ajayre/tandemleveller/Electronics/Controller V2/GNSS Daughterboard/GNSS-Daughterboard-V1.0-Render.png

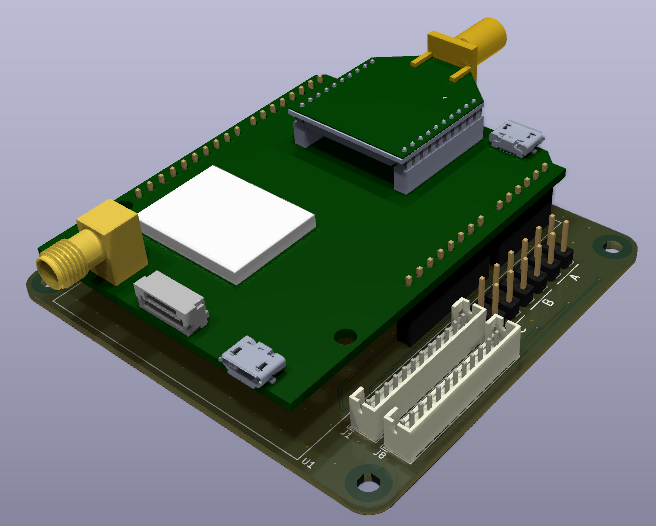
Electronics/Controller V2/GNSS Daughterboard/GNSS-Daughterboard-V1.0-Render.png
