ajayre/tandemleveller/Images/Controller Panel Connectors Annotated.png

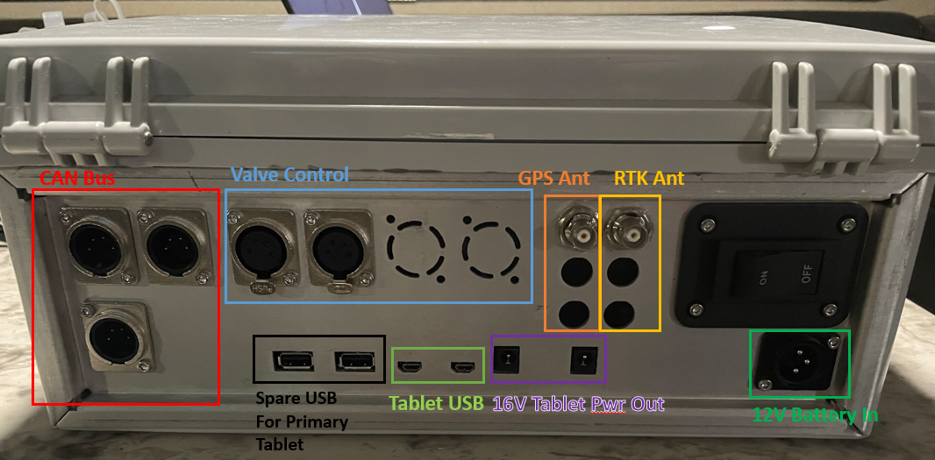
Images/Controller Panel Connectors Annotated.png
