ajayre/tandemleveller/Images/Controller Panel Connectors Annotated.pptx

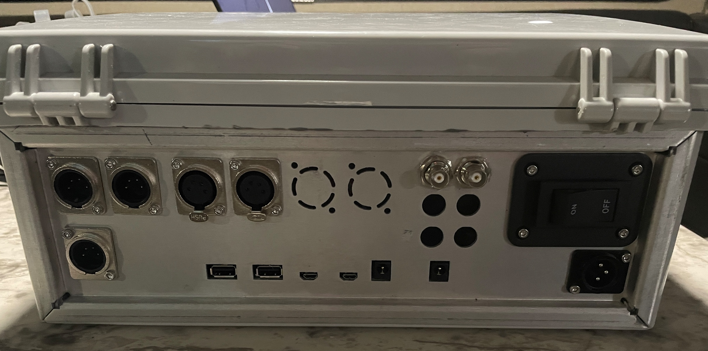
[picture p3: figure]

CAN Bus

Valve Control

GPS Ant

RTK Ant

Spare USB
For Primary Tablet

Tablet USB

16V Tablet Pwr Out

12V Battery In
