ajayre/tandemleveller/CAD/Controller/Case/Ethernet Template.pdf

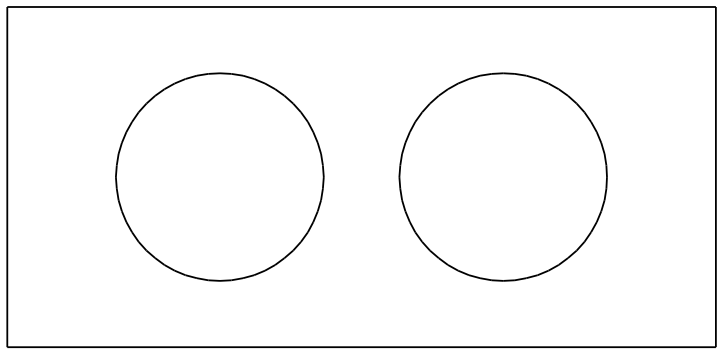
[picture p4: figure]
