ajayre/tandemleveller/Firmware/TandemLeveller/Misc/Scraper Mechanical Analysis.xlsx

Cylinder Lenfgth (cm) | Angle (deg) | Height (cm)
109 | 130.02 | -15.944
108.5 | 128.78 | -15.075
108 | 127.57 | -14.222
107.5 | 126.38 | -13.384
107 | 125.22 | -12.561
106.5 | 124.08 | -11.751
106 | 122.96 | -10.955
105.5 | 121.86 | -10.172
105 | 120.77 | -9.4
104.5 | 119.71 | -8.64
104 | 118.66 | -7.891
103.5 | 117.62 | -7.152
103 | 116.6 | -6.424
102.5 | 115.59 | -5.706
102 | 114.6 | -4.997
101.5 | 113.62 | -4.298
101 | 112.65 | -3.607
100.5 | 111.69 | -2.925
100 | 110.75 | -2.252
99.5 | 109.81 | -1.587
99 | 108.89 | -0.929
98.5 | 107.97 | -0.28
98.4 | 107.79 | -0.151
98.3 | 107.61 | -0.022
98 | 107.07 | 0.362
97 | 105.28 | 1.624
96 | 103.53 | 2.857
95 | 101.8 | 4.063
94 | 100.11 | 5.244
93 | 98.44 | 6.399
92 | 96.8 | 7.53
91 | 95.18 | 8.638
90 | 93.59 | 9.724
89 | 92.01 | 10.787
