ajayre/tandemleveller/Electronics/Datasheets/Leveling System Block Diagram.drawio.png

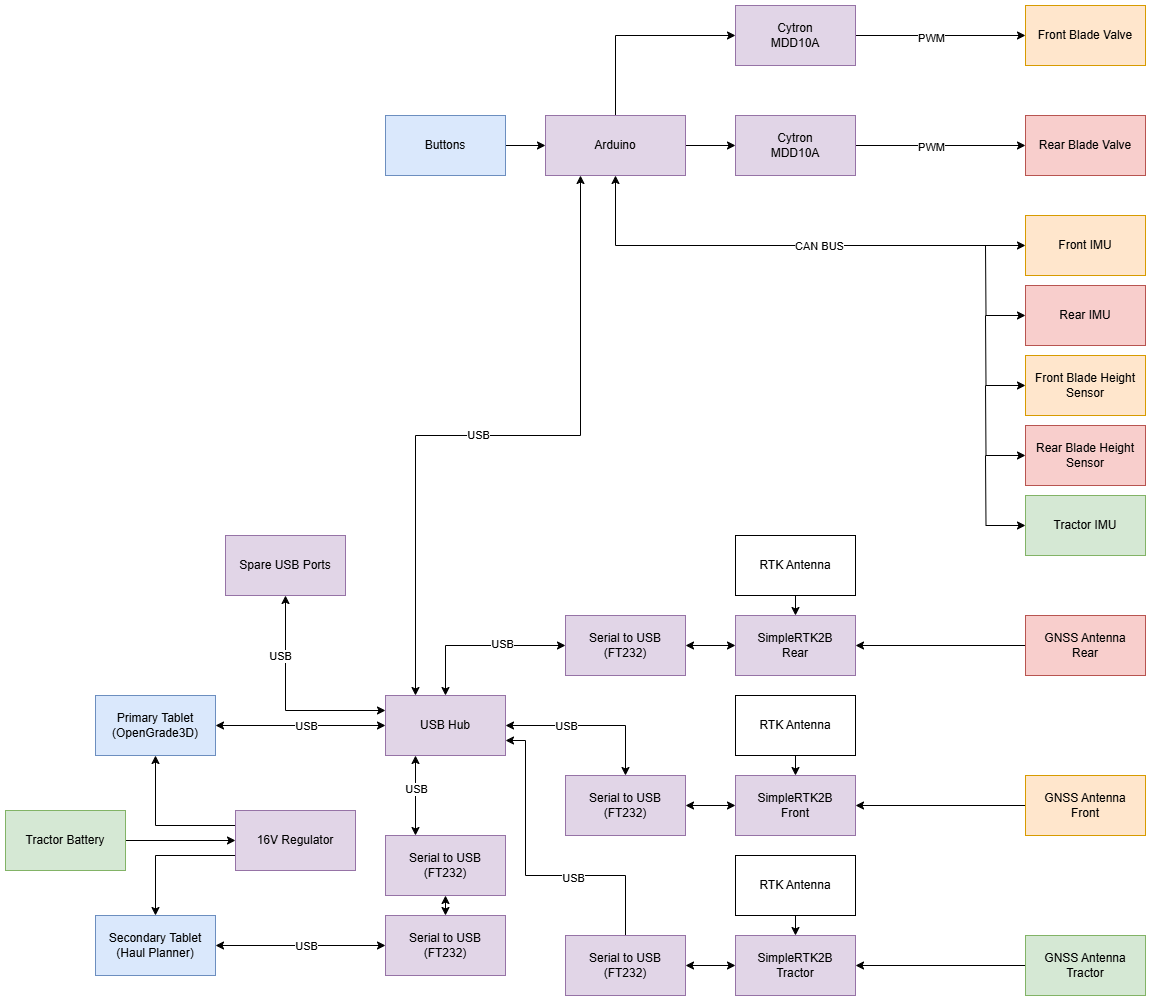
Electronics/Datasheets/Leveling System Block Diagram.drawio.png
