ajayre/tandemleveller/Electronics/Datasheets/Top Level Block Diagram.drawio.png

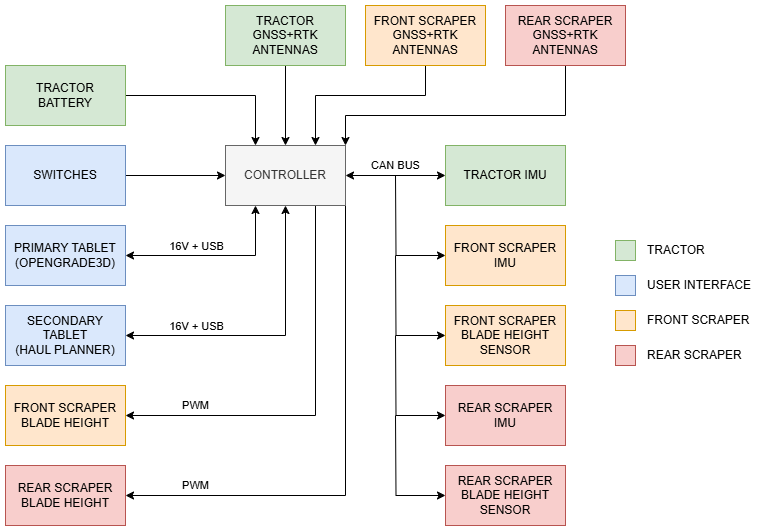
Electronics/Datasheets/Top Level Block Diagram.drawio.png
