ajayre/tandemleveller/Electronics/IMU/03621111e3fff3921c2074c2e0d3c10409e76010.jpeg

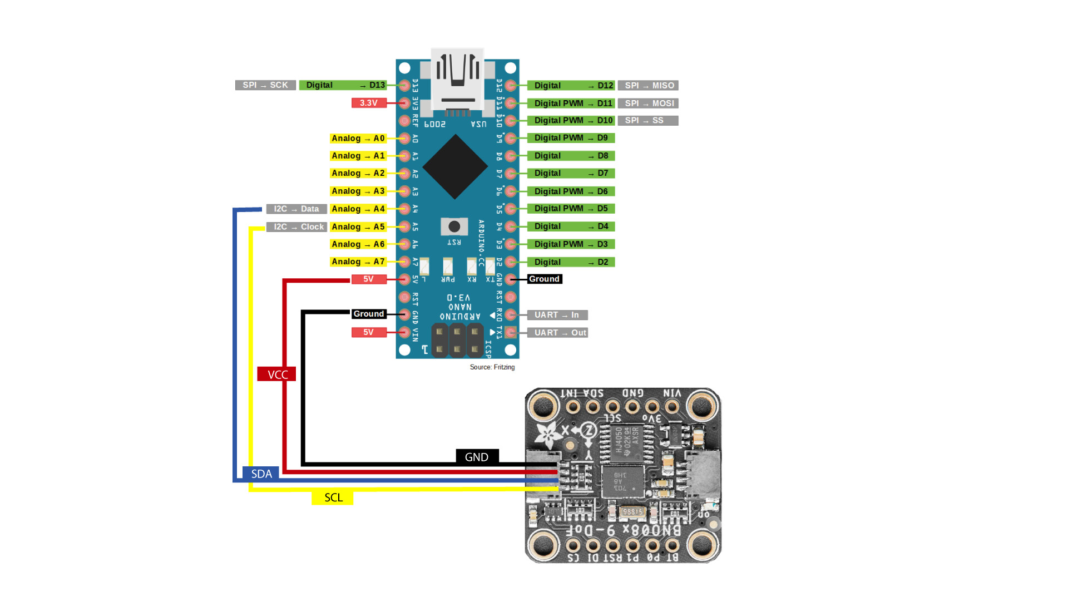
Electronics/IMU/03621111e3fff3921c2074c2e0d3c10409e76010.jpeg
