ajayre/tandemleveller/Electronics/User Controls/production/bom.csv

Designator | Footprint | Quantity | Value | LCSC Part #
C1, C2 | 0805 | 2 | 100n | C1711
FID1, FID2, FID3 | Fiducial_0.5mm_Mask1mm | 3 | Fiducial
J1 | PinHeader_1x02_P2.54mm_Vertical | 1 | TERM | C7494857
J10 | JST_PH_B4B-PH-K_1x04_P2.00mm_Vertical | 1 | BUTTON 7 | C131334
J11 | JST_PH_B4B-PH-K_1x04_P2.00mm_Vertical | 1 | BUTTON 8 | C131334
J12 | JST_PH_B5B-PH-K_1x05_P2.00mm_Vertical | 1 | JOYSTICK 1 | C157993
J13 | JST_PH_B5B-PH-K_1x05_P2.00mm_Vertical | 1 | JOYSTICK 2 | C157993
J2 | JST_PH_B5B-PH-K_1x05_P2.00mm_Vertical | 1 | CAN BUS | C157993
J3 | PinHeader_1x02_P2.54mm_Vertical | 1 | Conn_01x02 | C7494857
J4 | JST_PH_B4B-PH-K_1x04_P2.00mm_Vertical | 1 | BUTTON 1 | C131334
J5 | JST_PH_B4B-PH-K_1x04_P2.00mm_Vertical | 1 | BUTTON 2 | C131334
J6 | JST_PH_B4B-PH-K_1x04_P2.00mm_Vertical | 1 | BUTTON 3 | C131334
J7 | JST_PH_B4B-PH-K_1x04_P2.00mm_Vertical | 1 | BUTTON 4 | C131334
J8 | JST_PH_B4B-PH-K_1x04_P2.00mm_Vertical | 1 | BUTTON 5 | C131334
J9 | JST_PH_B4B-PH-K_1x04_P2.00mm_Vertical | 1 | BUTTON 6 | C131334
L1 | ACT1210-510-2P-TL00 | 1 | ACT1210-510-2P-TL00 | C95572
R1, R10, R3, R4, R5, R6, R7, R8, R9 | 0805 | 9 | 10k | C17414
R2 | 0805 | 1 | 120 | C17437
U1 | HVSON8_0_65mm | 1 | TJA1462ATK-0Z | C3229259
U2 | SOT-23 | 1 | PESD2CANFD24V-TR | C552486
U3 | Teensy_4.0 | 1 | TEENSY 4.0
