ajayre/tandemleveller/Electronics/XBee Adapter/Dummy XBee/production/bom.csv

Designator | Footprint | Quantity | Value | LCSC Part #
J1 | XBee 3 TH | 1 | Conn_01x20
J2, J3 | JST_PH_B2B-PH-K_1x02_P2.00mm_Vertical | 2 | Conn_01x04
