ajayre/tandemleveller/Firmware/Fusion Testing/Sensor Fusion Test 1.csv

CANopen Magic Ultimate 16.01 build 6829 64-bit Trace Recording, generated on 4/12/2026 5:48:48 PM
$FileVersion=5$
$TimestampMode=RelativeMS$
Message Number | Time (ms) | Time | Excel Time | Count | ID | Flags | Message Type | Node | Details | Process Data | Data (Hex) | Data (Text) | Data (Decimal) | Length | Raw Message
0 | 0.000 | 00000000.000' | 46124.7422641166 | 1 | 0x3F1 |  | Default: PDO |  | Default: TPDO 3 of Node 0x71 (113) | Easting:518723.148mm, Northing:3558743.361mm | 4C 16 EB 1E 41 1D 1E D4 | L . ë . A . . Ô | U:0 S:0 | 8 | 4C 16 EB 1E 41 1D 1E D4
1 | 9.152 | 00000009.152' | 46124.7422642225 | 1 | 0x182 |  | Default: PDO |  | Default: TPDO 1 of Node [0x02 (2)] Tractor IMU | Tctr Heading:316.25deg, Tctr Pitch:-3.25deg, Tctr Roll:15.5deg, Tctr Yaw Rate:0.22deg/s | 89 7B BB FE 0E 06 16 00 | . { » þ . . . . | U:0 S:0 | 8 | 89 7B BB FE 0E 06 16 00
2 | 40.850 | 00000040.850' | 46124.7422646953 | 1 | 0x3F1 |  | Default: PDO |  | Default: TPDO 3 of Node 0x71 (113) | Easting:518723.148mm, Northing:3558743.361mm | 4C 16 EB 1E 41 1D 1E D4 | L . ë . A . . Ô | U:0 S:0 | 8 | 4C 16 EB 1E 41 1D 1E D4
3 | 10.055 | 00000010.055' | 46124.7422648117 | 1 | 0x182 |  | Default: PDO |  | Default: TPDO 1 of Node [0x02 (2)] Tractor IMU | Tctr Heading:316.25deg, Tctr Pitch:-3.24deg, Tctr Roll:15.49deg, Tctr Yaw Rate:-0.22deg/s | 89 7B BC FE 0D 06 EA FF | . { ¼ þ . . ê ÿ | U:0 S:0 | 8 | 89 7B BC FE 0D 06 EA FF
4 | 39.943 | 00000039.943' | 46124.742265274 | 1 | 0x3F1 |  | Default: PDO |  | Default: TPDO 3 of Node 0x71 (113) | Easting:518723.148mm, Northing:3558743.361mm | 4C 16 EB 1E 41 1D 1E D4 | L . ë . A . . Ô | U:0 S:0 | 8 | 4C 16 EB 1E 41 1D 1E D4
5 | 9.486 | 00000009.486' | 46124.7422653838 | 1 | 0x182 |  | Default: PDO |  | Default: TPDO 1 of Node [0x02 (2)] Tractor IMU | Tctr Heading:316.29deg, Tctr Pitch:-3.25deg, Tctr Roll:15.49deg, Tctr Yaw Rate:-0.78deg/s | 8D 7B BB FE 0D 06 B2 FF | . { » þ . . ² ÿ | U:0 S:0 | 8 | 8D 7B BB FE 0D 06 B2 FF
6 | 40.509 | 00000040.509' | 46124.7422658527 | 1 | 0x3F1 |  | Default: PDO |  | Default: TPDO 3 of Node 0x71 (113) | Easting:518723.148mm, Northing:3558743.361mm | 4C 16 EB 1E 41 1D 1E D4 | L . ë . A . . Ô | U:0 S:0 | 8 | 4C 16 EB 1E 41 1D 1E D4
7 | 9.175 | 00000009.175' | 46124.7422659589 | 1 | 0x182 |  | Default: PDO |  | Default: TPDO 1 of Node [0x02 (2)] Tractor IMU | Tctr Heading:316.34deg, Tctr Pitch:-3.26deg, Tctr Roll:15.47deg, Tctr Yaw Rate:-1.23deg/s | 92 7B BA FE 0B 06 85 FF | . { º þ . . . ÿ | U:0 S:0 | 8 | 92 7B BA FE 0B 06 85 FF
8 | 40.829 | 00000040.829' | 46124.7422664314 | 1 | 0x3F1 |  | Default: PDO |  | Default: TPDO 3 of Node 0x71 (113) | Easting:518723.148mm, Northing:3558743.361mm | 4C 16 EB 1E 41 1D 1E D4 | L . ë . A . . Ô | U:0 S:0 | 8 | 4C 16 EB 1E 41 1D 1E D4
9 | 10.230 | 00000010.230' | 46124.7422665498 | 1 | 0x182 |  | Default: PDO |  | Default: TPDO 1 of Node [0x02 (2)] Tractor IMU | Tctr Heading:316.4deg, Tctr Pitch:-3.27deg, Tctr Roll:15.48deg, Tctr Yaw Rate:-1.23deg/s | 98 7B B9 FE 0C 06 85 FF | . { ¹ þ . . . ÿ | U:0 S:0 | 8 | 98 7B B9 FE 0C 06 85 FF
10 | 39.774 | 00000039.774' | 46124.7422670102 | 1 | 0x3F1 |  | Default: PDO |  | Default: TPDO 3 of Node 0x71 (113) | Easting:518723.148mm, Northing:3558743.361mm | 4C 16 EB 1E 41 1D 1E D4 | L . ë . A . . Ô | U:0 S:0 | 8 | 4C 16 EB 1E 41 1D 1E D4
11 | 9.511 | 00000009.511' | 46124.7422671203 | 1 | 0x182 |  | Default: PDO |  | Default: TPDO 1 of Node [0x02 (2)] Tractor IMU | Tctr Heading:316.41deg, Tctr Pitch:-3.27deg, Tctr Roll:15.48deg, Tctr Yaw Rate:-0.11deg/s | 99 7B B9 FE 0C 06 F5 FF | . { ¹ þ . . õ ÿ | U:0 S:0 | 8 | 99 7B B9 FE 0C 06 F5 FF
12 | 40.495 | 00000040.495' | 46124.742267589 | 1 | 0x3F1 |  | Default: PDO |  | Default: TPDO 3 of Node 0x71 (113) | Easting:518723.148mm, Northing:3558743.361mm | 4C 16 EB 1E 41 1D 1E D4 | L . ë . A . . Ô | U:0 S:0 | 8 | 4C 16 EB 1E 41 1D 1E D4
13 | 9.184 | 00000009.184' | 46124.7422676952 | 1 | 0x182 |  | Default: PDO |  | Default: TPDO 1 of Node [0x02 (2)] Tractor IMU | Tctr Heading:316.38deg, Tctr Pitch:-3.26deg, Tctr Roll:15.48deg, Tctr Yaw Rate:0.78deg/s | 96 7B BA FE 0C 06 4E 00 | . { º þ . . N . | U:0 S:0 | 8 | 96 7B BA FE 0C 06 4E 00
14 | 40.818 | 00000040.818' | 46124.7422681677 | 1 | 0x3F1 |  | Default: PDO |  | Default: TPDO 3 of Node 0x71 (113) | Easting:518723.148mm, Northing:3558743.361mm | 4C 16 EB 1E 41 1D 1E D4 | L . ë . A . . Ô | U:0 S:0 | 8 | 4C 16 EB 1E 41 1D 1E D4
15 | 10.120 | 00000010.120' | 46124.7422682848 | 1 | 0x182 |  | Default: PDO |  | Default: TPDO 1 of Node [0x02 (2)] Tractor IMU | Tctr Heading:316.31deg, Tctr Pitch:-3.24deg, Tctr Roll:15.49deg, Tctr Yaw Rate:1.45deg/s | 8F 7B BC FE 0D 06 91 00 | . { ¼ þ . . . . | U:0 S:0 | 8 | 8F 7B BC FE 0D 06 91 00
16 | 39.878 | 00000039.878' | 46124.7422687464 | 1 | 0x3F1 |  | Default: PDO |  | Default: TPDO 3 of Node 0x71 (113) | Easting:518723.148mm, Northing:3558743.361mm | 4C 16 EB 1E 41 1D 1E D4 | L . ë . A . . Ô | U:0 S:0 | 8 | 4C 16 EB 1E 41 1D 1E D4
17 | 9.535 | 00000009.535' | 46124.7422688567 | 1 | 0x182 |  | Default: PDO |  | Default: TPDO 1 of Node [0x02 (2)] Tractor IMU | Tctr Heading:316.25deg, Tctr Pitch:-3.22deg, Tctr Roll:15.48deg, Tctr Yaw Rate:1.23deg/s | 89 7B BE FE 0C 06 7B 00 | . { ¾ þ . . { . | U:0 S:0 | 8 | 89 7B BE FE 0C 06 7B 00
18 | 21.415 | 00000021.415' | 46124.7422691046 | 1 | 0x1F1 |  | Default: PDO |  | Default: TPDO 1 of Node 0x71 (113) | Fuse Easting Corr:600mm, Fuse Northing Corr:373mm, Fuse Alt Corr:-2494mm | 58 02 75 01 42 F6 | X . u . B ö | U:0 S:0 | 6 | 58 02 75 01 42 F6
19 | 19.037 | 00000019.037' | 46124.7422693249 | 1 | 0x3F1 |  | Default: PDO |  | Default: TPDO 3 of Node 0x71 (113) | Easting:518723.148mm, Northing:3558743.368mm | 4C 16 EB 1E 48 1D 1E D4 | L . ë . H . . Ô | U:0 S:0 | 8 | 4C 16 EB 1E 48 1D 1E D4
20 | 9.240 | 00000009.240' | 46124.7422694319 | 1 | 0x182 |  | Default: PDO |  | Default: TPDO 1 of Node [0x02 (2)] Tractor IMU | Tctr Heading:316.18deg, Tctr Pitch:-3.21deg, Tctr Roll:15.48deg, Tctr Yaw Rate:1.45deg/s | 82 7B BF FE 0C 06 91 00 | . { ¿ þ . . . . | U:0 S:0 | 8 | 82 7B BF FE 0C 06 91 00
21 | 40.756 | 00000040.756' | 46124.7422699036 | 1 | 0x3F1 |  | Default: PDO |  | Default: TPDO 3 of Node 0x71 (113) | Easting:518723.148mm, Northing:3558743.368mm | 4C 16 EB 1E 48 1D 1E D4 | L . ë . H . . Ô | U:0 S:0 | 8 | 4C 16 EB 1E 48 1D 1E D4
22 | 10.443 | 00000010.443' | 46124.7422700244 | 1 | 0x182 |  | Default: PDO |  | Default: TPDO 1 of Node [0x02 (2)] Tractor IMU | Tctr Heading:316.16deg, Tctr Pitch:-3.2deg, Tctr Roll:15.48deg, Tctr Yaw Rate:0.22deg/s | 80 7B C0 FE 0C 06 16 00 | . { À þ . . . . | U:0 S:0 | 8 | 80 7B C0 FE 0C 06 16 00
23 | 39.661 | 00000039.661' | 46124.7422704835 | 1 | 0x3F1 |  | Default: PDO |  | Default: TPDO 3 of Node 0x71 (113) | Easting:518723.148mm, Northing:3558743.368mm | 4C 16 EB 1E 48 1D 1E D4 | L . ë . H . . Ô | U:0 S:0 | 8 | 4C 16 EB 1E 48 1D 1E D4
24 | 9.576 | 00000009.576' | 46124.7422705943 | 1 | 0x182 |  | Default: PDO |  | Default: TPDO 1 of Node [0x02 (2)] Tractor IMU | Tctr Heading:316.17deg, Tctr Pitch:-3.21deg, Tctr Roll:15.49deg, Tctr Yaw Rate:-0.44deg/s | 81 7B BF FE 0D 06 D4 FF | . { ¿ þ . . Ô ÿ | U:0 S:0 | 8 | 81 7B BF FE 0D 06 D4 FF
25 | 40.429 | 00000040.429' | 46124.7422710622 | 1 | 0x3F1 |  | Default: PDO |  | Default: TPDO 3 of Node 0x71 (113) | Easting:518723.148mm, Northing:3558743.368mm | 4C 16 EB 1E 48 1D 1E D4 | L . ë . H . . Ô | U:0 S:0 | 8 | 4C 16 EB 1E 48 1D 1E D4
26 | 9.247 | 00000009.247' | 46124.7422711693 | 1 | 0x182 |  | Default: PDO |  | Default: TPDO 1 of Node [0x02 (2)] Tractor IMU | Tctr Heading:316.22deg, Tctr Pitch:-3.22deg, Tctr Roll:15.5deg, Tctr Yaw Rate:-0.89deg/s | 86 7B BE FE 0E 06 A7 FF | . { ¾ þ . . § ÿ | U:0 S:0 | 8 | 86 7B BE FE 0E 06 A7 FF
27 | 40.757 | 00000040.757' | 46124.742271641 | 1 | 0x3F1 |  | Default: PDO |  | Default: TPDO 3 of Node 0x71 (113) | Easting:518723.148mm, Northing:3558743.368mm | 4C 16 EB 1E 48 1D 1E D4 | L . ë . H . . Ô | U:0 S:0 | 8 | 4C 16 EB 1E 48 1D 1E D4
28 | 10.567 | 00000010.567' | 46124.7422717633 | 1 | 0x182 |  | Default: PDO |  | Default: TPDO 1 of Node [0x02 (2)] Tractor IMU | Tctr Heading:316.28deg, Tctr Pitch:-3.22deg, Tctr Roll:15.49deg, Tctr Yaw Rate:-1.34deg/s | 8C 7B BE FE 0D 06 7A FF | . { ¾ þ . . z ÿ | U:0 S:0 | 8 | 8C 7B BE FE 0D 06 7A FF
29 | 39.433 | 00000039.433' | 46124.7422722197 | 1 | 0x3F1 |  | Default: PDO |  | Default: TPDO 3 of Node 0x71 (113) | Easting:518723.148mm, Northing:3558743.368mm | 4C 16 EB 1E 48 1D 1E D4 | L . ë . H . . Ô | U:0 S:0 | 8 | 4C 16 EB 1E 48 1D 1E D4
30 | 10.112 | 00000010.112' | 46124.7422723367 | 1 | 0x182 |  | Default: PDO |  | Default: TPDO 1 of Node [0x02 (2)] Tractor IMU | Tctr Heading:316.32deg, Tctr Pitch:-3.24deg, Tctr Roll:15.49deg, Tctr Yaw Rate:-0.78deg/s | 90 7B BC FE 0D 06 B2 FF | . { ¼ þ . . ² ÿ | U:0 S:0 | 8 | 90 7B BC FE 0D 06 B2 FF
31 | 39.885 | 00000039.885' | 46124.7422727984 | 1 | 0x3F1 |  | Default: PDO |  | Default: TPDO 3 of Node 0x71 (113) | Easting:518723.148mm, Northing:3558743.368mm | 4C 16 EB 1E 48 1D 1E D4 | L . ë . H . . Ô | U:0 S:0 | 8 | 4C 16 EB 1E 48 1D 1E D4
32 | 9.272 | 00000009.272' | 46124.7422729057 | 1 | 0x182 |  | Default: PDO |  | Default: TPDO 1 of Node [0x02 (2)] Tractor IMU | Tctr Heading:316.32deg, Tctr Pitch:-3.24deg, Tctr Roll:15.5deg, Tctr Yaw Rate:0.22deg/s | 90 7B BC FE 0E 06 16 00 | . { ¼ þ . . . . | U:0 S:0 | 8 | 90 7B BC FE 0E 06 16 00
33 | 40.732 | 00000040.732' | 46124.7422733771 | 1 | 0x3F1 |  | Default: PDO |  | Default: TPDO 3 of Node 0x71 (113) | Easting:518723.148mm, Northing:3558743.368mm | 4C 16 EB 1E 48 1D 1E D4 | L . ë . H . . Ô | U:0 S:0 | 8 | 4C 16 EB 1E 48 1D 1E D4
34 | 10.135 | 00000010.135' | 46124.7422734944 | 1 | 0x182 |  | Default: PDO |  | Default: TPDO 1 of Node [0x02 (2)] Tractor IMU | Tctr Heading:316.27deg, Tctr Pitch:-3.23deg, Tctr Roll:15.51deg, Tctr Yaw Rate:1.23deg/s | 8B 7B BD FE 0F 06 7B 00 | . { ½ þ . . { . | U:0 S:0 | 8 | 8B 7B BD FE 0F 06 7B 00
35 | 39.869 | 00000039.869' | 46124.7422739559 | 1 | 0x3F1 |  | Default: PDO |  | Default: TPDO 3 of Node 0x71 (113) | Easting:518723.148mm, Northing:3558743.368mm | 4C 16 EB 1E 48 1D 1E D4 | L . ë . H . . Ô | U:0 S:0 | 8 | 4C 16 EB 1E 48 1D 1E D4
36 | 10.007 | 00000010.007' | 46124.7422740717 | 1 | 0x182 |  | Default: PDO |  | Default: TPDO 1 of Node [0x02 (2)] Tractor IMU | Tctr Heading:316.2deg, Tctr Pitch:-3.21deg, Tctr Roll:15.5deg, Tctr Yaw Rate:1.56deg/s | 84 7B BF FE 0E 06 9C 00 | . { ¿ þ . . . . | U:0 S:0 | 8 | 84 7B BF FE 0E 06 9C 00
37 | 39.997 | 00000039.997' | 46124.7422745346 | 1 | 0x3F1 |  | Default: PDO |  | Default: TPDO 3 of Node 0x71 (113) | Easting:518723.148mm, Northing:3558743.368mm | 4C 16 EB 1E 48 1D 1E D4 | L . ë . H . . Ô | U:0 S:0 | 8 | 4C 16 EB 1E 48 1D 1E D4
38 | 9.295 | 00000009.295' | 46124.7422746422 | 1 | 0x182 |  | Default: PDO |  | Default: TPDO 1 of Node [0x02 (2)] Tractor IMU | Tctr Heading:316.15deg, Tctr Pitch:-3.2deg, Tctr Roll:15.51deg, Tctr Yaw Rate:0.78deg/s | 7F 7B C0 FE 0F 06 4E 00 | . { À þ . . N . | U:0 S:0 | 8 | 7F 7B C0 FE 0F 06 4E 00
39 | 40.705 | 00000040.705' | 46124.7422751133 | 1 | 0x3F1 |  | Default: PDO |  | Default: TPDO 3 of Node 0x71 (113) | Easting:518723.148mm, Northing:3558743.368mm | 4C 16 EB 1E 48 1D 1E D4 | L . ë . H . . Ô | U:0 S:0 | 8 | 4C 16 EB 1E 48 1D 1E D4
40 | 10.641 | 00000010.641' | 46124.7422752365 | 1 | 0x182 |  | Default: PDO |  | Default: TPDO 1 of Node [0x02 (2)] Tractor IMU | Tctr Heading:316.15deg, Tctr Pitch:-3.19deg, Tctr Roll:15.5deg, Tctr Yaw Rate:-0.22deg/s | 7F 7B C1 FE 0E 06 EA FF | . { Á þ . . ê ÿ | U:0 S:0 | 8 | 7F 7B C1 FE 0E 06 EA FF
41 | 39.361 | 00000039.361' | 46124.742275692 | 1 | 0x3F1 |  | Default: PDO |  | Default: TPDO 3 of Node 0x71 (113) | Easting:518723.148mm, Northing:3558743.368mm | 4C 16 EB 1E 48 1D 1E D4 | L . ë . H . . Ô | U:0 S:0 | 8 | 4C 16 EB 1E 48 1D 1E D4
42 | 10.161 | 00000010.161' | 46124.7422758096 | 1 | 0x182 |  | Default: PDO |  | Default: TPDO 1 of Node [0x02 (2)] Tractor IMU | Tctr Heading:316.2deg, Tctr Pitch:-3.21deg, Tctr Roll:15.52deg, Tctr Yaw Rate:-1.11deg/s | 84 7B BF FE 10 06 91 FF | . { ¿ þ . . . ÿ | U:0 S:0 | 8 | 84 7B BF FE 10 06 91 FF
43 | 39.840 | 00000039.840' | 46124.7422762708 | 1 | 0x3F1 |  | Default: PDO |  | Default: TPDO 3 of Node 0x71 (113) | Easting:518723.148mm, Northing:3558743.368mm | 4C 16 EB 1E 48 1D 1E D4 | L . ë . H . . Ô | U:0 S:0 | 8 | 4C 16 EB 1E 48 1D 1E D4
44 | 9.281 | 00000009.281' | 46124.7422763782 | 1 | 0x182 |  | Default: PDO |  | Default: TPDO 1 of Node [0x02 (2)] Tractor IMU | Tctr Heading:316.27deg, Tctr Pitch:-3.22deg, Tctr Roll:15.52deg, Tctr Yaw Rate:-1.34deg/s | 8B 7B BE FE 10 06 7A FF | . { ¾ þ . . z ÿ | U:0 S:0 | 8 | 8B 7B BE FE 10 06 7A FF
45 | 40.719 | 00000040.719' | 46124.7422768495 | 1 | 0x3F1 |  | Default: PDO |  | Default: TPDO 3 of Node 0x71 (113) | Easting:518723.148mm, Northing:3558743.368mm | 4C 16 EB 1E 48 1D 1E D4 | L . ë . H . . Ô | U:0 S:0 | 8 | 4C 16 EB 1E 48 1D 1E D4
46 | 10.215 | 00000010.215' | 46124.7422769677 | 1 | 0x182 |  | Default: PDO |  | Default: TPDO 1 of Node [0x02 (2)] Tractor IMU | Tctr Heading:316.32deg, Tctr Pitch:-3.24deg, Tctr Roll:15.5deg, Tctr Yaw Rate:-0.78deg/s | 90 7B BC FE 0E 06 B2 FF | . { ¼ þ . . ² ÿ | U:0 S:0 | 8 | 90 7B BC FE 0E 06 B2 FF
47 | 39.790 | 00000039.790' | 46124.7422774282 | 1 | 0x3F1 |  | Default: PDO |  | Default: TPDO 3 of Node 0x71 (113) | Easting:518723.148mm, Northing:3558743.368mm | 4C 16 EB 1E 48 1D 1E D4 | L . ë . H . . Ô | U:0 S:0 | 8 | 4C 16 EB 1E 48 1D 1E D4
48 | 10.047 | 00000010.047' | 46124.7422775445 | 1 | 0x182 |  | Default: PDO |  | Default: TPDO 1 of Node [0x02 (2)] Tractor IMU | Tctr Heading:316.33deg, Tctr Pitch:-3.23deg, Tctr Roll:15.51deg, Tctr Yaw Rate:0.33deg/s | 91 7B BD FE 0F 06 21 00 | . { ½ þ . . ! . | U:0 S:0 | 8 | 91 7B BD FE 0F 06 21 00
49 | 39.957 | 00000039.957' | 46124.742278007 | 1 | 0x3F1 |  | Default: PDO |  | Default: TPDO 3 of Node 0x71 (113) | Easting:518723.148mm, Northing:3558743.368mm | 4C 16 EB 1E 48 1D 1E D4 | L . ë . H . . Ô | U:0 S:0 | 8 | 4C 16 EB 1E 48 1D 1E D4
50 | 9.312 | 00000009.312' | 46124.7422781147 | 1 | 0x182 |  | Default: PDO |  | Default: TPDO 1 of Node [0x02 (2)] Tractor IMU | Tctr Heading:316.28deg, Tctr Pitch:-3.22deg, Tctr Roll:15.5deg, Tctr Yaw Rate:0.89deg/s | 8C 7B BE FE 0E 06 59 00 | . { ¾ þ . . Y . | U:0 S:0 | 8 | 8C 7B BE FE 0E 06 59 00
51 | 40.684 | 00000040.684' | 46124.7422785856 | 1 | 0x3F1 |  | Default: PDO |  | Default: TPDO 3 of Node 0x71 (113) | Easting:518723.148mm, Northing:3558743.368mm | 4C 16 EB 1E 48 1D 1E D4 | L . ë . H . . Ô | U:0 S:0 | 8 | 4C 16 EB 1E 48 1D 1E D4
52 | 10.671 | 00000010.671' | 46124.7422787091 | 1 | 0x182 |  | Default: PDO |  | Default: TPDO 1 of Node [0x02 (2)] Tractor IMU | Tctr Heading:316.23deg, Tctr Pitch:-3.22deg, Tctr Roll:15.51deg, Tctr Yaw Rate:1.23deg/s | 87 7B BE FE 0F 06 7B 00 | . { ¾ þ . . { . | U:0 S:0 | 8 | 87 7B BE FE 0F 06 7B 00
53 | 39.334 | 00000039.334' | 46124.7422791644 | 1 | 0x3F1 |  | Default: PDO |  | Default: TPDO 3 of Node 0x71 (113) | Easting:518723.148mm, Northing:3558743.368mm | 4C 16 EB 1E 48 1D 1E D4 | L . ë . H . . Ô | U:0 S:0 | 8 | 4C 16 EB 1E 48 1D 1E D4
54 | 10.231 | 00000010.231' | 46124.7422792828 | 1 | 0x182 |  | Default: PDO |  | Default: TPDO 1 of Node [0x02 (2)] Tractor IMU | Tctr Heading:316.18deg, Tctr Pitch:-3.21deg, Tctr Roll:15.5deg, Tctr Yaw Rate:0.89deg/s | 82 7B BF FE 0E 06 59 00 | . { ¿ þ . . Y . | U:0 S:0 | 8 | 82 7B BF FE 0E 06 59 00
55 | 39.773 | 00000039.773' | 46124.7422797431 | 1 | 0x3F1 |  | Default: PDO |  | Default: TPDO 3 of Node 0x71 (113) | Easting:518723.148mm, Northing:3558743.368mm | 4C 16 EB 1E 48 1D 1E D4 | L . ë . H . . Ô | U:0 S:0 | 8 | 4C 16 EB 1E 48 1D 1E D4
56 | 9.336 | 00000009.336' | 46124.7422798512 | 1 | 0x182 |  | Default: PDO |  | Default: TPDO 1 of Node [0x02 (2)] Tractor IMU | Tctr Heading:316.19deg, Tctr Pitch:-3.21deg, Tctr Roll:15.49deg, Tctr Yaw Rate:-0.33deg/s | 83 7B BF FE 0D 06 DF FF | . { ¿ þ . . ß ÿ | U:0 S:0 | 8 | 83 7B BF FE 0D 06 DF FF
57 | 40.660 | 00000040.660' | 46124.7422803218 | 1 | 0x3F1 |  | Default: PDO |  | Default: TPDO 3 of Node 0x71 (113) | Easting:518723.148mm, Northing:3558743.368mm | 4C 16 EB 1E 48 1D 1E D4 | L . ë . H . . Ô | U:0 S:0 | 8 | 4C 16 EB 1E 48 1D 1E D4
58 | 10.270 | 00000010.270' | 46124.7422804407 | 1 | 0x182 |  | Default: PDO |  | Default: TPDO 1 of Node [0x02 (2)] Tractor IMU | Tctr Heading:316.23deg, Tctr Pitch:-3.22deg, Tctr Roll:15.51deg, Tctr Yaw Rate:-1.11deg/s | 87 7B BE FE 0F 06 91 FF | . { ¾ þ . . . ÿ | U:0 S:0 | 8 | 87 7B BE FE 0F 06 91 FF
59 | 39.734 | 00000039.734' | 46124.7422809005 | 1 | 0x3F1 |  | Default: PDO |  | Default: TPDO 3 of Node 0x71 (113) | Easting:518723.148mm, Northing:3558743.368mm | 4C 16 EB 1E 48 1D 1E D4 | L . ë . H . . Ô | U:0 S:0 | 8 | 4C 16 EB 1E 48 1D 1E D4
60 | 3.374 | 00000003.374' | 46124.7422809396 | 1 | 0x1F1 |  | Default: PDO |  | Default: TPDO 1 of Node 0x71 (113) | Fuse Easting Corr:601mm, Fuse Northing Corr:374mm, Fuse Alt Corr:-2494mm | 59 02 76 01 42 F6 | Y . v . B ö | U:0 S:0 | 6 | 59 02 76 01 42 F6
61 | 6.751 | 00000006.751' | 46124.7422810177 | 1 | 0x182 |  | Default: PDO |  | Default: TPDO 1 of Node [0x02 (2)] Tractor IMU | Tctr Heading:316.3deg, Tctr Pitch:-3.24deg, Tctr Roll:15.52deg, Tctr Yaw Rate:-1.23deg/s | 8E 7B BC FE 10 06 85 FF | . { ¼ þ . . . ÿ | U:0 S:0 | 8 | 8E 7B BC FE 10 06 85 FF
62 | 39.868 | 00000039.868' | 46124.7422814792 | 1 | 0x3F1 |  | Default: PDO |  | Default: TPDO 3 of Node 0x71 (113) | Easting:518723.152mm, Northing:3558743.371mm | 50 16 EB 1E 4B 1D 1E D4 | P . ë . K . . Ô | U:0 S:0 | 8 | 50 16 EB 1E 4B 1D 1E D4
63 | 9.451 | 00000009.451' | 46124.7422815886 | 1 | 0x182 |  | Default: PDO |  | Default: TPDO 1 of Node [0x02 (2)] Tractor IMU | Tctr Heading:316.36deg, Tctr Pitch:-3.25deg, Tctr Roll:15.54deg, Tctr Yaw Rate:-1.45deg/s | 94 7B BB FE 12 06 6F FF | . { » þ . . o ÿ | U:0 S:0 | 8 | 94 7B BB FE 12 06 6F FF
64 | 40.654 | 00000040.654' | 46124.7422820591 | 1 | 0x3F1 |  | Default: PDO |  | Default: TPDO 3 of Node 0x71 (113) | Easting:518723.152mm, Northing:3558743.371mm | 50 16 EB 1E 4B 1D 1E D4 | P . ë . K . . Ô | U:0 S:0 | 8 | 50 16 EB 1E 4B 1D 1E D4
65 | 10.167 | 00000010.167' | 46124.7422821768 | 1 | 0x182 |  | Default: PDO |  | Default: TPDO 1 of Node [0x02 (2)] Tractor IMU | Tctr Heading:316.42deg, Tctr Pitch:-3.26deg, Tctr Roll:15.52deg, Tctr Yaw Rate:-1.23deg/s | 9A 7B BA FE 10 06 85 FF | . { º þ . . . ÿ | U:0 S:0 | 8 | 9A 7B BA FE 10 06 85 FF
66 | 39.838 | 00000039.838' | 46124.7422826379 | 1 | 0x3F1 |  | Default: PDO |  | Default: TPDO 3 of Node 0x71 (113) | Easting:518723.152mm, Northing:3558743.371mm | 50 16 EB 1E 4B 1D 1E D4 | P . ë . K . . Ô | U:0 S:0 | 8 | 50 16 EB 1E 4B 1D 1E D4
67 | 9.695 | 00000009.695' | 46124.7422827501 | 1 | 0x182 |  | Default: PDO |  | Default: TPDO 1 of Node [0x02 (2)] Tractor IMU | Tctr Heading:316.44deg, Tctr Pitch:-3.27deg, Tctr Roll:15.51deg, Tctr Yaw Rate:-0.33deg/s | 9C 7B B9 FE 0F 06 DF FF | . { ¹ þ . . ß ÿ | U:0 S:0 | 8 | 9C 7B B9 FE 0F 06 DF FF
68 | 40.305 | 00000040.305' | 46124.7422832166 | 1 | 0x3F1 |  | Default: PDO |  | Default: TPDO 3 of Node 0x71 (113) | Easting:518723.152mm, Northing:3558743.371mm | 50 16 EB 1E 4B 1D 1E D4 | P . ë . K . . Ô | U:0 S:0 | 8 | 50 16 EB 1E 4B 1D 1E D4
69 | 9.377 | 00000009.377' | 46124.7422833251 | 1 | 0x182 |  | Default: PDO |  | Default: TPDO 1 of Node [0x02 (2)] Tractor IMU | Tctr Heading:316.44deg, Tctr Pitch:-3.27deg, Tctr Roll:15.5deg, Tctr Yaw Rate:-0.11deg/s | 9C 7B B9 FE 0E 06 F5 FF | . { ¹ þ . . õ ÿ | U:0 S:0 | 8 | 9C 7B B9 FE 0E 06 F5 FF
70 | 40.625 | 00000040.625' | 46124.7422837953 | 1 | 0x3F1 |  | Default: PDO |  | Default: TPDO 3 of Node 0x71 (113) | Easting:518723.152mm, Northing:3558743.371mm | 50 16 EB 1E 4B 1D 1E D4 | P . ë . K . . Ô | U:0 S:0 | 8 | 50 16 EB 1E 4B 1D 1E D4
71 | 10.361 | 00000010.361' | 46124.7422839152 | 1 | 0x182 |  | Default: PDO |  | Default: TPDO 1 of Node [0x02 (2)] Tractor IMU | Tctr Heading:316.44deg, Tctr Pitch:-3.26deg, Tctr Roll:15.5deg, Tctr Yaw Rate:0.11deg/s | 9C 7B BA FE 0E 06 0B 00 | . { º þ . . . . | U:0 S:0 | 8 | 9C 7B BA FE 0E 06 0B 00
72 | 39.640 | 00000039.640' | 46124.742284374 | 1 | 0x3F1 |  | Default: PDO |  | Default: TPDO 3 of Node 0x71 (113) | Easting:518723.152mm, Northing:3558743.371mm | 50 16 EB 1E 4B 1D 1E D4 | P . ë . K . . Ô | U:0 S:0 | 8 | 50 16 EB 1E 4B 1D 1E D4
73 | 9.945 | 00000009.945' | 46124.7422844891 | 1 | 0x182 |  | Default: PDO |  | Default: TPDO 1 of Node [0x02 (2)] Tractor IMU | Tctr Heading:316.42deg, Tctr Pitch:-3.26deg, Tctr Roll:15.52deg, Tctr Yaw Rate:0.44deg/s | 9A 7B BA FE 10 06 2C 00 | . { º þ . . , . | U:0 S:0 | 8 | 9A 7B BA FE 10 06 2C 00
74 | 40.055 | 00000040.055' | 46124.7422849527 | 1 | 0x3F1 |  | Default: PDO |  | Default: TPDO 3 of Node 0x71 (113) | Easting:518723.152mm, Northing:3558743.371mm | 50 16 EB 1E 4B 1D 1E D4 | P . ë . K . . Ô | U:0 S:0 | 8 | 50 16 EB 1E 4B 1D 1E D4
75 | 9.383 | 00000009.383' | 46124.7422850613 | 1 | 0x182 |  | Default: PDO |  | Default: TPDO 1 of Node [0x02 (2)] Tractor IMU | Tctr Heading:316.42deg, Tctr Pitch:-3.25deg, Tctr Roll:15.49deg, Tctr Yaw Rate:-0.11deg/s | 9A 7B BB FE 0D 06 F5 FF | . { » þ . . õ ÿ | U:0 S:0 | 8 | 9A 7B BB FE 0D 06 F5 FF
76 | 40.622 | 00000040.622' | 46124.7422855315 | 1 | 0x3F1 |  | Default: PDO |  | Default: TPDO 3 of Node 0x71 (113) | Easting:518723.152mm, Northing:3558743.371mm | 50 16 EB 1E 4B 1D 1E D4 | P . ë . K . . Ô | U:0 S:0 | 8 | 50 16 EB 1E 4B 1D 1E D4
77 | 10.607 | 00000010.607' | 46124.7422856542 | 1 | 0x182 |  | Default: PDO |  | Default: TPDO 1 of Node [0x02 (2)] Tractor IMU | Tctr Heading:316.41deg, Tctr Pitch:-3.24deg, Tctr Roll:15.51deg, Tctr Yaw Rate:0.44deg/s | 99 7B BC FE 0F 06 2C 00 | . { ¼ þ . . , . | U:0 S:0 | 8 | 99 7B BC FE 0F 06 2C 00
78 | 39.389 | 00000039.389' | 46124.7422861101 | 1 | 0x3F1 |  | Default: PDO |  | Default: TPDO 3 of Node 0x71 (113) | Easting:518723.152mm, Northing:3558743.371mm | 50 16 EB 1E 4B 1D 1E D4 | P . ë . K . . Ô | U:0 S:0 | 8 | 50 16 EB 1E 4B 1D 1E D4
79 | 10.135 | 00000010.135' | 46124.7422862274 | 1 | 0x182 |  | Default: PDO |  | Default: TPDO 1 of Node [0x02 (2)] Tractor IMU | Tctr Heading:316.38deg, Tctr Pitch:-3.24deg, Tctr Roll:15.52deg, Tctr Yaw Rate:0.78deg/s | 96 7B BC FE 10 06 4E 00 | . { ¼ þ . . N . | U:0 S:0 | 8 | 96 7B BC FE 10 06 4E 00
80 | 39.869 | 00000039.869' | 46124.7422866889 | 1 | 0x3F1 |  | Default: PDO |  | Default: TPDO 3 of Node 0x71 (113) | Easting:518723.152mm, Northing:3558743.371mm | 50 16 EB 1E 4B 1D 1E D4 | P . ë . K . . Ô | U:0 S:0 | 8 | 50 16 EB 1E 4B 1D 1E D4
81 | 9.384 | 00000009.384' | 46124.7422867975 | 1 | 0x182 |  | Default: PDO |  | Default: TPDO 1 of Node [0x02 (2)] Tractor IMU | Tctr Heading:316.34deg, Tctr Pitch:-3.23deg, Tctr Roll:15.53deg, Tctr Yaw Rate:0.67deg/s | 92 7B BD FE 11 06 43 00 | . { ½ þ . . C . | U:0 S:0 | 8 | 92 7B BD FE 11 06 43 00
82 | 40.620 | 00000040.620' | 46124.7422872676 | 1 | 0x3F1 |  | Default: PDO |  | Default: TPDO 3 of Node 0x71 (113) | Easting:518723.152mm, Northing:3558743.371mm | 50 16 EB 1E 4B 1D 1E D4 | P . ë . K . . Ô | U:0 S:0 | 8 | 50 16 EB 1E 4B 1D 1E D4
83 | 10.166 | 00000010.166' | 46124.7422873853 | 1 | 0x182 |  | Default: PDO |  | Default: TPDO 1 of Node [0x02 (2)] Tractor IMU | Tctr Heading:316.3deg, Tctr Pitch:-3.22deg, Tctr Roll:15.53deg, Tctr Yaw Rate:0.89deg/s | 8E 7B BE FE 11 06 59 00 | . { ¾ þ . . Y . | U:0 S:0 | 8 | 8E 7B BE FE 11 06 59 00
84 | 39.838 | 00000039.838' | 46124.7422878464 | 1 | 0x3F1 |  | Default: PDO |  | Default: TPDO 3 of Node 0x71 (113) | Easting:518723.152mm, Northing:3558743.371mm | 50 16 EB 1E 4B 1D 1E D4 | P . ë . K . . Ô | U:0 S:0 | 8 | 50 16 EB 1E 4B 1D 1E D4
85 | 49.125 | 00000049.125' | 46124.7422884149 | 1 | 0x182 |  | Default: PDO |  | Default: TPDO 1 of Node [0x02 (2)] Tractor IMU | Tctr Heading:316.26deg, Tctr Pitch:-3.21deg, Tctr Roll:15.51deg, Tctr Yaw Rate:0.44deg/s | 8A 7B BF FE 0F 06 2C 00 | . { ¿ þ . . , . | U:0 S:0 | 8 | 8A 7B BF FE 0F 06 2C 00
86 | 2.287 | 00000002.287' | 46124.7422884414 | 1 | 0x3F1 |  | Default: PDO |  | Default: TPDO 3 of Node 0x71 (113) | Easting:518723.152mm, Northing:3558743.371mm | 50 16 EB 1E 4B 1D 1E D4 | P . ë . K . . Ô | U:0 S:0 | 8 | 50 16 EB 1E 4B 1D 1E D4
87 | 48.621 | 00000048.621' | 46124.7422890042 | 1 | 0x182 |  | Default: PDO |  | Default: TPDO 1 of Node [0x02 (2)] Tractor IMU | Tctr Heading:316.24deg, Tctr Pitch:-3.2deg, Tctr Roll:15.53deg, Tctr Yaw Rate:-0.44deg/s | 88 7B C0 FE 11 06 D4 FF | . { À þ . . Ô ÿ | U:0 S:0 | 8 | 88 7B C0 FE 11 06 D4 FF
88 | 1.366 | 00000001.366' | 46124.74228902 | 1 | 0x3F1 |  | Default: PDO |  | Default: TPDO 3 of Node 0x71 (113) | Easting:518723.152mm, Northing:3558743.371mm | 50 16 EB 1E 4B 1D 1E D4 | P . ë . K . . Ô | U:0 S:0 | 8 | 50 16 EB 1E 4B 1D 1E D4
89 | 48.629 | 00000048.629' | 46124.7422895828 | 1 | 0x182 |  | Default: PDO |  | Default: TPDO 1 of Node [0x02 (2)] Tractor IMU | Tctr Heading:316.24deg, Tctr Pitch:-3.21deg, Tctr Roll:15.53deg, Tctr Yaw Rate:-1deg/s | 88 7B BF FE 11 06 9C FF | . { ¿ þ . . . ÿ | U:0 S:0 | 8 | 88 7B BF FE 11 06 9C FF
90 | 1.367 | 00000001.367' | 46124.7422895986 | 1 | 0x3F1 |  | Default: PDO |  | Default: TPDO 3 of Node 0x71 (113) | Easting:518723.152mm, Northing:3558743.371mm | 50 16 EB 1E 4B 1D 1E D4 | P . ë . K . . Ô | U:0 S:0 | 8 | 50 16 EB 1E 4B 1D 1E D4
91 | 48.614 | 00000048.614' | 46124.7422901613 | 1 | 0x3F1 |  | Default: PDO |  | Default: TPDO 3 of Node 0x71 (113) | Easting:518723.152mm, Northing:3558743.371mm | 50 16 EB 1E 4B 1D 1E D4 | P . ë . K . . Ô | U:0 S:0 | 8 | 50 16 EB 1E 4B 1D 1E D4
92 | 3.175 | 00000003.175' | 46124.742290198 | 1 | 0x182 |  | Default: PDO |  | Default: TPDO 1 of Node [0x02 (2)] Tractor IMU | Tctr Heading:316.29deg, Tctr Pitch:-3.21deg, Tctr Roll:15.53deg, Tctr Yaw Rate:-1.11deg/s | 8D 7B BF FE 11 06 91 FF | . { ¿ þ . . . ÿ | U:0 S:0 | 8 | 8D 7B BF FE 11 06 91 FF
93 | 46.825 | 00000046.825' | 46124.74229074 | 1 | 0x3F1 |  | Default: PDO |  | Default: TPDO 3 of Node 0x71 (113) | Easting:518723.152mm, Northing:3558743.371mm | 50 16 EB 1E 4B 1D 1E D4 | P . ë . K . . Ô | U:0 S:0 | 8 | 50 16 EB 1E 4B 1D 1E D4
94 | 3.856 | 00000003.856' | 46124.7422907846 | 1 | 0x182 |  | Default: PDO |  | Default: TPDO 1 of Node [0x02 (2)] Tractor IMU | Tctr Heading:316.34deg, Tctr Pitch:-3.23deg, Tctr Roll:15.52deg, Tctr Yaw Rate:0deg/s | 92 7B BD FE 10 06 00 00 | . { ½ þ . . . . | U:0 S:0 | 8 | 92 7B BD FE 10 06 00 00
95 | 46.146 | 00000046.146' | 46124.7422913187 | 1 | 0x3F1 |  | Default: PDO |  | Default: TPDO 3 of Node 0x71 (113) | Easting:518723.152mm, Northing:3558743.371mm | 50 16 EB 1E 4B 1D 1E D4 | P . ë . K . . Ô | U:0 S:0 | 8 | 50 16 EB 1E 4B 1D 1E D4
96 | 3.527 | 00000003.527' | 46124.7422913595 | 1 | 0x182 |  | Default: PDO |  | Default: TPDO 1 of Node [0x02 (2)] Tractor IMU | Tctr Heading:316.36deg, Tctr Pitch:-3.24deg, Tctr Roll:15.5deg, Tctr Yaw Rate:0.33deg/s | 94 7B BC FE 0E 06 21 00 | . { ¼ þ . . ! . | U:0 S:0 | 8 | 94 7B BC FE 0E 06 21 00
97 | 46.474 | 00000046.474' | 46124.7422918974 | 1 | 0x3F1 |  | Default: PDO |  | Default: TPDO 3 of Node 0x71 (113) | Easting:518723.152mm, Northing:3558743.371mm | 50 16 EB 1E 4B 1D 1E D4 | P . ë . K . . Ô | U:0 S:0 | 8 | 50 16 EB 1E 4B 1D 1E D4
98 | 3.184 | 00000003.184' | 46124.7422919343 | 1 | 0x182 |  | Default: PDO |  | Default: TPDO 1 of Node [0x02 (2)] Tractor IMU | Tctr Heading:316.35deg, Tctr Pitch:-3.24deg, Tctr Roll:15.53deg, Tctr Yaw Rate:0.67deg/s | 93 7B BC FE 11 06 43 00 | . { ¼ þ . . C . | U:0 S:0 | 8 | 93 7B BC FE 11 06 43 00
99 | 37.674 | 00000037.674' | 46124.7422923703 | 1 | 0x1F1 |  | Default: PDO |  | Default: TPDO 1 of Node 0x71 (113) | Fuse Easting Corr:603mm, Fuse Northing Corr:373mm, Fuse Alt Corr:-2494mm | 5B 02 75 01 42 F6 | [ . u . B ö | U:0 S:0 | 6 | 5B 02 75 01 42 F6
100 | 9.142 | 00000009.142' | 46124.7422924761 | 1 | 0x3F1 |  | Default: PDO |  | Default: TPDO 3 of Node 0x71 (113) | Easting:518723.159mm, Northing:3558743.374mm | 57 16 EB 1E 4E 1D 1E D4 | W . ë . N . . Ô | U:0 S:0 | 8 | 57 16 EB 1E 4E 1D 1E D4
101 | 3.895 | 00000003.895' | 46124.7422925212 | 1 | 0x182 |  | Default: PDO |  | Default: TPDO 1 of Node [0x02 (2)] Tractor IMU | Tctr Heading:316.32deg, Tctr Pitch:-3.22deg, Tctr Roll:15.53deg, Tctr Yaw Rate:0.78deg/s | 90 7B BE FE 11 06 4E 00 | . { ¾ þ . . N . | U:0 S:0 | 8 | 90 7B BE FE 11 06 4E 00
102 | 46.111 | 00000046.111' | 46124.7422930549 | 1 | 0x3F1 |  | Default: PDO |  | Default: TPDO 3 of Node 0x71 (113) | Easting:518723.159mm, Northing:3558743.374mm | 57 16 EB 1E 4E 1D 1E D4 | W . ë . N . . Ô | U:0 S:0 | 8 | 57 16 EB 1E 4E 1D 1E D4
103 | 3.642 | 00000003.642' | 46124.7422930971 | 1 | 0x182 |  | Default: PDO |  | Default: TPDO 1 of Node [0x02 (2)] Tractor IMU | Tctr Heading:316.27deg, Tctr Pitch:-3.22deg, Tctr Roll:15.53deg, Tctr Yaw Rate:0.55deg/s | 8B 7B BE FE 11 06 37 00 | . { ¾ þ . . 7 . | U:0 S:0 | 8 | 8B 7B BE FE 11 06 37 00
104 | 46.454 | 00000046.454' | 46124.7422936347 | 1 | 0x3F1 |  | Default: PDO |  | Default: TPDO 3 of Node 0x71 (113) | Easting:518723.159mm, Northing:3558743.374mm | 57 16 EB 1E 4E 1D 1E D4 | W . ë . N . . Ô | U:0 S:0 | 8 | 57 16 EB 1E 4E 1D 1E D4
105 | 3.223 | 00000003.223' | 46124.742293672 | 1 | 0x182 |  | Default: PDO |  | Default: TPDO 1 of Node [0x02 (2)] Tractor IMU | Tctr Heading:316.24deg, Tctr Pitch:-3.21deg, Tctr Roll:15.52deg, Tctr Yaw Rate:0.55deg/s | 88 7B BF FE 10 06 37 00 | . { ¿ þ . . 7 . | U:0 S:0 | 8 | 88 7B BF FE 10 06 37 00
106 | 46.781 | 00000046.781' | 46124.7422942135 | 1 | 0x3F1 |  | Default: PDO |  | Default: TPDO 3 of Node 0x71 (113) | Easting:518723.159mm, Northing:3558743.374mm | 57 16 EB 1E 4E 1D 1E D4 | W . ë . N . . Ô | U:0 S:0 | 8 | 57 16 EB 1E 4E 1D 1E D4
107 | 3.918 | 00000003.918' | 46124.7422942588 | 1 | 0x182 |  | Default: PDO |  | Default: TPDO 1 of Node [0x02 (2)] Tractor IMU | Tctr Heading:316.22deg, Tctr Pitch:-3.2deg, Tctr Roll:15.51deg, Tctr Yaw Rate:0.11deg/s | 86 7B C0 FE 0F 06 0B 00 | . { À þ . . . . | U:0 S:0 | 8 | 86 7B C0 FE 0F 06 0B 00
108 | 46.089 | 00000046.089' | 46124.7422947923 | 1 | 0x3F1 |  | Default: PDO |  | Default: TPDO 3 of Node 0x71 (113) | Easting:518723.159mm, Northing:3558743.374mm | 57 16 EB 1E 4E 1D 1E D4 | W . ë . N . . Ô | U:0 S:0 | 8 | 57 16 EB 1E 4E 1D 1E D4
109 | 3.552 | 00000003.552' | 46124.7422948334 | 1 | 0x182 |  | Default: PDO |  | Default: TPDO 1 of Node [0x02 (2)] Tractor IMU | Tctr Heading:316.2deg, Tctr Pitch:-3.2deg, Tctr Roll:15.54deg, Tctr Yaw Rate:-0.55deg/s | 84 7B C0 FE 12 06 C9 FF | . { À þ . . É ÿ | U:0 S:0 | 8 | 84 7B C0 FE 12 06 C9 FF
110 | 46.447 | 00000046.447' | 46124.742295371 | 1 | 0x3F1 |  | Default: PDO |  | Default: TPDO 3 of Node 0x71 (113) | Easting:518723.159mm, Northing:3558743.374mm | 57 16 EB 1E 4E 1D 1E D4 | W . ë . N . . Ô | U:0 S:0 | 8 | 57 16 EB 1E 4E 1D 1E D4
111 | 4.232 | 00000004.232' | 46124.7422954199 | 1 | 0x182 |  | Default: PDO |  | Default: TPDO 1 of Node [0x02 (2)] Tractor IMU | Tctr Heading:316.22deg, Tctr Pitch:-3.19deg, Tctr Roll:15.54deg, Tctr Yaw Rate:-0.55deg/s | 86 7B C1 FE 12 06 C9 FF | . { Á þ . . É ÿ | U:0 S:0 | 8 | 86 7B C1 FE 12 06 C9 FF
112 | 45.768 | 00000045.768' | 46124.7422959497 | 1 | 0x3F1 |  | Default: PDO |  | Default: TPDO 3 of Node 0x71 (113) | Easting:518723.159mm, Northing:3558743.374mm | 57 16 EB 1E 4E 1D 1E D4 | W . ë . N . . Ô | U:0 S:0 | 8 | 57 16 EB 1E 4E 1D 1E D4
113 | 9.151 | 00000009.151' | 46124.7422960556 | 1 | 0x182 |  | Default: PDO |  | Default: TPDO 1 of Node [0x02 (2)] Tractor IMU | Tctr Heading:316.27deg, Tctr Pitch:-3.2deg, Tctr Roll:15.53deg, Tctr Yaw Rate:0deg/s | 8B 7B C0 FE 11 06 00 00 | . { À þ . . . . | U:0 S:0 | 8 | 8B 7B C0 FE 11 06 00 00
114 | 40.853 | 00000040.853' | 46124.7422965284 | 1 | 0x3F1 |  | Default: PDO |  | Default: TPDO 3 of Node 0x71 (113) | Easting:518723.159mm, Northing:3558743.374mm | 57 16 EB 1E 4E 1D 1E D4 | W . ë . N . . Ô | U:0 S:0 | 8 | 57 16 EB 1E 4E 1D 1E D4
115 | 10.143 | 00000010.143' | 46124.7422966458 | 1 | 0x182 |  | Default: PDO |  | Default: TPDO 1 of Node [0x02 (2)] Tractor IMU | Tctr Heading:316.26deg, Tctr Pitch:-3.2deg, Tctr Roll:15.52deg, Tctr Yaw Rate:0.11deg/s | 8A 7B C0 FE 10 06 0B 00 | . { À þ . . . . | U:0 S:0 | 8 | 8A 7B C0 FE 10 06 0B 00
116 | 39.862 | 00000039.862' | 46124.7422971072 | 1 | 0x3F1 |  | Default: PDO |  | Default: TPDO 3 of Node 0x71 (113) | Easting:518723.159mm, Northing:3558743.374mm | 57 16 EB 1E 4E 1D 1E D4 | W . ë . N . . Ô | U:0 S:0 | 8 | 57 16 EB 1E 4E 1D 1E D4
117 | 9.479 | 00000009.479' | 46124.7422972169 | 1 | 0x182 |  | Default: PDO |  | Default: TPDO 1 of Node [0x02 (2)] Tractor IMU | Tctr Heading:316.24deg, Tctr Pitch:-3.2deg, Tctr Roll:15.55deg, Tctr Yaw Rate:0.67deg/s | 88 7B C0 FE 13 06 43 00 | . { À þ . . C . | U:0 S:0 | 8 | 88 7B C0 FE 13 06 43 00
118 | 40.517 | 00000040.517' | 46124.7422976858 | 1 | 0x3F1 |  | Default: PDO |  | Default: TPDO 3 of Node 0x71 (113) | Easting:518723.159mm, Northing:3558743.374mm | 57 16 EB 1E 4E 1D 1E D4 | W . ë . N . . Ô | U:0 S:0 | 8 | 57 16 EB 1E 4E 1D 1E D4
119 | 9.151 | 00000009.151' | 46124.7422977917 | 1 | 0x182 |  | Default: PDO |  | Default: TPDO 1 of Node [0x02 (2)] Tractor IMU | Tctr Heading:316.21deg, Tctr Pitch:-3.18deg, Tctr Roll:15.55deg, Tctr Yaw Rate:0.67deg/s | 85 7B C2 FE 13 06 43 00 | . { Â þ . . C . | U:0 S:0 | 8 | 85 7B C2 FE 13 06 43 00
120 | 40.853 | 00000040.853' | 46124.7422982646 | 1 | 0x3F1 |  | Default: PDO |  | Default: TPDO 3 of Node 0x71 (113) | Easting:518723.159mm, Northing:3558743.374mm | 57 16 EB 1E 4E 1D 1E D4 | W . ë . N . . Ô | U:0 S:0 | 8 | 57 16 EB 1E 4E 1D 1E D4
121 | 10.047 | 00000010.047' | 46124.7422983809 | 1 | 0x182 |  | Default: PDO |  | Default: TPDO 1 of Node [0x02 (2)] Tractor IMU | Tctr Heading:316.2deg, Tctr Pitch:-3.19deg, Tctr Roll:15.55deg, Tctr Yaw Rate:-0.11deg/s | 84 7B C1 FE 13 06 F5 FF | . { Á þ . . õ ÿ | U:0 S:0 | 8 | 84 7B C1 FE 13 06 F5 FF
122 | 39.957 | 00000039.957' | 46124.7422988433 | 1 | 0x3F1 |  | Default: PDO |  | Default: TPDO 3 of Node 0x71 (113) | Easting:518723.159mm, Northing:3558743.374mm | 57 16 EB 1E 4E 1D 1E D4 | W . ë . N . . Ô | U:0 S:0 | 8 | 57 16 EB 1E 4E 1D 1E D4
123 | 9.496 | 00000009.496' | 46124.7422989532 | 1 | 0x182 |  | Default: PDO |  | Default: TPDO 1 of Node [0x02 (2)] Tractor IMU | Tctr Heading:316.22deg, Tctr Pitch:-3.19deg, Tctr Roll:15.54deg, Tctr Yaw Rate:-0.44deg/s | 86 7B C1 FE 12 06 D4 FF | . { Á þ . . Ô ÿ | U:0 S:0 | 8 | 86 7B C1 FE 12 06 D4 FF
124 | 40.503 | 00000040.503' | 46124.742299422 | 1 | 0x3F1 |  | Default: PDO |  | Default: TPDO 3 of Node 0x71 (113) | Easting:518723.159mm, Northing:3558743.374mm | 57 16 EB 1E 4E 1D 1E D4 | W . ë . N . . Ô | U:0 S:0 | 8 | 57 16 EB 1E 4E 1D 1E D4
125 | 9.184 | 00000009.184' | 46124.7422995283 | 1 | 0x182 |  | Default: PDO |  | Default: TPDO 1 of Node [0x02 (2)] Tractor IMU | Tctr Heading:316.26deg, Tctr Pitch:-3.19deg, Tctr Roll:15.55deg, Tctr Yaw Rate:-0.67deg/s | 8A 7B C1 FE 13 06 BD FF | . { Á þ . . ½ ÿ | U:0 S:0 | 8 | 8A 7B C1 FE 13 06 BD FF
126 | 40.822 | 00000040.822' | 46124.7423000008 | 1 | 0x3F1 |  | Default: PDO |  | Default: TPDO 3 of Node 0x71 (113) | Easting:518723.159mm, Northing:3558743.374mm | 57 16 EB 1E 4E 1D 1E D4 | W . ë . N . . Ô | U:0 S:0 | 8 | 57 16 EB 1E 4E 1D 1E D4
127 | 50.039 | 00000050.039' | 46124.7423005799 | 1 | 0x182 |  | Default: PDO |  | Default: TPDO 1 of Node [0x02 (2)] Tractor IMU | Tctr Heading:316.28deg, Tctr Pitch:-3.2deg, Tctr Roll:15.56deg, Tctr Yaw Rate:0deg/s | 8C 7B C0 FE 14 06 00 00 | . { À þ . . . . | U:0 S:0 | 8 | 8C 7B C0 FE 14 06 00 00
128 | 1.367 | 00000001.367' | 46124.7423005958 | 1 | 0x3F1 |  | Default: PDO |  | Default: TPDO 3 of Node 0x71 (113) | Easting:518723.159mm, Northing:3558743.374mm | 57 16 EB 1E 4E 1D 1E D4 | W . ë . N . . Ô | U:0 S:0 | 8 | 57 16 EB 1E 4E 1D 1E D4
129 | 48.645 | 00000048.645' | 46124.7423011588 | 1 | 0x182 |  | Default: PDO |  | Default: TPDO 1 of Node [0x02 (2)] Tractor IMU | Tctr Heading:316.29deg, Tctr Pitch:-3.21deg, Tctr Roll:15.56deg, Tctr Yaw Rate:0.44deg/s | 8D 7B BF FE 14 06 2C 00 | . { ¿ þ . . , . | U:0 S:0 | 8 | 8D 7B BF FE 14 06 2C 00
130 | 1.367 | 00000001.367' | 46124.7423011746 | 1 | 0x3F1 |  | Default: PDO |  | Default: TPDO 3 of Node 0x71 (113) | Easting:518723.159mm, Northing:3558743.374mm | 57 16 EB 1E 4E 1D 1E D4 | W . ë . N . . Ô | U:0 S:0 | 8 | 57 16 EB 1E 4E 1D 1E D4
131 | 48.606 | 00000048.606' | 46124.7423017372 | 1 | 0x182 |  | Default: PDO |  | Default: TPDO 1 of Node [0x02 (2)] Tractor IMU | Tctr Heading:316.27deg, Tctr Pitch:-3.2deg, Tctr Roll:15.55deg, Tctr Yaw Rate:0.67deg/s | 8B 7B C0 FE 13 06 43 00 | . { À þ . . C . | U:0 S:0 | 8 | 8B 7B C0 FE 13 06 43 00
132 | 1.366 | 00000001.366' | 46124.742301753 | 1 | 0x3F1 |  | Default: PDO |  | Default: TPDO 3 of Node 0x71 (113) | Easting:518723.159mm, Northing:3558743.374mm | 57 16 EB 1E 4E 1D 1E D4 | W . ë . N . . Ô | U:0 S:0 | 8 | 57 16 EB 1E 4E 1D 1E D4
133 | 48.646 | 00000048.646' | 46124.742302316 | 1 | 0x182 |  | Default: PDO |  | Default: TPDO 1 of Node [0x02 (2)] Tractor IMU | Tctr Heading:316.24deg, Tctr Pitch:-3.2deg, Tctr Roll:15.53deg, Tctr Yaw Rate:0.89deg/s | 88 7B C0 FE 11 06 59 00 | . { À þ . . Y . | U:0 S:0 | 8 | 88 7B C0 FE 11 06 59 00
134 | 1.367 | 00000001.367' | 46124.7423023318 | 1 | 0x3F1 |  | Default: PDO |  | Default: TPDO 3 of Node 0x71 (113) | Easting:518723.159mm, Northing:3558743.374mm | 57 16 EB 1E 4E 1D 1E D4 | W . ë . N . . Ô | U:0 S:0 | 8 | 57 16 EB 1E 4E 1D 1E D4
135 | 48.632 | 00000048.632' | 46124.7423028947 | 1 | 0x182 |  | Default: PDO |  | Default: TPDO 1 of Node [0x02 (2)] Tractor IMU | Tctr Heading:316.2deg, Tctr Pitch:-3.19deg, Tctr Roll:15.54deg, Tctr Yaw Rate:0.67deg/s | 84 7B C1 FE 12 06 43 00 | . { Á þ . . C . | U:0 S:0 | 8 | 84 7B C1 FE 12 06 43 00
136 | 1.369 | 00000001.369' | 46124.7423029106 | 1 | 0x3F1 |  | Default: PDO |  | Default: TPDO 3 of Node 0x71 (113) | Easting:518723.159mm, Northing:3558743.374mm | 57 16 EB 1E 4E 1D 1E D4 | W . ë . N . . Ô | U:0 S:0 | 8 | 57 16 EB 1E 4E 1D 1E D4
137 | 48.641 | 00000048.641' | 46124.7423034735 | 1 | 0x182 |  | Default: PDO |  | Default: TPDO 1 of Node [0x02 (2)] Tractor IMU | Tctr Heading:316.16deg, Tctr Pitch:-3.19deg, Tctr Roll:15.56deg, Tctr Yaw Rate:-0.44deg/s | 80 7B C1 FE 14 06 D4 FF | . { Á þ . . Ô ÿ | U:0 S:0 | 8 | 80 7B C1 FE 14 06 D4 FF
138 | 1.369 | 00000001.369' | 46124.7423034894 | 1 | 0x3F1 |  | Default: PDO |  | Default: TPDO 3 of Node 0x71 (113) | Easting:518723.159mm, Northing:3558743.374mm | 57 16 EB 1E 4E 1D 1E D4 | W . ë . N . . Ô | U:0 S:0 | 8 | 57 16 EB 1E 4E 1D 1E D4
139 | 48.641 | 00000048.641' | 46124.7423040523 | 1 | 0x182 |  | Default: PDO |  | Default: TPDO 1 of Node [0x02 (2)] Tractor IMU | Tctr Heading:316.18deg, Tctr Pitch:-3.19deg, Tctr Roll:15.55deg, Tctr Yaw Rate:-0.55deg/s | 82 7B C1 FE 13 06 C9 FF | . { Á þ . . É ÿ | U:0 S:0 | 8 | 82 7B C1 FE 13 06 C9 FF
140 | 1.369 | 00000001.369' | 46124.7423040682 | 1 | 0x3F1 |  | Default: PDO |  | Default: TPDO 3 of Node 0x71 (113) | Easting:518723.159mm, Northing:3558743.374mm | 57 16 EB 1E 4E 1D 1E D4 | W . ë . N . . Ô | U:0 S:0 | 8 | 57 16 EB 1E 4E 1D 1E D4
141 | 7.560 | 00000007.560' | 46124.7423041557 | 1 | 0x1F1 |  | Default: PDO |  | Default: TPDO 1 of Node 0x71 (113) | Fuse Easting Corr:601mm, Fuse Northing Corr:377mm, Fuse Alt Corr:-2494mm | 59 02 79 01 42 F6 | Y . y . B ö | U:0 S:0 | 6 | 59 02 79 01 42 F6
142 | 41.071 | 00000041.071' | 46124.7423046311 | 1 | 0x182 |  | Default: PDO |  | Default: TPDO 1 of Node [0x02 (2)] Tractor IMU | Tctr Heading:316.2deg, Tctr Pitch:-3.19deg, Tctr Roll:15.55deg, Tctr Yaw Rate:-0.22deg/s | 84 7B C1 FE 13 06 EA FF | . { Á þ . . ê ÿ | U:0 S:0 | 8 | 84 7B C1 FE 13 06 EA FF
143 | 1.460 | 00000001.460' | 46124.742304648 | 1 | 0x3F1 |  | Default: PDO |  | Default: TPDO 3 of Node 0x71 (113) | Easting:518723.159mm, Northing:3558743.382mm | 57 16 EB 1E 56 1D 1E D4 | W . ë . V . . Ô | U:0 S:0 | 8 | 57 16 EB 1E 56 1D 1E D4
144 | 48.629 | 00000048.629' | 46124.7423052108 | 1 | 0x182 |  | Default: PDO |  | Default: TPDO 1 of Node [0x02 (2)] Tractor IMU | Tctr Heading:316.21deg, Tctr Pitch:-3.19deg, Tctr Roll:15.55deg, Tctr Yaw Rate:-0.44deg/s | 85 7B C1 FE 13 06 D4 FF | . { Á þ . . Ô ÿ | U:0 S:0 | 8 | 85 7B C1 FE 13 06 D4 FF
145 | 1.359 | 00000001.359' | 46124.7423052265 | 1 | 0x3F1 |  | Default: PDO |  | Default: TPDO 3 of Node 0x71 (113) | Easting:518723.159mm, Northing:3558743.382mm | 57 16 EB 1E 56 1D 1E D4 | W . ë . V . . Ô | U:0 S:0 | 8 | 57 16 EB 1E 56 1D 1E D4
146 | 48.653 | 00000048.653' | 46124.7423057896 | 1 | 0x182 |  | Default: PDO |  | Default: TPDO 1 of Node [0x02 (2)] Tractor IMU | Tctr Heading:316.24deg, Tctr Pitch:-3.2deg, Tctr Roll:15.56deg, Tctr Yaw Rate:0.44deg/s | 88 7B C0 FE 14 06 2C 00 | . { À þ . . , . | U:0 S:0 | 8 | 88 7B C0 FE 14 06 2C 00
147 | 1.359 | 00000001.359' | 46124.7423058054 | 1 | 0x3F1 |  | Default: PDO |  | Default: TPDO 3 of Node 0x71 (113) | Easting:518723.159mm, Northing:3558743.382mm | 57 16 EB 1E 56 1D 1E D4 | W . ë . V . . Ô | U:0 S:0 | 8 | 57 16 EB 1E 56 1D 1E D4
148 | 48.638 | 00000048.638' | 46124.7423063683 | 1 | 0x182 |  | Default: PDO |  | Default: TPDO 1 of Node [0x02 (2)] Tractor IMU | Tctr Heading:316.22deg, Tctr Pitch:-3.2deg, Tctr Roll:15.56deg, Tctr Yaw Rate:0.44deg/s | 86 7B C0 FE 14 06 2C 00 | . { À þ . . , . | U:0 S:0 | 8 | 86 7B C0 FE 14 06 2C 00
149 | 1.359 | 00000001.359' | 46124.742306384 | 1 | 0x3F1 |  | Default: PDO |  | Default: TPDO 3 of Node 0x71 (113) | Easting:518723.159mm, Northing:3558743.382mm | 57 16 EB 1E 56 1D 1E D4 | W . ë . V . . Ô | U:0 S:0 | 8 | 57 16 EB 1E 56 1D 1E D4
150 | 48.621 | 00000048.621' | 46124.7423069468 | 1 | 0x182 |  | Default: PDO |  | Default: TPDO 1 of Node [0x02 (2)] Tractor IMU | Tctr Heading:316.2deg, Tctr Pitch:-3.18deg, Tctr Roll:15.57deg, Tctr Yaw Rate:-0.22deg/s | 84 7B C2 FE 15 06 EA FF | . { Â þ . . ê ÿ | U:0 S:0 | 8 | 84 7B C2 FE 15 06 EA FF
151 | 1.359 | 00000001.359' | 46124.7423069625 | 1 | 0x3F1 |  | Default: PDO |  | Default: TPDO 3 of Node 0x71 (113) | Easting:518723.159mm, Northing:3558743.382mm | 57 16 EB 1E 56 1D 1E D4 | W . ë . V . . Ô | U:0 S:0 | 8 | 57 16 EB 1E 56 1D 1E D4
152 | 48.677 | 00000048.677' | 46124.7423075259 | 1 | 0x182 |  | Default: PDO |  | Default: TPDO 1 of Node [0x02 (2)] Tractor IMU | Tctr Heading:316.19deg, Tctr Pitch:-3.19deg, Tctr Roll:15.56deg, Tctr Yaw Rate:0deg/s | 83 7B C1 FE 14 06 00 00 | . { Á þ . . . . | U:0 S:0 | 8 | 83 7B C1 FE 14 06 00 00
153 | 1.358 | 00000001.358' | 46124.7423075416 | 1 | 0x3F1 |  | Default: PDO |  | Default: TPDO 3 of Node 0x71 (113) | Easting:518723.159mm, Northing:3558743.382mm | 57 16 EB 1E 56 1D 1E D4 | W . ë . V . . Ô | U:0 S:0 | 8 | 57 16 EB 1E 56 1D 1E D4
154 | 48.629 | 00000048.629' | 46124.7423081044 | 1 | 0x182 |  | Default: PDO |  | Default: TPDO 1 of Node [0x02 (2)] Tractor IMU | Tctr Heading:316.2deg, Tctr Pitch:-3.19deg, Tctr Roll:15.55deg, Tctr Yaw Rate:0.11deg/s | 84 7B C1 FE 13 06 0B 00 | . { Á þ . . . . | U:0 S:0 | 8 | 84 7B C1 FE 13 06 0B 00
155 | 1.359 | 00000001.359' | 46124.7423081202 | 1 | 0x3F1 |  | Default: PDO |  | Default: TPDO 3 of Node 0x71 (113) | Easting:518723.159mm, Northing:3558743.382mm | 57 16 EB 1E 56 1D 1E D4 | W . ë . V . . Ô | U:0 S:0 | 8 | 57 16 EB 1E 56 1D 1E D4
156 | 48.654 | 00000048.654' | 46124.7423086833 | 1 | 0x182 |  | Default: PDO |  | Default: TPDO 1 of Node [0x02 (2)] Tractor IMU | Tctr Heading:316.19deg, Tctr Pitch:-3.19deg, Tctr Roll:15.57deg, Tctr Yaw Rate:-1.23deg/s | 83 7B C1 FE 15 06 85 FF | . { Á þ . . . ÿ | U:0 S:0 | 8 | 83 7B C1 FE 15 06 85 FF
157 | 1.359 | 00000001.359' | 46124.742308699 | 1 | 0x3F1 |  | Default: PDO |  | Default: TPDO 3 of Node 0x71 (113) | Easting:518723.159mm, Northing:3558743.382mm | 57 16 EB 1E 56 1D 1E D4 | W . ë . V . . Ô | U:0 S:0 | 8 | 57 16 EB 1E 56 1D 1E D4
158 | 48.637 | 00000048.637' | 46124.742309262 | 1 | 0x182 |  | Default: PDO |  | Default: TPDO 1 of Node [0x02 (2)] Tractor IMU | Tctr Heading:316.23deg, Tctr Pitch:-3.2deg, Tctr Roll:15.58deg, Tctr Yaw Rate:-1.45deg/s | 87 7B C0 FE 16 06 6F FF | . { À þ . . o ÿ | U:0 S:0 | 8 | 87 7B C0 FE 16 06 6F FF
159 | 1.360 | 00000001.360' | 46124.7423092777 | 1 | 0x3F1 |  | Default: PDO |  | Default: TPDO 3 of Node 0x71 (113) | Easting:518723.159mm, Northing:3558743.382mm | 57 16 EB 1E 56 1D 1E D4 | W . ë . V . . Ô | U:0 S:0 | 8 | 57 16 EB 1E 56 1D 1E D4
160 | 48.630 | 00000048.630' | 46124.7423098405 | 1 | 0x182 |  | Default: PDO |  | Default: TPDO 1 of Node [0x02 (2)] Tractor IMU | Tctr Heading:316.3deg, Tctr Pitch:-3.22deg, Tctr Roll:15.57deg, Tctr Yaw Rate:-0.55deg/s | 8E 7B BE FE 15 06 C9 FF | . { ¾ þ . . É ÿ | U:0 S:0 | 8 | 8E 7B BE FE 15 06 C9 FF
161 | 1.360 | 00000001.360' | 46124.7423098563 | 1 | 0x3F1 |  | Default: PDO |  | Default: TPDO 3 of Node 0x71 (113) | Easting:518723.159mm, Northing:3558743.382mm | 57 16 EB 1E 56 1D 1E D4 | W . ë . V . . Ô | U:0 S:0 | 8 | 57 16 EB 1E 56 1D 1E D4
162 | 48.647 | 00000048.647' | 46124.7423104193 | 1 | 0x182 |  | Default: PDO |  | Default: TPDO 1 of Node [0x02 (2)] Tractor IMU | Tctr Heading:316.34deg, Tctr Pitch:-3.22deg, Tctr Roll:15.59deg, Tctr Yaw Rate:-0.22deg/s | 92 7B BE FE 17 06 EA FF | . { ¾ þ . . ê ÿ | U:0 S:0 | 8 | 92 7B BE FE 17 06 EA FF
163 | 1.360 | 00000001.360' | 46124.7423104351 | 1 | 0x3F1 |  | Default: PDO |  | Default: TPDO 3 of Node 0x71 (113) | Easting:518723.159mm, Northing:3558743.382mm | 57 16 EB 1E 56 1D 1E D4 | W . ë . V . . Ô | U:0 S:0 | 8 | 57 16 EB 1E 56 1D 1E D4
164 | 48.610 | 00000048.610' | 46124.7423109977 | 1 | 0x3F1 |  | Default: PDO |  | Default: TPDO 3 of Node 0x71 (113) | Easting:518723.159mm, Northing:3558743.382mm | 57 16 EB 1E 56 1D 1E D4 | W . ë . V . . Ô | U:0 S:0 | 8 | 57 16 EB 1E 56 1D 1E D4
165 | 0.920 | 00000000.920' | 46124.7423110083 | 1 | 0x182 |  | Default: PDO |  | Default: TPDO 1 of Node [0x02 (2)] Tractor IMU | Tctr Heading:316.35deg, Tctr Pitch:-3.23deg, Tctr Roll:15.58deg, Tctr Yaw Rate:1.67deg/s | 93 7B BD FE 16 06 A7 00 | . { ½ þ . . § . | U:0 S:0 | 8 | 93 7B BD FE 16 06 A7 00
166 | 49.082 | 00000049.082' | 46124.7423115764 | 1 | 0x3F1 |  | Default: PDO |  | Default: TPDO 3 of Node 0x71 (113) | Easting:518723.159mm, Northing:3558743.382mm | 57 16 EB 1E 56 1D 1E D4 | W . ë . V . . Ô | U:0 S:0 | 8 | 57 16 EB 1E 56 1D 1E D4
167 | 4.056 | 00000004.056' | 46124.7423116234 | 1 | 0x182 |  | Default: PDO |  | Default: TPDO 1 of Node [0x02 (2)] Tractor IMU | Tctr Heading:316.29deg, Tctr Pitch:-3.22deg, Tctr Roll:15.58deg, Tctr Yaw Rate:2.68deg/s | 8D 7B BE FE 16 06 0C 01 | . { ¾ þ . . . . | U:0 S:0 | 8 | 8D 7B BE FE 16 06 0C 01
168 | 45.944 | 00000045.944' | 46124.7423121551 | 1 | 0x3F1 |  | Default: PDO |  | Default: TPDO 3 of Node 0x71 (113) | Easting:518723.159mm, Northing:3558743.382mm | 57 16 EB 1E 56 1D 1E D4 | W . ë . V . . Ô | U:0 S:0 | 8 | 57 16 EB 1E 56 1D 1E D4
169 | 3.735 | 00000003.735' | 46124.7423121984 | 1 | 0x182 |  | Default: PDO |  | Default: TPDO 1 of Node [0x02 (2)] Tractor IMU | Tctr Heading:316.18deg, Tctr Pitch:-3.19deg, Tctr Roll:15.57deg, Tctr Yaw Rate:1deg/s | 82 7B C1 FE 15 06 64 00 | . { Á þ . . d . | U:0 S:0 | 8 | 82 7B C1 FE 15 06 64 00
170 | 46.262 | 00000046.262' | 46124.7423127338 | 1 | 0x3F1 |  | Default: PDO |  | Default: TPDO 3 of Node 0x71 (113) | Easting:518723.159mm, Northing:3558743.382mm | 57 16 EB 1E 56 1D 1E D4 | W . ë . V . . Ô | U:0 S:0 | 8 | 57 16 EB 1E 56 1D 1E D4
171 | 3.407 | 00000003.407' | 46124.7423127732 | 1 | 0x182 |  | Default: PDO |  | Default: TPDO 1 of Node [0x02 (2)] Tractor IMU | Tctr Heading:316.13deg, Tctr Pitch:-3.17deg, Tctr Roll:15.55deg, Tctr Yaw Rate:-1.34deg/s | 7D 7B C3 FE 13 06 7A FF | } { Ã þ . . z ÿ | U:0 S:0 | 8 | 7D 7B C3 FE 13 06 7A FF
172 | 46.598 | 00000046.598' | 46124.7423133125 | 1 | 0x3F1 |  | Default: PDO |  | Default: TPDO 3 of Node 0x71 (113) | Easting:518723.159mm, Northing:3558743.382mm | 57 16 EB 1E 56 1D 1E D4 | W . ë . V . . Ô | U:0 S:0 | 8 | 57 16 EB 1E 56 1D 1E D4
173 | 4.071 | 00000004.071' | 46124.7423133597 | 1 | 0x182 |  | Default: PDO |  | Default: TPDO 1 of Node [0x02 (2)] Tractor IMU | Tctr Heading:316.16deg, Tctr Pitch:-3.19deg, Tctr Roll:15.57deg, Tctr Yaw Rate:-2.9deg/s | 80 7B C1 FE 15 06 DE FE | . { Á þ . . Þ þ | U:0 S:0 | 8 | 80 7B C1 FE 15 06 DE FE
174 | 45.933 | 00000045.933' | 46124.7423138913 | 1 | 0x3F1 |  | Default: PDO |  | Default: TPDO 3 of Node 0x71 (113) | Easting:518723.159mm, Northing:3558743.382mm | 57 16 EB 1E 56 1D 1E D4 | W . ë . V . . Ô | U:0 S:0 | 8 | 57 16 EB 1E 56 1D 1E D4
175 | 10.222 | 00000010.222' | 46124.7423140096 | 1 | 0x182 |  | Default: PDO |  | Default: TPDO 1 of Node [0x02 (2)] Tractor IMU | Tctr Heading:316.44deg, Tctr Pitch:-3.26deg, Tctr Roll:15.53deg, Tctr Yaw Rate:-2.12deg/s | 9C 7B BA FE 11 06 2C FF | . { º þ . . , ÿ | U:0 S:0 | 8 | 9C 7B BA FE 11 06 2C FF
176 | 39.775 | 00000039.775' | 46124.74231447 | 1 | 0x3F1 |  | Default: PDO |  | Default: TPDO 3 of Node 0x71 (113) | Easting:518723.159mm, Northing:3558743.382mm | 57 16 EB 1E 56 1D 1E D4 | W . ë . V . . Ô | U:0 S:0 | 8 | 57 16 EB 1E 56 1D 1E D4
177 | 10.110 | 00000010.110' | 46124.742314587 | 1 | 0x182 |  | Default: PDO |  | Default: TPDO 1 of Node [0x02 (2)] Tractor IMU | Tctr Heading:316.5deg, Tctr Pitch:-3.27deg, Tctr Roll:15.53deg, Tctr Yaw Rate:-1.11deg/s | A2 7B B9 FE 11 06 91 FF | ¢ { ¹ þ . . . ÿ | U:0 S:0 | 8 | A2 7B B9 FE 11 06 91 FF
178 | 39.894 | 00000039.894' | 46124.7423150487 | 1 | 0x3F1 |  | Default: PDO |  | Default: TPDO 3 of Node 0x71 (113) | Easting:518723.159mm, Northing:3558743.382mm | 57 16 EB 1E 56 1D 1E D4 | W . ë . V . . Ô | U:0 S:0 | 8 | 57 16 EB 1E 56 1D 1E D4
179 | 9.333 | 00000009.333' | 46124.7423151567 | 1 | 0x182 |  | Default: PDO |  | Default: TPDO 1 of Node [0x02 (2)] Tractor IMU | Tctr Heading:316.52deg, Tctr Pitch:-3.27deg, Tctr Roll:15.49deg, Tctr Yaw Rate:0deg/s | A4 7B B9 FE 0D 06 00 00 | ¤ { ¹ þ . . . . | U:0 S:0 | 8 | A4 7B B9 FE 0D 06 00 00
180 | 30.640 | 00000030.640' | 46124.7423155114 | 1 | 0x1F1 |  | Default: PDO |  | Default: TPDO 1 of Node 0x71 (113) | Fuse Easting Corr:604mm, Fuse Northing Corr:369mm, Fuse Alt Corr:-2494mm | 5C 02 71 01 42 F6 | \ . q . B ö | U:0 S:0 | 6 | 5C 02 71 01 42 F6
181 | 10.037 | 00000010.037' | 46124.7423156275 | 1 | 0x3F1 |  | Default: PDO |  | Default: TPDO 3 of Node 0x71 (113) | Easting:518723.164mm, Northing:3558743.379mm | 5C 16 EB 1E 53 1D 1E D4 | \ . ë . S . . Ô | U:0 S:0 | 8 | 5C 16 EB 1E 53 1D 1E D4
182 | 10.142 | 00000010.142' | 46124.7423157449 | 1 | 0x182 |  | Default: PDO |  | Default: TPDO 1 of Node [0x02 (2)] Tractor IMU | Tctr Heading:316.44deg, Tctr Pitch:-3.26deg, Tctr Roll:15.52deg, Tctr Yaw Rate:2.12deg/s | 9C 7B BA FE 10 06 D4 00 | . { º þ . . Ô . | U:0 S:0 | 8 | 9C 7B BA FE 10 06 D4 00
183 | 39.862 | 00000039.862' | 46124.7423162063 | 1 | 0x3F1 |  | Default: PDO |  | Default: TPDO 3 of Node 0x71 (113) | Easting:518723.164mm, Northing:3558743.379mm | 5C 16 EB 1E 53 1D 1E D4 | \ . ë . S . . Ô | U:0 S:0 | 8 | 5C 16 EB 1E 53 1D 1E D4
184 | 9.769 | 00000009.769' | 46124.7423163194 | 1 | 0x182 |  | Default: PDO |  | Default: TPDO 1 of Node [0x02 (2)] Tractor IMU | Tctr Heading:316.34deg, Tctr Pitch:-3.25deg, Tctr Roll:15.5deg, Tctr Yaw Rate:2.57deg/s | 92 7B BB FE 0E 06 01 01 | . { » þ . . . . | U:0 S:0 | 8 | 92 7B BB FE 0E 06 01 01
185 | 40.327 | 00000040.327' | 46124.7423167861 | 1 | 0x3F1 |  | Default: PDO |  | Default: TPDO 3 of Node 0x71 (113) | Easting:518723.164mm, Northing:3558743.379mm | 5C 16 EB 1E 53 1D 1E D4 | \ . ë . S . . Ô | U:0 S:0 | 8 | 5C 16 EB 1E 53 1D 1E D4
186 | 9.335 | 00000009.335' | 46124.7423168941 | 1 | 0x182 |  | Default: PDO |  | Default: TPDO 1 of Node [0x02 (2)] Tractor IMU | Tctr Heading:316.27deg, Tctr Pitch:-3.23deg, Tctr Roll:15.52deg, Tctr Yaw Rate:1deg/s | 8B 7B BD FE 10 06 64 00 | . { ½ þ . . d . | U:0 S:0 | 8 | 8B 7B BD FE 10 06 64 00
187 | 40.669 | 00000040.669' | 46124.7423173648 | 1 | 0x3F1 |  | Default: PDO |  | Default: TPDO 3 of Node 0x71 (113) | Easting:518723.164mm, Northing:3558743.379mm | 5C 16 EB 1E 53 1D 1E D4 | \ . ë . S . . Ô | U:0 S:0 | 8 | 5C 16 EB 1E 53 1D 1E D4
188 | 10.342 | 00000010.342' | 46124.7423174846 | 1 | 0x182 |  | Default: PDO |  | Default: TPDO 1 of Node [0x02 (2)] Tractor IMU | Tctr Heading:316.24deg, Tctr Pitch:-3.23deg, Tctr Roll:15.5deg, Tctr Yaw Rate:0.44deg/s | 88 7B BD FE 0E 06 2C 00 | . { ½ þ . . , . | U:0 S:0 | 8 | 88 7B BD FE 0E 06 2C 00
189 | 39.662 | 00000039.662' | 46124.7423179436 | 1 | 0x3F1 |  | Default: PDO |  | Default: TPDO 3 of Node 0x71 (113) | Easting:518723.164mm, Northing:3558743.379mm | 5C 16 EB 1E 53 1D 1E D4 | \ . ë . S . . Ô | U:0 S:0 | 8 | 5C 16 EB 1E 53 1D 1E D4
190 | 9.943 | 00000009.943' | 46124.7423180587 | 1 | 0x182 |  | Default: PDO |  | Default: TPDO 1 of Node [0x02 (2)] Tractor IMU | Tctr Heading:316.26deg, Tctr Pitch:-3.23deg, Tctr Roll:15.48deg, Tctr Yaw Rate:-0.55deg/s | 8A 7B BD FE 0C 06 C9 FF | . { ½ þ . . É ÿ | U:0 S:0 | 8 | 8A 7B BD FE 0C 06 C9 FF
191 | 40.064 | 00000040.064' | 46124.7423185224 | 1 | 0x3F1 |  | Default: PDO |  | Default: TPDO 3 of Node 0x71 (113) | Easting:518723.164mm, Northing:3558743.379mm | 5C 16 EB 1E 53 1D 1E D4 | \ . ë . S . . Ô | U:0 S:0 | 8 | 5C 16 EB 1E 53 1D 1E D4
192 | 9.353 | 00000009.353' | 46124.7423186306 | 1 | 0x182 |  | Default: PDO |  | Default: TPDO 1 of Node [0x02 (2)] Tractor IMU | Tctr Heading:316.28deg, Tctr Pitch:-3.24deg, Tctr Roll:15.51deg, Tctr Yaw Rate:-0.44deg/s | 8C 7B BC FE 0F 06 D4 FF | . { ¼ þ . . Ô ÿ | U:0 S:0 | 8 | 8C 7B BC FE 0F 06 D4 FF
193 | 40.649 | 00000040.649' | 46124.7423191011 | 1 | 0x3F1 |  | Default: PDO |  | Default: TPDO 3 of Node 0x71 (113) | Easting:518723.164mm, Northing:3558743.379mm | 5C 16 EB 1E 53 1D 1E D4 | \ . ë . S . . Ô | U:0 S:0 | 8 | 5C 16 EB 1E 53 1D 1E D4
194 | 10.561 | 00000010.561' | 46124.7423192233 | 1 | 0x182 |  | Default: PDO |  | Default: TPDO 1 of Node [0x02 (2)] Tractor IMU | Tctr Heading:316.3deg, Tctr Pitch:-3.24deg, Tctr Roll:15.49deg, Tctr Yaw Rate:-0.22deg/s | 8E 7B BC FE 0D 06 EA FF | . { ¼ þ . . ê ÿ | U:0 S:0 | 8 | 8E 7B BC FE 0D 06 EA FF
195 | 39.440 | 00000039.440' | 46124.7423196798 | 1 | 0x3F1 |  | Default: PDO |  | Default: TPDO 3 of Node 0x71 (113) | Easting:518723.164mm, Northing:3558743.379mm | 5C 16 EB 1E 53 1D 1E D4 | \ . ë . S . . Ô | U:0 S:0 | 8 | 5C 16 EB 1E 53 1D 1E D4
196 | 10.137 | 00000010.137' | 46124.7423197972 | 1 | 0x182 |  | Default: PDO |  | Default: TPDO 1 of Node [0x02 (2)] Tractor IMU | Tctr Heading:316.32deg, Tctr Pitch:-3.25deg, Tctr Roll:15.49deg, Tctr Yaw Rate:-0.44deg/s | 90 7B BB FE 0D 06 D4 FF | . { » þ . . Ô ÿ | U:0 S:0 | 8 | 90 7B BB FE 0D 06 D4 FF
197 | 39.863 | 00000039.863' | 46124.7423202585 | 1 | 0x3F1 |  | Default: PDO |  | Default: TPDO 3 of Node 0x71 (113) | Easting:518723.164mm, Northing:3558743.379mm | 5C 16 EB 1E 53 1D 1E D4 | \ . ë . S . . Ô | U:0 S:0 | 8 | 5C 16 EB 1E 53 1D 1E D4
198 | 9.391 | 00000009.391' | 46124.7423203672 | 1 | 0x182 |  | Default: PDO |  | Default: TPDO 1 of Node [0x02 (2)] Tractor IMU | Tctr Heading:316.32deg, Tctr Pitch:-3.25deg, Tctr Roll:15.49deg, Tctr Yaw Rate:0deg/s | 90 7B BB FE 0D 06 00 00 | . { » þ . . . . | U:0 S:0 | 8 | 90 7B BB FE 0D 06 00 00
199 | 40.604 | 00000040.604' | 46124.7423208372 | 1 | 0x3F1 |  | Default: PDO |  | Default: TPDO 3 of Node 0x71 (113) | Easting:518723.164mm, Northing:3558743.379mm | 5C 16 EB 1E 53 1D 1E D4 | \ . ë . S . . Ô | U:0 S:0 | 8 | 5C 16 EB 1E 53 1D 1E D4
200 | 10.135 | 00000010.135' | 46124.7423209545 | 1 | 0x182 |  | Default: PDO |  | Default: TPDO 1 of Node [0x02 (2)] Tractor IMU | Tctr Heading:316.27deg, Tctr Pitch:-3.24deg, Tctr Roll:15.48deg, Tctr Yaw Rate:1.11deg/s | 8B 7B BC FE 0C 06 6F 00 | . { ¼ þ . . o . | U:0 S:0 | 8 | 8B 7B BC FE 0C 06 6F 00
201 | 39.869 | 00000039.869' | 46124.7423214159 | 1 | 0x3F1 |  | Default: PDO |  | Default: TPDO 3 of Node 0x71 (113) | Easting:518723.164mm, Northing:3558743.379mm | 5C 16 EB 1E 53 1D 1E D4 | \ . ë . S . . Ô | U:0 S:0 | 8 | 5C 16 EB 1E 53 1D 1E D4
202 | 10.007 | 00000010.007' | 46124.7423215317 | 1 | 0x182 |  | Default: PDO |  | Default: TPDO 1 of Node [0x02 (2)] Tractor IMU | Tctr Heading:316.22deg, Tctr Pitch:-3.23deg, Tctr Roll:15.5deg, Tctr Yaw Rate:1deg/s | 86 7B BD FE 0E 06 64 00 | . { ½ þ . . d . | U:0 S:0 | 8 | 86 7B BD FE 0E 06 64 00
203 | 39.997 | 00000039.997' | 46124.7423219947 | 1 | 0x3F1 |  | Default: PDO |  | Default: TPDO 3 of Node 0x71 (113) | Easting:518723.164mm, Northing:3558743.379mm | 5C 16 EB 1E 53 1D 1E D4 | \ . ë . S . . Ô | U:0 S:0 | 8 | 5C 16 EB 1E 53 1D 1E D4
204 | 9.382 | 00000009.382' | 46124.7423221033 | 1 | 0x182 |  | Default: PDO |  | Default: TPDO 1 of Node [0x02 (2)] Tractor IMU | Tctr Heading:316.22deg, Tctr Pitch:-3.23deg, Tctr Roll:15.5deg, Tctr Yaw Rate:-0.22deg/s | 86 7B BD FE 0E 06 EA FF | . { ½ þ . . ê ÿ | U:0 S:0 | 8 | 86 7B BD FE 0E 06 EA FF
205 | 40.624 | 00000040.624' | 46124.7423225735 | 1 | 0x3F1 |  | Default: PDO |  | Default: TPDO 3 of Node 0x71 (113) | Easting:518723.164mm, Northing:3558743.379mm | 5C 16 EB 1E 53 1D 1E D4 | \ . ë . S . . Ô | U:0 S:0 | 8 | 5C 16 EB 1E 53 1D 1E D4
206 | 10.631 | 00000010.631' | 46124.7423226965 | 1 | 0x182 |  | Default: PDO |  | Default: TPDO 1 of Node [0x02 (2)] Tractor IMU | Tctr Heading:316.26deg, Tctr Pitch:-3.23deg, Tctr Roll:15.5deg, Tctr Yaw Rate:-0.89deg/s | 8A 7B BD FE 0E 06 A7 FF | . { ½ þ . . § ÿ | U:0 S:0 | 8 | 8A 7B BD FE 0E 06 A7 FF
207 | 39.366 | 00000039.366' | 46124.7423231521 | 1 | 0x3F1 |  | Default: PDO |  | Default: TPDO 3 of Node 0x71 (113) | Easting:518723.164mm, Northing:3558743.379mm | 5C 16 EB 1E 53 1D 1E D4 | \ . ë . S . . Ô | U:0 S:0 | 8 | 5C 16 EB 1E 53 1D 1E D4
208 | 50.046 | 00000050.046' | 46124.7423237314 | 1 | 0x182 |  | Default: PDO |  | Default: TPDO 1 of Node [0x02 (2)] Tractor IMU | Tctr Heading:316.29deg, Tctr Pitch:-3.24deg, Tctr Roll:15.48deg, Tctr Yaw Rate:-0.78deg/s | 8D 7B BC FE 0C 06 B2 FF | . { ¼ þ . . ² ÿ | U:0 S:0 | 8 | 8D 7B BC FE 0C 06 B2 FF
209 | 1.367 | 00000001.367' | 46124.7423237472 | 1 | 0x3F1 |  | Default: PDO |  | Default: TPDO 3 of Node 0x71 (113) | Easting:518723.164mm, Northing:3558743.379mm | 5C 16 EB 1E 53 1D 1E D4 | \ . ë . S . . Ô | U:0 S:0 | 8 | 5C 16 EB 1E 53 1D 1E D4
210 | 48.637 | 00000048.637' | 46124.7423243101 | 1 | 0x182 |  | Default: PDO |  | Default: TPDO 1 of Node [0x02 (2)] Tractor IMU | Tctr Heading:316.33deg, Tctr Pitch:-3.25deg, Tctr Roll:15.48deg, Tctr Yaw Rate:0deg/s | 91 7B BB FE 0C 06 00 00 | . { » þ . . . . | U:0 S:0 | 8 | 91 7B BB FE 0C 06 00 00
211 | 1.367 | 00000001.367' | 46124.7423243259 | 1 | 0x3F1 |  | Default: PDO |  | Default: TPDO 3 of Node 0x71 (113) | Easting:518723.164mm, Northing:3558743.379mm | 5C 16 EB 1E 53 1D 1E D4 | \ . ë . S . . Ô | U:0 S:0 | 8 | 5C 16 EB 1E 53 1D 1E D4
212 | 48.613 | 00000048.613' | 46124.7423248886 | 1 | 0x182 |  | Default: PDO |  | Default: TPDO 1 of Node [0x02 (2)] Tractor IMU | Tctr Heading:316.34deg, Tctr Pitch:-3.26deg, Tctr Roll:15.5deg, Tctr Yaw Rate:1.23deg/s | 92 7B BA FE 0E 06 7B 00 | . { º þ . . { . | U:0 S:0 | 8 | 92 7B BA FE 0E 06 7B 00
213 | 1.367 | 00000001.367' | 46124.7423249044 | 1 | 0x3F1 |  | Default: PDO |  | Default: TPDO 3 of Node 0x71 (113) | Easting:518723.164mm, Northing:3558743.379mm | 5C 16 EB 1E 53 1D 1E D4 | \ . ë . S . . Ô | U:0 S:0 | 8 | 5C 16 EB 1E 53 1D 1E D4
214 | 48.646 | 00000048.646' | 46124.7423254674 | 1 | 0x182 |  | Default: PDO |  | Default: TPDO 1 of Node [0x02 (2)] Tractor IMU | Tctr Heading:316.28deg, Tctr Pitch:-3.24deg, Tctr Roll:15.5deg, Tctr Yaw Rate:1.79deg/s | 8C 7B BC FE 0E 06 B3 00 | . { ¼ þ . . ³ . | U:0 S:0 | 8 | 8C 7B BC FE 0E 06 B3 00
215 | 1.367 | 00000001.367' | 46124.7423254833 | 1 | 0x3F1 |  | Default: PDO |  | Default: TPDO 3 of Node 0x71 (113) | Easting:518723.164mm, Northing:3558743.379mm | 5C 16 EB 1E 53 1D 1E D4 | \ . ë . S . . Ô | U:0 S:0 | 8 | 5C 16 EB 1E 53 1D 1E D4
216 | 48.653 | 00000048.653' | 46124.7423260464 | 1 | 0x182 |  | Default: PDO |  | Default: TPDO 1 of Node [0x02 (2)] Tractor IMU | Tctr Heading:316.2deg, Tctr Pitch:-3.23deg, Tctr Roll:15.51deg, Tctr Yaw Rate:2.01deg/s | 84 7B BD FE 0F 06 C9 00 | . { ½ þ . . É . | U:0 S:0 | 8 | 84 7B BD FE 0F 06 C9 00
217 | 1.367 | 00000001.367' | 46124.7423260622 | 1 | 0x3F1 |  | Default: PDO |  | Default: TPDO 3 of Node 0x71 (113) | Easting:518723.164mm, Northing:3558743.379mm | 5C 16 EB 1E 53 1D 1E D4 | \ . ë . S . . Ô | U:0 S:0 | 8 | 5C 16 EB 1E 53 1D 1E D4
218 | 48.622 | 00000048.622' | 46124.7423266249 | 1 | 0x182 |  | Default: PDO |  | Default: TPDO 1 of Node [0x02 (2)] Tractor IMU | Tctr Heading:316.12deg, Tctr Pitch:-3.21deg, Tctr Roll:15.49deg, Tctr Yaw Rate:2.01deg/s | 7C 7B BF FE 0D 06 C9 00 | | { ¿ þ . . É . | U:0 S:0 | 8 | 7C 7B BF FE 0D 06 C9 00
219 | 1.367 | 00000001.367' | 46124.7423266408 | 1 | 0x3F1 |  | Default: PDO |  | Default: TPDO 3 of Node 0x71 (113) | Easting:518723.164mm, Northing:3558743.379mm | 5C 16 EB 1E 53 1D 1E D4 | \ . ë . S . . Ô | U:0 S:0 | 8 | 5C 16 EB 1E 53 1D 1E D4
220 | 48.600 | 00000048.600' | 46124.7423272033 | 1 | 0x3F1 |  | Default: PDO |  | Default: TPDO 3 of Node 0x71 (113) | Easting:518723.164mm, Northing:3558743.379mm | 5C 16 EB 1E 53 1D 1E D4 | \ . ë . S . . Ô | U:0 S:0 | 8 | 5C 16 EB 1E 53 1D 1E D4
221 | 1.464 | 00000001.464' | 46124.7423272202 | 1 | 0x1F1 |  | Default: PDO |  | Default: TPDO 1 of Node 0x71 (113) | Fuse Easting Corr:599mm, Fuse Northing Corr:375mm, Fuse Alt Corr:-2494mm | 57 02 77 01 42 F6 | W . w . B ö | U:0 S:0 | 6 | 57 02 77 01 42 F6
222 | 1.735 | 00000001.735' | 46124.7423272403 | 1 | 0x182 |  | Default: PDO |  | Default: TPDO 1 of Node [0x02 (2)] Tractor IMU | Tctr Heading:316.04deg, Tctr Pitch:-3.2deg, Tctr Roll:15.49deg, Tctr Yaw Rate:0.78deg/s | 74 7B C0 FE 0D 06 4E 00 | t { À þ . . N . | U:0 S:0 | 8 | 74 7B C0 FE 0D 06 4E 00
223 | 46.798 | 00000046.798' | 46124.7423277819 | 1 | 0x3F1 |  | Default: PDO |  | Default: TPDO 3 of Node 0x71 (113) | Easting:518723.16mm, Northing:3558743.39mm | 58 16 EB 1E 5E 1D 1E D4 | X . ë . ^ . . Ô | U:0 S:0 | 8 | 58 16 EB 1E 5E 1D 1E D4
224 | 3.962 | 00000003.962' | 46124.7423278278 | 1 | 0x182 |  | Default: PDO |  | Default: TPDO 1 of Node [0x02 (2)] Tractor IMU | Tctr Heading:315.98deg, Tctr Pitch:-3.19deg, Tctr Roll:15.48deg, Tctr Yaw Rate:-0.11deg/s | 6E 7B C1 FE 0C 06 F5 FF | n { Á þ . . õ ÿ | U:0 S:0 | 8 | 6E 7B C1 FE 0C 06 F5 FF
225 | 46.142 | 00000046.142' | 46124.7423283618 | 1 | 0x3F1 |  | Default: PDO |  | Default: TPDO 3 of Node 0x71 (113) | Easting:518723.16mm, Northing:3558743.39mm | 58 16 EB 1E 5E 1D 1E D4 | X . ë . ^ . . Ô | U:0 S:0 | 8 | 58 16 EB 1E 5E 1D 1E D4
226 | 3.535 | 00000003.535' | 46124.7423284028 | 1 | 0x182 |  | Default: PDO |  | Default: TPDO 1 of Node [0x02 (2)] Tractor IMU | Tctr Heading:315.97deg, Tctr Pitch:-3.18deg, Tctr Roll:15.48deg, Tctr Yaw Rate:-0.67deg/s | 6D 7B C2 FE 0C 06 BD FF | m { Â þ . . ½ ÿ | U:0 S:0 | 8 | 6D 7B C2 FE 0C 06 BD FF
227 | 46.469 | 00000046.469' | 46124.7423289406 | 1 | 0x3F1 |  | Default: PDO |  | Default: TPDO 3 of Node 0x71 (113) | Easting:518723.16mm, Northing:3558743.39mm | 58 16 EB 1E 5E 1D 1E D4 | X . ë . ^ . . Ô | U:0 S:0 | 8 | 58 16 EB 1E 5E 1D 1E D4
228 | 3.222 | 00000003.222' | 46124.7423289779 | 1 | 0x182 |  | Default: PDO |  | Default: TPDO 1 of Node [0x02 (2)] Tractor IMU | Tctr Heading:316deg, Tctr Pitch:-3.19deg, Tctr Roll:15.5deg, Tctr Yaw Rate:-1.56deg/s | 70 7B C1 FE 0E 06 64 FF | p { Á þ . . d ÿ | U:0 S:0 | 8 | 70 7B C1 FE 0E 06 64 FF
229 | 46.775 | 00000046.775' | 46124.7423295193 | 1 | 0x3F1 |  | Default: PDO |  | Default: TPDO 3 of Node 0x71 (113) | Easting:518723.16mm, Northing:3558743.39mm | 58 16 EB 1E 5E 1D 1E D4 | X . ë . ^ . . Ô | U:0 S:0 | 8 | 58 16 EB 1E 5E 1D 1E D4
230 | 3.886 | 00000003.886' | 46124.7423295642 | 1 | 0x182 |  | Default: PDO |  | Default: TPDO 1 of Node [0x02 (2)] Tractor IMU | Tctr Heading:316.07deg, Tctr Pitch:-3.2deg, Tctr Roll:15.49deg, Tctr Yaw Rate:-1.34deg/s | 77 7B C0 FE 0D 06 7A FF | w { À þ . . z ÿ | U:0 S:0 | 8 | 77 7B C0 FE 0D 06 7A FF
231 | 46.120 | 00000046.120' | 46124.742330098 | 1 | 0x3F1 |  | Default: PDO |  | Default: TPDO 3 of Node 0x71 (113) | Easting:518723.16mm, Northing:3558743.39mm | 58 16 EB 1E 5E 1D 1E D4 | X . ë . ^ . . Ô | U:0 S:0 | 8 | 58 16 EB 1E 5E 1D 1E D4
232 | 3.560 | 00000003.560' | 46124.7423301392 | 1 | 0x182 |  | Default: PDO |  | Default: TPDO 1 of Node [0x02 (2)] Tractor IMU | Tctr Heading:316.14deg, Tctr Pitch:-3.22deg, Tctr Roll:15.49deg, Tctr Yaw Rate:-0.67deg/s | 7E 7B BE FE 0D 06 BD FF | ~ { ¾ þ . . ½ ÿ | U:0 S:0 | 8 | 7E 7B BE FE 0D 06 BD FF
233 | 46.442 | 00000046.442' | 46124.7423306768 | 1 | 0x3F1 |  | Default: PDO |  | Default: TPDO 3 of Node 0x71 (113) | Easting:518723.16mm, Northing:3558743.39mm | 58 16 EB 1E 5E 1D 1E D4 | X . ë . ^ . . Ô | U:0 S:0 | 8 | 58 16 EB 1E 5E 1D 1E D4
234 | 3.248 | 00000003.248' | 46124.7423307143 | 1 | 0x182 |  | Default: PDO |  | Default: TPDO 1 of Node [0x02 (2)] Tractor IMU | Tctr Heading:316.19deg, Tctr Pitch:-3.23deg, Tctr Roll:15.48deg, Tctr Yaw Rate:0.44deg/s | 83 7B BD FE 0C 06 2C 00 | . { ½ þ . . , . | U:0 S:0 | 8 | 83 7B BD FE 0C 06 2C 00
235 | 46.754 | 00000046.754' | 46124.7423312555 | 1 | 0x3F1 |  | Default: PDO |  | Default: TPDO 3 of Node 0x71 (113) | Easting:518723.16mm, Northing:3558743.39mm | 58 16 EB 1E 5E 1D 1E D4 | X . ë . ^ . . Ô | U:0 S:0 | 8 | 58 16 EB 1E 5E 1D 1E D4
236 | 3.896 | 00000003.896' | 46124.7423313006 | 1 | 0x182 |  | Default: PDO |  | Default: TPDO 1 of Node [0x02 (2)] Tractor IMU | Tctr Heading:316.19deg, Tctr Pitch:-3.23deg, Tctr Roll:15.48deg, Tctr Yaw Rate:1.45deg/s | 83 7B BD FE 0C 06 91 00 | . { ½ þ . . . . | U:0 S:0 | 8 | 83 7B BD FE 0C 06 91 00
237 | 46.103 | 00000046.103' | 46124.7423318342 | 1 | 0x3F1 |  | Default: PDO |  | Default: TPDO 3 of Node 0x71 (113) | Easting:518723.16mm, Northing:3558743.39mm | 58 16 EB 1E 5E 1D 1E D4 | X . ë . ^ . . Ô | U:0 S:0 | 8 | 58 16 EB 1E 5E 1D 1E D4
238 | 3.576 | 00000003.576' | 46124.7423318756 | 1 | 0x182 |  | Default: PDO |  | Default: TPDO 1 of Node [0x02 (2)] Tractor IMU | Tctr Heading:316.12deg, Tctr Pitch:-3.22deg, Tctr Roll:15.47deg, Tctr Yaw Rate:1.79deg/s | 7C 7B BE FE 0B 06 B3 00 | | { ¾ þ . . ³ . | U:0 S:0 | 8 | 7C 7B BE FE 0B 06 B3 00
239 | 46.430 | 00000046.430' | 46124.7423324129 | 1 | 0x3F1 |  | Default: PDO |  | Default: TPDO 3 of Node 0x71 (113) | Easting:518723.16mm, Northing:3558743.39mm | 58 16 EB 1E 5E 1D 1E D4 | X . ë . ^ . . Ô | U:0 S:0 | 8 | 58 16 EB 1E 5E 1D 1E D4
240 | 3.238 | 00000003.238' | 46124.7423324504 | 1 | 0x182 |  | Default: PDO |  | Default: TPDO 1 of Node [0x02 (2)] Tractor IMU | Tctr Heading:316.04deg, Tctr Pitch:-3.2deg, Tctr Roll:15.48deg, Tctr Yaw Rate:1.23deg/s | 74 7B C0 FE 0C 06 7B 00 | t { À þ . . { . | U:0 S:0 | 8 | 74 7B C0 FE 0C 06 7B 00
241 | 46.759 | 00000046.759' | 46124.7423329916 | 1 | 0x3F1 |  | Default: PDO |  | Default: TPDO 3 of Node 0x71 (113) | Easting:518723.16mm, Northing:3558743.39mm | 58 16 EB 1E 5E 1D 1E D4 | X . ë . ^ . . Ô | U:0 S:0 | 8 | 58 16 EB 1E 5E 1D 1E D4
242 | 3.927 | 00000003.927' | 46124.7423330371 | 1 | 0x182 |  | Default: PDO |  | Default: TPDO 1 of Node [0x02 (2)] Tractor IMU | Tctr Heading:315.97deg, Tctr Pitch:-3.18deg, Tctr Roll:15.48deg, Tctr Yaw Rate:0.89deg/s | 6D 7B C2 FE 0C 06 59 00 | m { Â þ . . Y . | U:0 S:0 | 8 | 6D 7B C2 FE 0C 06 59 00
243 | 46.077 | 00000046.077' | 46124.7423335704 | 1 | 0x3F1 |  | Default: PDO |  | Default: TPDO 3 of Node 0x71 (113) | Easting:518723.16mm, Northing:3558743.39mm | 58 16 EB 1E 5E 1D 1E D4 | X . ë . ^ . . Ô | U:0 S:0 | 8 | 58 16 EB 1E 5E 1D 1E D4
244 | 3.582 | 00000003.582' | 46124.7423336118 | 1 | 0x182 |  | Default: PDO |  | Default: TPDO 1 of Node [0x02 (2)] Tractor IMU | Tctr Heading:315.92deg, Tctr Pitch:-3.17deg, Tctr Roll:15.48deg, Tctr Yaw Rate:-0.22deg/s | 68 7B C3 FE 0C 06 EA FF | h { Ã þ . . ê ÿ | U:0 S:0 | 8 | 68 7B C3 FE 0C 06 EA FF
245 | 46.422 | 00000046.422' | 46124.7423341491 | 1 | 0x3F1 |  | Default: PDO |  | Default: TPDO 3 of Node 0x71 (113) | Easting:518723.16mm, Northing:3558743.39mm | 58 16 EB 1E 5E 1D 1E D4 | X . ë . ^ . . Ô | U:0 S:0 | 8 | 58 16 EB 1E 5E 1D 1E D4
246 | 3.256 | 00000003.256' | 46124.7423341868 | 1 | 0x182 |  | Default: PDO |  | Default: TPDO 1 of Node [0x02 (2)] Tractor IMU | Tctr Heading:315.91deg, Tctr Pitch:-3.16deg, Tctr Roll:15.48deg, Tctr Yaw Rate:-1.23deg/s | 67 7B C4 FE 0C 06 85 FF | g { Ä þ . . . ÿ | U:0 S:0 | 8 | 67 7B C4 FE 0C 06 85 FF
247 | 46.748 | 00000046.748' | 46124.7423347279 | 1 | 0x3F1 |  | Default: PDO |  | Default: TPDO 3 of Node 0x71 (113) | Easting:518723.16mm, Northing:3558743.39mm | 58 16 EB 1E 5E 1D 1E D4 | X . ë . ^ . . Ô | U:0 S:0 | 8 | 58 16 EB 1E 5E 1D 1E D4
248 | 3.928 | 00000003.928' | 46124.7423347733 | 1 | 0x182 |  | Default: PDO |  | Default: TPDO 1 of Node [0x02 (2)] Tractor IMU | Tctr Heading:315.96deg, Tctr Pitch:-3.18deg, Tctr Roll:15.49deg, Tctr Yaw Rate:-1.11deg/s | 6C 7B C2 FE 0D 06 91 FF | l { Â þ . . . ÿ | U:0 S:0 | 8 | 6C 7B C2 FE 0D 06 91 FF
249 | 46.069 | 00000046.069' | 46124.7423353065 | 1 | 0x3F1 |  | Default: PDO |  | Default: TPDO 3 of Node 0x71 (113) | Easting:518723.16mm, Northing:3558743.39mm | 58 16 EB 1E 5E 1D 1E D4 | X . ë . ^ . . Ô | U:0 S:0 | 8 | 58 16 EB 1E 5E 1D 1E D4
250 | 3.616 | 00000003.616' | 46124.7423353484 | 1 | 0x182 |  | Default: PDO |  | Default: TPDO 1 of Node [0x02 (2)] Tractor IMU | Tctr Heading:316.02deg, Tctr Pitch:-3.19deg, Tctr Roll:15.47deg, Tctr Yaw Rate:-1.34deg/s | 72 7B C1 FE 0B 06 7A FF | r { Á þ . . z ÿ | U:0 S:0 | 8 | 72 7B C1 FE 0B 06 7A FF
251 | 46.389 | 00000046.389' | 46124.7423358853 | 1 | 0x3F1 |  | Default: PDO |  | Default: TPDO 3 of Node 0x71 (113) | Easting:518723.16mm, Northing:3558743.39mm | 58 16 EB 1E 5E 1D 1E D4 | X . ë . ^ . . Ô | U:0 S:0 | 8 | 58 16 EB 1E 5E 1D 1E D4
252 | 3.278 | 00000003.278' | 46124.7423359232 | 1 | 0x182 |  | Default: PDO |  | Default: TPDO 1 of Node [0x02 (2)] Tractor IMU | Tctr Heading:316.09deg, Tctr Pitch:-3.2deg, Tctr Roll:15.47deg, Tctr Yaw Rate:-1.11deg/s | 79 7B C0 FE 0B 06 91 FF | y { À þ . . . ÿ | U:0 S:0 | 8 | 79 7B C0 FE 0B 06 91 FF
253 | 46.718 | 00000046.718' | 46124.742336464 | 1 | 0x3F1 |  | Default: PDO |  | Default: TPDO 3 of Node 0x71 (113) | Easting:518723.16mm, Northing:3558743.39mm | 58 16 EB 1E 5E 1D 1E D4 | X . ë . ^ . . Ô | U:0 S:0 | 8 | 58 16 EB 1E 5E 1D 1E D4
254 | 3.991 | 00000003.991' | 46124.7423365102 | 1 | 0x182 |  | Default: PDO |  | Default: TPDO 1 of Node [0x02 (2)] Tractor IMU | Tctr Heading:316.14deg, Tctr Pitch:-3.22deg, Tctr Roll:15.46deg, Tctr Yaw Rate:0.11deg/s | 7E 7B BE FE 0A 06 0B 00 | ~ { ¾ þ . . . . | U:0 S:0 | 8 | 7E 7B BE FE 0A 06 0B 00
255 | 46.013 | 00000046.013' | 46124.7423370427 | 1 | 0x3F1 |  | Default: PDO |  | Default: TPDO 3 of Node 0x71 (113) | Easting:518723.16mm, Northing:3558743.39mm | 58 16 EB 1E 5E 1D 1E D4 | X . ë . ^ . . Ô | U:0 S:0 | 8 | 58 16 EB 1E 5E 1D 1E D4
256 | 3.655 | 00000003.655' | 46124.742337085 | 1 | 0x182 |  | Default: PDO |  | Default: TPDO 1 of Node [0x02 (2)] Tractor IMU | Tctr Heading:316.14deg, Tctr Pitch:-3.22deg, Tctr Roll:15.48deg, Tctr Yaw Rate:1.34deg/s | 7E 7B BE FE 0C 06 86 00 | ~ { ¾ þ . . . . | U:0 S:0 | 8 | 7E 7B BE FE 0C 06 86 00
257 | 46.350 | 00000046.350' | 46124.7423376215 | 1 | 0x3F1 |  | Default: PDO |  | Default: TPDO 3 of Node 0x71 (113) | Easting:518723.16mm, Northing:3558743.39mm | 58 16 EB 1E 5E 1D 1E D4 | X . ë . ^ . . Ô | U:0 S:0 | 8 | 58 16 EB 1E 5E 1D 1E D4
258 | 3.312 | 00000003.312' | 46124.7423376598 | 1 | 0x182 |  | Default: PDO |  | Default: TPDO 1 of Node [0x02 (2)] Tractor IMU | Tctr Heading:316.08deg, Tctr Pitch:-3.21deg, Tctr Roll:15.47deg, Tctr Yaw Rate:0.55deg/s | 78 7B BF FE 0B 06 37 00 | x { ¿ þ . . 7 . | U:0 S:0 | 8 | 78 7B BF FE 0B 06 37 00
259 | 46.696 | 00000046.696' | 46124.7423382003 | 1 | 0x3F1 |  | Default: PDO |  | Default: TPDO 3 of Node 0x71 (113) | Easting:518723.16mm, Northing:3558743.39mm | 58 16 EB 1E 5E 1D 1E D4 | X . ë . ^ . . Ô | U:0 S:0 | 8 | 58 16 EB 1E 5E 1D 1E D4
260 | 3.976 | 00000003.976' | 46124.7423382463 | 1 | 0x182 |  | Default: PDO |  | Default: TPDO 1 of Node [0x02 (2)] Tractor IMU | Tctr Heading:316.04deg, Tctr Pitch:-3.2deg, Tctr Roll:15.48deg, Tctr Yaw Rate:-0.67deg/s | 74 7B C0 FE 0C 06 BD FF | t { À þ . . ½ ÿ | U:0 S:0 | 8 | 74 7B C0 FE 0C 06 BD FF
261 | 32.577 | 00000032.577' | 46124.7423386233 | 1 | 0x1F1 |  | Default: PDO |  | Default: TPDO 1 of Node 0x71 (113) | Fuse Easting Corr:598mm, Fuse Northing Corr:376mm, Fuse Alt Corr:-2495mm | 56 02 78 01 41 F6 | V . x . A ö | U:0 S:0 | 6 | 56 02 78 01 41 F6
262 | 13.425 | 00000013.425' | 46124.7423387787 | 1 | 0x3F1 |  | Default: PDO |  | Default: TPDO 3 of Node 0x71 (113) | Easting:518723.161mm, Northing:3558743.39mm | 59 16 EB 1E 5E 1D 1E D4 | Y . ë . ^ . . Ô | U:0 S:0 | 8 | 59 16 EB 1E 5E 1D 1E D4
263 | 3.672 | 00000003.672' | 46124.7423388212 | 1 | 0x182 |  | Default: PDO |  | Default: TPDO 1 of Node [0x02 (2)] Tractor IMU | Tctr Heading:316.07deg, Tctr Pitch:-3.21deg, Tctr Roll:15.51deg, Tctr Yaw Rate:-0.89deg/s | 77 7B BF FE 0F 06 A7 FF | w { ¿ þ . . § ÿ | U:0 S:0 | 8 | 77 7B BF FE 0F 06 A7 FF
264 | 46.338 | 00000046.338' | 46124.7423393575 | 1 | 0x3F1 |  | Default: PDO |  | Default: TPDO 3 of Node 0x71 (113) | Easting:518723.161mm, Northing:3558743.39mm | 59 16 EB 1E 5E 1D 1E D4 | Y . ë . ^ . . Ô | U:0 S:0 | 8 | 59 16 EB 1E 5E 1D 1E D4
265 | 4.356 | 00000004.356' | 46124.742339408 | 1 | 0x182 |  | Default: PDO |  | Default: TPDO 1 of Node [0x02 (2)] Tractor IMU | Tctr Heading:316.11deg, Tctr Pitch:-3.21deg, Tctr Roll:15.47deg, Tctr Yaw Rate:-0.89deg/s | 7B 7B BF FE 0B 06 A7 FF | { { ¿ þ . . § ÿ | U:0 S:0 | 8 | 7B 7B BF FE 0B 06 A7 FF
266 | 45.671 | 00000045.671' | 46124.7423399366 | 1 | 0x3F1 |  | Default: PDO |  | Default: TPDO 3 of Node 0x71 (113) | Easting:518723.161mm, Northing:3558743.39mm | 59 16 EB 1E 5E 1D 1E D4 | Y . ë . ^ . . Ô | U:0 S:0 | 8 | 59 16 EB 1E 5E 1D 1E D4
267 | 9.256 | 00000009.256' | 46124.7423400437 | 1 | 0x182 |  | Default: PDO |  | Default: TPDO 1 of Node [0x02 (2)] Tractor IMU | Tctr Heading:316.19deg, Tctr Pitch:-3.22deg, Tctr Roll:15.47deg, Tctr Yaw Rate:-0.67deg/s | 83 7B BE FE 0B 06 BD FF | . { ¾ þ . . ½ ÿ | U:0 S:0 | 8 | 83 7B BE FE 0B 06 BD FF
268 | 40.742 | 00000040.742' | 46124.7423405152 | 1 | 0x3F1 |  | Default: PDO |  | Default: TPDO 3 of Node 0x71 (113) | Easting:518723.161mm, Northing:3558743.39mm | 59 16 EB 1E 5E 1D 1E D4 | Y . ë . ^ . . Ô | U:0 S:0 | 8 | 59 16 EB 1E 5E 1D 1E D4
269 | 10.334 | 00000010.334' | 46124.7423406348 | 1 | 0x182 |  | Default: PDO |  | Default: TPDO 1 of Node [0x02 (2)] Tractor IMU | Tctr Heading:316.19deg, Tctr Pitch:-3.23deg, Tctr Roll:15.47deg, Tctr Yaw Rate:0.11deg/s | 83 7B BD FE 0B 06 0B 00 | . { ½ þ . . . . | U:0 S:0 | 8 | 83 7B BD FE 0B 06 0B 00
270 | 39.671 | 00000039.671' | 46124.742341094 | 1 | 0x3F1 |  | Default: PDO |  | Default: TPDO 3 of Node 0x71 (113) | Easting:518723.161mm, Northing:3558743.39mm | 59 16 EB 1E 5E 1D 1E D4 | Y . ë . ^ . . Ô | U:0 S:0 | 8 | 59 16 EB 1E 5E 1D 1E D4
271 | 9.590 | 00000009.590' | 46124.742341205 | 1 | 0x182 |  | Default: PDO |  | Default: TPDO 1 of Node [0x02 (2)] Tractor IMU | Tctr Heading:316.18deg, Tctr Pitch:-3.22deg, Tctr Roll:15.5deg, Tctr Yaw Rate:0.22deg/s | 82 7B BE FE 0E 06 16 00 | . { ¾ þ . . . . | U:0 S:0 | 8 | 82 7B BE FE 0E 06 16 00
272 | 40.405 | 00000040.405' | 46124.7423416726 | 1 | 0x3F1 |  | Default: PDO |  | Default: TPDO 3 of Node 0x71 (113) | Easting:518723.161mm, Northing:3558743.39mm | 59 16 EB 1E 5E 1D 1E D4 | Y . ë . ^ . . Ô | U:0 S:0 | 8 | 59 16 EB 1E 5E 1D 1E D4
273 | 9.279 | 00000009.279' | 46124.74234178 | 1 | 0x182 |  | Default: PDO |  | Default: TPDO 1 of Node [0x02 (2)] Tractor IMU | Tctr Heading:316.17deg, Tctr Pitch:-3.22deg, Tctr Roll:15.47deg, Tctr Yaw Rate:0.22deg/s | 81 7B BE FE 0B 06 16 00 | . { ¾ þ . . . . | U:0 S:0 | 8 | 81 7B BE FE 0B 06 16 00
274 | 40.726 | 00000040.726' | 46124.7423422514 | 1 | 0x3F1 |  | Default: PDO |  | Default: TPDO 3 of Node 0x71 (113) | Easting:518723.161mm, Northing:3558743.39mm | 59 16 EB 1E 5E 1D 1E D4 | Y . ë . ^ . . Ô | U:0 S:0 | 8 | 59 16 EB 1E 5E 1D 1E D4
275 | 10.582 | 00000010.582' | 46124.7423423739 | 1 | 0x182 |  | Default: PDO |  | Default: TPDO 1 of Node [0x02 (2)] Tractor IMU | Tctr Heading:316.16deg, Tctr Pitch:-3.22deg, Tctr Roll:15.48deg, Tctr Yaw Rate:0.11deg/s | 80 7B BE FE 0C 06 0B 00 | . { ¾ þ . . . . | U:0 S:0 | 8 | 80 7B BE FE 0C 06 0B 00
276 | 39.423 | 00000039.423' | 46124.7423428302 | 1 | 0x3F1 |  | Default: PDO |  | Default: TPDO 3 of Node 0x71 (113) | Easting:518723.161mm, Northing:3558743.39mm | 59 16 EB 1E 5E 1D 1E D4 | Y . ë . ^ . . Ô | U:0 S:0 | 8 | 59 16 EB 1E 5E 1D 1E D4
277 | 10.101 | 00000010.101' | 46124.7423429471 | 1 | 0x182 |  | Default: PDO |  | Default: TPDO 1 of Node [0x02 (2)] Tractor IMU | Tctr Heading:316.17deg, Tctr Pitch:-3.23deg, Tctr Roll:15.48deg, Tctr Yaw Rate:-0.11deg/s | 81 7B BD FE 0C 06 F5 FF | . { ½ þ . . õ ÿ | U:0 S:0 | 8 | 81 7B BD FE 0C 06 F5 FF
278 | 39.903 | 00000039.903' | 46124.7423434089 | 1 | 0x3F1 |  | Default: PDO |  | Default: TPDO 3 of Node 0x71 (113) | Easting:518723.161mm, Northing:3558743.39mm | 59 16 EB 1E 5E 1D 1E D4 | Y . ë . ^ . . Ô | U:0 S:0 | 8 | 59 16 EB 1E 5E 1D 1E D4
279 | 9.279 | 00000009.279' | 46124.7423435163 | 1 | 0x182 |  | Default: PDO |  | Default: TPDO 1 of Node [0x02 (2)] Tractor IMU | Tctr Heading:316.18deg, Tctr Pitch:-3.22deg, Tctr Roll:15.49deg, Tctr Yaw Rate:-0.22deg/s | 82 7B BE FE 0D 06 EA FF | . { ¾ þ . . ê ÿ | U:0 S:0 | 8 | 82 7B BE FE 0D 06 EA FF
280 | 40.717 | 00000040.717' | 46124.7423439876 | 1 | 0x3F1 |  | Default: PDO |  | Default: TPDO 3 of Node 0x71 (113) | Easting:518723.161mm, Northing:3558743.39mm | 59 16 EB 1E 5E 1D 1E D4 | Y . ë . ^ . . Ô | U:0 S:0 | 8 | 59 16 EB 1E 5E 1D 1E D4
281 | 10.142 | 00000010.142' | 46124.742344105 | 1 | 0x182 |  | Default: PDO |  | Default: TPDO 1 of Node [0x02 (2)] Tractor IMU | Tctr Heading:316.19deg, Tctr Pitch:-3.23deg, Tctr Roll:15.51deg, Tctr Yaw Rate:0deg/s | 83 7B BD FE 0F 06 00 00 | . { ½ þ . . . . | U:0 S:0 | 8 | 83 7B BD FE 0F 06 00 00
282 | 39.863 | 00000039.863' | 46124.7423445663 | 1 | 0x3F1 |  | Default: PDO |  | Default: TPDO 3 of Node 0x71 (113) | Easting:518723.161mm, Northing:3558743.39mm | 59 16 EB 1E 5E 1D 1E D4 | Y . ë . ^ . . Ô | U:0 S:0 | 8 | 59 16 EB 1E 5E 1D 1E D4
283 | 9.998 | 00000009.998' | 46124.7423446821 | 1 | 0x182 |  | Default: PDO |  | Default: TPDO 1 of Node [0x02 (2)] Tractor IMU | Tctr Heading:316.2deg, Tctr Pitch:-3.22deg, Tctr Roll:15.48deg, Tctr Yaw Rate:-0.22deg/s | 84 7B BE FE 0C 06 EA FF | . { ¾ þ . . ê ÿ | U:0 S:0 | 8 | 84 7B BE FE 0C 06 EA FF
284 | 40.006 | 00000040.006' | 46124.7423451451 | 1 | 0x3F1 |  | Default: PDO |  | Default: TPDO 3 of Node 0x71 (113) | Easting:518723.161mm, Northing:3558743.39mm | 59 16 EB 1E 5E 1D 1E D4 | Y . ë . ^ . . Ô | U:0 S:0 | 8 | 59 16 EB 1E 5E 1D 1E D4
285 | 9.286 | 00000009.286' | 46124.7423452526 | 1 | 0x182 |  | Default: PDO |  | Default: TPDO 1 of Node [0x02 (2)] Tractor IMU | Tctr Heading:316.2deg, Tctr Pitch:-3.23deg, Tctr Roll:15.49deg, Tctr Yaw Rate:-0.11deg/s | 84 7B BD FE 0D 06 F5 FF | . { ½ þ . . õ ÿ | U:0 S:0 | 8 | 84 7B BD FE 0D 06 F5 FF
286 | 40.714 | 00000040.714' | 46124.7423457238 | 1 | 0x3F1 |  | Default: PDO |  | Default: TPDO 3 of Node 0x71 (113) | Easting:518723.161mm, Northing:3558743.39mm | 59 16 EB 1E 5E 1D 1E D4 | Y . ë . ^ . . Ô | U:0 S:0 | 8 | 59 16 EB 1E 5E 1D 1E D4
287 | 10.632 | 00000010.632' | 46124.7423458468 | 1 | 0x182 |  | Default: PDO |  | Default: TPDO 1 of Node [0x02 (2)] Tractor IMU | Tctr Heading:316.2deg, Tctr Pitch:-3.23deg, Tctr Roll:15.49deg, Tctr Yaw Rate:0deg/s | 84 7B BD FE 0D 06 00 00 | . { ½ þ . . . . | U:0 S:0 | 8 | 84 7B BD FE 0D 06 00 00
288 | 39.370 | 00000039.370' | 46124.7423463025 | 1 | 0x3F1 |  | Default: PDO |  | Default: TPDO 3 of Node 0x71 (113) | Easting:518723.161mm, Northing:3558743.39mm | 59 16 EB 1E 5E 1D 1E D4 | Y . ë . ^ . . Ô | U:0 S:0 | 8 | 59 16 EB 1E 5E 1D 1E D4
289 | 10.185 | 00000010.185' | 46124.7423464204 | 1 | 0x182 |  | Default: PDO |  | Default: TPDO 1 of Node [0x02 (2)] Tractor IMU | Tctr Heading:316.19deg, Tctr Pitch:-3.22deg, Tctr Roll:15.5deg, Tctr Yaw Rate:0.44deg/s | 83 7B BE FE 0E 06 2C 00 | . { ¾ þ . . , . | U:0 S:0 | 8 | 83 7B BE FE 0E 06 2C 00
290 | 39.816 | 00000039.816' | 46124.7423468812 | 1 | 0x3F1 |  | Default: PDO |  | Default: TPDO 3 of Node 0x71 (113) | Easting:518723.161mm, Northing:3558743.39mm | 59 16 EB 1E 5E 1D 1E D4 | Y . ë . ^ . . Ô | U:0 S:0 | 8 | 59 16 EB 1E 5E 1D 1E D4
291 | 10.673 | 00000010.673' | 46124.7423470048 | 1 | 0x182 |  | Default: PDO |  | Default: TPDO 1 of Node [0x02 (2)] Tractor IMU | Tctr Heading:316.16deg, Tctr Pitch:-3.22deg, Tctr Roll:15.5deg, Tctr Yaw Rate:0.44deg/s | 80 7B BE FE 0E 06 2C 00 | . { ¾ þ . . , . | U:0 S:0 | 8 | 80 7B BE FE 0E 06 2C 00
292 | 39.327 | 00000039.327' | 46124.7423474599 | 1 | 0x3F1 |  | Default: PDO |  | Default: TPDO 3 of Node 0x71 (113) | Easting:518723.161mm, Northing:3558743.39mm | 59 16 EB 1E 5E 1D 1E D4 | Y . ë . ^ . . Ô | U:0 S:0 | 8 | 59 16 EB 1E 5E 1D 1E D4
293 | 50.069 | 00000050.069' | 46124.7423480394 | 1 | 0x182 |  | Default: PDO |  | Default: TPDO 1 of Node [0x02 (2)] Tractor IMU | Tctr Heading:316.15deg, Tctr Pitch:-3.21deg, Tctr Roll:15.48deg, Tctr Yaw Rate:0.11deg/s | 7F 7B BF FE 0C 06 0B 00 | . { ¿ þ . . . . | U:0 S:0 | 8 | 7F 7B BF FE 0C 06 0B 00
294 | 1.359 | 00000001.359' | 46124.7423480552 | 1 | 0x3F1 |  | Default: PDO |  | Default: TPDO 3 of Node 0x71 (113) | Easting:518723.161mm, Northing:3558743.39mm | 59 16 EB 1E 5E 1D 1E D4 | Y . ë . ^ . . Ô | U:0 S:0 | 8 | 59 16 EB 1E 5E 1D 1E D4
295 | 48.621 | 00000048.621' | 46124.7423486179 | 1 | 0x182 |  | Default: PDO |  | Default: TPDO 1 of Node [0x02 (2)] Tractor IMU | Tctr Heading:316.15deg, Tctr Pitch:-3.21deg, Tctr Roll:15.49deg, Tctr Yaw Rate:-0.44deg/s | 7F 7B BF FE 0D 06 D4 FF | . { ¿ þ . . Ô ÿ | U:0 S:0 | 8 | 7F 7B BF FE 0D 06 D4 FF
296 | 1.359 | 00000001.359' | 46124.7423486336 | 1 | 0x3F1 |  | Default: PDO |  | Default: TPDO 3 of Node 0x71 (113) | Easting:518723.161mm, Northing:3558743.39mm | 59 16 EB 1E 5E 1D 1E D4 | Y . ë . ^ . . Ô | U:0 S:0 | 8 | 59 16 EB 1E 5E 1D 1E D4
297 | 48.646 | 00000048.646' | 46124.7423491967 | 1 | 0x182 |  | Default: PDO |  | Default: TPDO 1 of Node [0x02 (2)] Tractor IMU | Tctr Heading:316.16deg, Tctr Pitch:-3.22deg, Tctr Roll:15.48deg, Tctr Yaw Rate:-0.55deg/s | 80 7B BE FE 0C 06 C9 FF | . { ¾ þ . . É ÿ | U:0 S:0 | 8 | 80 7B BE FE 0C 06 C9 FF
298 | 1.358 | 00000001.358' | 46124.7423492124 | 1 | 0x3F1 |  | Default: PDO |  | Default: TPDO 3 of Node 0x71 (113) | Easting:518723.161mm, Northing:3558743.39mm | 59 16 EB 1E 5E 1D 1E D4 | Y . ë . ^ . . Ô | U:0 S:0 | 8 | 59 16 EB 1E 5E 1D 1E D4
299 | 48.640 | 00000048.640' | 46124.7423497753 | 1 | 0x182 |  | Default: PDO |  | Default: TPDO 1 of Node [0x02 (2)] Tractor IMU | Tctr Heading:316.19deg, Tctr Pitch:-3.23deg, Tctr Roll:15.49deg, Tctr Yaw Rate:-0.78deg/s | 83 7B BD FE 0D 06 B2 FF | . { ½ þ . . ² ÿ | U:0 S:0 | 8 | 83 7B BD FE 0D 06 B2 FF
300 | 1.360 | 00000001.360' | 46124.7423497911 | 1 | 0x3F1 |  | Default: PDO |  | Default: TPDO 3 of Node 0x71 (113) | Easting:518723.161mm, Northing:3558743.39mm | 59 16 EB 1E 5E 1D 1E D4 | Y . ë . ^ . . Ô | U:0 S:0 | 8 | 59 16 EB 1E 5E 1D 1E D4
301 | 42.440 | 00000042.440' | 46124.7423502823 | 1 | 0x1F1 |  | Default: PDO |  | Default: TPDO 1 of Node 0x71 (113) | Fuse Easting Corr:600mm, Fuse Northing Corr:373mm, Fuse Alt Corr:-2494mm | 58 02 75 01 42 F6 | X . u . B ö | U:0 S:0 | 6 | 58 02 75 01 42 F6
302 | 6.217 | 00000006.217' | 46124.7423503542 | 1 | 0x182 |  | Default: PDO |  | Default: TPDO 1 of Node [0x02 (2)] Tractor IMU | Tctr Heading:316.22deg, Tctr Pitch:-3.24deg, Tctr Roll:15.51deg, Tctr Yaw Rate:-0.55deg/s | 86 7B BC FE 0F 06 C9 FF | . { ¼ þ . . É ÿ | U:0 S:0 | 8 | 86 7B BC FE 0F 06 C9 FF
303 | 1.391 | 00000001.391' | 46124.7423503703 | 1 | 0x3F1 |  | Default: PDO |  | Default: TPDO 3 of Node 0x71 (113) | Easting:518723.164mm, Northing:3558743.388mm | 5C 16 EB 1E 5C 1D 1E D4 | \ . ë . \ . . Ô | U:0 S:0 | 8 | 5C 16 EB 1E 5C 1D 1E D4
304 | 48.590 | 00000048.590' | 46124.7423509327 | 1 | 0x182 |  | Default: PDO |  | Default: TPDO 1 of Node [0x02 (2)] Tractor IMU | Tctr Heading:316.25deg, Tctr Pitch:-3.24deg, Tctr Roll:15.47deg, Tctr Yaw Rate:0.33deg/s | 89 7B BC FE 0B 06 21 00 | . { ¼ þ . . ! . | U:0 S:0 | 8 | 89 7B BC FE 0B 06 21 00
305 | 1.412 | 00000001.412' | 46124.7423509491 | 1 | 0x3F1 |  | Default: PDO |  | Default: TPDO 3 of Node 0x71 (113) | Easting:518723.164mm, Northing:3558743.388mm | 5C 16 EB 1E 5C 1D 1E D4 | \ . ë . \ . . Ô | U:0 S:0 | 8 | 5C 16 EB 1E 5C 1D 1E D4
306 | 48.613 | 00000048.613' | 46124.7423515117 | 1 | 0x182 |  | Default: PDO |  | Default: TPDO 1 of Node [0x02 (2)] Tractor IMU | Tctr Heading:316.24deg, Tctr Pitch:-3.24deg, Tctr Roll:15.47deg, Tctr Yaw Rate:0.67deg/s | 88 7B BC FE 0B 06 43 00 | . { ¼ þ . . C . | U:0 S:0 | 8 | 88 7B BC FE 0B 06 43 00
307 | 1.391 | 00000001.391' | 46124.7423515278 | 1 | 0x3F1 |  | Default: PDO |  | Default: TPDO 3 of Node 0x71 (113) | Easting:518723.164mm, Northing:3558743.388mm | 5C 16 EB 1E 5C 1D 1E D4 | \ . ë . \ . . Ô | U:0 S:0 | 8 | 5C 16 EB 1E 5C 1D 1E D4
308 | 48.613 | 00000048.613' | 46124.7423520905 | 1 | 0x182 |  | Default: PDO |  | Default: TPDO 1 of Node [0x02 (2)] Tractor IMU | Tctr Heading:316.2deg, Tctr Pitch:-3.24deg, Tctr Roll:15.49deg, Tctr Yaw Rate:0.55deg/s | 84 7B BC FE 0D 06 37 00 | . { ¼ þ . . 7 . | U:0 S:0 | 8 | 84 7B BC FE 0D 06 37 00
309 | 1.391 | 00000001.391' | 46124.7423521066 | 1 | 0x3F1 |  | Default: PDO |  | Default: TPDO 3 of Node 0x71 (113) | Easting:518723.164mm, Northing:3558743.388mm | 5C 16 EB 1E 5C 1D 1E D4 | \ . ë . \ . . Ô | U:0 S:0 | 8 | 5C 16 EB 1E 5C 1D 1E D4
310 | 48.622 | 00000048.622' | 46124.7423526693 | 1 | 0x182 |  | Default: PDO |  | Default: TPDO 1 of Node [0x02 (2)] Tractor IMU | Tctr Heading:316.17deg, Tctr Pitch:-3.23deg, Tctr Roll:15.5deg, Tctr Yaw Rate:0deg/s | 81 7B BD FE 0E 06 00 00 | . { ½ þ . . . . | U:0 S:0 | 8 | 81 7B BD FE 0E 06 00 00
311 | 1.391 | 00000001.391' | 46124.7423526854 | 1 | 0x3F1 |  | Default: PDO |  | Default: TPDO 3 of Node 0x71 (113) | Easting:518723.164mm, Northing:3558743.388mm | 5C 16 EB 1E 5C 1D 1E D4 | \ . ë . \ . . Ô | U:0 S:0 | 8 | 5C 16 EB 1E 5C 1D 1E D4
312 | 48.605 | 00000048.605' | 46124.742353248 | 1 | 0x182 |  | Default: PDO |  | Default: TPDO 1 of Node [0x02 (2)] Tractor IMU | Tctr Heading:316.16deg, Tctr Pitch:-3.23deg, Tctr Roll:15.49deg, Tctr Yaw Rate:-0.44deg/s | 80 7B BD FE 0D 06 D4 FF | . { ½ þ . . Ô ÿ | U:0 S:0 | 8 | 80 7B BD FE 0D 06 D4 FF
313 | 1.390 | 00000001.390' | 46124.7423532641 | 1 | 0x3F1 |  | Default: PDO |  | Default: TPDO 3 of Node 0x71 (113) | Easting:518723.164mm, Northing:3558743.388mm | 5C 16 EB 1E 5C 1D 1E D4 | \ . ë . \ . . Ô | U:0 S:0 | 8 | 5C 16 EB 1E 5C 1D 1E D4
314 | 48.614 | 00000048.614' | 46124.7423538267 | 1 | 0x182 |  | Default: PDO |  | Default: TPDO 1 of Node [0x02 (2)] Tractor IMU | Tctr Heading:316.18deg, Tctr Pitch:-3.23deg, Tctr Roll:15.48deg, Tctr Yaw Rate:-0.89deg/s | 82 7B BD FE 0C 06 A7 FF | . { ½ þ . . § ÿ | U:0 S:0 | 8 | 82 7B BD FE 0C 06 A7 FF
315 | 1.391 | 00000001.391' | 46124.7423538428 | 1 | 0x3F1 |  | Default: PDO |  | Default: TPDO 3 of Node 0x71 (113) | Easting:518723.164mm, Northing:3558743.388mm | 5C 16 EB 1E 5C 1D 1E D4 | \ . ë . \ . . Ô | U:0 S:0 | 8 | 5C 16 EB 1E 5C 1D 1E D4
316 | 48.608 | 00000048.608' | 46124.7423544054 | 1 | 0x182 |  | Default: PDO |  | Default: TPDO 1 of Node [0x02 (2)] Tractor IMU | Tctr Heading:316.22deg, Tctr Pitch:-3.24deg, Tctr Roll:15.49deg, Tctr Yaw Rate:-0.67deg/s | 86 7B BC FE 0D 06 BD FF | . { ¼ þ . . ½ ÿ | U:0 S:0 | 8 | 86 7B BC FE 0D 06 BD FF
317 | 1.391 | 00000001.391' | 46124.7423544215 | 1 | 0x3F1 |  | Default: PDO |  | Default: TPDO 3 of Node 0x71 (113) | Easting:518723.164mm, Northing:3558743.388mm | 5C 16 EB 1E 5C 1D 1E D4 | \ . ë . \ . . Ô | U:0 S:0 | 8 | 5C 16 EB 1E 5C 1D 1E D4
318 | 48.601 | 00000048.601' | 46124.742354984 | 1 | 0x182 |  | Default: PDO |  | Default: TPDO 1 of Node [0x02 (2)] Tractor IMU | Tctr Heading:316.25deg, Tctr Pitch:-3.25deg, Tctr Roll:15.5deg, Tctr Yaw Rate:-0.55deg/s | 89 7B BB FE 0E 06 C9 FF | . { » þ . . É ÿ | U:0 S:0 | 8 | 89 7B BB FE 0E 06 C9 FF
319 | 1.392 | 00000001.392' | 46124.7423550002 | 1 | 0x3F1 |  | Default: PDO |  | Default: TPDO 3 of Node 0x71 (113) | Easting:518723.164mm, Northing:3558743.388mm | 5C 16 EB 1E 5C 1D 1E D4 | \ . ë . \ . . Ô | U:0 S:0 | 8 | 5C 16 EB 1E 5C 1D 1E D4
320 | 48.622 | 00000048.622' | 46124.7423555629 | 1 | 0x182 |  | Default: PDO |  | Default: TPDO 1 of Node [0x02 (2)] Tractor IMU | Tctr Heading:316.27deg, Tctr Pitch:-3.25deg, Tctr Roll:15.52deg, Tctr Yaw Rate:0deg/s | 8B 7B BB FE 10 06 00 00 | . { » þ . . . . | U:0 S:0 | 8 | 8B 7B BB FE 10 06 00 00
321 | 1.391 | 00000001.391' | 46124.742355579 | 1 | 0x3F1 |  | Default: PDO |  | Default: TPDO 3 of Node 0x71 (113) | Easting:518723.164mm, Northing:3558743.388mm | 5C 16 EB 1E 5C 1D 1E D4 | \ . ë . \ . . Ô | U:0 S:0 | 8 | 5C 16 EB 1E 5C 1D 1E D4
322 | 48.597 | 00000048.597' | 46124.7423561415 | 1 | 0x182 |  | Default: PDO |  | Default: TPDO 1 of Node [0x02 (2)] Tractor IMU | Tctr Heading:316.27deg, Tctr Pitch:-3.25deg, Tctr Roll:15.48deg, Tctr Yaw Rate:0.55deg/s | 8B 7B BB FE 0C 06 37 00 | . { » þ . . 7 . | U:0 S:0 | 8 | 8B 7B BB FE 0C 06 37 00
323 | 1.391 | 00000001.391' | 46124.7423561576 | 1 | 0x3F1 |  | Default: PDO |  | Default: TPDO 3 of Node 0x71 (113) | Easting:518723.164mm, Northing:3558743.388mm | 5C 16 EB 1E 5C 1D 1E D4 | \ . ë . \ . . Ô | U:0 S:0 | 8 | 5C 16 EB 1E 5C 1D 1E D4
324 | 48.614 | 00000048.614' | 46124.7423567202 | 1 | 0x182 |  | Default: PDO |  | Default: TPDO 1 of Node [0x02 (2)] Tractor IMU | Tctr Heading:316.25deg, Tctr Pitch:-3.24deg, Tctr Roll:15.49deg, Tctr Yaw Rate:0.55deg/s | 89 7B BC FE 0D 06 37 00 | . { ¼ þ . . 7 . | U:0 S:0 | 8 | 89 7B BC FE 0D 06 37 00
325 | 1.390 | 00000001.390' | 46124.7423567363 | 1 | 0x3F1 |  | Default: PDO |  | Default: TPDO 3 of Node 0x71 (113) | Easting:518723.164mm, Northing:3558743.388mm | 5C 16 EB 1E 5C 1D 1E D4 | \ . ë . \ . . Ô | U:0 S:0 | 8 | 5C 16 EB 1E 5C 1D 1E D4
326 | 48.614 | 00000048.614' | 46124.742357299 | 1 | 0x182 |  | Default: PDO |  | Default: TPDO 1 of Node [0x02 (2)] Tractor IMU | Tctr Heading:316.23deg, Tctr Pitch:-3.24deg, Tctr Roll:15.5deg, Tctr Yaw Rate:0.22deg/s | 87 7B BC FE 0E 06 16 00 | . { ¼ þ . . . . | U:0 S:0 | 8 | 87 7B BC FE 0E 06 16 00
327 | 1.391 | 00000001.391' | 46124.7423573151 | 1 | 0x3F1 |  | Default: PDO |  | Default: TPDO 3 of Node 0x71 (113) | Easting:518723.164mm, Northing:3558743.388mm | 5C 16 EB 1E 5C 1D 1E D4 | \ . ë . \ . . Ô | U:0 S:0 | 8 | 5C 16 EB 1E 5C 1D 1E D4
328 | 48.617 | 00000048.617' | 46124.7423578778 | 1 | 0x182 |  | Default: PDO |  | Default: TPDO 1 of Node [0x02 (2)] Tractor IMU | Tctr Heading:316.22deg, Tctr Pitch:-3.24deg, Tctr Roll:15.51deg, Tctr Yaw Rate:0.33deg/s | 86 7B BC FE 0F 06 21 00 | . { ¼ þ . . ! . | U:0 S:0 | 8 | 86 7B BC FE 0F 06 21 00
329 | 1.392 | 00000001.392' | 46124.7423578939 | 1 | 0x3F1 |  | Default: PDO |  | Default: TPDO 3 of Node 0x71 (113) | Easting:518723.164mm, Northing:3558743.388mm | 5C 16 EB 1E 5C 1D 1E D4 | \ . ë . \ . . Ô | U:0 S:0 | 8 | 5C 16 EB 1E 5C 1D 1E D4
330 | 48.594 | 00000048.594' | 46124.7423584563 | 1 | 0x182 |  | Default: PDO |  | Default: TPDO 1 of Node [0x02 (2)] Tractor IMU | Tctr Heading:316.21deg, Tctr Pitch:-3.23deg, Tctr Roll:15.52deg, Tctr Yaw Rate:0.22deg/s | 85 7B BD FE 10 06 16 00 | . { ½ þ . . . . | U:0 S:0 | 8 | 85 7B BD FE 10 06 16 00
331 | 1.392 | 00000001.392' | 46124.7423584724 | 1 | 0x3F1 |  | Default: PDO |  | Default: TPDO 3 of Node 0x71 (113) | Easting:518723.164mm, Northing:3558743.388mm | 5C 16 EB 1E 5C 1D 1E D4 | \ . ë . \ . . Ô | U:0 S:0 | 8 | 5C 16 EB 1E 5C 1D 1E D4
332 | 48.634 | 00000048.634' | 46124.7423590353 | 1 | 0x182 |  | Default: PDO |  | Default: TPDO 1 of Node [0x02 (2)] Tractor IMU | Tctr Heading:316.2deg, Tctr Pitch:-3.23deg, Tctr Roll:15.48deg, Tctr Yaw Rate:0.55deg/s | 84 7B BD FE 0C 06 37 00 | . { ½ þ . . 7 . | U:0 S:0 | 8 | 84 7B BD FE 0C 06 37 00
333 | 1.392 | 00000001.392' | 46124.7423590514 | 1 | 0x3F1 |  | Default: PDO |  | Default: TPDO 3 of Node 0x71 (113) | Easting:518723.164mm, Northing:3558743.388mm | 5C 16 EB 1E 5C 1D 1E D4 | \ . ë . \ . . Ô | U:0 S:0 | 8 | 5C 16 EB 1E 5C 1D 1E D4
334 | 48.607 | 00000048.607' | 46124.742359614 | 1 | 0x182 |  | Default: PDO |  | Default: TPDO 1 of Node [0x02 (2)] Tractor IMU | Tctr Heading:316.18deg, Tctr Pitch:-3.22deg, Tctr Roll:15.48deg, Tctr Yaw Rate:0.67deg/s | 82 7B BE FE 0C 06 43 00 | . { ¾ þ . . C . | U:0 S:0 | 8 | 82 7B BE FE 0C 06 43 00
335 | 1.391 | 00000001.391' | 46124.7423596301 | 1 | 0x3F1 |  | Default: PDO |  | Default: TPDO 3 of Node 0x71 (113) | Easting:518723.164mm, Northing:3558743.388mm | 5C 16 EB 1E 5C 1D 1E D4 | \ . ë . \ . . Ô | U:0 S:0 | 8 | 5C 16 EB 1E 5C 1D 1E D4
336 | 48.614 | 00000048.614' | 46124.7423601928 | 1 | 0x182 |  | Default: PDO |  | Default: TPDO 1 of Node [0x02 (2)] Tractor IMU | Tctr Heading:316.14deg, Tctr Pitch:-3.21deg, Tctr Roll:15.49deg, Tctr Yaw Rate:-0.22deg/s | 7E 7B BF FE 0D 06 EA FF | ~ { ¿ þ . . ê ÿ | U:0 S:0 | 8 | 7E 7B BF FE 0D 06 EA FF
337 | 1.390 | 00000001.390' | 46124.7423602089 | 1 | 0x3F1 |  | Default: PDO |  | Default: TPDO 3 of Node 0x71 (113) | Easting:518723.164mm, Northing:3558743.388mm | 5C 16 EB 1E 5C 1D 1E D4 | \ . ë . \ . . Ô | U:0 S:0 | 8 | 5C 16 EB 1E 5C 1D 1E D4
338 | 48.589 | 00000048.589' | 46124.7423607712 | 1 | 0x3F1 |  | Default: PDO |  | Default: TPDO 3 of Node 0x71 (113) | Easting:518723.164mm, Northing:3558743.388mm | 5C 16 EB 1E 5C 1D 1E D4 | \ . ë . \ . . Ô | U:0 S:0 | 8 | 5C 16 EB 1E 5C 1D 1E D4
339 | 0.951 | 00000000.951' | 46124.7423607822 | 1 | 0x182 |  | Default: PDO |  | Default: TPDO 1 of Node [0x02 (2)] Tractor IMU | Tctr Heading:316.14deg, Tctr Pitch:-3.21deg, Tctr Roll:15.51deg, Tctr Yaw Rate:-0.55deg/s | 7E 7B BF FE 0F 06 C9 FF | ~ { ¿ þ . . É ÿ | U:0 S:0 | 8 | 7E 7B BF FE 0F 06 C9 FF
340 | 49.077 | 00000049.077' | 46124.7423613503 | 1 | 0x182 |  | Default: PDO |  | Default: TPDO 1 of Node [0x02 (2)] Tractor IMU | Tctr Heading:316.16deg, Tctr Pitch:-3.21deg, Tctr Roll:15.51deg, Tctr Yaw Rate:-0.55deg/s | 80 7B BF FE 0F 06 C9 FF | . { ¿ þ . . É ÿ | U:0 S:0 | 8 | 80 7B BF FE 0F 06 C9 FF
341 | 1.391 | 00000001.391' | 46124.7423613664 | 1 | 0x3F1 |  | Default: PDO |  | Default: TPDO 3 of Node 0x71 (113) | Easting:518723.164mm, Northing:3558743.388mm | 5C 16 EB 1E 5C 1D 1E D4 | \ . ë . \ . . Ô | U:0 S:0 | 8 | 5C 16 EB 1E 5C 1D 1E D4
342 | 37.470 | 00000037.470' | 46124.7423618 | 1 | 0x1F1 |  | Default: PDO |  | Default: TPDO 1 of Node 0x71 (113) | Fuse Easting Corr:600mm, Fuse Northing Corr:375mm, Fuse Alt Corr:-2494mm | 58 02 77 01 42 F6 | X . w . B ö | U:0 S:0 | 6 | 58 02 77 01 42 F6
343 | 11.142 | 00000011.142' | 46124.742361929 | 1 | 0x182 |  | Default: PDO |  | Default: TPDO 1 of Node [0x02 (2)] Tractor IMU | Tctr Heading:316.19deg, Tctr Pitch:-3.22deg, Tctr Roll:15.49deg, Tctr Yaw Rate:-0.11deg/s | 83 7B BE FE 0D 06 F5 FF | . { ¾ þ . . õ ÿ | U:0 S:0 | 8 | 83 7B BE FE 0D 06 F5 FF
344 | 1.359 | 00000001.359' | 46124.7423619447 | 1 | 0x3F1 |  | Default: PDO |  | Default: TPDO 3 of Node 0x71 (113) | Easting:518723.166mm, Northing:3558743.389mm | 5E 16 EB 1E 5D 1D 1E D4 | ^ . ë . ] . . Ô | U:0 S:0 | 8 | 5E 16 EB 1E 5D 1D 1E D4
345 | 48.589 | 00000048.589' | 46124.7423625071 | 1 | 0x3F1 |  | Default: PDO |  | Default: TPDO 3 of Node 0x71 (113) | Easting:518723.166mm, Northing:3558743.389mm | 5E 16 EB 1E 5D 1D 1E D4 | ^ . ë . ] . . Ô | U:0 S:0 | 8 | 5E 16 EB 1E 5D 1D 1E D4
346 | 0.934 | 00000000.934' | 46124.7423625179 | 1 | 0x182 |  | Default: PDO |  | Default: TPDO 1 of Node [0x02 (2)] Tractor IMU | Tctr Heading:316.21deg, Tctr Pitch:-3.22deg, Tctr Roll:15.51deg, Tctr Yaw Rate:0deg/s | 85 7B BE FE 0F 06 00 00 | . { ¾ þ . . . . | U:0 S:0 | 8 | 85 7B BE FE 0F 06 00 00
347 | 49.092 | 00000049.092' | 46124.7423630861 | 1 | 0x182 |  | Default: PDO |  | Default: TPDO 1 of Node [0x02 (2)] Tractor IMU | Tctr Heading:316.22deg, Tctr Pitch:-3.22deg, Tctr Roll:15.51deg, Tctr Yaw Rate:-0.11deg/s | 86 7B BE FE 0F 06 F5 FF | . { ¾ þ . . õ ÿ | U:0 S:0 | 8 | 86 7B BE FE 0F 06 F5 FF
348 | 1.359 | 00000001.359' | 46124.7423631018 | 1 | 0x3F1 |  | Default: PDO |  | Default: TPDO 3 of Node 0x71 (113) | Easting:518723.166mm, Northing:3558743.389mm | 5E 16 EB 1E 5D 1D 1E D4 | ^ . ë . ] . . Ô | U:0 S:0 | 8 | 5E 16 EB 1E 5D 1D 1E D4
349 | 48.630 | 00000048.630' | 46124.7423636647 | 1 | 0x182 |  | Default: PDO |  | Default: TPDO 1 of Node [0x02 (2)] Tractor IMU | Tctr Heading:316.22deg, Tctr Pitch:-3.23deg, Tctr Roll:15.53deg, Tctr Yaw Rate:0.22deg/s | 86 7B BD FE 11 06 16 00 | . { ½ þ . . . . | U:0 S:0 | 8 | 86 7B BD FE 11 06 16 00
350 | 1.358 | 00000001.358' | 46124.7423636804 | 1 | 0x3F1 |  | Default: PDO |  | Default: TPDO 3 of Node 0x71 (113) | Easting:518723.166mm, Northing:3558743.389mm | 5E 16 EB 1E 5D 1D 1E D4 | ^ . ë . ] . . Ô | U:0 S:0 | 8 | 5E 16 EB 1E 5D 1D 1E D4
351 | 48.606 | 00000048.606' | 46124.742364243 | 1 | 0x3F1 |  | Default: PDO |  | Default: TPDO 3 of Node 0x71 (113) | Easting:518723.166mm, Northing:3558743.389mm | 5E 16 EB 1E 5D 1D 1E D4 | ^ . ë . ] . . Ô | U:0 S:0 | 8 | 5E 16 EB 1E 5D 1D 1E D4
352 | 0.943 | 00000000.943' | 46124.7423642539 | 1 | 0x182 |  | Default: PDO |  | Default: TPDO 1 of Node [0x02 (2)] Tractor IMU | Tctr Heading:316.21deg, Tctr Pitch:-3.22deg, Tctr Roll:15.49deg, Tctr Yaw Rate:4.36deg/s | 85 7B BE FE 0D 06 B4 01 | . { ¾ þ . . ´ . | U:0 S:0 | 8 | 85 7B BE FE 0D 06 B4 01
353 | 49.103 | 00000049.103' | 46124.7423648222 | 1 | 0x182 |  | Default: PDO |  | Default: TPDO 1 of Node [0x02 (2)] Tractor IMU | Tctr Heading:316.06deg, Tctr Pitch:-3.18deg, Tctr Roll:15.49deg, Tctr Yaw Rate:0.22deg/s | 76 7B C2 FE 0D 06 16 00 | v { Â þ . . . . | U:0 S:0 | 8 | 76 7B C2 FE 0D 06 16 00
354 | 1.359 | 00000001.359' | 46124.7423648379 | 1 | 0x3F1 |  | Default: PDO |  | Default: TPDO 3 of Node 0x71 (113) | Easting:518723.166mm, Northing:3558743.389mm | 5E 16 EB 1E 5D 1D 1E D4 | ^ . ë . ] . . Ô | U:0 S:0 | 8 | 5E 16 EB 1E 5D 1D 1E D4
355 | 48.656 | 00000048.656' | 46124.7423654011 | 1 | 0x182 |  | Default: PDO |  | Default: TPDO 1 of Node [0x02 (2)] Tractor IMU | Tctr Heading:316deg, Tctr Pitch:-3.17deg, Tctr Roll:15.47deg, Tctr Yaw Rate:12.98deg/s | 70 7B C3 FE 0B 06 12 05 | p { Ã þ . . . . | U:0 S:0 | 8 | 70 7B C3 FE 0B 06 12 05
356 | 1.360 | 00000001.360' | 46124.7423654168 | 1 | 0x3F1 |  | Default: PDO |  | Default: TPDO 3 of Node 0x71 (113) | Easting:518723.166mm, Northing:3558743.389mm | 5E 16 EB 1E 5D 1D 1E D4 | ^ . ë . ] . . Ô | U:0 S:0 | 8 | 5E 16 EB 1E 5D 1D 1E D4
357 | 48.593 | 00000048.593' | 46124.7423659792 | 1 | 0x3F1 |  | Default: PDO |  | Default: TPDO 3 of Node 0x71 (113) | Easting:518723.166mm, Northing:3558743.389mm | 5E 16 EB 1E 5D 1D 1E D4 | ^ . ë . ] . . Ô | U:0 S:0 | 8 | 5E 16 EB 1E 5D 1D 1E D4
358 | 0.936 | 00000000.936' | 46124.7423659901 | 1 | 0x182 |  | Default: PDO |  | Default: TPDO 1 of Node [0x02 (2)] Tractor IMU | Tctr Heading:315.63deg, Tctr Pitch:-3.08deg, Tctr Roll:15.53deg, Tctr Yaw Rate:-9.28deg/s | 4B 7B CC FE 11 06 60 FC | K { Ì þ . . ` ü | U:0 S:0 | 8 | 4B 7B CC FE 11 06 60 FC
359 | 49.082 | 00000049.082' | 46124.7423665582 | 1 | 0x182 |  | Default: PDO |  | Default: TPDO 1 of Node [0x02 (2)] Tractor IMU | Tctr Heading:315.7deg, Tctr Pitch:-3.06deg, Tctr Roll:14.88deg, Tctr Yaw Rate:-9.51deg/s | 52 7B CE FE D0 05 49 FC | R { Î þ Ð . I ü | U:0 S:0 | 8 | 52 7B CE FE D0 05 49 FC
360 | 1.360 | 00000001.360' | 46124.7423665739 | 1 | 0x3F1 |  | Default: PDO |  | Default: TPDO 3 of Node 0x71 (113) | Easting:518723.166mm, Northing:3558743.389mm | 5E 16 EB 1E 5D 1D 1E D4 | ^ . ë . ] . . Ô | U:0 S:0 | 8 | 5E 16 EB 1E 5D 1D 1E D4
361 | 48.656 | 00000048.656' | 46124.7423671371 | 1 | 0x182 |  | Default: PDO |  | Default: TPDO 1 of Node [0x02 (2)] Tractor IMU | Tctr Heading:316.51deg, Tctr Pitch:-3.29deg, Tctr Roll:15.09deg, Tctr Yaw Rate:-3.46deg/s | A3 7B B7 FE E5 05 A6 FE | £ { · þ å . ¦ þ | U:0 S:0 | 8 | A3 7B B7 FE E5 05 A6 FE
362 | 1.358 | 00000001.358' | 46124.7423671528 | 1 | 0x3F1 |  | Default: PDO |  | Default: TPDO 3 of Node 0x71 (113) | Easting:518723.166mm, Northing:3558743.389mm | 5E 16 EB 1E 5D 1D 1E D4 | ^ . ë . ] . . Ô | U:0 S:0 | 8 | 5E 16 EB 1E 5D 1D 1E D4
363 | 48.606 | 00000048.606' | 46124.7423677153 | 1 | 0x3F1 |  | Default: PDO |  | Default: TPDO 3 of Node 0x71 (113) | Easting:518723.166mm, Northing:3558743.389mm | 5E 16 EB 1E 5D 1D 1E D4 | ^ . ë . ] . . Ô | U:0 S:0 | 8 | 5E 16 EB 1E 5D 1D 1E D4
364 | 0.935 | 00000000.935' | 46124.7423677262 | 1 | 0x182 |  | Default: PDO |  | Default: TPDO 1 of Node [0x02 (2)] Tractor IMU | Tctr Heading:316.66deg, Tctr Pitch:-3.37deg, Tctr Roll:15.05deg, Tctr Yaw Rate:2.57deg/s | B2 7B AF FE E1 05 01 01 | ² { ¯ þ á . . . | U:0 S:0 | 8 | B2 7B AF FE E1 05 01 01
365 | 49.094 | 00000049.094' | 46124.7423682944 | 1 | 0x182 |  | Default: PDO |  | Default: TPDO 1 of Node [0x02 (2)] Tractor IMU | Tctr Heading:316.65deg, Tctr Pitch:-3.43deg, Tctr Roll:14.76deg, Tctr Yaw Rate:13.87deg/s | B1 7B A9 FE C4 05 6B 05 | ± { © þ Ä . k . | U:0 S:0 | 8 | B1 7B A9 FE C4 05 6B 05
366 | 1.358 | 00000001.358' | 46124.7423683101 | 1 | 0x3F1 |  | Default: PDO |  | Default: TPDO 3 of Node 0x71 (113) | Easting:518723.166mm, Northing:3558743.389mm | 5E 16 EB 1E 5D 1D 1E D4 | ^ . ë . ] . . Ô | U:0 S:0 | 8 | 5E 16 EB 1E 5D 1D 1E D4
367 | 48.646 | 00000048.646' | 46124.7423688731 | 1 | 0x182 |  | Default: PDO |  | Default: TPDO 1 of Node [0x02 (2)] Tractor IMU | Tctr Heading:316.2deg, Tctr Pitch:-3.41deg, Tctr Roll:14.57deg, Tctr Yaw Rate:19.13deg/s | 84 7B AB FE B1 05 79 07 | . { « þ ± . y . | U:0 S:0 | 8 | 84 7B AB FE B1 05 79 07
368 | 1.359 | 00000001.359' | 46124.7423688889 | 1 | 0x3F1 |  | Default: PDO |  | Default: TPDO 3 of Node 0x71 (113) | Easting:518723.166mm, Northing:3558743.389mm | 5E 16 EB 1E 5D 1D 1E D4 | ^ . ë . ] . . Ô | U:0 S:0 | 8 | 5E 16 EB 1E 5D 1D 1E D4
369 | 48.613 | 00000048.613' | 46124.7423694515 | 1 | 0x3F1 |  | Default: PDO |  | Default: TPDO 3 of Node 0x71 (113) | Easting:518723.166mm, Northing:3558743.389mm | 5E 16 EB 1E 5D 1D 1E D4 | ^ . ë . ] . . Ô | U:0 S:0 | 8 | 5E 16 EB 1E 5D 1D 1E D4
370 | 0.943 | 00000000.943' | 46124.7423694624 | 1 | 0x182 |  | Default: PDO |  | Default: TPDO 1 of Node [0x02 (2)] Tractor IMU | Tctr Heading:315.53deg, Tctr Pitch:-3.38deg, Tctr Roll:14.44deg, Tctr Yaw Rate:32deg/s | 41 7B AE FE A4 05 80 0C | A { ® þ ¤ . . . | U:0 S:0 | 8 | 41 7B AE FE A4 05 80 0C
371 | 49.099 | 00000049.099' | 46124.7423700307 | 1 | 0x182 |  | Default: PDO |  | Default: TPDO 1 of Node [0x02 (2)] Tractor IMU | Tctr Heading:314.13deg, Tctr Pitch:-3.29deg, Tctr Roll:14.05deg, Tctr Yaw Rate:30.77deg/s | B5 7A B7 FE 7D 05 05 0C | µ z · þ } . . . | U:0 S:0 | 8 | B5 7A B7 FE 7D 05 05 0C
372 | 1.359 | 00000001.359' | 46124.7423700464 | 1 | 0x3F1 |  | Default: PDO |  | Default: TPDO 3 of Node 0x71 (113) | Easting:518723.166mm, Northing:3558743.389mm | 5E 16 EB 1E 5D 1D 1E D4 | ^ . ë . ] . . Ô | U:0 S:0 | 8 | 5E 16 EB 1E 5D 1D 1E D4
373 | 48.653 | 00000048.653' | 46124.7423706095 | 1 | 0x182 |  | Default: PDO |  | Default: TPDO 1 of Node [0x02 (2)] Tractor IMU | Tctr Heading:312.6deg, Tctr Pitch:-3.12deg, Tctr Roll:13.5deg, Tctr Yaw Rate:20.25deg/s | 1C 7A C8 FE 46 05 E9 07 | . z È þ F . é . | U:0 S:0 | 8 | 1C 7A C8 FE 46 05 E9 07
374 | 1.359 | 00000001.359' | 46124.7423706253 | 1 | 0x3F1 |  | Default: PDO |  | Default: TPDO 3 of Node 0x71 (113) | Easting:518723.166mm, Northing:3558743.389mm | 5E 16 EB 1E 5D 1D 1E D4 | ^ . ë . ] . . Ô | U:0 S:0 | 8 | 5E 16 EB 1E 5D 1D 1E D4
375 | 48.596 | 00000048.596' | 46124.7423711877 | 1 | 0x3F1 |  | Default: PDO |  | Default: TPDO 3 of Node 0x71 (113) | Easting:518723.166mm, Northing:3558743.389mm | 5E 16 EB 1E 5D 1D 1E D4 | ^ . ë . ] . . Ô | U:0 S:0 | 8 | 5E 16 EB 1E 5D 1D 1E D4
376 | 3.271 | 00000003.271' | 46124.7423712256 | 1 | 0x182 |  | Default: PDO |  | Default: TPDO 1 of Node [0x02 (2)] Tractor IMU | Tctr Heading:311.42deg, Tctr Pitch:-3deg, Tctr Roll:13.35deg, Tctr Yaw Rate:10.63deg/s | A6 79 D4 FE 37 05 27 04 | ¦ y Ô þ 7 . ' . | U:0 S:0 | 8 | A6 79 D4 FE 37 05 27 04
377 | 46.726 | 00000046.726' | 46124.7423717664 | 1 | 0x3F1 |  | Default: PDO |  | Default: TPDO 3 of Node 0x71 (113) | Easting:518723.166mm, Northing:3558743.389mm | 5E 16 EB 1E 5D 1D 1E D4 | ^ . ë . ] . . Ô | U:0 S:0 | 8 | 5E 16 EB 1E 5D 1D 1E D4
378 | 3.957 | 00000003.957' | 46124.7423718122 | 1 | 0x182 |  | Default: PDO |  | Default: TPDO 1 of Node [0x02 (2)] Tractor IMU | Tctr Heading:310.74deg, Tctr Pitch:-2.94deg, Tctr Roll:13.01deg, Tctr Yaw Rate:5.03deg/s | 62 79 DA FE 15 05 F7 01 | b y Ú þ . . ÷ . | U:0 S:0 | 8 | 62 79 DA FE 15 05 F7 01
379 | 46.046 | 00000046.046' | 46124.7423723451 | 1 | 0x3F1 |  | Default: PDO |  | Default: TPDO 3 of Node 0x71 (113) | Easting:518723.166mm, Northing:3558743.389mm | 5E 16 EB 1E 5D 1D 1E D4 | ^ . ë . ] . . Ô | U:0 S:0 | 8 | 5E 16 EB 1E 5D 1D 1E D4
380 | 3.624 | 00000003.624' | 46124.7423723871 | 1 | 0x182 |  | Default: PDO |  | Default: TPDO 1 of Node [0x02 (2)] Tractor IMU | Tctr Heading:310.42deg, Tctr Pitch:-2.91deg, Tctr Roll:12.68deg, Tctr Yaw Rate:-1deg/s | 42 79 DD FE F4 04 9C FF | B y Ý þ ô . . ÿ | U:0 S:0 | 8 | 42 79 DD FE F4 04 9C FF
381 | 46.381 | 00000046.381' | 46124.7423729239 | 1 | 0x3F1 |  | Default: PDO |  | Default: TPDO 3 of Node 0x71 (113) | Easting:518723.166mm, Northing:3558743.389mm | 5E 16 EB 1E 5D 1D 1E D4 | ^ . ë . ] . . Ô | U:0 S:0 | 8 | 5E 16 EB 1E 5D 1D 1E D4
382 | 3.311 | 00000003.311' | 46124.7423729622 | 1 | 0x182 |  | Default: PDO |  | Default: TPDO 1 of Node [0x02 (2)] Tractor IMU | Tctr Heading:310.39deg, Tctr Pitch:-2.94deg, Tctr Roll:12.35deg, Tctr Yaw Rate:-1.79deg/s | 3F 79 DA FE D3 04 4D FF | ? y Ú þ Ó . M ÿ | U:0 S:0 | 8 | 3F 79 DA FE D3 04 4D FF
383 | 30.697 | 00000030.697' | 46124.7423733175 | 1 | 0x1F1 |  | Default: PDO |  | Default: TPDO 1 of Node 0x71 (113) | Fuse Easting Corr:460mm, Fuse Northing Corr:336mm, Fuse Alt Corr:-2529mm | CC 01 50 01 1F F6 | Ì . P . . ö | U:0 S:0 | 6 | CC 01 50 01 1F F6
384 | 16.016 | 00000016.016' | 46124.7423735029 | 1 | 0x3F1 |  | Default: PDO |  | Default: TPDO 3 of Node 0x71 (113) | Easting:518722.858mm, Northing:3558743.302mm | 2A 15 EB 1E 06 1D 1E D4 | * . ë . . . . Ô | U:0 S:0 | 8 | 2A 15 EB 1E 06 1D 1E D4
385 | 3.960 | 00000003.960' | 46124.7423735487 | 1 | 0x182 |  | Default: PDO |  | Default: TPDO 1 of Node [0x02 (2)] Tractor IMU | Tctr Heading:310.53deg, Tctr Pitch:-2.96deg, Tctr Roll:11.83deg, Tctr Yaw Rate:3.46deg/s | 4D 79 D8 FE 9F 04 5A 01 | M y Ø þ . . Z . | U:0 S:0 | 8 | 4D 79 D8 FE 9F 04 5A 01
386 | 46.041 | 00000046.041' | 46124.7423740816 | 1 | 0x3F1 |  | Default: PDO |  | Default: TPDO 3 of Node 0x71 (113) | Easting:518722.858mm, Northing:3558743.302mm | 2A 15 EB 1E 06 1D 1E D4 | * . ë . . . . Ô | U:0 S:0 | 8 | 2A 15 EB 1E 06 1D 1E D4
387 | 3.659 | 00000003.659' | 46124.7423741239 | 1 | 0x182 |  | Default: PDO |  | Default: TPDO 1 of Node [0x02 (2)] Tractor IMU | Tctr Heading:310.47deg, Tctr Pitch:-2.94deg, Tctr Roll:11.49deg, Tctr Yaw Rate:7.16deg/s | 47 79 DA FE 7D 04 CC 02 | G y Ú þ } . Ì . | U:0 S:0 | 8 | 47 79 DA FE 7D 04 CC 02
388 | 46.378 | 00000046.378' | 46124.7423746607 | 1 | 0x3F1 |  | Default: PDO |  | Default: TPDO 3 of Node 0x71 (113) | Easting:518722.858mm, Northing:3558743.302mm | 2A 15 EB 1E 06 1D 1E D4 | * . ë . . . . Ô | U:0 S:0 | 8 | 2A 15 EB 1E 06 1D 1E D4
389 | 3.296 | 00000003.296' | 46124.7423746989 | 1 | 0x182 |  | Default: PDO |  | Default: TPDO 1 of Node [0x02 (2)] Tractor IMU | Tctr Heading:310.15deg, Tctr Pitch:-2.83deg, Tctr Roll:10.94deg, Tctr Yaw Rate:6.93deg/s | 27 79 E5 FE 46 04 B5 02 | ' y å þ F . µ . | U:0 S:0 | 8 | 27 79 E5 FE 46 04 B5 02
390 | 46.703 | 00000046.703' | 46124.7423752394 | 1 | 0x3F1 |  | Default: PDO |  | Default: TPDO 3 of Node 0x71 (113) | Easting:518722.858mm, Northing:3558743.302mm | 2A 15 EB 1E 06 1D 1E D4 | * . ë . . . . Ô | U:0 S:0 | 8 | 2A 15 EB 1E 06 1D 1E D4
391 | 3.989 | 00000003.989' | 46124.7423752856 | 1 | 0x182 |  | Default: PDO |  | Default: TPDO 1 of Node [0x02 (2)] Tractor IMU | Tctr Heading:309.85deg, Tctr Pitch:-2.69deg, Tctr Roll:10.31deg, Tctr Yaw Rate:11.41deg/s | 09 79 F3 FE 07 04 75 04 | . y ó þ . . u . | U:0 S:0 | 8 | 09 79 F3 FE 07 04 75 04
392 | 46.007 | 00000046.007' | 46124.7423758181 | 1 | 0x3F1 |  | Default: PDO |  | Default: TPDO 3 of Node 0x71 (113) | Easting:518722.858mm, Northing:3558743.302mm | 2A 15 EB 1E 06 1D 1E D4 | * . ë . . . . Ô | U:0 S:0 | 8 | 2A 15 EB 1E 06 1D 1E D4
393 | 3.679 | 00000003.679' | 46124.7423758606 | 1 | 0x182 |  | Default: PDO |  | Default: TPDO 1 of Node [0x02 (2)] Tractor IMU | Tctr Heading:309.44deg, Tctr Pitch:-2.52deg, Tctr Roll:9.72deg, Tctr Yaw Rate:21.48deg/s | E0 78 04 FF CC 03 64 08 | à x . ÿ Ì . d . | U:0 S:0 | 8 | E0 78 04 FF CC 03 64 08
394 | 46.326 | 00000046.326' | 46124.7423763968 | 1 | 0x3F1 |  | Default: PDO |  | Default: TPDO 3 of Node 0x71 (113) | Easting:518722.858mm, Northing:3558743.302mm | 2A 15 EB 1E 06 1D 1E D4 | * . ë . . . . Ô | U:0 S:0 | 8 | 2A 15 EB 1E 06 1D 1E D4
395 | 3.341 | 00000003.341' | 46124.7423764355 | 1 | 0x182 |  | Default: PDO |  | Default: TPDO 1 of Node [0x02 (2)] Tractor IMU | Tctr Heading:308.54deg, Tctr Pitch:-2.27deg, Tctr Roll:9.02deg, Tctr Yaw Rate:20.14deg/s | 86 78 1D FF 86 03 DE 07 | . x . ÿ . . Þ . | U:0 S:0 | 8 | 86 78 1D FF 86 03 DE 07
396 | 46.662 | 00000046.662' | 46124.7423769756 | 1 | 0x3F1 |  | Default: PDO |  | Default: TPDO 3 of Node 0x71 (113) | Easting:518722.858mm, Northing:3558743.302mm | 2A 15 EB 1E 06 1D 1E D4 | * . ë . . . . Ô | U:0 S:0 | 8 | 2A 15 EB 1E 06 1D 1E D4
397 | 4.007 | 00000004.007' | 46124.7423770219 | 1 | 0x182 |  | Default: PDO |  | Default: TPDO 1 of Node [0x02 (2)] Tractor IMU | Tctr Heading:307.55deg, Tctr Pitch:-2.04deg, Tctr Roll:8.43deg, Tctr Yaw Rate:16.33deg/s | 23 78 34 FF 4B 03 61 06 | # x 4 ÿ K . a . | U:0 S:0 | 8 | 23 78 34 FF 4B 03 61 06
398 | 46.000 | 00000046.000' | 46124.7423775544 | 1 | 0x3F1 |  | Default: PDO |  | Default: TPDO 3 of Node 0x71 (113) | Easting:518722.858mm, Northing:3558743.302mm | 2A 15 EB 1E 06 1D 1E D4 | * . ë . . . . Ô | U:0 S:0 | 8 | 2A 15 EB 1E 06 1D 1E D4
399 | 3.679 | 00000003.679' | 46124.7423775969 | 1 | 0x182 |  | Default: PDO |  | Default: TPDO 1 of Node [0x02 (2)] Tractor IMU | Tctr Heading:306.72deg, Tctr Pitch:-1.85deg, Tctr Roll:7.75deg, Tctr Yaw Rate:6.82deg/s | D0 77 47 FF 07 03 AA 02 | Ð w G ÿ . . ª . | U:0 S:0 | 8 | D0 77 47 FF 07 03 AA 02
400 | 46.319 | 00000046.319' | 46124.742378133 | 1 | 0x3F1 |  | Default: PDO |  | Default: TPDO 3 of Node 0x71 (113) | Easting:518722.858mm, Northing:3558743.302mm | 2A 15 EB 1E 06 1D 1E D4 | * . ë . . . . Ô | U:0 S:0 | 8 | 2A 15 EB 1E 06 1D 1E D4
401 | 3.335 | 00000003.335' | 46124.7423781716 | 1 | 0x182 |  | Default: PDO |  | Default: TPDO 1 of Node [0x02 (2)] Tractor IMU | Tctr Heading:306.21deg, Tctr Pitch:-1.71deg, Tctr Roll:7.12deg, Tctr Yaw Rate:-3.46deg/s | 9D 77 55 FF C8 02 A6 FE | . w U ÿ È . ¦ þ | U:0 S:0 | 8 | 9D 77 55 FF C8 02 A6 FE
402 | 46.670 | 00000046.670' | 46124.7423787118 | 1 | 0x3F1 |  | Default: PDO |  | Default: TPDO 3 of Node 0x71 (113) | Easting:518722.858mm, Northing:3558743.302mm | 2A 15 EB 1E 06 1D 1E D4 | * . ë . . . . Ô | U:0 S:0 | 8 | 2A 15 EB 1E 06 1D 1E D4
403 | 4.013 | 00000004.013' | 46124.7423787582 | 1 | 0x182 |  | Default: PDO |  | Default: TPDO 1 of Node [0x02 (2)] Tractor IMU | Tctr Heading:306.25deg, Tctr Pitch:-1.63deg, Tctr Roll:6.57deg, Tctr Yaw Rate:-4.47deg/s | A1 77 5D FF 91 02 41 FE | ¡ w ] ÿ . . A þ | U:0 S:0 | 8 | A1 77 5D FF 91 02 41 FE
404 | 45.983 | 00000045.983' | 46124.7423792905 | 1 | 0x3F1 |  | Default: PDO |  | Default: TPDO 3 of Node 0x71 (113) | Easting:518722.858mm, Northing:3558743.302mm | 2A 15 EB 1E 06 1D 1E D4 | * . ë . . . . Ô | U:0 S:0 | 8 | 2A 15 EB 1E 06 1D 1E D4
405 | 3.703 | 00000003.703' | 46124.7423793333 | 1 | 0x182 |  | Default: PDO |  | Default: TPDO 1 of Node [0x02 (2)] Tractor IMU | Tctr Heading:306.53deg, Tctr Pitch:-1.56deg, Tctr Roll:5.94deg, Tctr Yaw Rate:0.11deg/s | BD 77 64 FF 52 02 0B 00 | ½ w d ÿ R . . . | U:0 S:0 | 8 | BD 77 64 FF 52 02 0B 00
406 | 46.301 | 00000046.301' | 46124.7423798692 | 1 | 0x3F1 |  | Default: PDO |  | Default: TPDO 3 of Node 0x71 (113) | Easting:518722.858mm, Northing:3558743.302mm | 2A 15 EB 1E 06 1D 1E D4 | * . ë . . . . Ô | U:0 S:0 | 8 | 2A 15 EB 1E 06 1D 1E D4
407 | 3.349 | 00000003.349' | 46124.742379908 | 1 | 0x182 |  | Default: PDO |  | Default: TPDO 1 of Node [0x02 (2)] Tractor IMU | Tctr Heading:306.6deg, Tctr Pitch:-1.51deg, Tctr Roll:5.47deg, Tctr Yaw Rate:4.25deg/s | C4 77 69 FF 23 02 A9 01 | Ä w i ÿ # . © . | U:0 S:0 | 8 | C4 77 69 FF 23 02 A9 01
408 | 46.654 | 00000046.654' | 46124.7423804479 | 1 | 0x3F1 |  | Default: PDO |  | Default: TPDO 3 of Node 0x71 (113) | Easting:518722.858mm, Northing:3558743.302mm | 2A 15 EB 1E 06 1D 1E D4 | * . ë . . . . Ô | U:0 S:0 | 8 | 2A 15 EB 1E 06 1D 1E D4
409 | 4.024 | 00000004.024' | 46124.7423804945 | 1 | 0x182 |  | Default: PDO |  | Default: TPDO 1 of Node [0x02 (2)] Tractor IMU | Tctr Heading:306.49deg, Tctr Pitch:-1.47deg, Tctr Roll:5.01deg, Tctr Yaw Rate:5.48deg/s | B9 77 6D FF F5 01 24 02 | ¹ w m ÿ õ . $ . | U:0 S:0 | 8 | B9 77 6D FF F5 01 24 02
410 | 45.981 | 00000045.981' | 46124.7423810267 | 1 | 0x3F1 |  | Default: PDO |  | Default: TPDO 3 of Node 0x71 (113) | Easting:518722.858mm, Northing:3558743.302mm | 2A 15 EB 1E 06 1D 1E D4 | * . ë . . . . Ô | U:0 S:0 | 8 | 2A 15 EB 1E 06 1D 1E D4
411 | 3.701 | 00000003.701' | 46124.7423810695 | 1 | 0x182 |  | Default: PDO |  | Default: TPDO 1 of Node [0x02 (2)] Tractor IMU | Tctr Heading:306.26deg, Tctr Pitch:-1.45deg, Tctr Roll:4.53deg, Tctr Yaw Rate:8.84deg/s | A2 77 6F FF C5 01 74 03 | ¢ w o ÿ Å . t . | U:0 S:0 | 8 | A2 77 6F FF C5 01 74 03
412 | 46.295 | 00000046.295' | 46124.7423816054 | 1 | 0x3F1 |  | Default: PDO |  | Default: TPDO 3 of Node 0x71 (113) | Easting:518722.858mm, Northing:3558743.302mm | 2A 15 EB 1E 06 1D 1E D4 | * . ë . . . . Ô | U:0 S:0 | 8 | 2A 15 EB 1E 06 1D 1E D4
413 | 3.383 | 00000003.383' | 46124.7423816445 | 1 | 0x182 |  | Default: PDO |  | Default: TPDO 1 of Node [0x02 (2)] Tractor IMU | Tctr Heading:305.88deg, Tctr Pitch:-1.46deg, Tctr Roll:4.23deg, Tctr Yaw Rate:12.08deg/s | 7C 77 6E FF A7 01 B8 04 | | w n ÿ § . ¸ . | U:0 S:0 | 8 | 7C 77 6E FF A7 01 B8 04
414 | 46.625 | 00000046.625' | 46124.7423821842 | 1 | 0x3F1 |  | Default: PDO |  | Default: TPDO 3 of Node 0x71 (113) | Easting:518722.858mm, Northing:3558743.302mm | 2A 15 EB 1E 06 1D 1E D4 | * . ë . . . . Ô | U:0 S:0 | 8 | 2A 15 EB 1E 06 1D 1E D4
415 | 4.053 | 00000004.053' | 46124.7423822311 | 1 | 0x182 |  | Default: PDO |  | Default: TPDO 1 of Node [0x02 (2)] Tractor IMU | Tctr Heading:305.35deg, Tctr Pitch:-1.5deg, Tctr Roll:3.83deg, Tctr Yaw Rate:14.21deg/s | 47 77 6A FF 7F 01 8D 05 | G w j ÿ . . . . | U:0 S:0 | 8 | 47 77 6A FF 7F 01 8D 05
416 | 45.945 | 00000045.945' | 46124.7423827628 | 1 | 0x3F1 |  | Default: PDO |  | Default: TPDO 3 of Node 0x71 (113) | Easting:518722.858mm, Northing:3558743.302mm | 2A 15 EB 1E 06 1D 1E D4 | * . ë . . . . Ô | U:0 S:0 | 8 | 2A 15 EB 1E 06 1D 1E D4
417 | 10.079 | 00000010.079' | 46124.7423828795 | 1 | 0x182 |  | Default: PDO |  | Default: TPDO 1 of Node [0x02 (2)] Tractor IMU | Tctr Heading:303.99deg, Tctr Pitch:-1.62deg, Tctr Roll:3.3deg, Tctr Yaw Rate:14.1deg/s | BF 76 5E FF 4A 01 82 05 | ¿ v ^ ÿ J . . . | U:0 S:0 | 8 | BF 76 5E FF 4A 01 82 05
418 | 39.925 | 00000039.925' | 46124.7423833416 | 1 | 0x3F1 |  | Default: PDO |  | Default: TPDO 3 of Node 0x71 (113) | Easting:518722.858mm, Northing:3558743.302mm | 2A 15 EB 1E 06 1D 1E D4 | * . ë . . . . Ô | U:0 S:0 | 8 | 2A 15 EB 1E 06 1D 1E D4
419 | 10.214 | 00000010.214' | 46124.7423834598 | 1 | 0x182 |  | Default: PDO |  | Default: TPDO 1 of Node [0x02 (2)] Tractor IMU | Tctr Heading:303.34deg, Tctr Pitch:-1.68deg, Tctr Roll:3.03deg, Tctr Yaw Rate:12.42deg/s | 7E 76 58 FF 2F 01 DA 04 | ~ v X ÿ / . Ú . | U:0 S:0 | 8 | 7E 76 58 FF 2F 01 DA 04
420 | 39.790 | 00000039.790' | 46124.7423839203 | 1 | 0x3F1 |  | Default: PDO |  | Default: TPDO 3 of Node 0x71 (113) | Easting:518722.858mm, Northing:3558743.302mm | 2A 15 EB 1E 06 1D 1E D4 | * . ë . . . . Ô | U:0 S:0 | 8 | 2A 15 EB 1E 06 1D 1E D4
421 | 10.695 | 00000010.695' | 46124.7423840441 | 1 | 0x182 |  | Default: PDO |  | Default: TPDO 1 of Node [0x02 (2)] Tractor IMU | Tctr Heading:302.92deg, Tctr Pitch:-1.74deg, Tctr Roll:2.89deg, Tctr Yaw Rate:7.05deg/s | 54 76 52 FF 21 01 C1 02 | T v R ÿ ! . Á . | U:0 S:0 | 8 | 54 76 52 FF 21 01 C1 02
422 | 39.302 | 00000039.302' | 46124.742384499 | 1 | 0x3F1 |  | Default: PDO |  | Default: TPDO 3 of Node 0x71 (113) | Easting:518722.858mm, Northing:3558743.302mm | 2A 15 EB 1E 06 1D 1E D4 | * . ë . . . . Ô | U:0 S:0 | 8 | 2A 15 EB 1E 06 1D 1E D4
423 | 42.711 | 00000042.711' | 46124.7423849933 | 1 | 0x1F1 |  | Default: PDO |  | Default: TPDO 1 of Node 0x71 (113) | Fuse Easting Corr:137mm, Fuse Northing Corr:66mm, Fuse Alt Corr:-2588mm | 89 00 42 00 E4 F5 | . . B . ä õ | U:0 S:0 | 6 | 89 00 42 00 E4 F5
424 | 7.321 | 00000007.321' | 46124.7423850781 | 1 | 0x182 |  | Default: PDO |  | Default: TPDO 1 of Node [0x02 (2)] Tractor IMU | Tctr Heading:302.72deg, Tctr Pitch:-1.79deg, Tctr Roll:2.73deg, Tctr Yaw Rate:0.11deg/s | 40 76 4D FF 11 01 0B 00 | @ v M ÿ . . . . | U:0 S:0 | 8 | 40 76 4D FF 11 01 0B 00
425 | 1.360 | 00000001.360' | 46124.7423850938 | 1 | 0x3F1 |  | Default: PDO |  | Default: TPDO 3 of Node 0x71 (113) | Easting:518722.289mm, Northing:3558742.881mm | F1 12 EB 1E 61 1B 1E D4 | ñ . ë . a . . Ô | U:0 S:0 | 8 | F1 12 EB 1E 61 1B 1E D4
426 | 48.658 | 00000048.658' | 46124.742385657 | 1 | 0x182 |  | Default: PDO |  | Default: TPDO 1 of Node [0x02 (2)] Tractor IMU | Tctr Heading:302.67deg, Tctr Pitch:-1.82deg, Tctr Roll:2.63deg, Tctr Yaw Rate:-1.11deg/s | 3B 76 4A FF 07 01 91 FF | ; v J ÿ . . . ÿ | U:0 S:0 | 8 | 3B 76 4A FF 07 01 91 FF
427 | 1.350 | 00000001.350' | 46124.7423856726 | 1 | 0x3F1 |  | Default: PDO |  | Default: TPDO 3 of Node 0x71 (113) | Easting:518722.289mm, Northing:3558742.881mm | F1 12 EB 1E 61 1B 1E D4 | ñ . ë . a . . Ô | U:0 S:0 | 8 | F1 12 EB 1E 61 1B 1E D4
428 | 48.658 | 00000048.658' | 46124.7423862358 | 1 | 0x182 |  | Default: PDO |  | Default: TPDO 1 of Node [0x02 (2)] Tractor IMU | Tctr Heading:302.72deg, Tctr Pitch:-1.85deg, Tctr Roll:2.59deg, Tctr Yaw Rate:0.44deg/s | 40 76 47 FF 03 01 2C 00 | @ v G ÿ . . , . | U:0 S:0 | 8 | 40 76 47 FF 03 01 2C 00
429 | 1.360 | 00000001.360' | 46124.7423862515 | 1 | 0x3F1 |  | Default: PDO |  | Default: TPDO 3 of Node 0x71 (113) | Easting:518722.289mm, Northing:3558742.881mm | F1 12 EB 1E 61 1B 1E D4 | ñ . ë . a . . Ô | U:0 S:0 | 8 | F1 12 EB 1E 61 1B 1E D4
430 | 48.624 | 00000048.624' | 46124.7423868143 | 1 | 0x182 |  | Default: PDO |  | Default: TPDO 1 of Node [0x02 (2)] Tractor IMU | Tctr Heading:302.72deg, Tctr Pitch:-1.87deg, Tctr Roll:2.49deg, Tctr Yaw Rate:0.78deg/s | 40 76 45 FF F9 00 4E 00 | @ v E ÿ ù . N . | U:0 S:0 | 8 | 40 76 45 FF F9 00 4E 00
431 | 1.359 | 00000001.359' | 46124.74238683 | 1 | 0x3F1 |  | Default: PDO |  | Default: TPDO 3 of Node 0x71 (113) | Easting:518722.289mm, Northing:3558742.881mm | F1 12 EB 1E 61 1B 1E D4 | ñ . ë . a . . Ô | U:0 S:0 | 8 | F1 12 EB 1E 61 1B 1E D4
432 | 48.590 | 00000048.590' | 46124.7423873924 | 1 | 0x3F1 |  | Default: PDO |  | Default: TPDO 3 of Node 0x71 (113) | Easting:518722.289mm, Northing:3558742.881mm | F1 12 EB 1E 61 1B 1E D4 | ñ . ë . a . . Ô | U:0 S:0 | 8 | F1 12 EB 1E 61 1B 1E D4
433 | 3.135 | 00000003.135' | 46124.7423874287 | 1 | 0x182 |  | Default: PDO |  | Default: TPDO 1 of Node [0x02 (2)] Tractor IMU | Tctr Heading:302.68deg, Tctr Pitch:-1.88deg, Tctr Roll:2.51deg, Tctr Yaw Rate:0.44deg/s | 3C 76 44 FF FB 00 2C 00 | < v D ÿ û . , . | U:0 S:0 | 8 | 3C 76 44 FF FB 00 2C 00
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
