ajayre/tandemleveller/CAD/Controls/Joystick/Joystick assembly.STEP

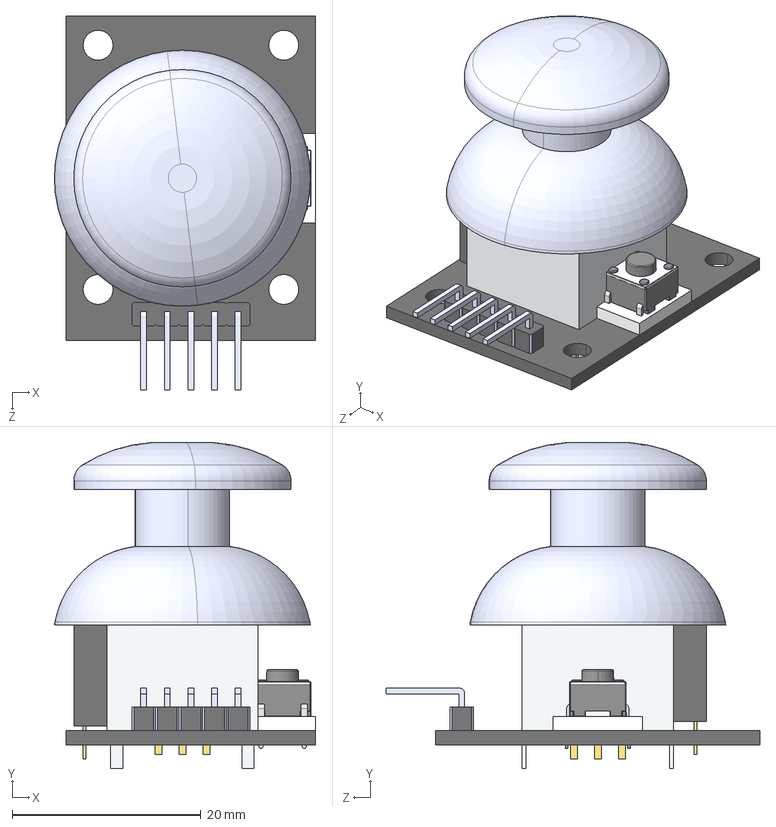
[picture p8: CAD file, 2025-10-03]
CAD/Controls/Joystick/Joystick assembly.STEP
27.7 x 34.5 x 39.5 mm
board
potentiometer___ x 2
tactileswitch-short
joystickhead___
