ajayre/tandemleveller/CAD/Angle Sensor/c-dt04-3p-cl03-99-3d.stp

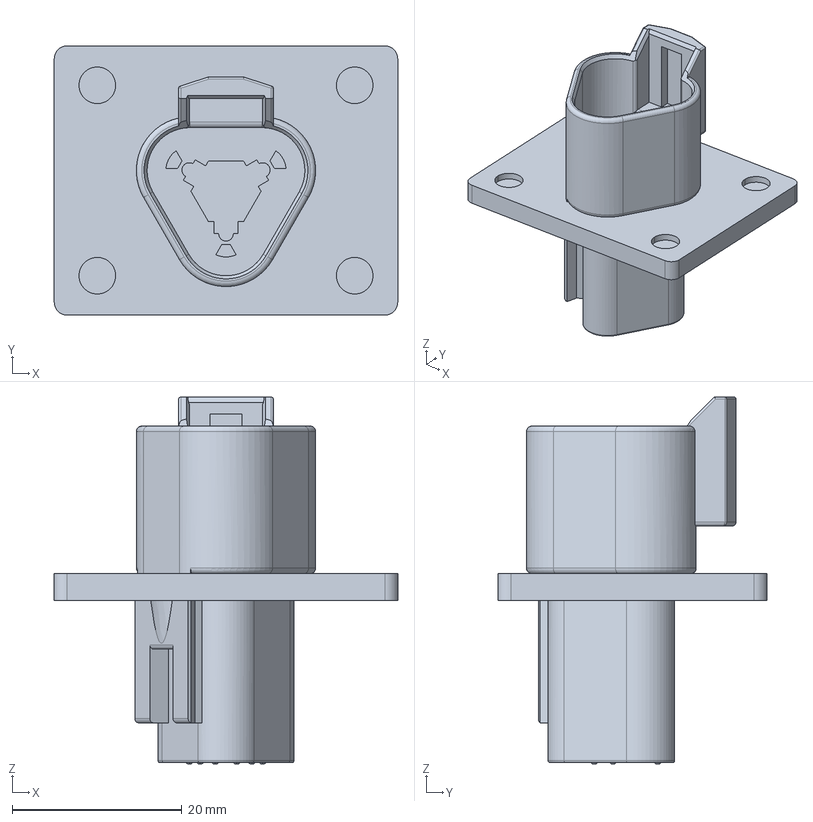
[picture p9: CAD file, 2025-12-31]
CAD/Angle Sensor/c-dt04-3p-cl03-99-3d.stp
40.5 x 31.8 x 43.3 mm
