ajayre/tandemleveller/CAD/Angle Sensor/Front Scraper/Hose2.stp

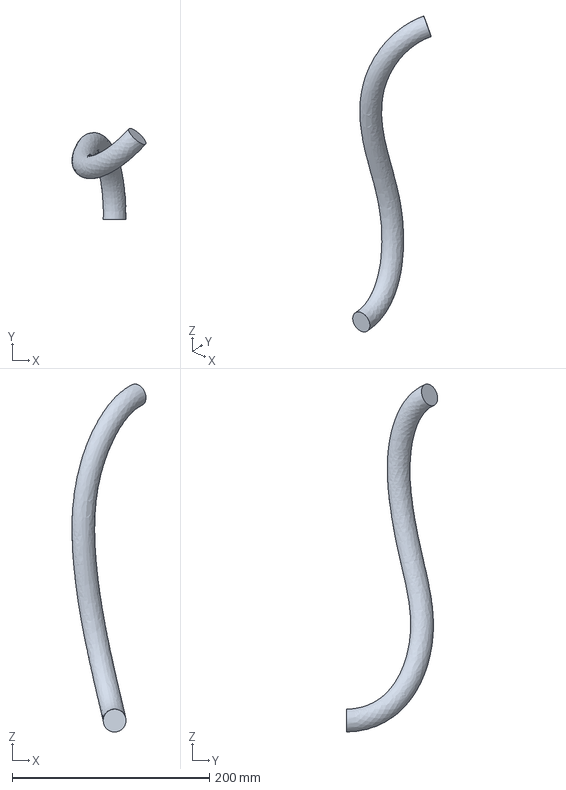
[picture p10: CAD file, 2026-05-11]
CAD/Angle Sensor/Front Scraper/Hose2.stp
75.0 x 92.6 x 352.7 mm
