ajayre/tandemleveller/CAD/Base Station V2/Base Station Mount.stp

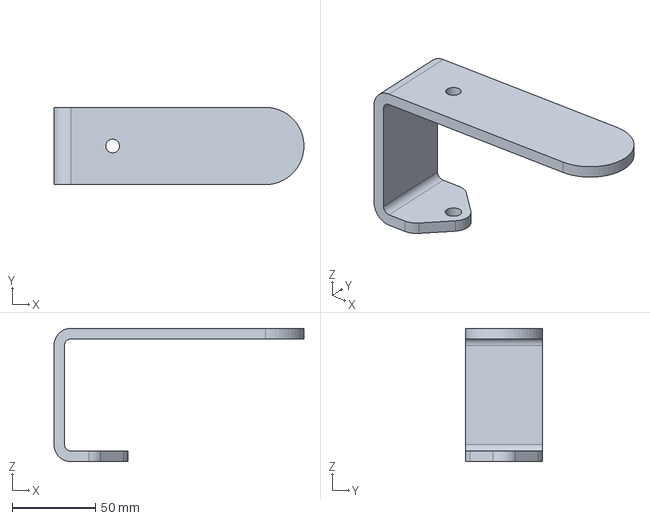
[picture p11: CAD file, 2025-12-12]
CAD/Base Station V2/Base Station Mount.stp
150.0 x 46.4 x 80.0 mm
