ajayre/tandemleveller/CAD/Controller V2/Case V3/FH-M3-12ZC-PennEngineering-3D-04-21-2026.stp

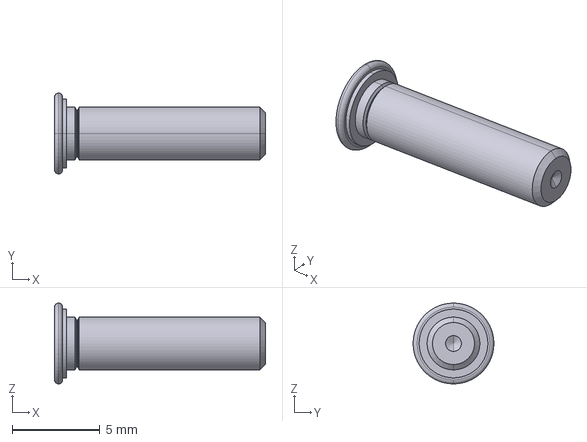
[picture p12: CAD file, 2026-04-22]
CAD/Controller V2/Case V3/FH-M3-12ZC-PennEngineering-3D-04-21-2026.stp
12.0 x 4.60 x 4.60 mm
