ajayre/tandemleveller/CAD/Controls/Bracket.stp

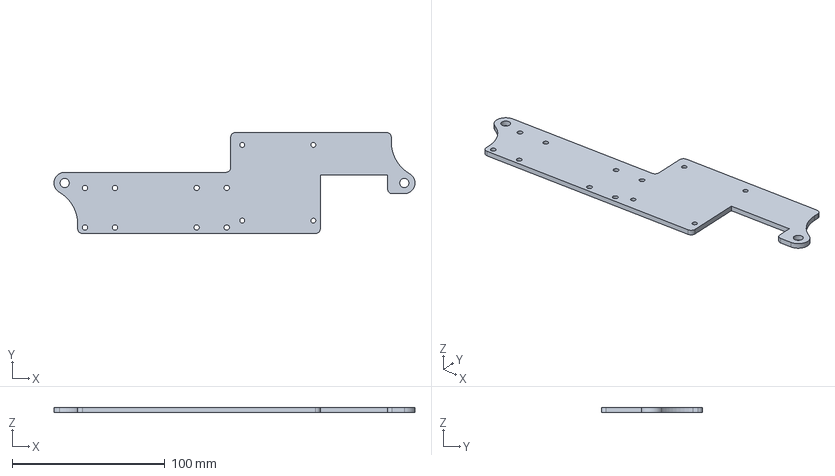
[picture p13: CAD file, 2025-10-23]
CAD/Controls/Bracket.stp
236.0 x 66.0 x 3.17 mm
