ajayre/tandemleveller/CAD/IMU/Housing/M12A-04BFFB-SL7001.stp

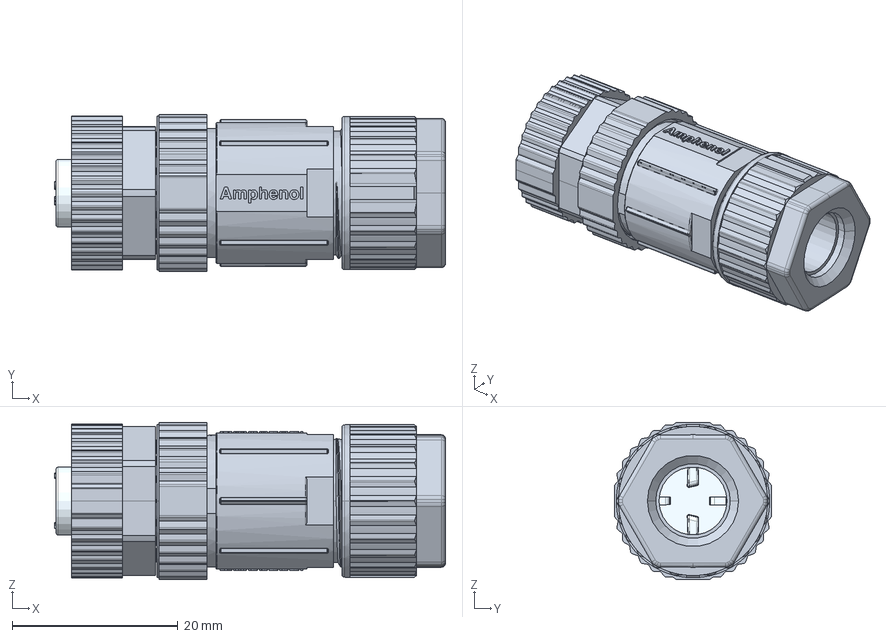
[picture p14: CAD file, 2026-04-06]
CAD/IMU/Housing/M12A-04BFFB-SL7001.stp
47.2 x 19.0 x 19.0 mm
