ajayre/tandemleveller/CAD/Rover/Simple Case/Case Bottom.stl

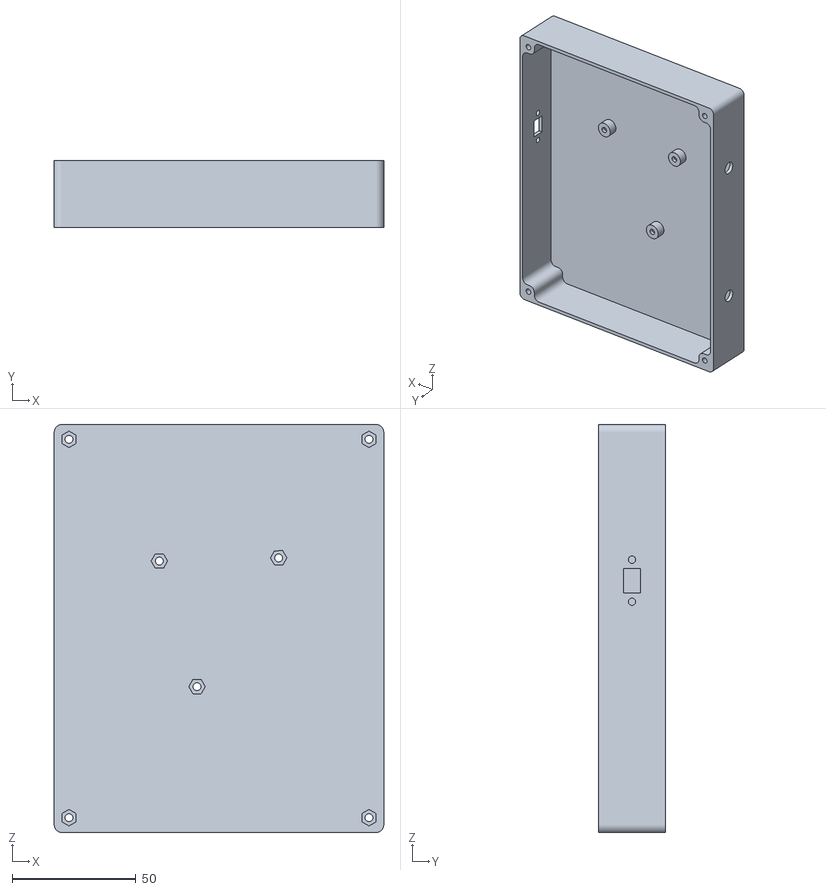
[picture p15: CAD file, 2025-02-14]
CAD/Rover/Simple Case/Case Bottom.stl
133.3 x 27.0 x 165.0
