ajayre/tandemleveller/CAD/Teensy 4.1/Teensy_4.1.stp

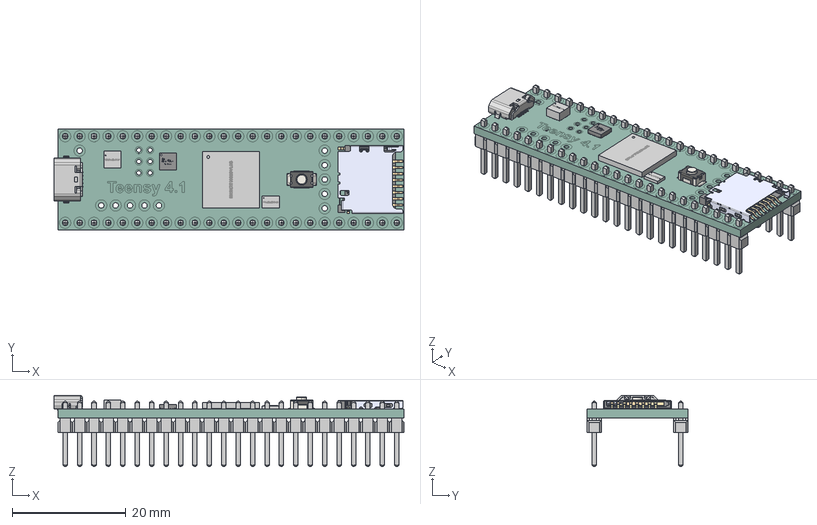
[picture p16: CAD file, 2025-11-21]
CAD/Teensy 4.1/Teensy_4.1.stp
61.7 x 17.8 x 12.6 mm
Corps1
Corps2
Corps3
Corps4
Corps5
Corps6
Corps7
Corps8
Corps9
Corps10
Corps25
Corps26
Corps27
Corps28
Corps29
Corps30
Corps31
Corps32
Corps33
Corps34
Corps35
Corps36
Corps37
Corps38
Corps39
Corps40
Corps41
Corps42
Corps43
Corps57
Corps59
Corps60
Corps61
Corps62
Corps63
Corps64
Corps65
Corps66
Corps17
Corps18
Corps15
Corps13
Corps21
Corps20
Corps14
Corps47
Corps52
Corps19
Corps55
Corps16
Corps56
Corps45
Corps44
Corps12
Corps24
Corps23
Corps22
Corps50
Corps58
Corps11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
