ajayre/tandemleveller/CAD/Tractor Mount/GNSS Antenna/AS-ANT2B-SUR-L1L2-25SMA-00-R00.STEP

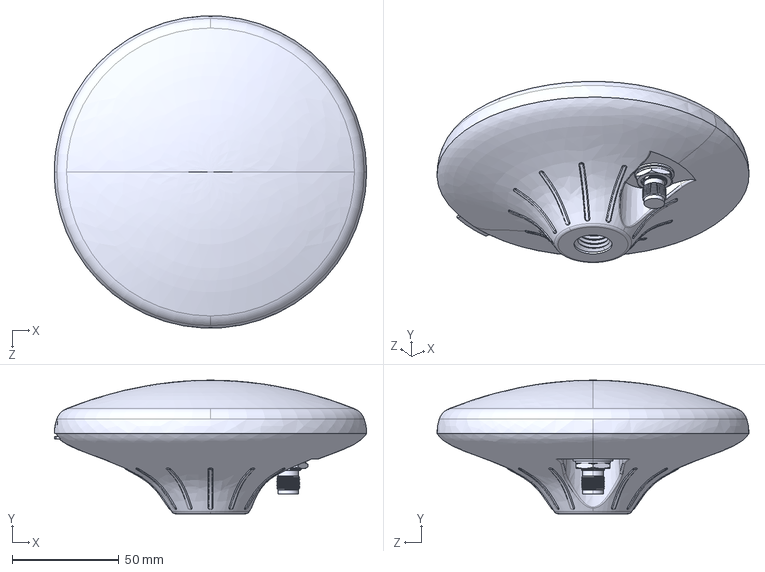
[picture p17: CAD file, 2025-11-16]
CAD/Tractor Mount/GNSS Antenna/AS-ANT2B-SUR-L1L2-25SMA-00-R00.STEP
146.2 x 62.5 x 146.0 mm
