ajayre/tandemleveller/CAD/Tractor Mount/TractorMount.stp

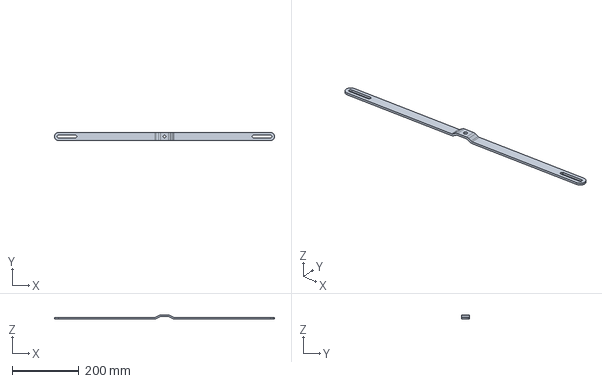
[picture p18: CAD file, 2026-06-11]
CAD/Tractor Mount/TractorMount.stp
659.4 x 25.0 x 11.2 mm
