ajayre/tandemleveller/Electronics/Controller V2/Docs/MD13S-SUMO.step

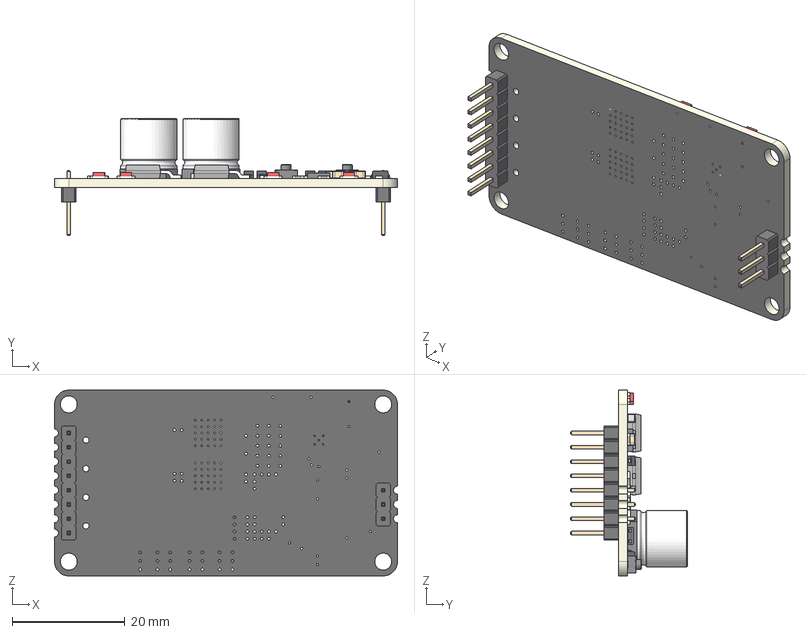
[picture p19: CAD file, 2026-01-29]
Electronics/Controller V2/Docs/MD13S-SUMO.step
61.0 x 20.8 x 33.0 mm
MD13S PCB
C2012 x 5
R2012 x 12
D-SOD-123 x 5
LED-3216 x 4
SOT-23
DPAK x 4
S-R-1W-6432
S-SP-2N-KAN0444 x 2
QFN24
SMD ECAP_10x10.7H x 2
LED-3216 (1)
PinHeader_1x08_P254mm_Vertical
PinHeader_1x03_P254mm_Vertical
