ajayre/tandemleveller/Electronics/Controller V2/GNSS Daughterboard/CAD/GNSS Daughterboard.step

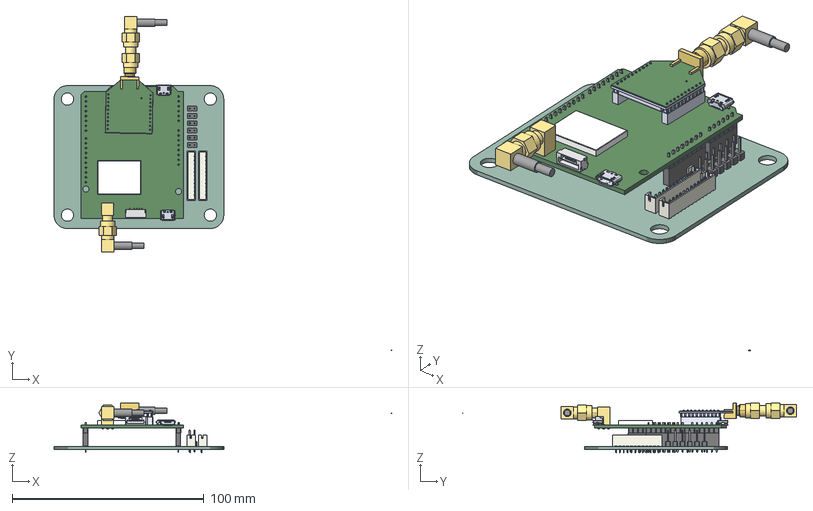
[picture p20: CAD file, 2026-02-08]
Electronics/Controller V2/GNSS Daughterboard/CAD/GNSS Daughterboard.step
176.2 x 174.3 x 26.0 mm
PinHeader_1x02_P254mm_Vertical x 6
PinSocket_1x08_P254mm_Vertical x 2
PinSocket_1x10_P254mm_Vertical
PinSocket_1x06_P254mm_Vertical
simpleRTK2B
PinHeader_1x08_P254mm_Vertical x 2
PinHeader_1x10_P254mm_Vertical
PinHeader_1x06_P254mm_Vertical
SMA Female
SMA Male
JST_B12B_PH_K x 2
GNSS Daughterboard PCB
