ajayre/tandemleveller/Electronics/Controller V2/Valve Daughterboard/CAD/Valve Daughterboard.step

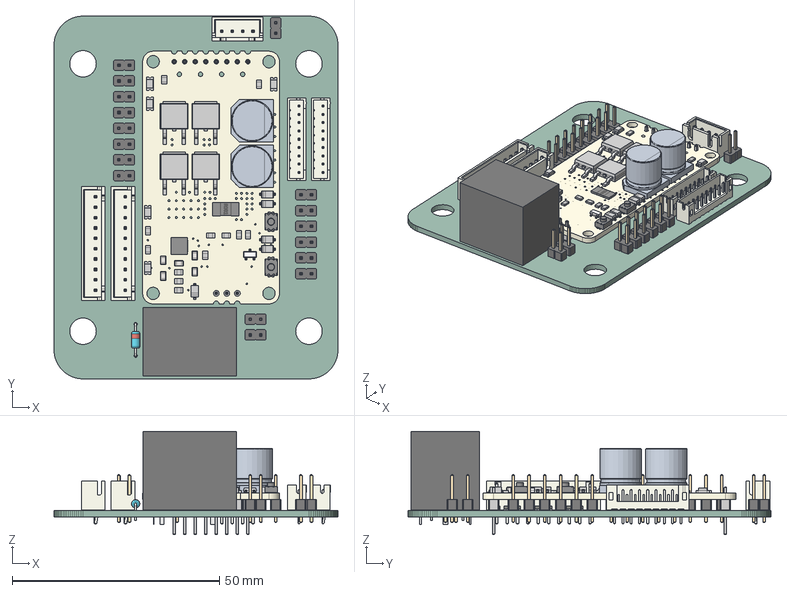
[picture p21: CAD file, 2026-05-04]
Electronics/Controller V2/Valve Daughterboard/CAD/Valve Daughterboard.step
68.5 x 87.5 x 24.9 mm
JST_B10B_XH_A x 2
PinHeader_1x02_P254mm_Vertical x 18
JST_B4B_XH_A
relay_g5le-14_5dc
D_DO-35_SOD27_P7.62mm_Horizontal
JST_B9B_PH_K x 2
(Unsaved)
Valve Daughterboard PCB
