ajayre/tandemleveller/Electronics/IMU/CAD/IMU.step

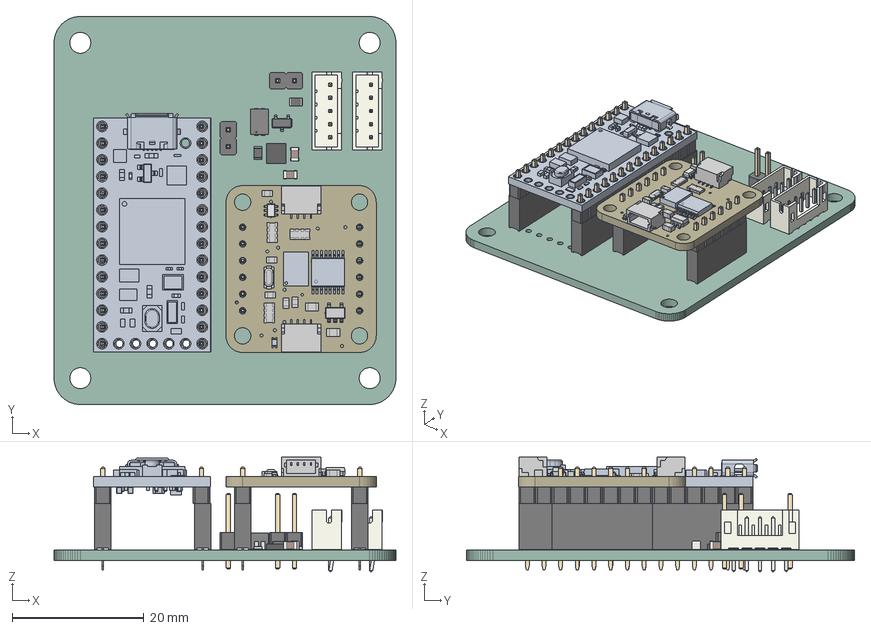
[picture p22: CAD file, 2026-02-24]
Electronics/IMU/CAD/IMU.step
52.0 x 59.0 x 17.4 mm
C_0805_2012Metric x 2
PinSocket_1x14_P254mm_Vertical x 2
PinHeader_1x14_P254mm_Vertical x 2
DEV-15583
JST_B5B_PH_K x 2
New Part (1)
PinHeader_1x02_P254mm_Vertical x 2
SOT_23
R_0805_2012Metric x 2
PinSocket_1x06_P254mm_Vertical x 2
PCB Component
PinHeader_1x06_P254mm_Vertical x 2
IMU PCB
