ajayre/tandemleveller/Electronics/Misc/MDD10A/CAD/MDD10A REV2.STEP

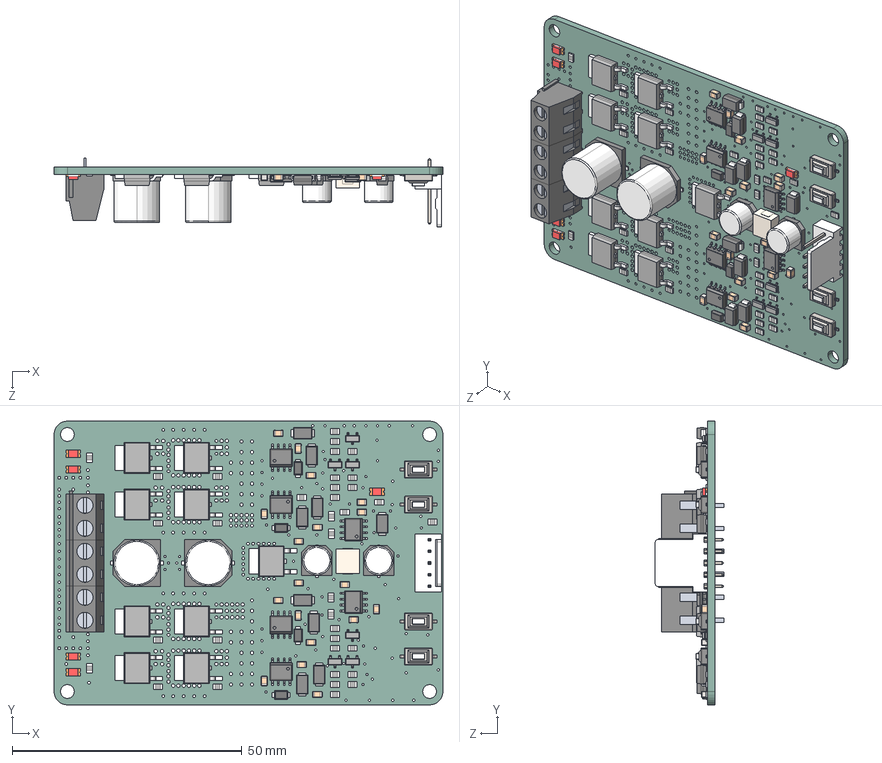
[picture p23: CAD file, 2025-03-30]
Electronics/Misc/MDD10A/CAD/MDD10A REV2.STEP
84.6 x 61.7 x 14.9 mm
PCB
CHEMICON-J x 2
DPAK x 9
CHEMICON-F x 2
2012-CAP x 18
L-5852-CYL
SOIC-08N x 6
LED-3216 x 5
SMA x 9
SOD-123 x 4
SOT-23 x 6
2510 PCB Connector Base_05
2510 PCB Pin x 5
TERMINAL-KF127-2P_Black x 2
TERMINAL-KF127-2P_Green
S-SW-PBM-KAN0444 x 4
