ajayre/tandemleveller/Electronics/Scraper Angle/CAD/Scraper Angle.step

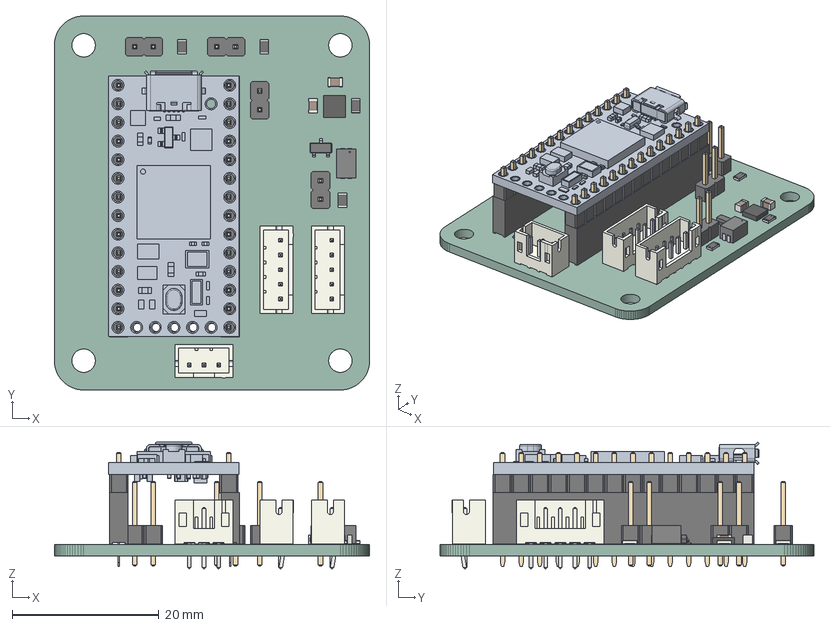
[picture p24: CAD file, 2025-10-22]
Electronics/Scraper Angle/CAD/Scraper Angle.step
43.0 x 51.0 x 17.3 mm
PinHeader_1x02_P254mm_Vertical x 4
SOT_23
JST_B5B_PH_K x 2
R_0805_2012Metric x 4
JST_B3B_PH_K
New Part (1)
PinSocket_1x14_P254mm_Vertical x 2
PinHeader_1x14_P254mm_Vertical x 2
DEV-15583
C_0805_2012Metric x 2
Scraper Angle PCB
