ajayre/tandemleveller/Electronics/User Controls/CAD/User Controls.step

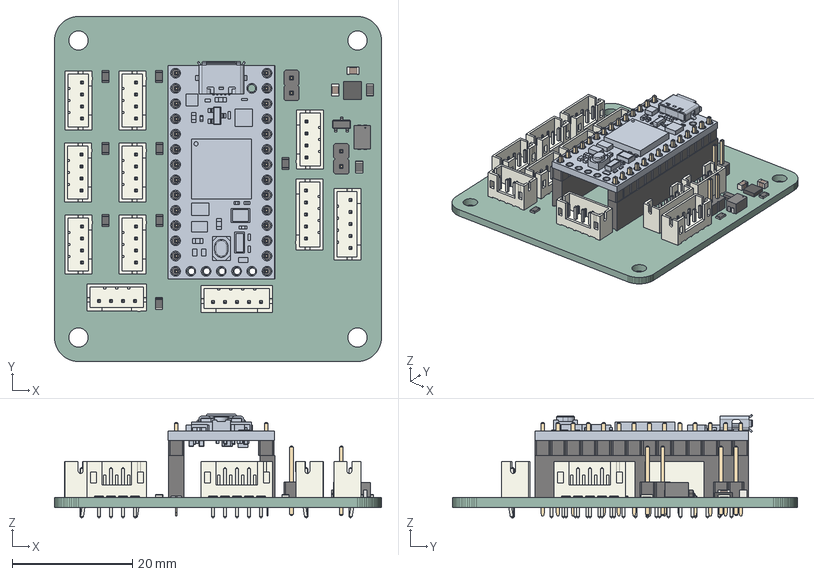
[picture p25: CAD file, 2025-10-22]
Electronics/User Controls/CAD/User Controls.step
54.5 x 57.5 x 17.3 mm
JST_B4B_PH_K x 8
PinHeader_1x02_P254mm_Vertical x 2
SOT_23
R_0805_2012Metric x 10
JST_B5B_PH_K x 3
New Part (1)
PinSocket_1x14_P254mm_Vertical x 2
PinHeader_1x14_P254mm_Vertical x 2
DEV-15583
C_0805_2012Metric x 2
User Controls PCB
