ajayre/tandemleveller/Electronics/XBee Adapter/Dummy XBee/CAD/Dummy XBee.step

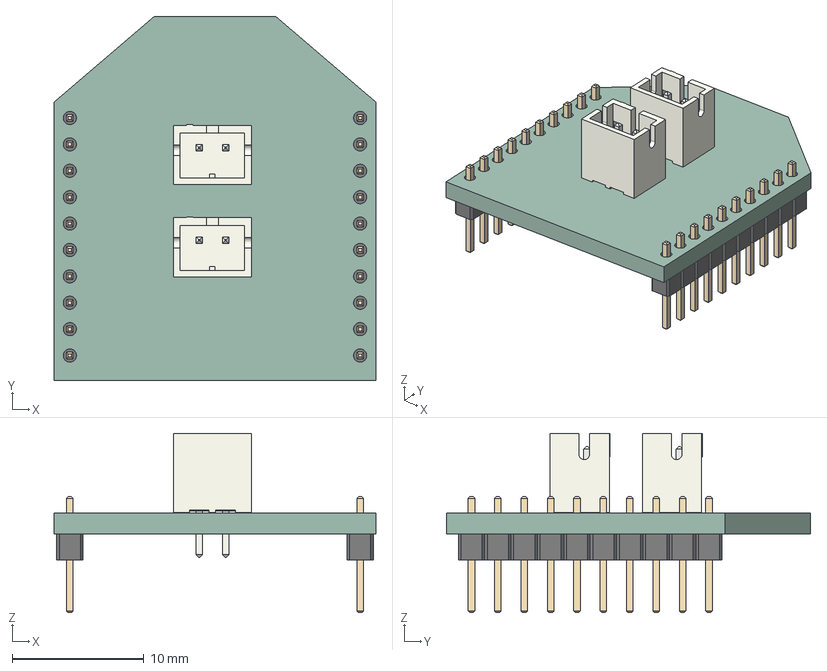
[picture p26: CAD file, 2026-04-21]
Electronics/XBee Adapter/Dummy XBee/CAD/Dummy XBee.step
24.4 x 27.6 x 13.6 mm
PinHeader_1x10_P200mm_Vertical x 2
JST_B2B_PH_K x 2
Dummy XBee PCB
