ajayre/tandemleveller/Electronics/XBee Adapter/XBee Adapter/CAD/XBee Adapter.step

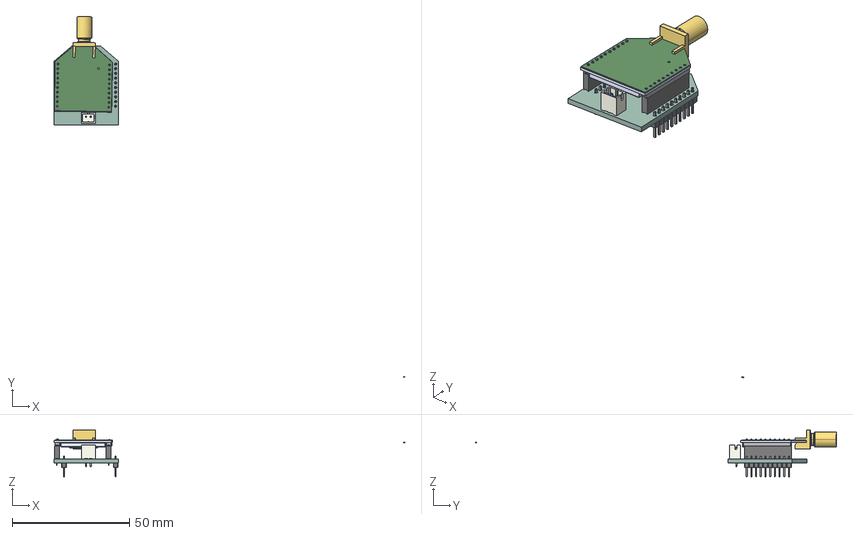
[picture p27: CAD file, 2026-04-21]
Electronics/XBee Adapter/XBee Adapter/CAD/XBee Adapter.step
149.5 x 153.9 x 19.9 mm
JST_B2B_PH_K
PinHeader_1x10_P200mm_Vertical x 2
PinSocket_1x10_P200mm_Vertical x 2
simpleRTK2B_2
XBee Adapter PCB
