ajayre/tandemleveller/CAD/Angle Sensor/Front Scraper/Front Arm.stp

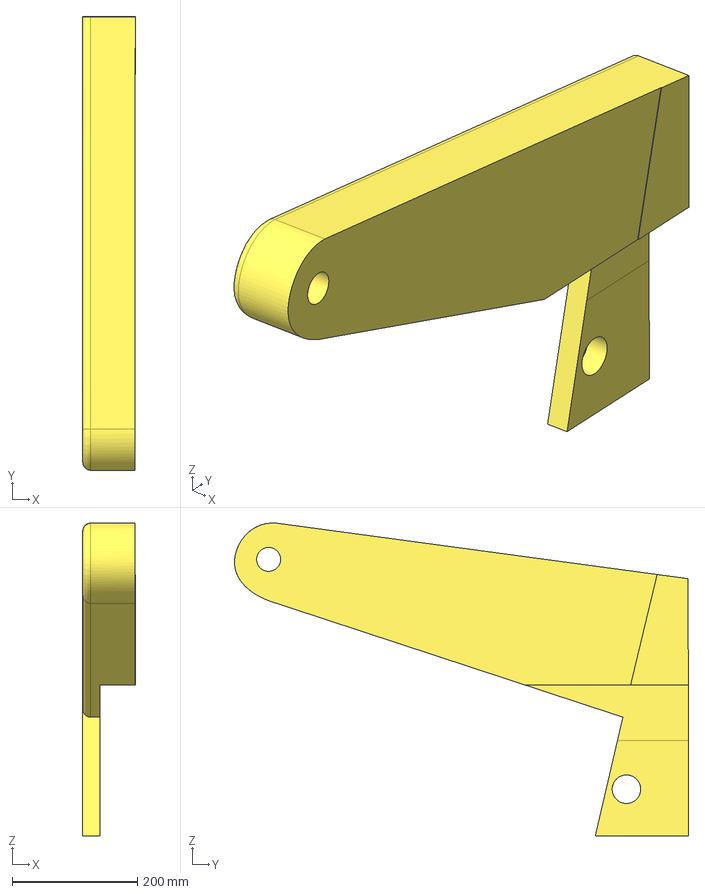
[picture p28: CAD file, 2026-05-11]
CAD/Angle Sensor/Front Scraper/Front Arm.stp
83.7 x 723.7 x 498.9 mm
