ajayre/tandemleveller/CAD/Controller V2/Case V3/FH-M3-8ZC-PennEngineering-3D-04-20-2026.stp

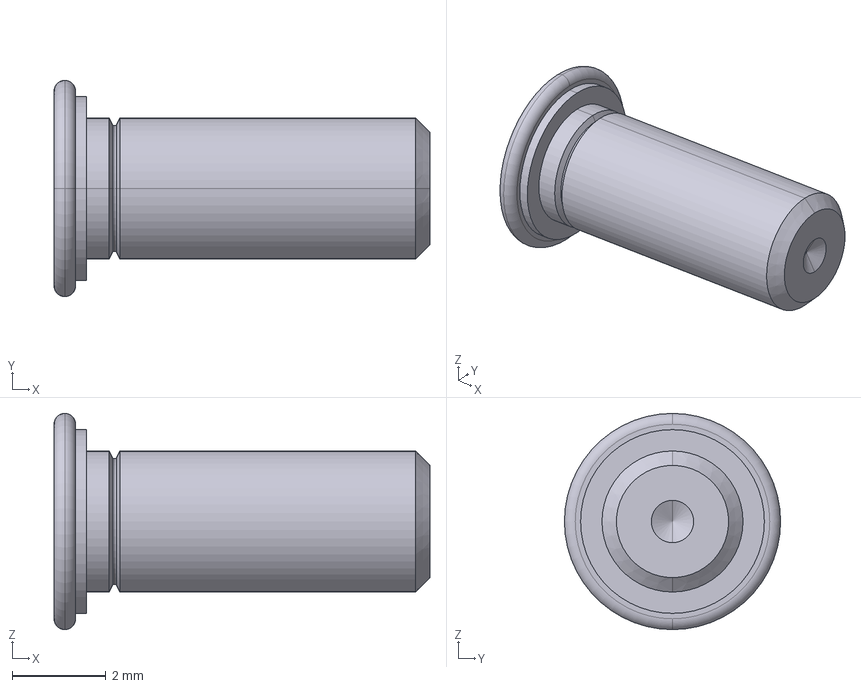
[picture p29: CAD file, 2026-04-22]
CAD/Controller V2/Case V3/FH-M3-8ZC-PennEngineering-3D-04-20-2026.stp
8.00 x 4.60 x 4.60 mm
