ajayre/tandemleveller/CAD/Rover/Simple Case/Case Top.stl

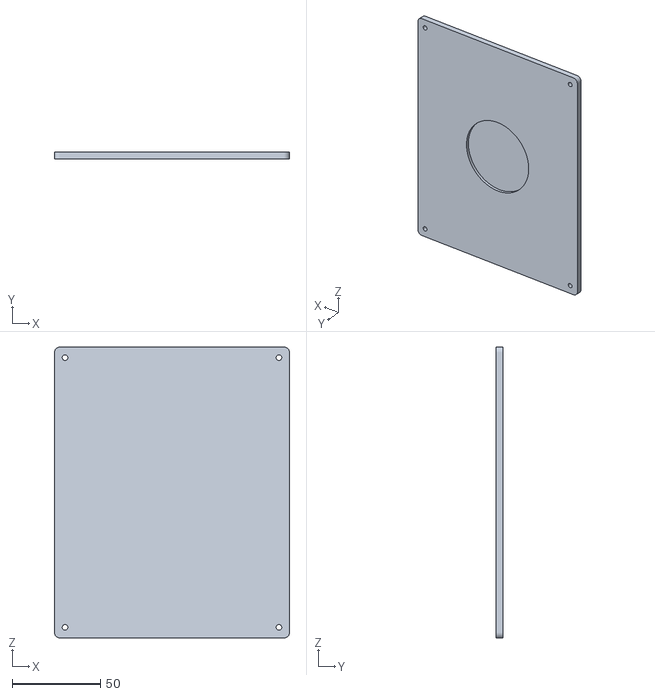
[picture p30: CAD file, 2025-02-11]
CAD/Rover/Simple Case/Case Top.stl
133.3 x 4.00 x 165.0
