ajayre/tandemleveller/CAD/Angle Sensor/Front Scraper/Cylinder.stp

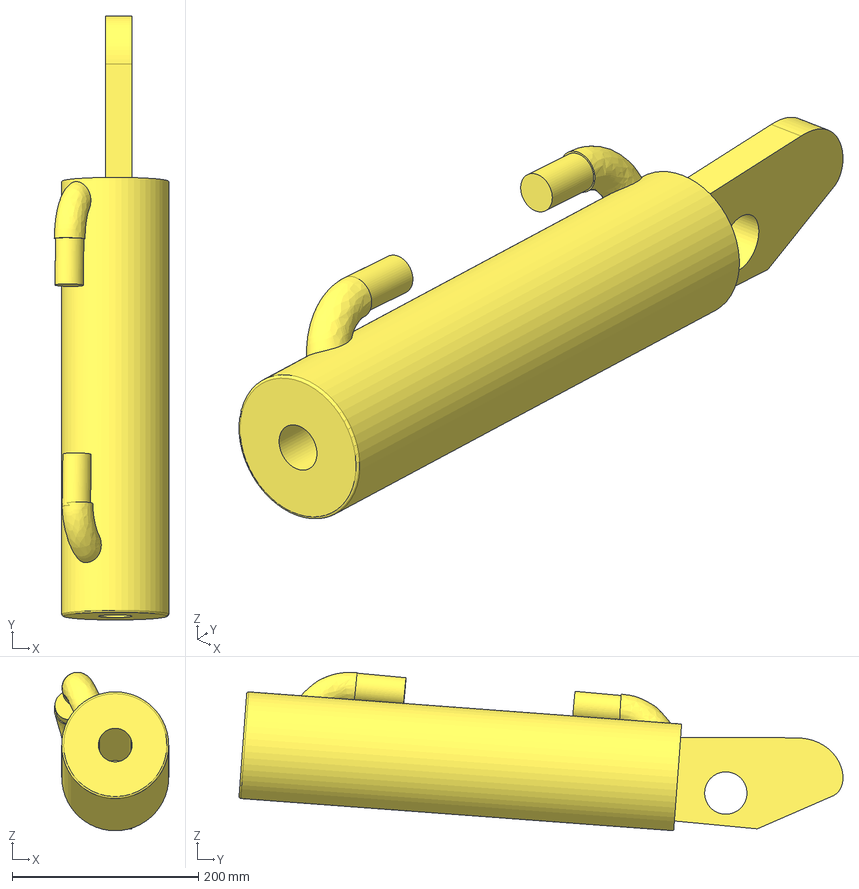
[picture p31: CAD file, 2026-05-11]
CAD/Angle Sensor/Front Scraper/Cylinder.stp
123.0 x 648.6 x 170.2 mm
