ajayre/tandemleveller/CAD/Angle Sensor/Front Scraper/Piston.stp

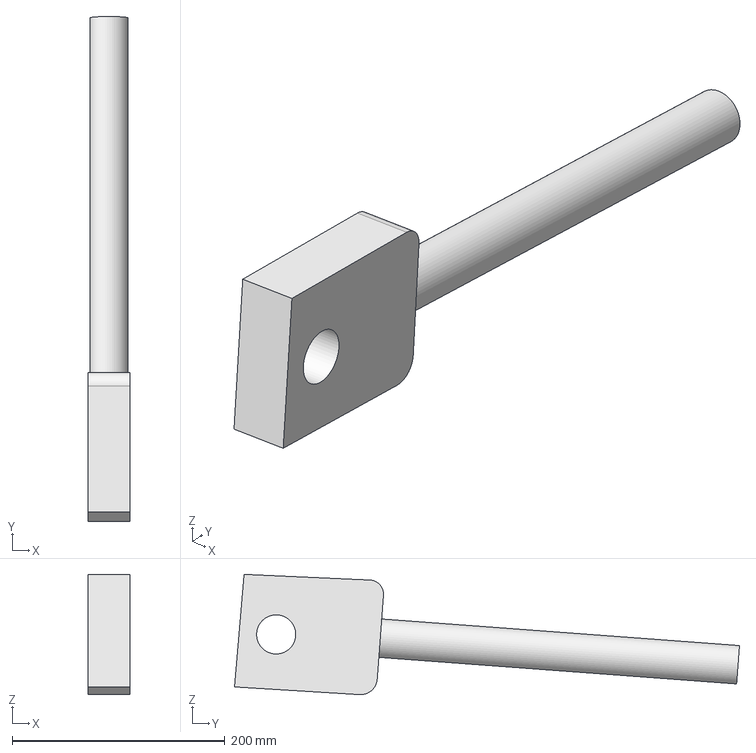
[picture p32: CAD file, 2026-05-11]
CAD/Angle Sensor/Front Scraper/Piston.stp
39.6 x 474.8 x 113.1 mm
