ajayre/tandemleveller/CAD/Angle Sensor/Front Scraper/Rear Arm.stp

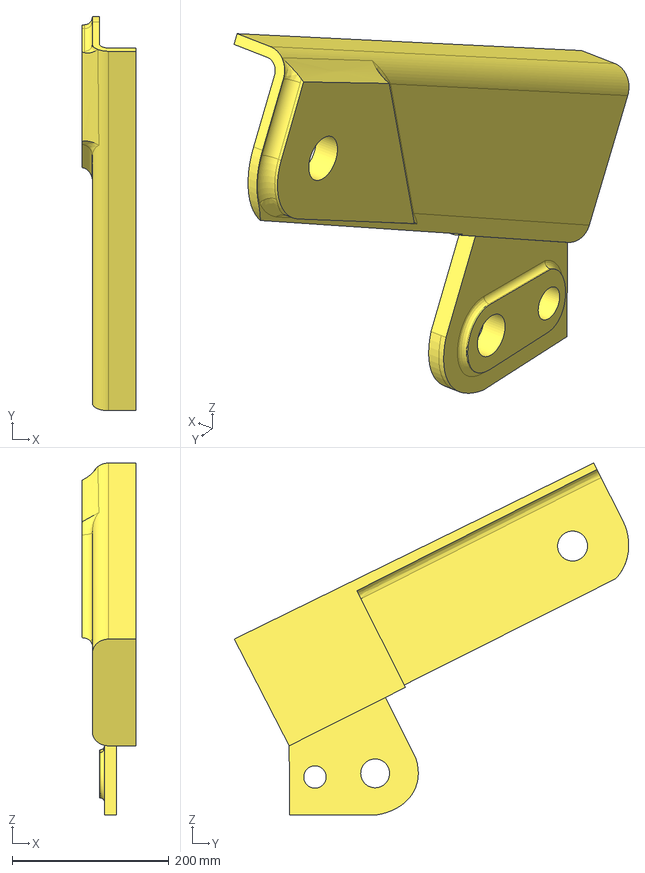
[picture p33: CAD file, 2026-05-11]
CAD/Angle Sensor/Front Scraper/Rear Arm.stp
68.4 x 503.1 x 449.0 mm
