ajayre/tandemleveller/CAD/Angle Sensor/Front Scraper/Hose1.stp

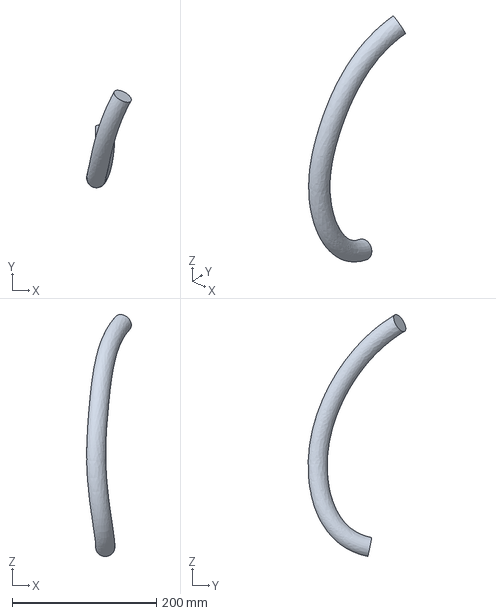
[picture p34: CAD file, 2026-05-11]
CAD/Angle Sensor/Front Scraper/Hose1.stp
62.1 x 135.2 x 335.4 mm
