ajayre/tandemleveller/(list of files, cad)

Other CAD files:
CAD/Angle Sensor/92010A320_Passivated 18-8 Stainless Steel Phillips Flat Head Screw.STEP
CAD/Angle Sensor/92010A540_Passivated 18-8 Stainless Steel Phillips Flat Head Screw.STEP
CAD/Angle Sensor/92620A542_Zinc Yellow-Chromate Plated Hex Head Screw.STEP
CAD/Angle Sensor/94645A210_High-Strength Steel Nylon-Insert Locknut.STEP
CAD/Angle Sensor/Front Scraper/Pivot Bolt.stp
CAD/Base Station/Bracket/Bracket.stl
CAD/Base Station/Dividers/Divider.stl
CAD/Base Station/Support/Support-PLA-Quail.stl
CAD/Controller V2/Case V2/Bottom Panel Front.stl
CAD/Controller V2/Case V2/Bottom Panel Rear.stl
CAD/Controller V2/Case V2/Connector Panel.stl
CAD/Controller V2/Case V2/Front Panel.stl
CAD/Controller V2/Case V2/Rear Panel.stl
CAD/Controller V2/Case V2/Side Panel.stl
CAD/Controller V2/Case V2/Top-AfterBool-Left.stl
CAD/Controller V2/Case V2/Top-AfterBool-Right.stl
CAD/Controller V2/Case V2/Top-AfterBool.3dm
CAD/Controller V2/Case V2/Top-AfterBool.stp
CAD/Controller V2/Case V2/Top.3dm
CAD/Controller/Case/BNC Connector 01 v3.step
CAD/Controller/Case/Connector Panel.stp
CAD/Controller/Case/M BNC.STEP
CAD/Controller/Case/Neutrik 4Pin Panel Mount Female.STEP
