ajayre/tandemleveller/Firmware/Fusion Testing/Sensor_Fusion_Test23_raw_vs_fused_UTM.png

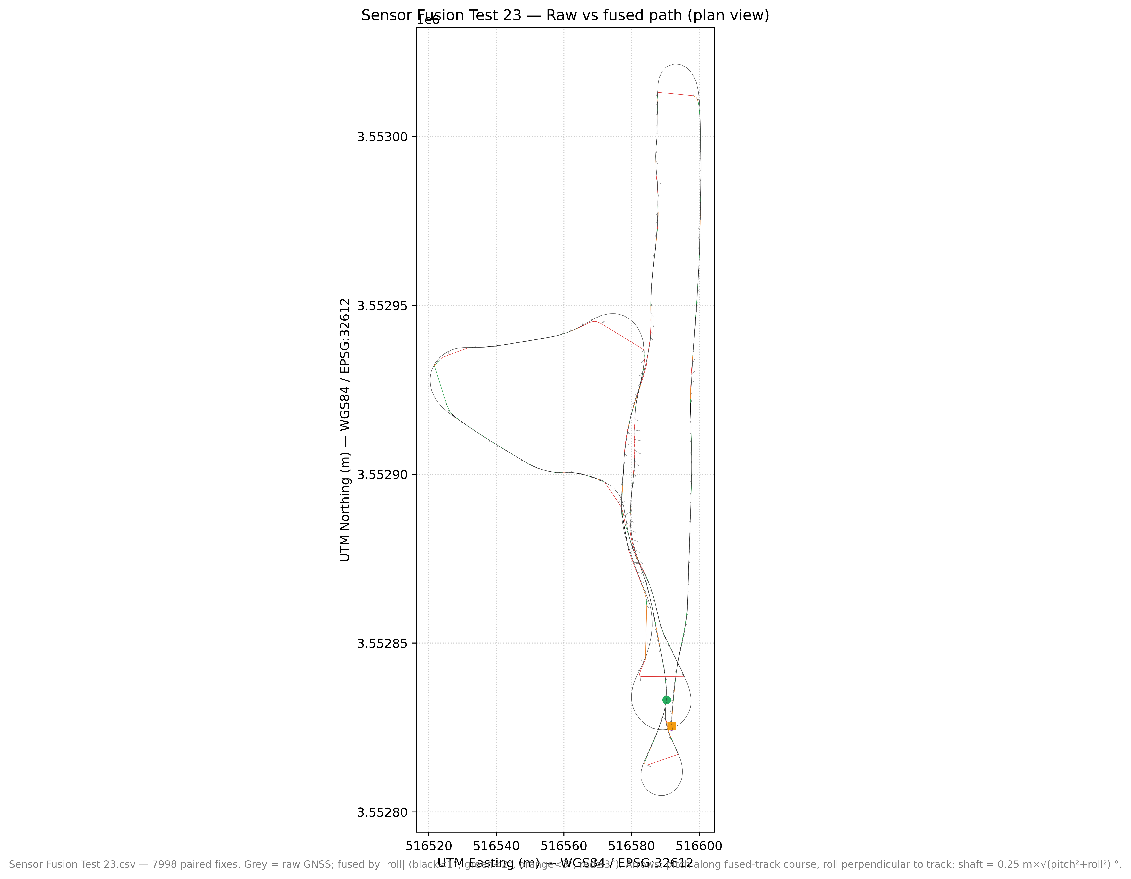
Firmware/Fusion Testing/Sensor_Fusion_Test23_raw_vs_fused_UTM.png
