ajayre/tandemleveller/Firmware/Fusion Testing/Sensor_Fusion_Test23_raw_vs_fused_UTM_zoom_n3552950_e516595.png

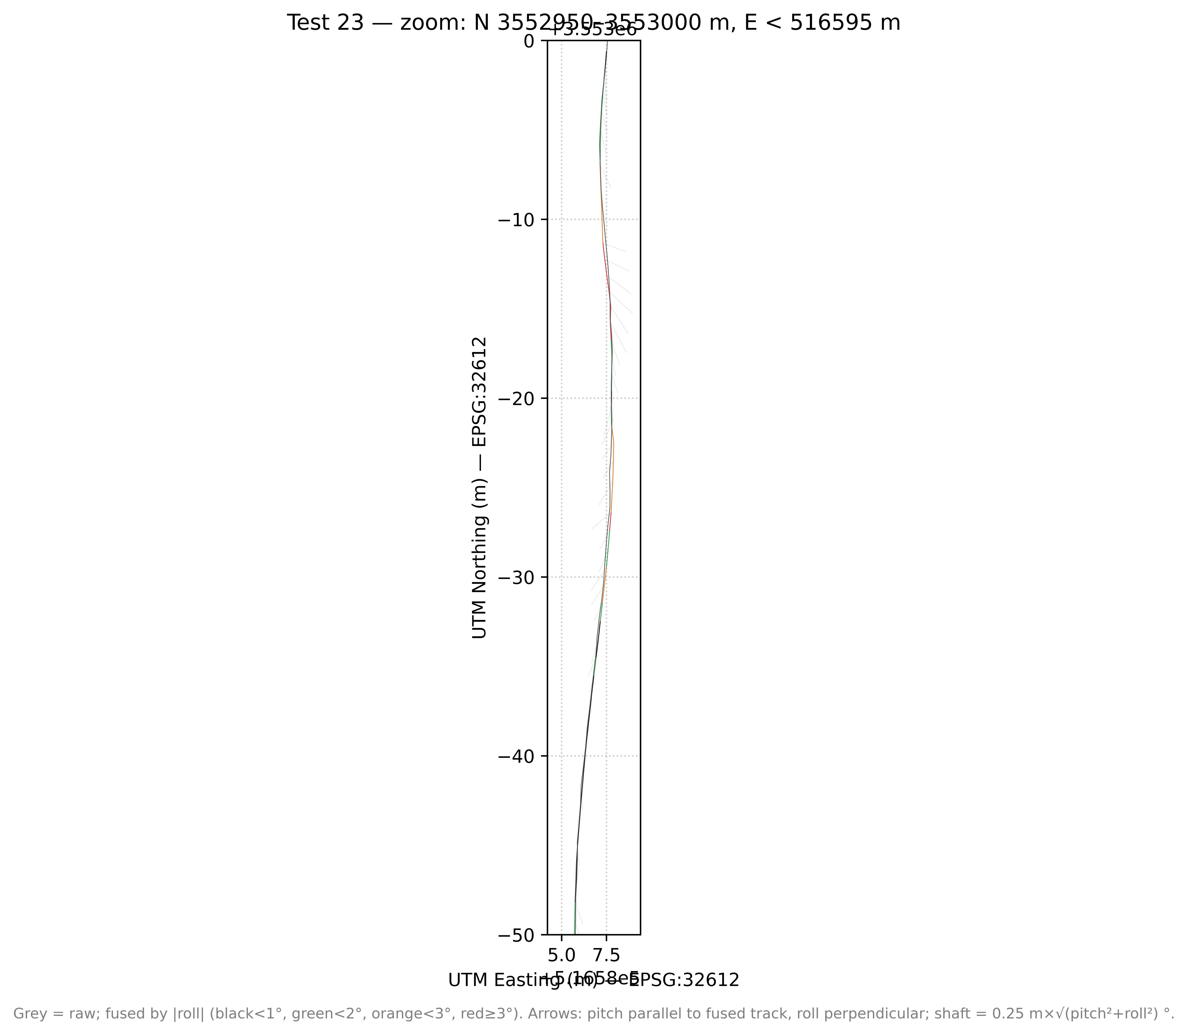
Firmware/Fusion Testing/Sensor_Fusion_Test23_raw_vs_fused_UTM_zoom_n3552950_e516595.png
