ajayre/tandemleveller/Firmware/Fusion Testing/Straight_with_dips_2_raw_vs_fused_UTM_zoom.png

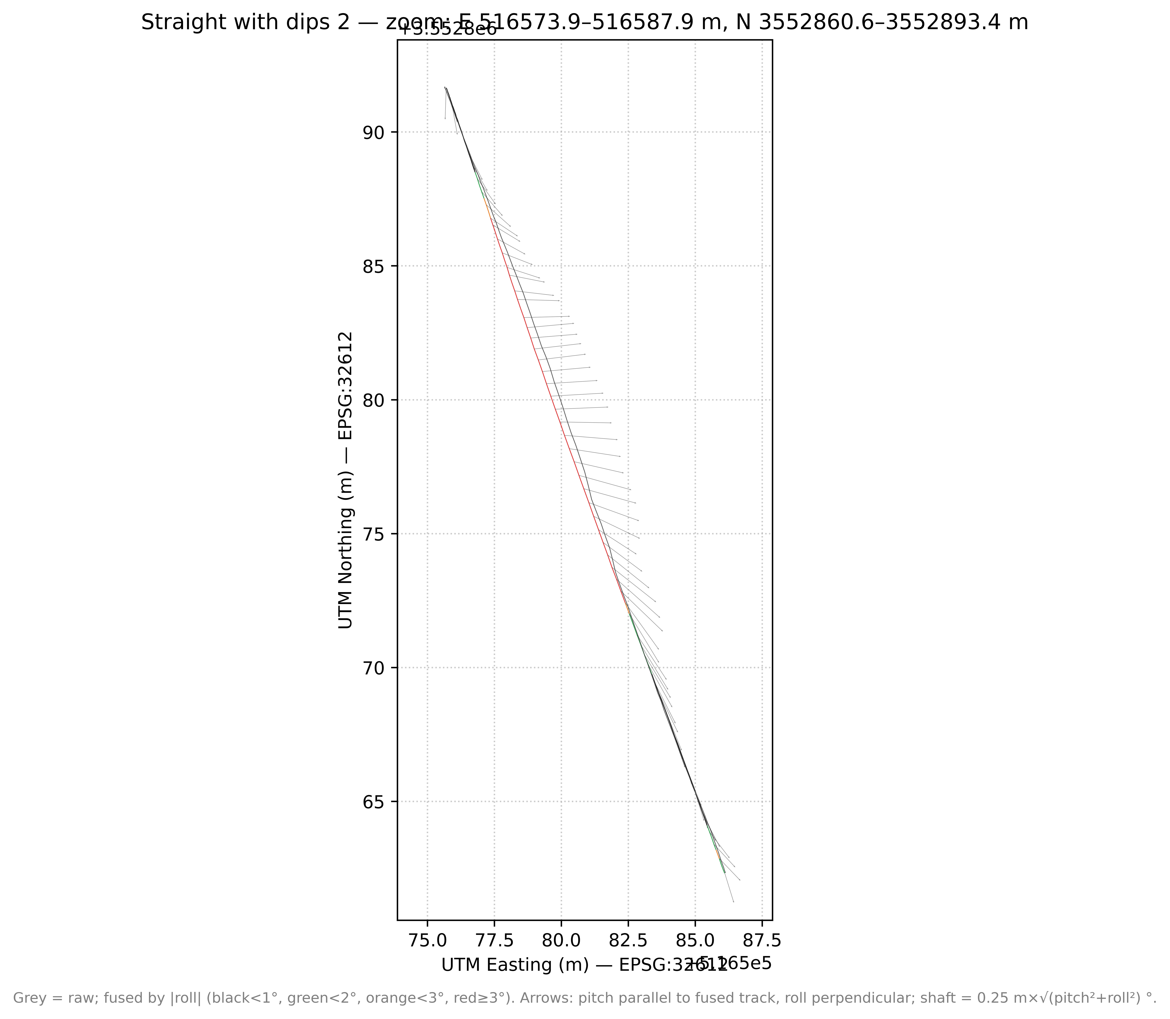
Firmware/Fusion Testing/Straight_with_dips_2_raw_vs_fused_UTM_zoom.png
