ajayre/tandemleveller/Firmware/Fusion Testing/Straight_with_dips_raw_vs_fused_UTM.png

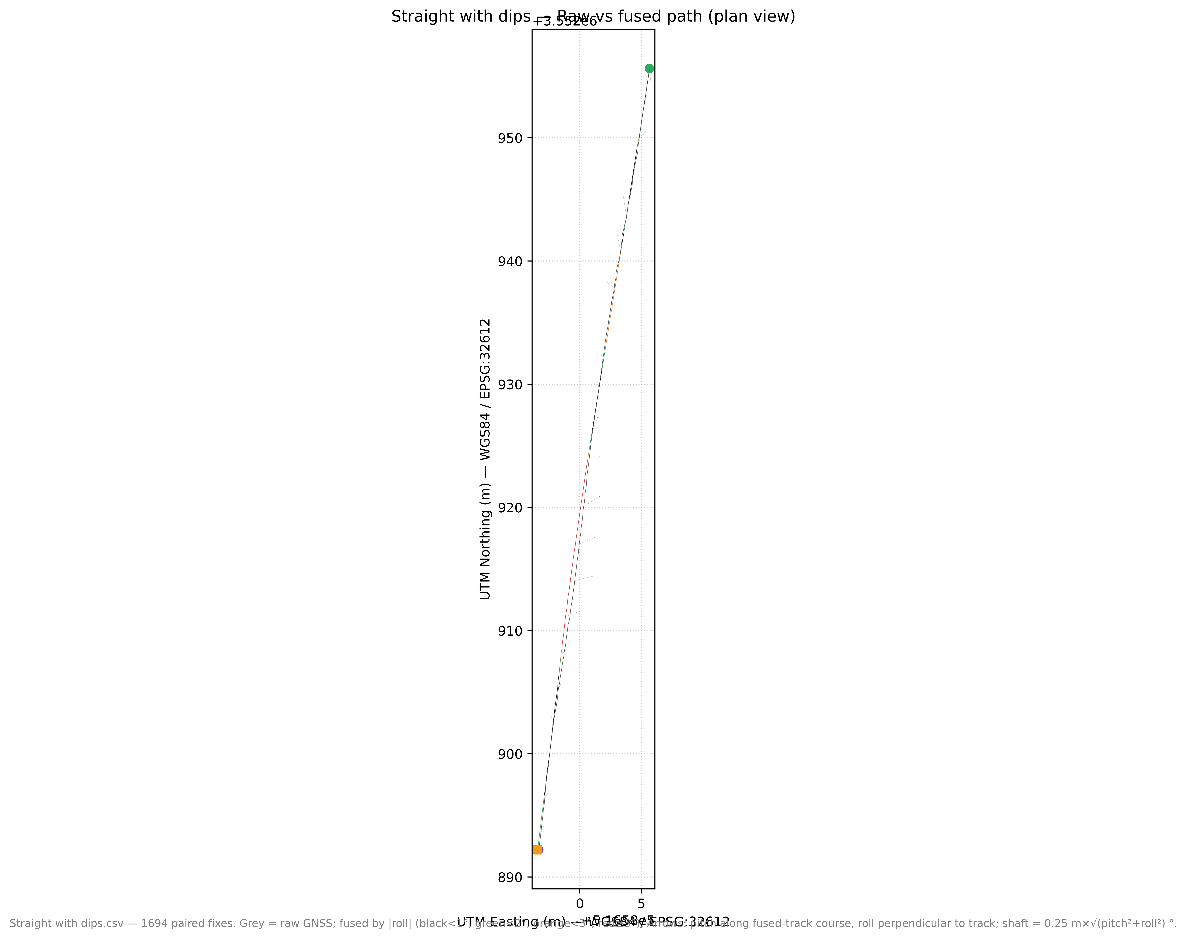
Firmware/Fusion Testing/Straight_with_dips_raw_vs_fused_UTM.png
