ajayre/tandemleveller/Firmware/Fusion Testing/Turns_raw_vs_fused_UTM_zoom.png

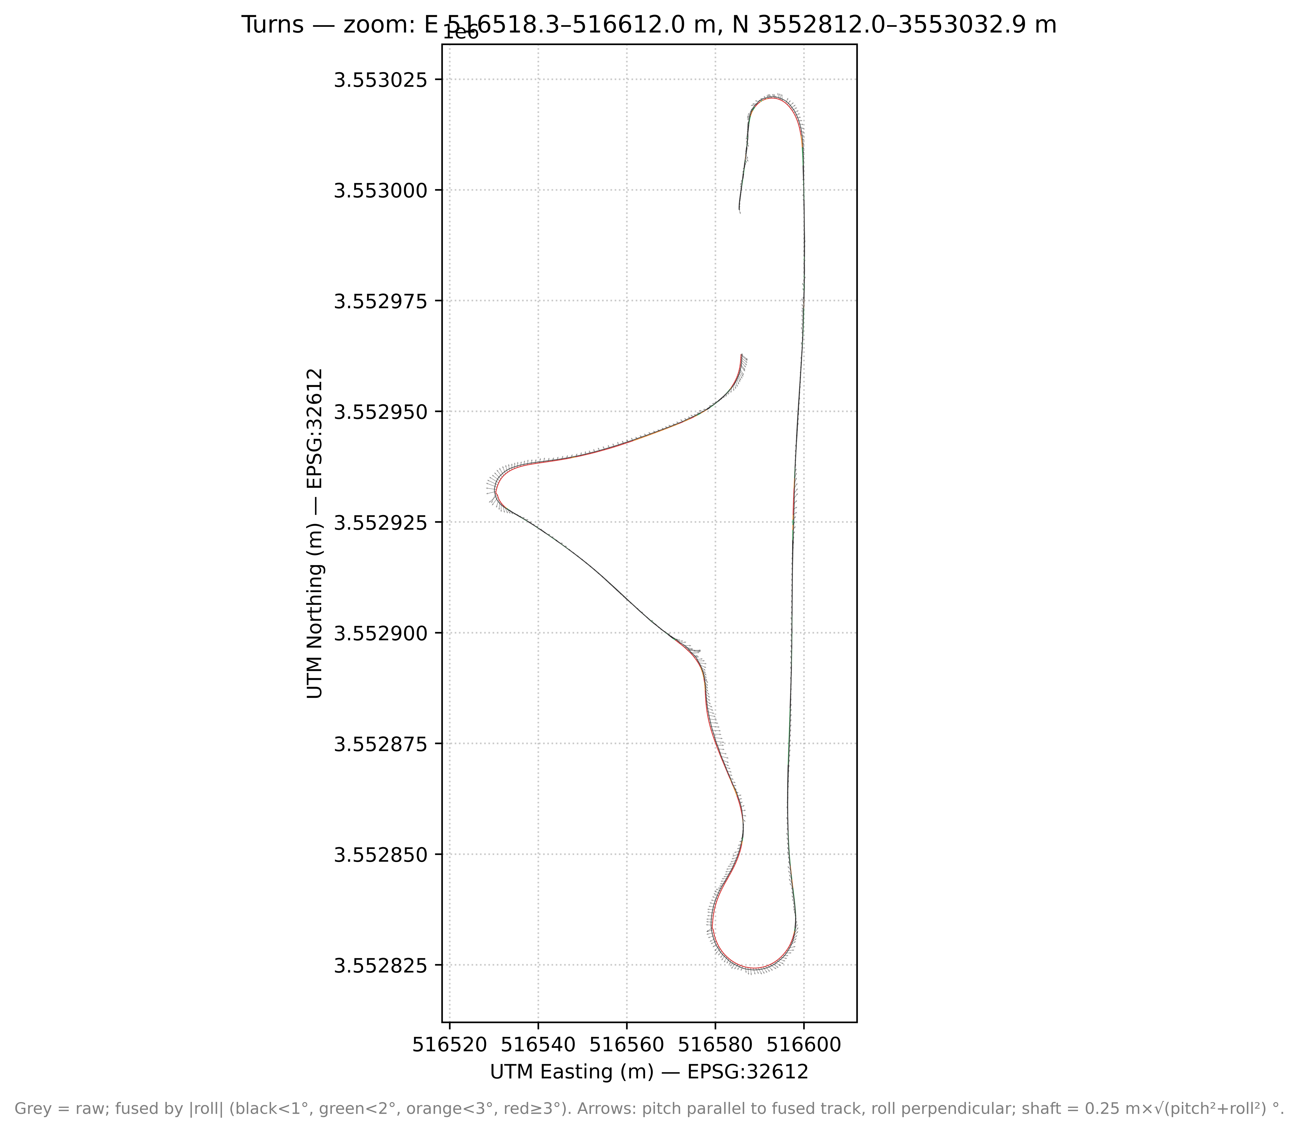
Firmware/Fusion Testing/Turns_raw_vs_fused_UTM_zoom.png
