ajayre/tandemleveller/CAD/Base Station V2/Case.pdf

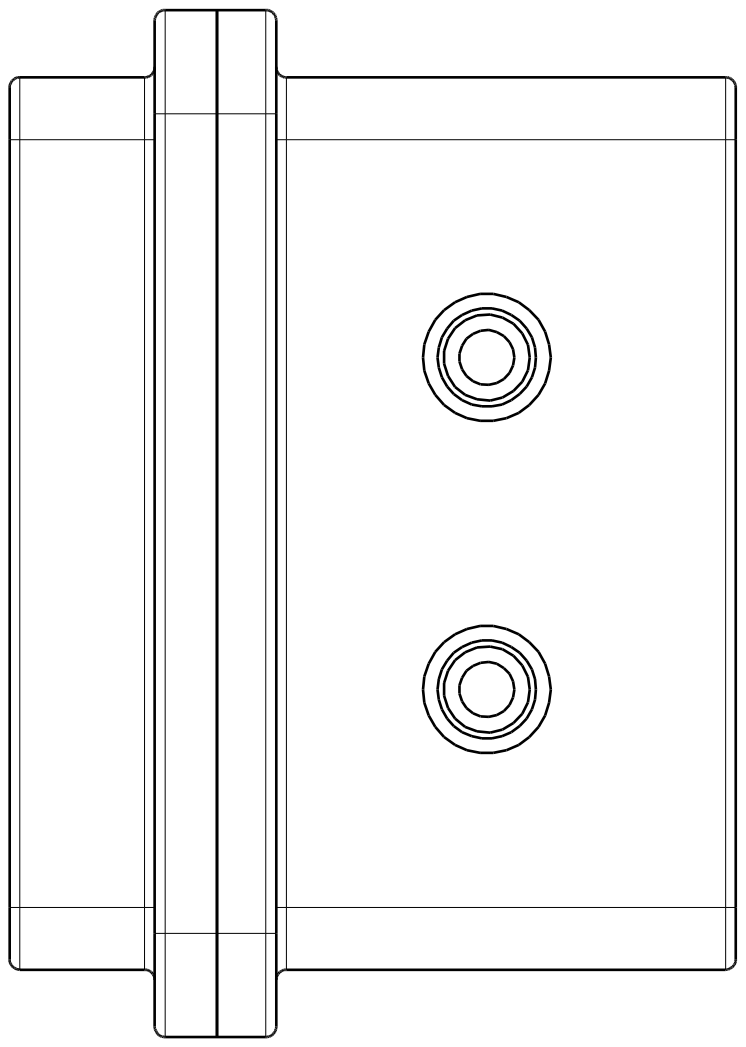
[picture p41: page 1]
