ajayre/tandemleveller/(list of files, drawings)

Other design files:
Electronics/Datasheets/EVQ4242-VE-00B_layout.PcbDoc
Electronics/Datasheets/EVQ4242-VE-00B_schematic.SchDoc
