ajayre/tandemleveller/Electronics/Controller V2/Motherboard/Tandem Leveller Controller V2.kicad_pcb

## KiCad design Electronics/Controller V2/Motherboard/Tandem Leveller Controller V2.kicad_pcb (2026-05-04)

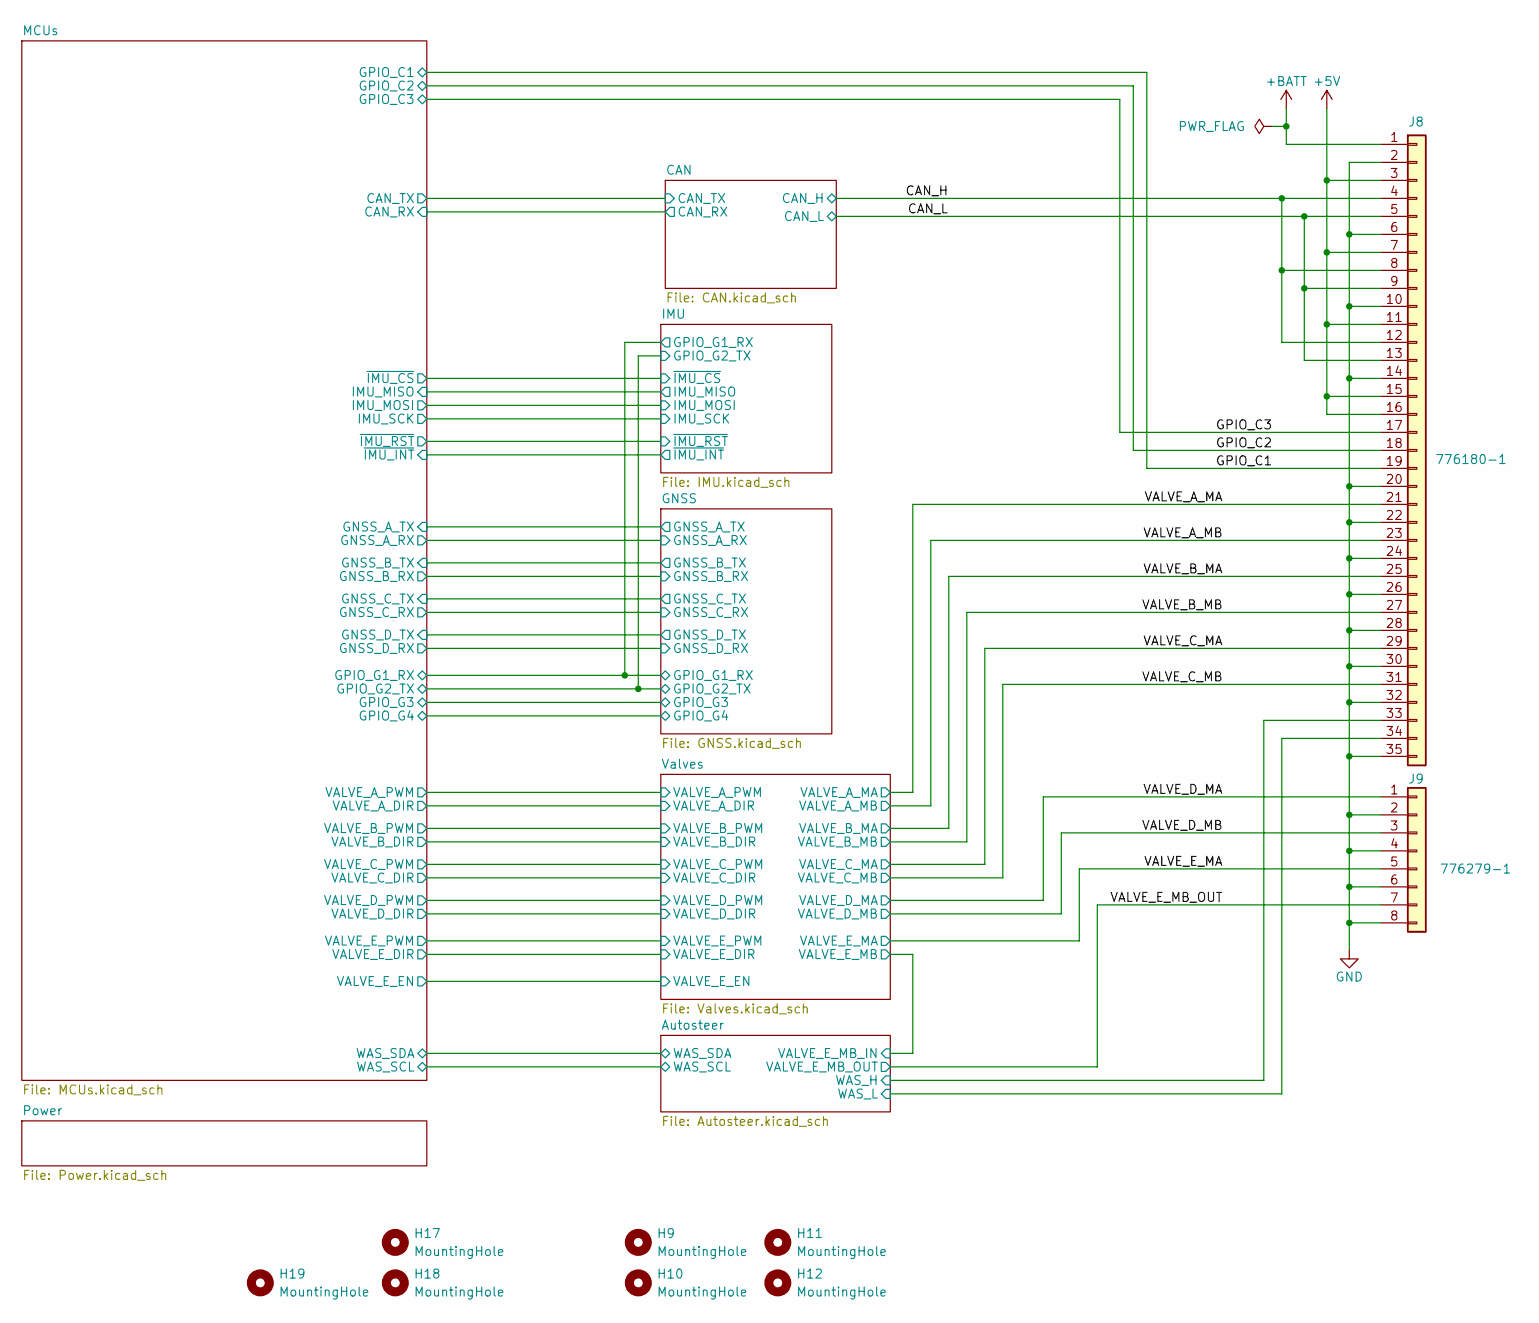
[picture p42: schematic Tandem Leveller Controller V2.kicad_sch, Tandem Leveller Controller]

Parts:
H9, H10, H11, H12, H17, H18, H19: MountingHole; MountingHole_4mm
J8: 776180-1; 776180-1 AMPHENOL AMP 35pos
J9: 776279-1; 776279-1 AMPHENOL AMP 8pos

Connections:
+5V: J8.3, J8.7, J8.11, J8.15, J8.16; also elsewhere on the board
+BATT: J8.1; also elsewhere on the board
/Autosteer/WAS_H: J8.33; also elsewhere on the board
/Autosteer/WAS_L: J8.34; also elsewhere on the board
/CAN_H: J8.4, J8.8, J8.12; also elsewhere on the board
/CAN_L: J8.5, J8.9, J8.13; also elsewhere on the board
/GPIO_C1: J8.19; also elsewhere on the board
/GPIO_C2: J8.18; also elsewhere on the board
/GPIO_C3: J8.17; also elsewhere on the board
/VALVE_A_MA: J8.21; also elsewhere on the board
/VALVE_A_MB: J8.23; also elsewhere on the board
/VALVE_B_MA: J8.25; also elsewhere on the board
/VALVE_B_MB: J8.27; also elsewhere on the board
/VALVE_C_MA: J8.29; also elsewhere on the board
/VALVE_C_MB: J8.31; also elsewhere on the board
/VALVE_D_MA: J9.1; also elsewhere on the board
/VALVE_D_MB: J9.3; also elsewhere on the board
/VALVE_E_MA: J9.5; also elsewhere on the board
/VALVE_E_MB_OUT: J9.7; also elsewhere on the board
GND: J8.2, J8.6, J8.10, J8.14, J8.20, J8.22, J8.24, J8.26, J8.28, J8.30, J8.32, J8.35, J9.2, J9.4, J9.6, J9.8; also elsewhere on the board

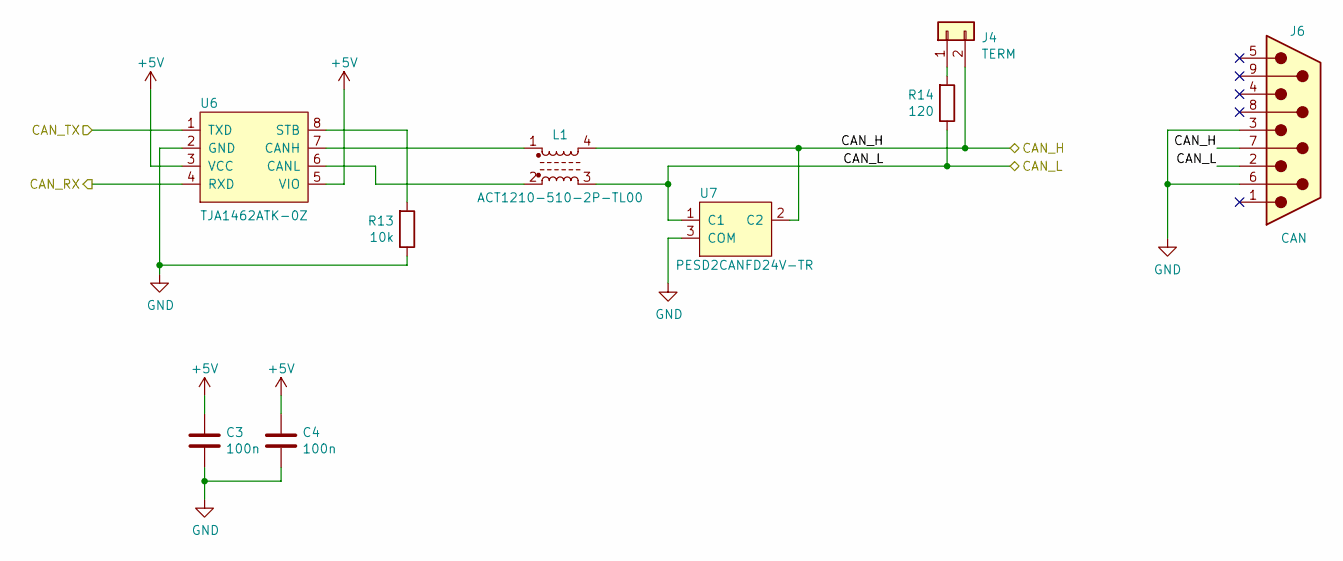
[picture p43: schematic CAN.kicad_sch, Tandem Leveller Controller]

Parts:
C3, C4: 100n; C_0805_2012Metric; LCSC C1711
J4: TERM; PinHeader_1x02_P2.54mm_Vertical; LCSC C7494857
J6: CAN; DSUB-9_Male_Vertical_P2.77x2.84mm
L1: ACT1210-510-2P-TL00; LCSC C95572
R13: 10k; R_0805_2012Metric; LCSC C17414
R14: 120; R_0805_2012Metric; LCSC C17437
U6: TJA1462ATK-0Z; HVSON8_0_65mm; LCSC C3229259
U7: PESD2CANFD24V-TR; SOT-23; LCSC C552486

Connections:
+5V: C3.1, C4.1, U6.3 (VCC), U6.5 (VIO); also elsewhere on the board
/CAN/CAN_RX: U6.4 (RXD); also elsewhere on the board
/CAN/CAN_TX: U6.1 (TXD); also elsewhere on the board
/CAN_H: J4.2, J6.7, L1.4, U7.2 (C2); also elsewhere on the board
/CAN_L: J6.2, L1.3, R14.1, U7.1 (C1); also elsewhere on the board
GND: C3.2, C4.2, J6.3, J6.6, R13.1, U6.2 (GND), U7.3 (COM); also elsewhere on the board
unnamed: J4.1, R14.2
unnamed: L1.1, U6.7 (CANH)
unnamed: L1.2, U6.6 (CANL)
unnamed: R13.2, U6.8 (STB)

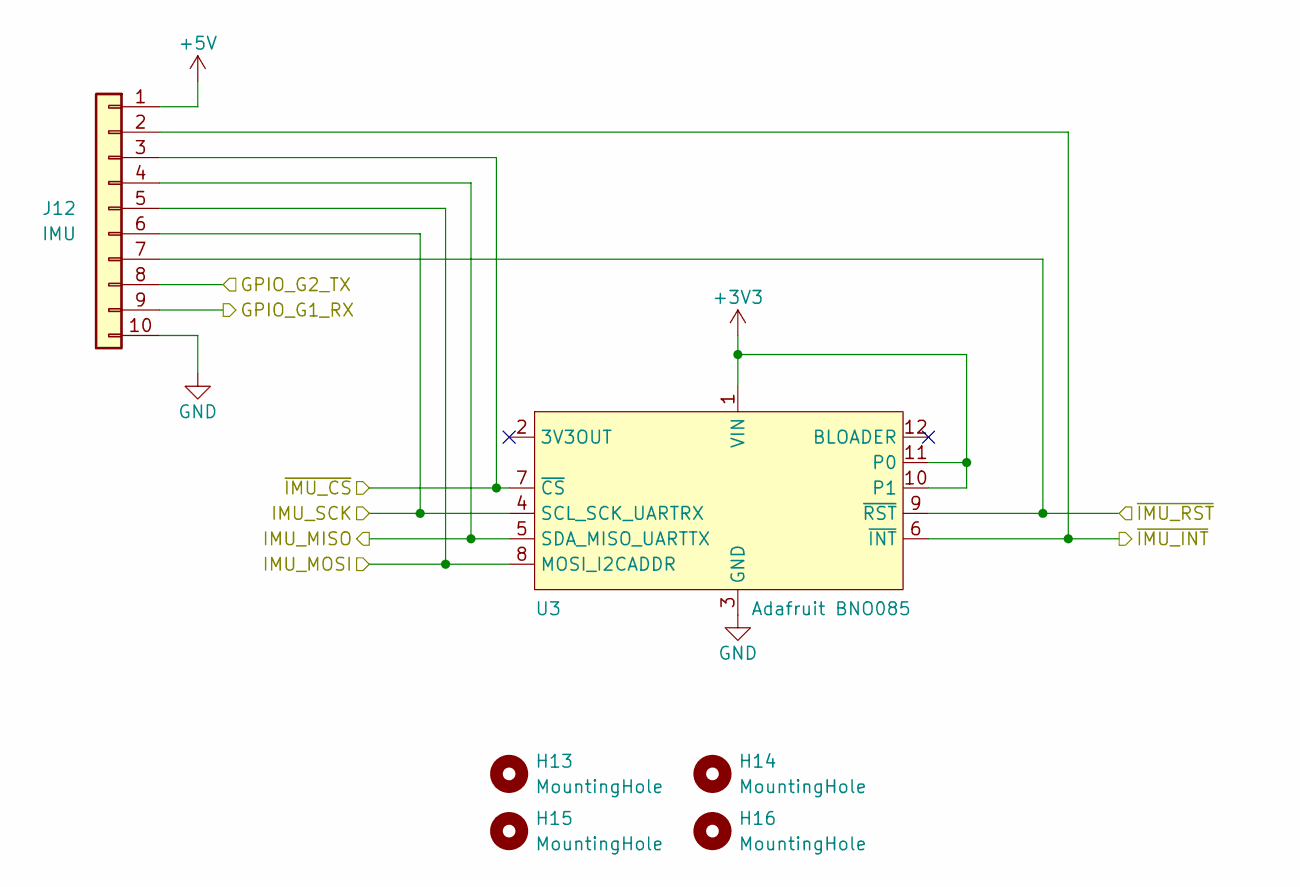
[picture p44: schematic IMU.kicad_sch, Tandem Leveller Controller]

Parts:
H13, H14, H15, H16: MountingHole; MountingHole_3.2mm_M3
J12: IMU; JST_PH_B10B-PH-K_1x10_P2.00mm_Vertical
U3: Adafruit BNO085; Adafruit_BNO085

Connections:
+3V3: U3.1 (VIN), U3.10 (P1), U3.11 (P0); also elsewhere on the board
+5V: J12.1; also elsewhere on the board
/GNSS/GPIO_G1: J12.9; also elsewhere on the board
/GNSS/GPIO_G2: J12.8; also elsewhere on the board
/IMU/IMU_MISO: J12.4, U3.5 (SDA_MISO_UARTTX); also elsewhere on the board
/IMU/IMU_MOSI: J12.5, U3.8 (MOSI_I2CADDR); also elsewhere on the board
/IMU/IMU_SCK: J12.6, U3.4 (SCL_SCK_UARTRX); also elsewhere on the board
/IMU/~IMU_CS: J12.3, U3.7 (~CS); also elsewhere on the board
/IMU/~IMU_INT: J12.2, U3.6 (~INT); also elsewhere on the board
/IMU/~IMU_RST: J12.7, U3.9 (~RST); also elsewhere on the board
GND: J12.10, U3.3 (GND); also elsewhere on the board

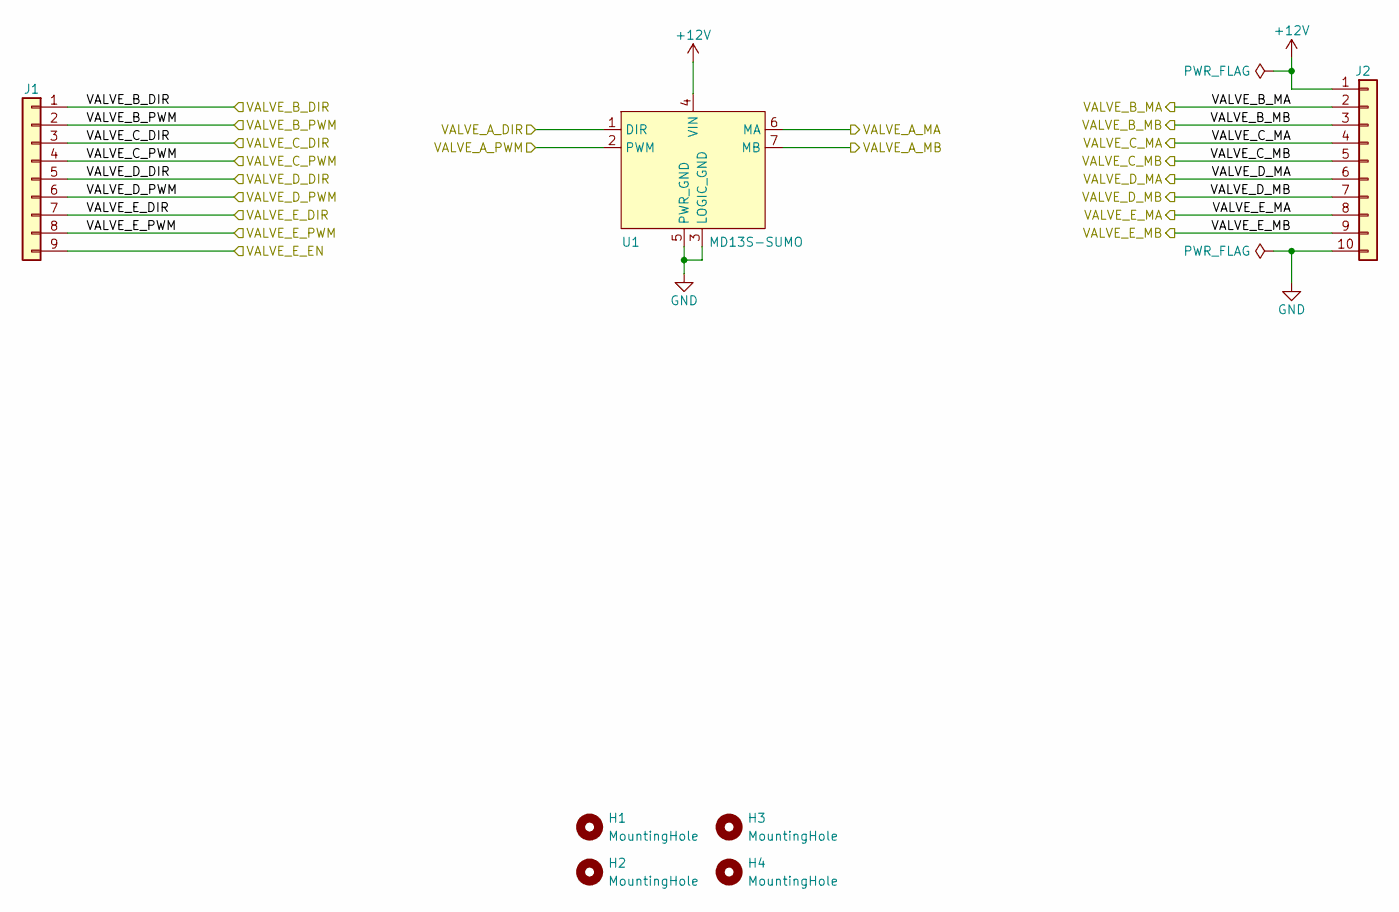
[picture p45: schematic Valves.kicad_sch, Tandem Leveller Controller]

Parts:
H1, H2, H3, H4: MountingHole; MountingHole_6.4mm_M6
J1: Conn_01x08; JST_PH_B9B-PH-K_1x09_P2.00mm_Vertical
J2: Conn_01x10; JST_XH_B10B-XH-A_1x10_P2.50mm_Vertical
U1: MD13S-SUMO

Connections:
+12V: J2.1, U1.4 (VIN); also elsewhere on the board
/MCUs/VALVE_A_DIR: U1.1 (DIR); also elsewhere on the board
/MCUs/VALVE_A_PWM: U1.2 (PWM); also elsewhere on the board
/MCUs/VALVE_E_EN: J1.9; also elsewhere on the board
/VALVE_A_MA: U1.6 (MA); also elsewhere on the board
/VALVE_A_MB: U1.7 (MB); also elsewhere on the board
/VALVE_B_MA: J2.2; also elsewhere on the board
/VALVE_B_MB: J2.3; also elsewhere on the board
/VALVE_C_MA: J2.4; also elsewhere on the board
/VALVE_C_MB: J2.5; also elsewhere on the board
/VALVE_D_MA: J2.6; also elsewhere on the board
/VALVE_D_MB: J2.7; also elsewhere on the board
/VALVE_E_MA: J2.8; also elsewhere on the board
/Valves/VALVE_B_DIR: J1.1; also elsewhere on the board
/Valves/VALVE_B_PWM: J1.2; also elsewhere on the board
/Valves/VALVE_C_DIR: J1.3; also elsewhere on the board
/Valves/VALVE_C_PWM: J1.4; also elsewhere on the board
/Valves/VALVE_D_DIR: J1.5; also elsewhere on the board
/Valves/VALVE_D_PWM: J1.6; also elsewhere on the board
/Valves/VALVE_E_DIR: J1.7; also elsewhere on the board
/Valves/VALVE_E_MB: J2.9; also elsewhere on the board
/Valves/VALVE_E_PWM: J1.8; also elsewhere on the board
GND: J2.10, U1.3 (LOGIC_GND), U1.5 (PWR_GND); also elsewhere on the board

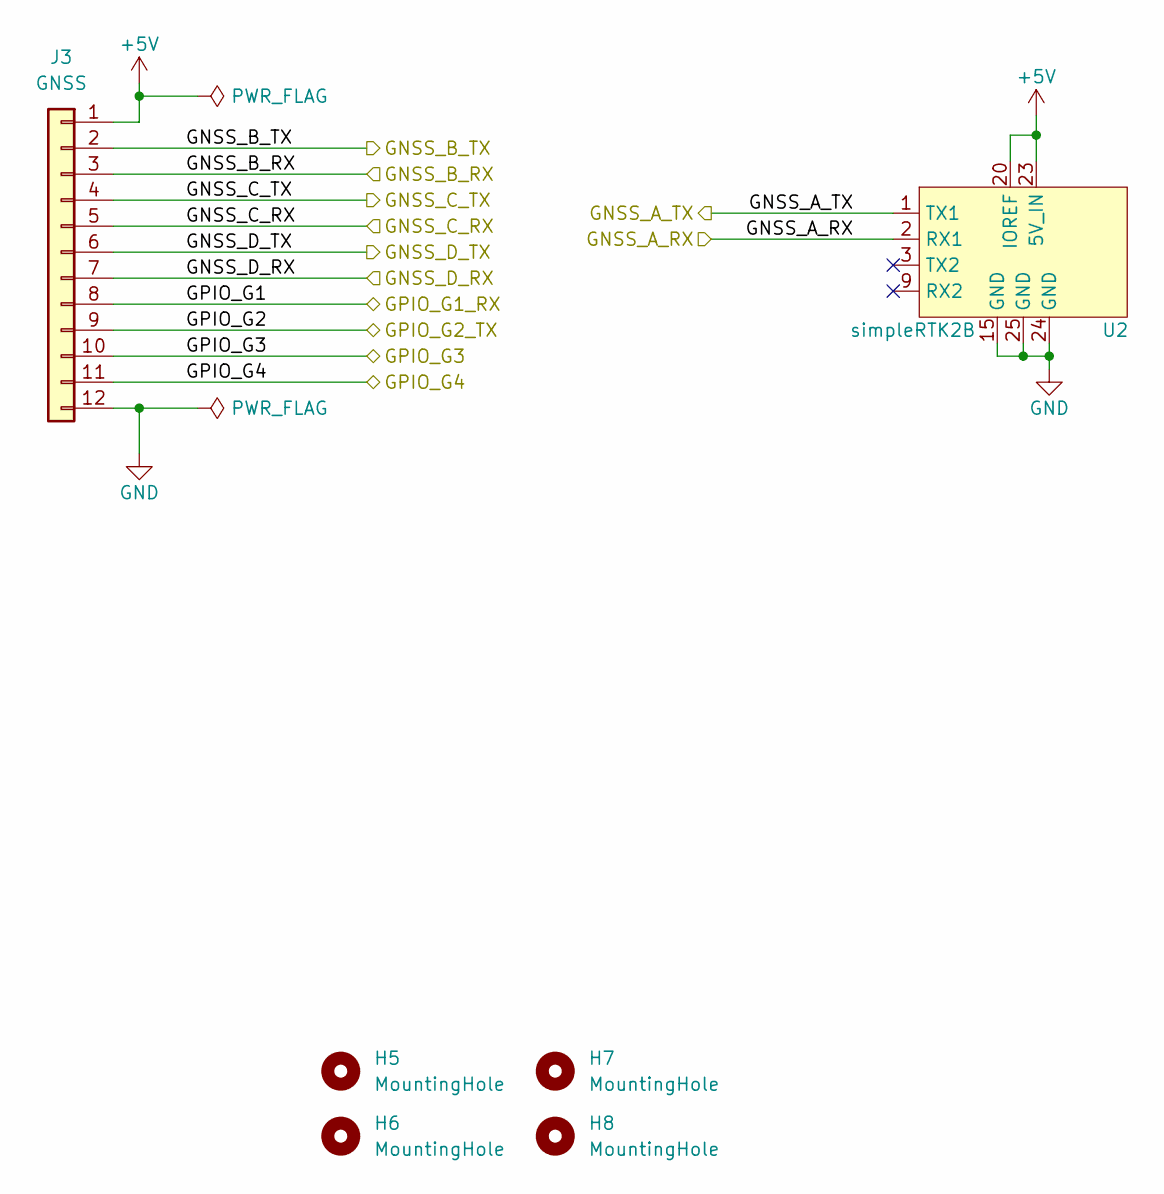
[picture p46: schematic GNSS.kicad_sch, Tandem Leveller Controller]

Parts:
H5, H6, H7, H8: MountingHole; MountingHole_6.4mm_M6
J3: GNSS; JST_PH_B12B-PH-K_1x12_P2.00mm_Vertical
U2: simpleRTK2B

Connections:
+5V: J3.1, U2.20 (IOREF), U2.23 (5V_IN); also elsewhere on the board
/GNSS/GNSS_A_RX: U2.2 (RX1); also elsewhere on the board
/GNSS/GNSS_A_TX: U2.1 (TX1); also elsewhere on the board
/GNSS/GNSS_B_RX: J3.3; also elsewhere on the board
/GNSS/GNSS_B_TX: J3.2; also elsewhere on the board
/GNSS/GNSS_C_RX: J3.5; also elsewhere on the board
/GNSS/GNSS_C_TX: J3.4; also elsewhere on the board
/GNSS/GNSS_D_RX: J3.7; also elsewhere on the board
/GNSS/GNSS_D_TX: J3.6; also elsewhere on the board
/GNSS/GPIO_G1: J3.8; also elsewhere on the board
/GNSS/GPIO_G2: J3.9; also elsewhere on the board
/GNSS/GPIO_G3: J3.10; also elsewhere on the board
/GNSS/GPIO_G4: J3.11; also elsewhere on the board
GND: J3.12, U2.15 (GND), U2.24 (GND), U2.25 (GND); also elsewhere on the board

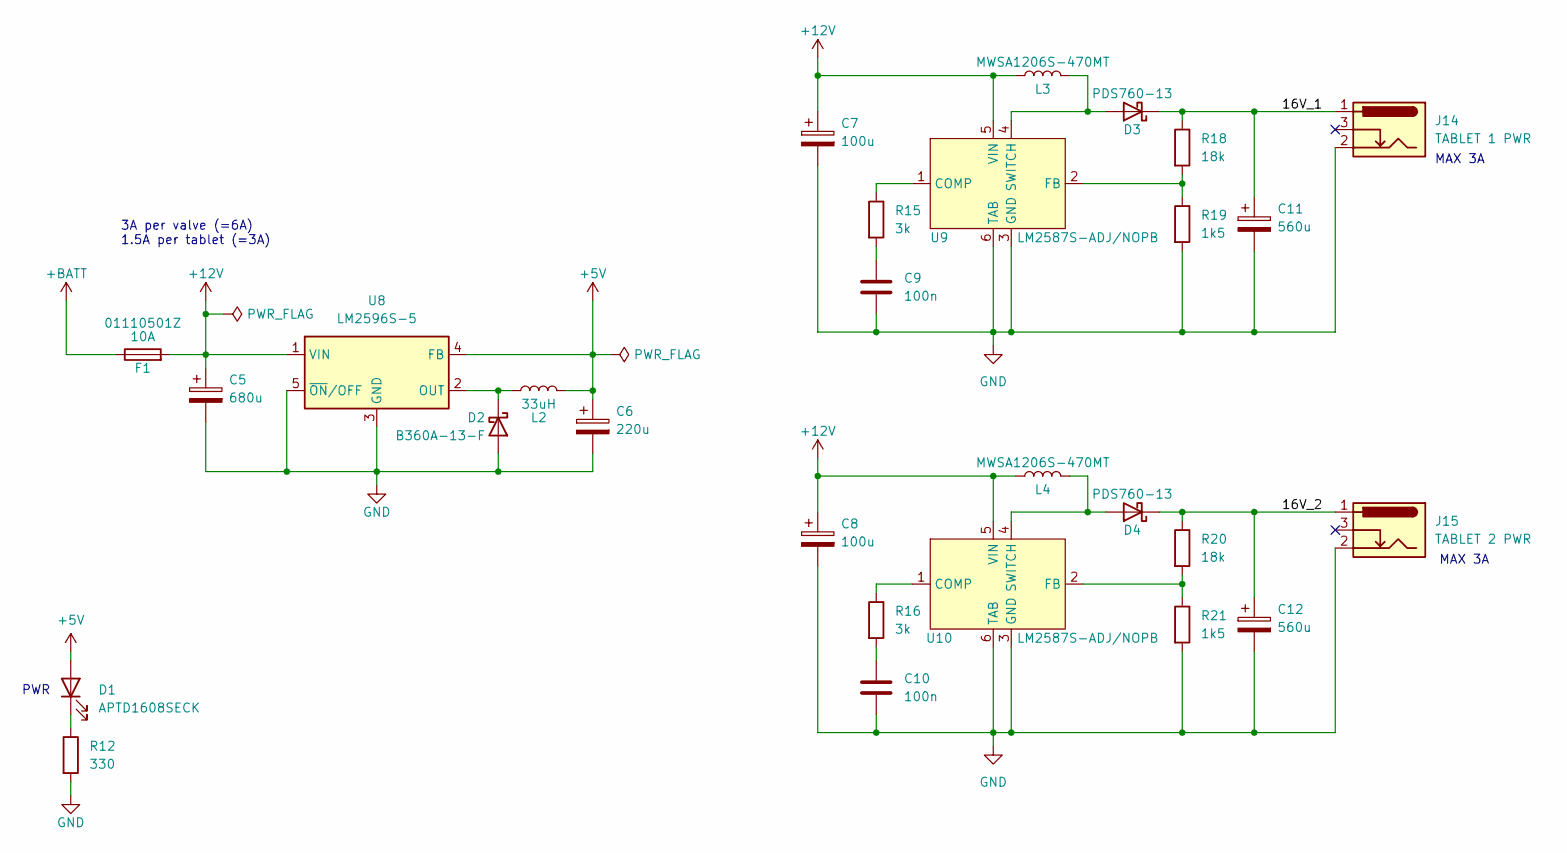
[picture p47: schematic Power.kicad_sch, Tandem Leveller Controller]

Parts:
C5: 680u; CP_Elec_10x10.5; LCSC C50456
C6: 220u; CP_Elec_8x6.5; LCSC C3340
C7, C8: 100u; CP_Elec_6.3x5.9; LCSC C340733
C9, C10: 100n; C_0805_2012Metric; LCSC C1711
C11, C12: 560u; CP_Elec_10x10.5; LCSC C1984785
D1: APTD1608SECK; D_0603_1608Metric; LCSC C5879220
D2: B360A-13-F; D_SMA; LCSC C6807778
D3, D4: PDS760-13; D_PowerDI-5; LCSC C3018534
F1: 10A; 5x20 Fuse Holder; LCSC C151075
J14: TABLET 1 PWR; BarrelJack_Wuerth_6941xx301002; LCSC C5441017
J15: TABLET 2 PWR; BarrelJack_Wuerth_6941xx301002; LCSC C5441017
L2: 33uH; MWSA0603S-330MT; LCSC C408454
L3, L4: MWSA1206S-470MT; LCSC C408531
R12: 330; R_0805_2012Metric; LCSC C17630
R15, R16: 3k; R_0805_2012Metric; LCSC C17661
R18, R20: 18k; R_0805_2012Metric; LCSC C17506
R19, R21: 1k5; R_0805_2012Metric; LCSC C4310
U8: LM2596S-5; TO-263-5_TabPin3; LCSC C5276750
U9, U10: LM2587S-ADJ/NOPB; TO-263-5_TabPin6; LCSC C1355343

Connections:
+5V: C6.1, D1.2 (A), L2.2, U8.4 (FB); also elsewhere on the board
+12V: C5.1, C7.1, C8.1, F1.2, L3.1, L4.1, U8.1 (VIN), U9.5 (VIN), U10.5 (VIN); also elsewhere on the board
+BATT: F1.1; also elsewhere on the board
/Power/16V_1: C11.1, D3.1 (K), J14.1, R18.1
/Power/16V_2: C12.1, D4.1 (K), J15.1, R20.1
GND: C5.2, C6.2, C7.2, C8.2, C9.2, C10.2, C11.2, C12.2, D2.2 (A), J14.2, J15.2, R12.2, R19.2, R21.2, U8.3 (GND), U8.5 (~ON/OFF), U9.3 (GND), U9.6 (TAB), U10.3 (GND), U10.6 (TAB); also elsewhere on the board
unnamed: C9.1, R15.2
unnamed: C10.1, R16.2
unnamed: D1.1 (K), R12.1
unnamed: D2.1 (K), L2.1, U8.2 (OUT)
unnamed: D3.2 (A), L3.2, U9.4 (SWITCH)
unnamed: D4.2 (A), L4.2, U10.4 (SWITCH)
unnamed: R15.1, U9.1 (COMP)
unnamed: R18.2, R19.1, U9.2 (FB)
unnamed: R16.1, U10.1 (COMP)
unnamed: R20.2, R21.1, U10.2 (FB)

Notes on the sheet:
PWR
3A per valve (=6A) 1.5A per tablet (=3A)
MAX 3A

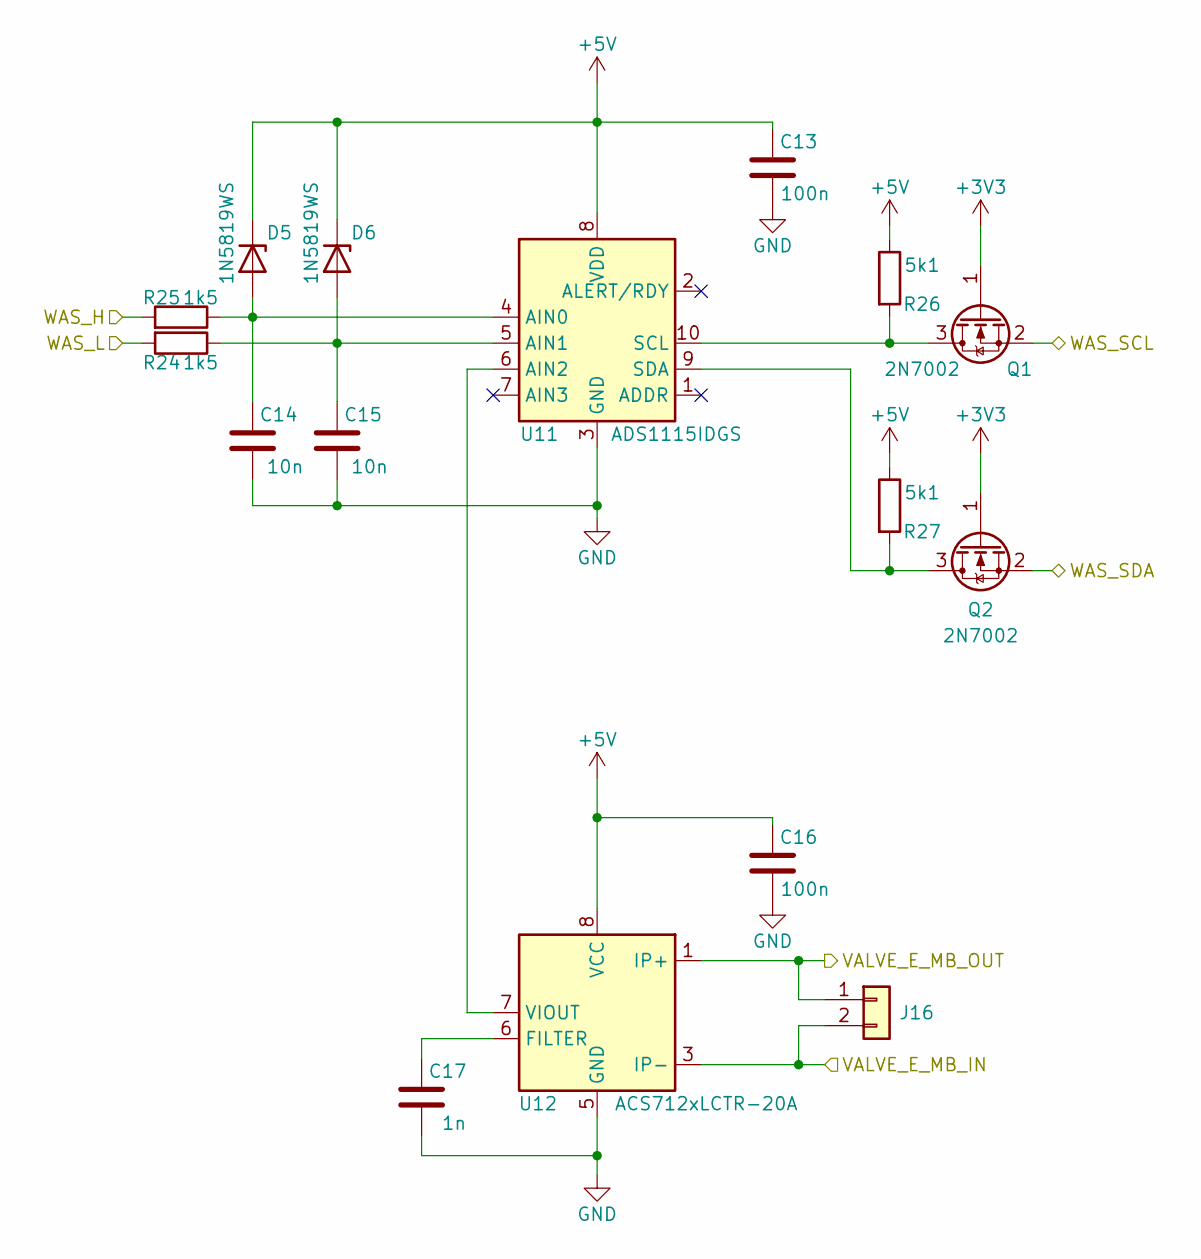
[picture p48: schematic Autosteer.kicad_sch, Tandem Leveller Controller]

Parts:
C13, C16: 100n; C_0805_2012Metric; LCSC C1711
C14, C15: 10n; C_0805_2012Metric
C17: 1n; C_0805_2012Metric
D5, D6: 1N5819WS; D_SOD-323; LCSC C191023
J16: PinHeader_1x02_P2.54mm_Vertical; LCSC C7494857
Q1, Q2: 2N7002; SOT-23
R24, R25: 1k5; R_0805_2012Metric
R26, R27: 5k1; R_0805_2012Metric
U11: ADS1115IDGS; TSSOP-10_3x3mm_P0.5mm
U12: ACS712xLCTR-20A; SOIC-8_3.9x4.9mm_P1.27mm

Connections:
+3V3: Q1.1 (G), Q2.1 (G); also elsewhere on the board
+5V: C13.2, C16.2, D5.1 (K), D6.1 (K), R26.1, R27.1, U11.8 (VDD), U12.8 (VCC); also elsewhere on the board
/Autosteer/WAS_H: R25.2; also elsewhere on the board
/Autosteer/WAS_L: R24.2; also elsewhere on the board
/Autosteer/WAS_SCL: Q1.2 (S); also elsewhere on the board
/Autosteer/WAS_SDA: Q2.2 (S); also elsewhere on the board
/VALVE_E_MB_OUT: J16.1, U12.1 (IP+), U12.2 (IP+); also elsewhere on the board
/Valves/VALVE_E_MB: J16.2, U12.3 (IP-), U12.4 (IP-); also elsewhere on the board
GND: C13.1, C14.1, C15.1, C16.1, C17.1, U11.3 (GND), U12.5 (GND); also elsewhere on the board
unnamed: C14.2, D5.2 (A), R25.1, U11.4 (AIN0)
unnamed: C15.2, D6.2 (A), R24.1, U11.5 (AIN1)
unnamed: Q1.3 (D), R26.2, U11.10 (SCL)
unnamed: Q2.3 (D), R27.2, U11.9 (SDA)
unnamed: U11.6 (AIN2), U12.7 (VIOUT)
unnamed: C17.2, U12.6 (FILTER)

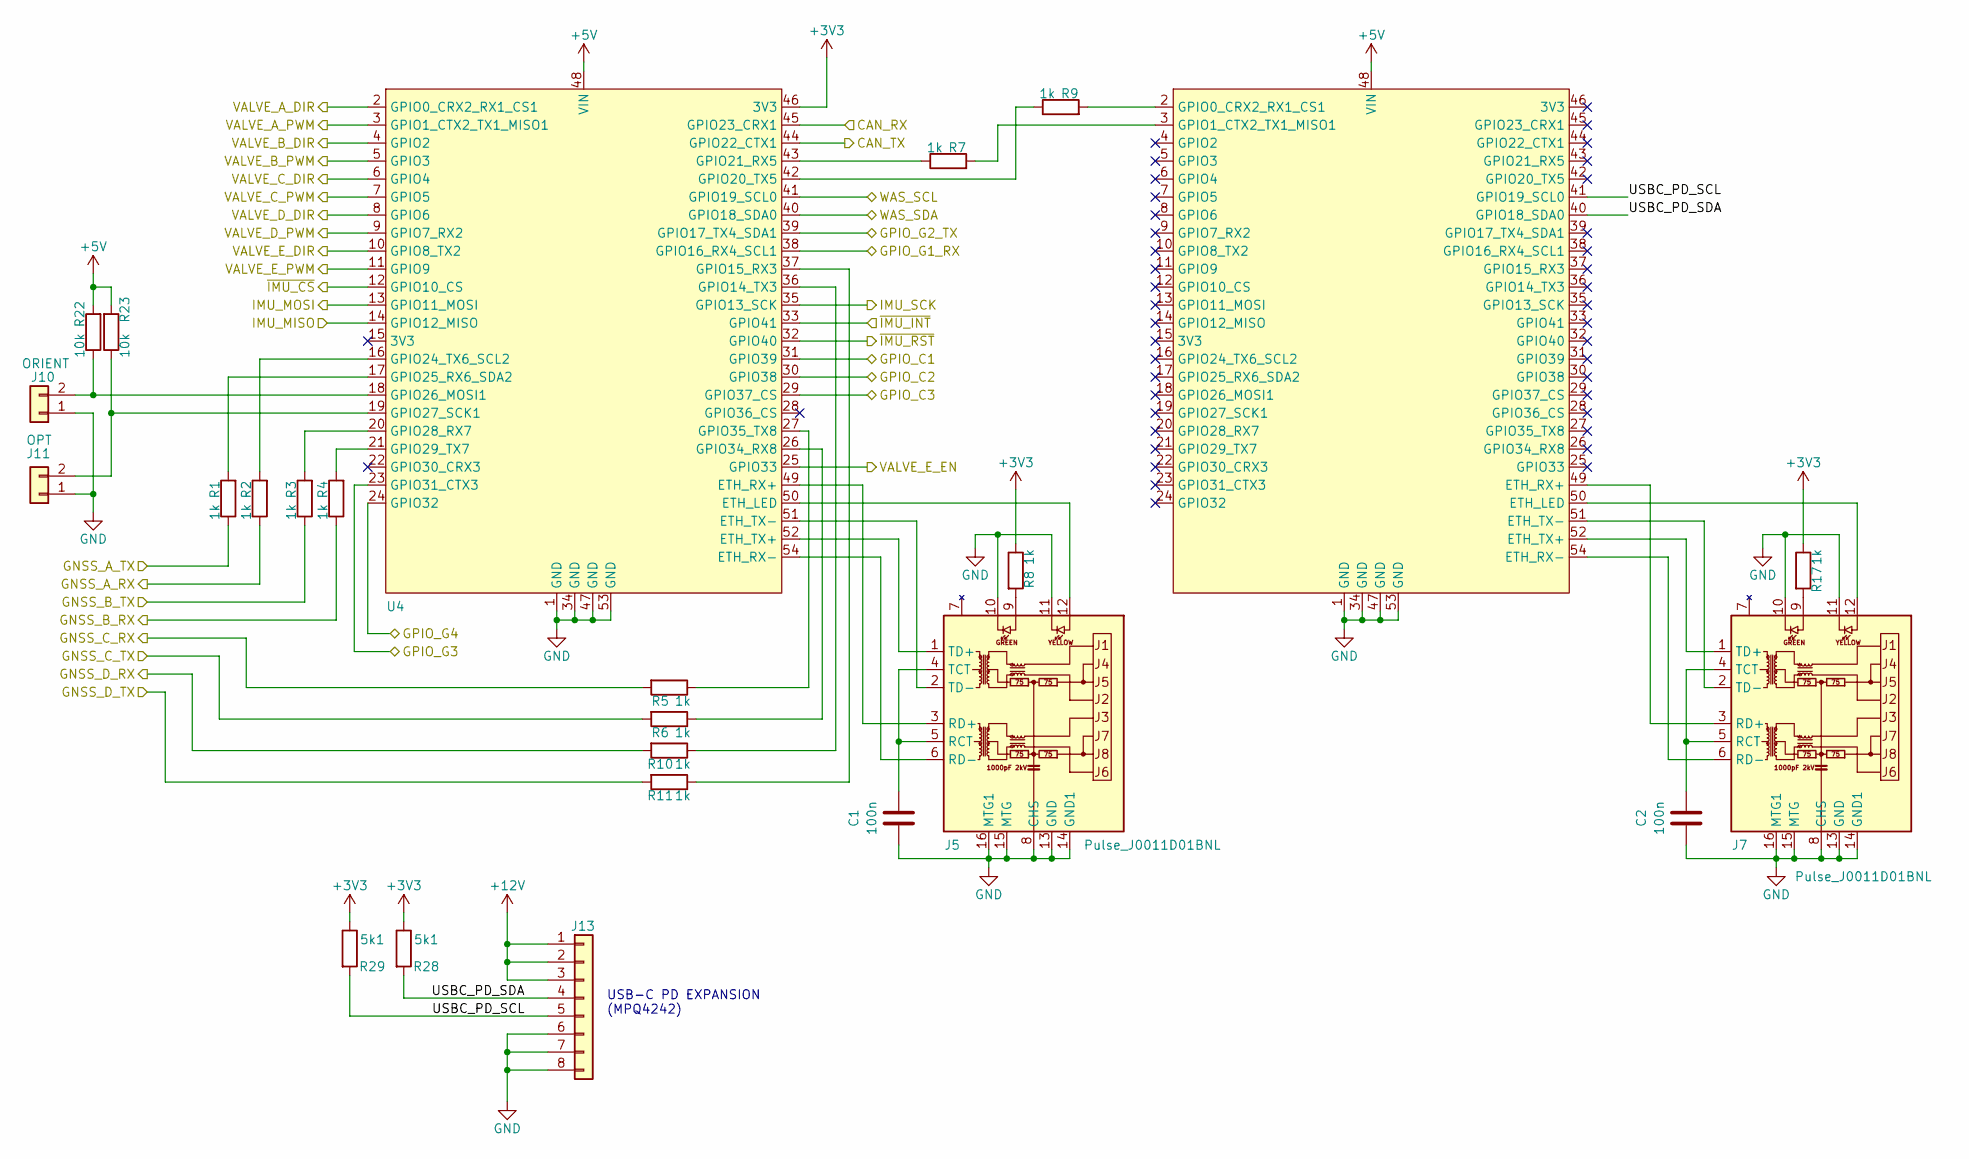
[picture p49: schematic MCUs.kicad_sch, Tandem Leveller Controller]

Parts:
C1, C2: 100n; C_0805_2012Metric; LCSC C1711
J5, J7: Pulse_J0011D01BNL; LCSC C581368
J10: ORIENT; PinHeader_1x02_P2.54mm_Vertical; LCSC C7494857
J11: OPT; PinHeader_1x02_P2.54mm_Vertical; LCSC C7494857
J13: Conn_01x10; JST_XH_B8B-XH-A_1x08_P2.50mm_Vertical
R1, R2, R3, R4, R5, R6, R7, R8, R9, R10, R11, R17: 1k; R_0805_2012Metric; LCSC C17513
R22, R23: 10k; R_0805_2012Metric; LCSC C17513
R28, R29: 5k1; R_0805_2012Metric
U4, U5: Teensy_4.1

Connections:
+3V3: R8.1, R17.1, R28.1, R29.1, U4.46 (3V3); also elsewhere on the board
+5V: R22.2, R23.2, U4.48 (VIN), U5.48 (VIN); also elsewhere on the board
+12V: J13.1, J13.2, J13.3; also elsewhere on the board
/Autosteer/WAS_SCL: U4.41 (GPIO19_SCL0); also elsewhere on the board
/Autosteer/WAS_SDA: U4.40 (GPIO18_SDA0); also elsewhere on the board
/CAN/CAN_RX: U4.45 (GPIO23_CRX1); also elsewhere on the board
/CAN/CAN_TX: U4.44 (GPIO22_CTX1); also elsewhere on the board
/GNSS/GNSS_A_RX: R2.1; also elsewhere on the board
/GNSS/GNSS_A_TX: R1.1; also elsewhere on the board
/GNSS/GNSS_B_RX: R4.1; also elsewhere on the board
/GNSS/GNSS_B_TX: R3.1; also elsewhere on the board
/GNSS/GNSS_C_RX: R5.2; also elsewhere on the board
/GNSS/GNSS_C_TX: R6.2; also elsewhere on the board
/GNSS/GNSS_D_RX: R10.2; also elsewhere on the board
/GNSS/GNSS_D_TX: R11.2; also elsewhere on the board
/GNSS/GPIO_G1: U4.38 (GPIO16_RX4_SCL1); also elsewhere on the board
/GNSS/GPIO_G2: U4.39 (GPIO17_TX4_SDA1); also elsewhere on the board
/GNSS/GPIO_G3: U4.23 (GPIO31_CTX3); also elsewhere on the board
/GNSS/GPIO_G4: U4.24 (GPIO32); also elsewhere on the board
/GPIO_C1: U4.31 (GPIO39); also elsewhere on the board
/GPIO_C2: U4.30 (GPIO38); also elsewhere on the board
/GPIO_C3: U4.29 (GPIO37_CS); also elsewhere on the board
/IMU/IMU_MISO: U4.14 (GPIO12_MISO); also elsewhere on the board
/IMU/IMU_MOSI: U4.13 (GPIO11_MOSI); also elsewhere on the board
/IMU/IMU_SCK: U4.35 (GPIO13_SCK); also elsewhere on the board
/IMU/~IMU_CS: U4.12 (GPIO10_CS); also elsewhere on the board
/IMU/~IMU_INT: U4.33 (GPIO41); also elsewhere on the board
/IMU/~IMU_RST: U4.32 (GPIO40); also elsewhere on the board
/MCUs/USBC_PD_SCL: J13.5, R29.2, U5.41 (GPIO19_SCL0)
/MCUs/USBC_PD_SDA: J13.4, R28.2, U5.40 (GPIO18_SDA0)
/MCUs/VALVE_A_DIR: U4.2 (GPIO0_CRX2_RX1_CS1); also elsewhere on the board
/MCUs/VALVE_A_PWM: U4.3 (GPIO1_CTX2_TX1_MISO1); also elsewhere on the board
/MCUs/VALVE_E_EN: U4.25 (GPIO33); also elsewhere on the board
/Valves/VALVE_B_DIR: U4.4 (GPIO2); also elsewhere on the board
/Valves/VALVE_B_PWM: U4.5 (GPIO3); also elsewhere on the board
/Valves/VALVE_C_DIR: U4.6 (GPIO4); also elsewhere on the board
/Valves/VALVE_C_PWM: U4.7 (GPIO5); also elsewhere on the board
/Valves/VALVE_D_DIR: U4.8 (GPIO6); also elsewhere on the board
/Valves/VALVE_D_PWM: U4.9 (GPIO7_RX2); also elsewhere on the board
/Valves/VALVE_E_DIR: U4.10 (GPIO8_TX2); also elsewhere on the board
/Valves/VALVE_E_PWM: U4.11 (GPIO9); also elsewhere on the board
GND: C1.1, C2.1, J5.8 (CHS), J5.10, J5.11, J5.13 (GND), J5.14 (GND1), J5.15 (MTG), J5.16 (MTG1), J7.8 (CHS), J7.10, J7.11, J7.13 (GND), J7.14 (GND1), J7.15 (MTG), J7.16 (MTG1), J10.1, J11.1, J13.6, J13.7, J13.8, U4.1 (GND), U4.34 (GND), U4.47 (GND), U4.53 (GND), U5.1 (GND), U5.34 (GND), U5.47 (GND), U5.53 (GND); also elsewhere on the board
unnamed: J5.9, R8.2
unnamed: C1.2, J5.4 (TCT), J5.5 (RCT)
unnamed: J5.3 (RD+), U4.49 (ETH_RX+)
unnamed: J5.6 (RD-), U4.54 (ETH_RX-)
unnamed: J5.1 (TD+), U4.52 (ETH_TX+)
unnamed: J5.2 (TD-), U4.51 (ETH_TX-)
unnamed: J7.9, R17.2
unnamed: C2.2, J7.4 (TCT), J7.5 (RCT)
unnamed: J7.3 (RD+), U5.49 (ETH_RX+)
unnamed: J7.6 (RD-), U5.54 (ETH_RX-)
unnamed: J7.1 (TD+), U5.52 (ETH_TX+)
unnamed: J7.2 (TD-), U5.51 (ETH_TX-)
unnamed: J10.2, R22.1, U4.18 (GPIO26_MOSI1)
unnamed: J11.2, R23.1, U4.19 (GPIO27_SCK1)
unnamed: J5.12, U4.50 (ETH_LED)
unnamed: R10.1, U4.36 (GPIO14_TX3)
unnamed: R11.1, U4.37 (GPIO15_RX3)
unnamed: R9.1, U4.42 (GPIO20_TX5)
unnamed: R7.1, U4.43 (GPIO21_RX5)
unnamed: R2.2, U4.16 (GPIO24_TX6_SCL2)
unnamed: R1.2, U4.17 (GPIO25_RX6_SDA2)
unnamed: R3.2, U4.20 (GPIO28_RX7)
unnamed: R4.2, U4.21 (GPIO29_TX7)
unnamed: R6.1, U4.26 (GPIO34_RX8)
unnamed: R5.1, U4.27 (GPIO35_TX8)
unnamed: J7.12, U5.50 (ETH_LED)
unnamed: R9.2, U5.2 (GPIO0_CRX2_RX1_CS1)
unnamed: R7.2, U5.3 (GPIO1_CTX2_TX1_MISO1)

Notes on the sheet:
USB-C PD EXPANSION (MPQ4242)

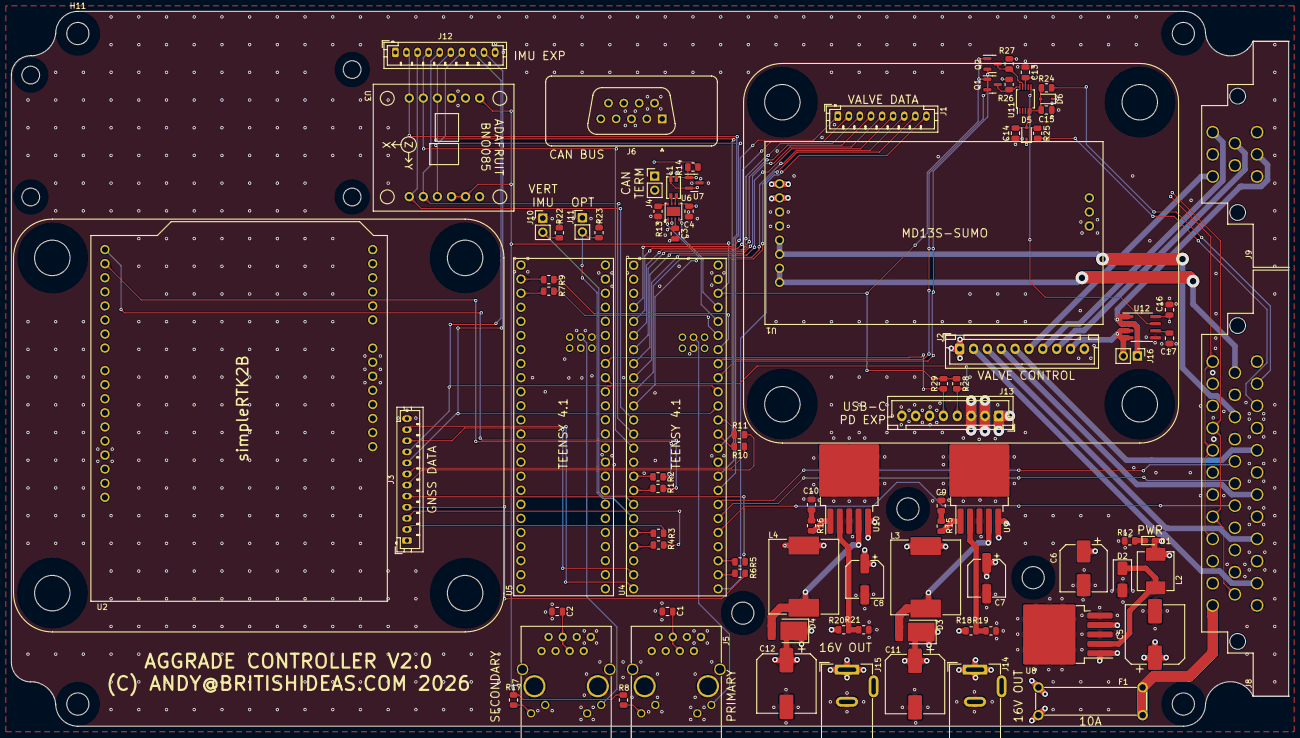
[picture p50: board Tandem Leveller Controller V2.kicad_pcb from above]

Board: 6 copper layers, 230.5 x 129.0 mm, 106 parts (0 on the bottom side), 108 nets.
