ajayre/tandemleveller/Electronics/XBee Adapter/Dummy XBee/Dummy XBee.kicad_pcb

## KiCad design Electronics/XBee Adapter/Dummy XBee/Dummy XBee.kicad_pcb (2026-04-20)

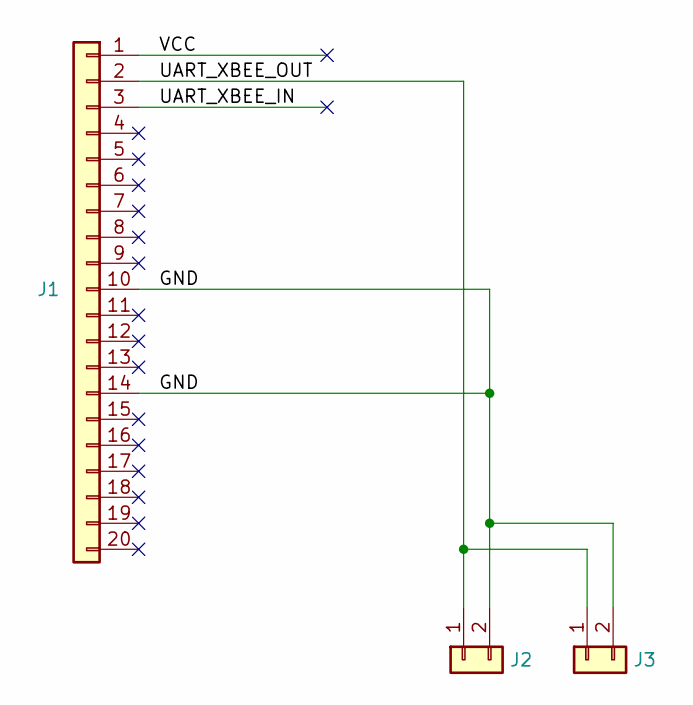
[picture p51: schematic Dummy XBee.kicad_sch]

Parts:
J1: Conn_01x20; XBee 3 TH
J2, J3: Conn_01x04; JST_PH_B2B-PH-K_1x02_P2.00mm_Vertical

Connections:
/GND: J1.10, J1.14, J2.2, J3.2
/UART_XBEE_IN: J1.3
/UART_XBEE_OUT: J1.2, J2.1, J3.1
/VCC: J1.1

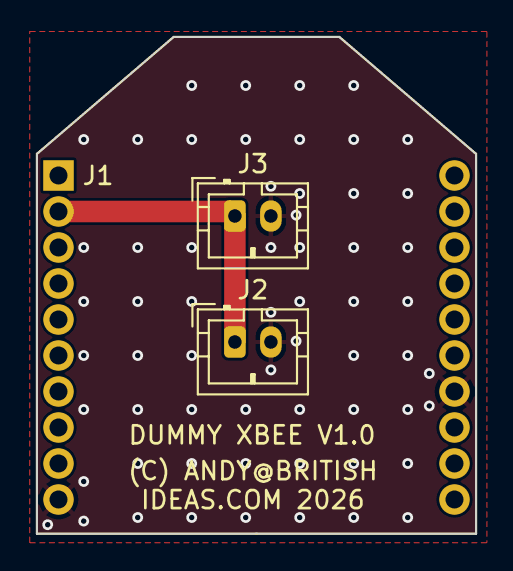
[picture p52: board Dummy XBee.kicad_pcb from above]

Board: 2 copper layers, 24.4 x 27.6 mm, 3 parts (0 on the bottom side), 2 nets.
