ajayre/tandemleveller/Electronics/XBee Adapter/XBee Adapter/XBee Adapter.kicad_pcb

## KiCad design Electronics/XBee Adapter/XBee Adapter/XBee Adapter.kicad_pcb (2026-04-20)

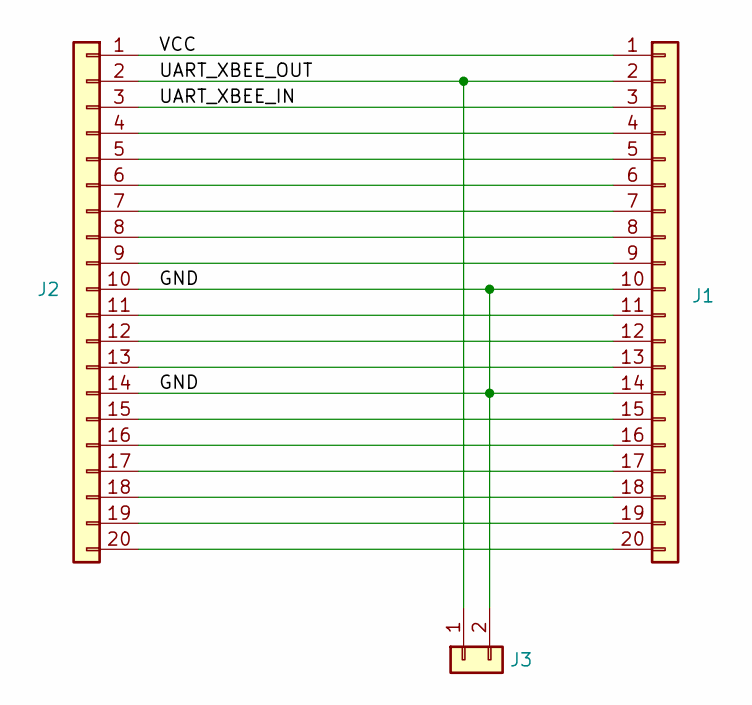
[picture p53: schematic XBee Adapter.kicad_sch]

Parts:
J1: Conn_01x20; XBee 3 TH No Outline
J2: Conn_01x20; XBee 3 TH
J3: Conn_01x04; JST_PH_B2B-PH-K_1x02_P2.00mm_Vertical

Connections:
/GND: J1.10, J1.14, J2.10, J2.14, J3.2
/UART_XBEE_IN: J1.3, J2.3
/UART_XBEE_OUT: J1.2, J2.2, J3.1
/VCC: J1.1, J2.1
unnamed: J1.4, J2.4
unnamed: J1.5, J2.5
unnamed: J1.6, J2.6
unnamed: J1.7, J2.7
unnamed: J1.8, J2.8
unnamed: J1.9, J2.9
unnamed: J1.11, J2.11
unnamed: J1.12, J2.12
unnamed: J1.13, J2.13
unnamed: J1.15, J2.15
unnamed: J1.16, J2.16
unnamed: J1.17, J2.17
unnamed: J1.18, J2.18
unnamed: J1.19, J2.19
unnamed: J1.20, J2.20
