ajayre/tandemleveller/Electronics/XBee Adapter/XBee Adapter/XBee Adapter.kicad_pcb

## KiCad design Electronics/XBee Adapter/XBee Adapter/XBee Adapter.kicad_pcb (continued)

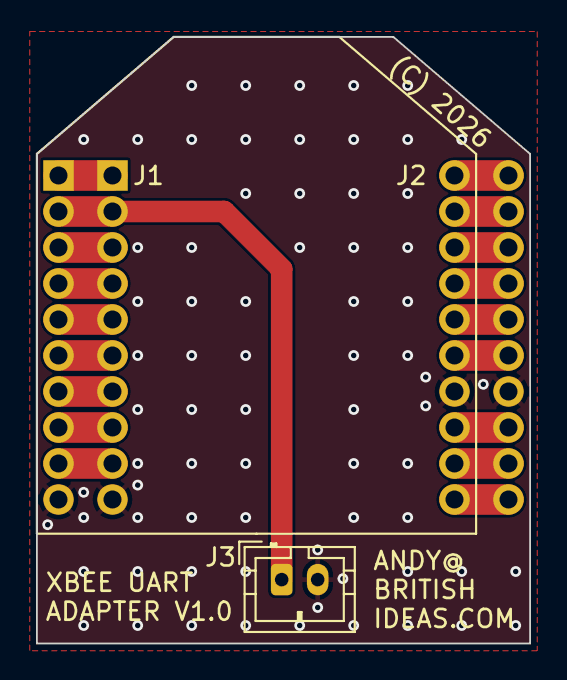
[picture p54: board XBee Adapter.kicad_pcb from above]

Board: 2 copper layers, 27.4 x 33.7 mm, 3 parts (0 on the bottom side), 19 nets.
