ajayre/tandemleveller/Electronics/Controller V2/GNSS Daughterboard/GNSS Daughterboard.kicad_pcb

## KiCad design Electronics/Controller V2/GNSS Daughterboard/GNSS Daughterboard.kicad_pcb (2026-03-22)

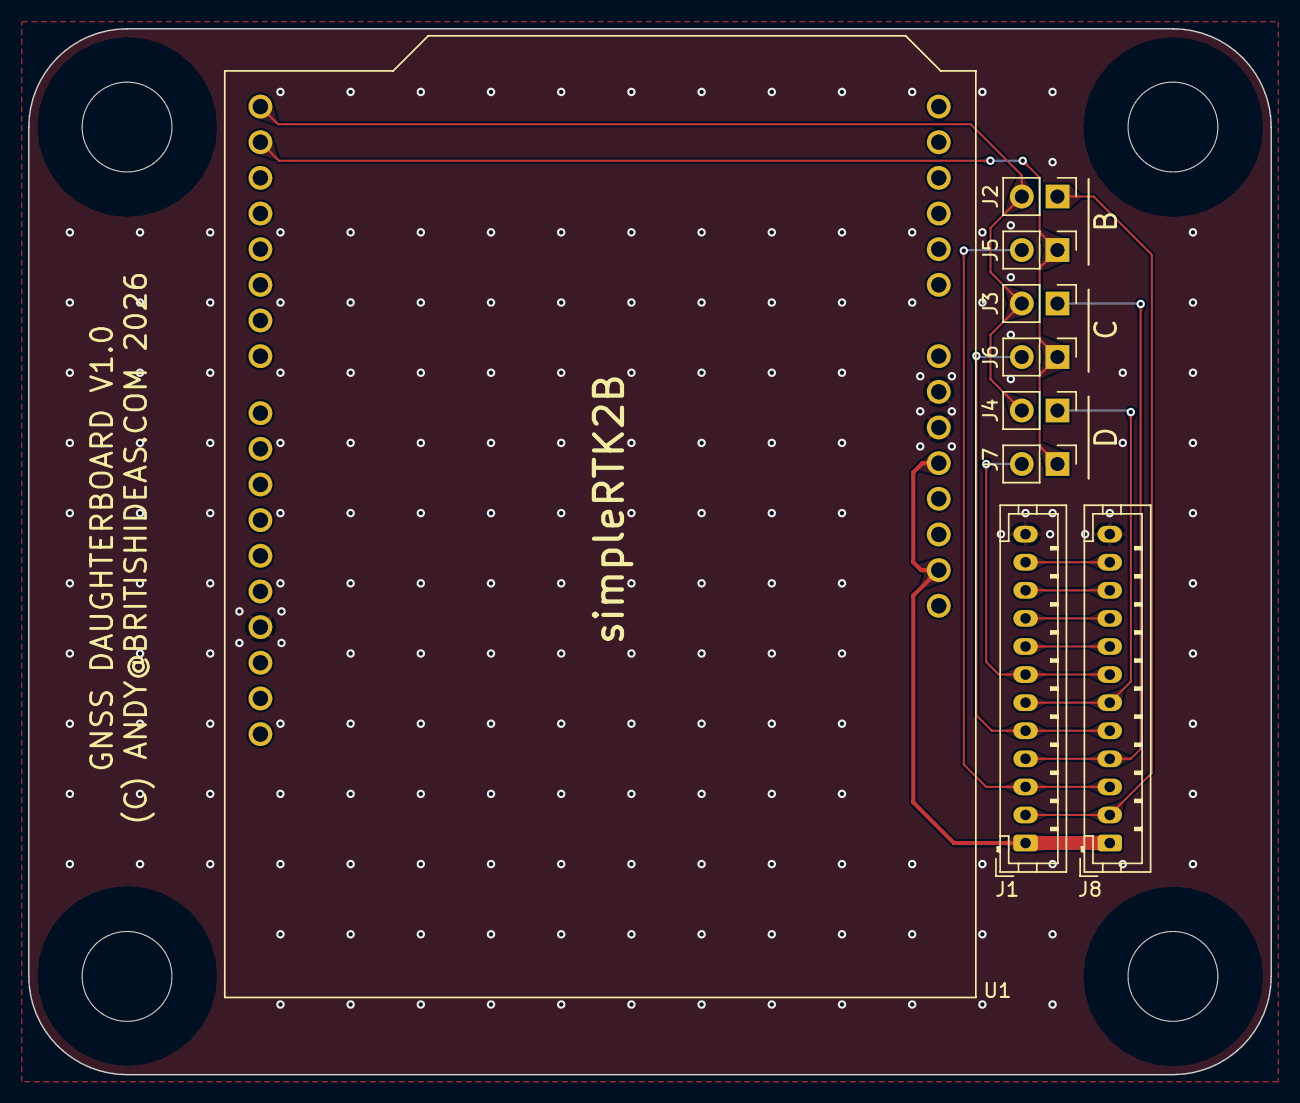
[picture p55: board GNSS Daughterboard.kicad_pcb from above]

Board: 2 copper layers, 88.5 x 74.5 mm, 13 parts (0 on the bottom side), 14 nets.

Parts:
H1, H2, H3, H4: MountingHole; MountingHole_6.4mm_M6
J1, J8: GNSS; JST_PH_B12B-PH-K_1x12_P2.00mm_Vertical
J2, J3, J4, J5, J6, J7: Conn_01x02; PinHeader_1x02_P2.54mm_Vertical
U1: simpleRTK2B

Connections:
+5V: J1.1, J8.1, U1.20 (IOREF), U1.23 (5V_IN)
/GNSS_B_RX: J1.3, J5.2, J8.3
/GNSS_B_TX: J1.2, J2.1, J8.2
/GNSS_C_RX: J1.5, J6.2, J8.5
/GNSS_C_TX: J1.4, J3.1, J8.4
/GNSS_D_RX: J1.7, J7.2, J8.7
/GNSS_D_TX: J1.6, J4.1, J8.6
/GPIO_G1: J1.8, J8.8
/GPIO_G2: J1.9, J8.9
/GPIO_G3: J1.10, J8.10
/GPIO_G4: J1.11, J8.11
GND: J1.12, J8.12, U1.15 (GND), U1.24 (GND), U1.25 (GND)
unnamed: J2.2, J3.2, J4.2, U1.1 (TX1)
unnamed: J5.1, J6.1, J7.1, U1.2 (RX1)
