ajayre/tandemleveller/Electronics/Controller V2/Valve Daughterboard/Valve Daughterboard.kicad_pcb

## KiCad design Electronics/Controller V2/Valve Daughterboard/Valve Daughterboard.kicad_pcb (2026-03-22)

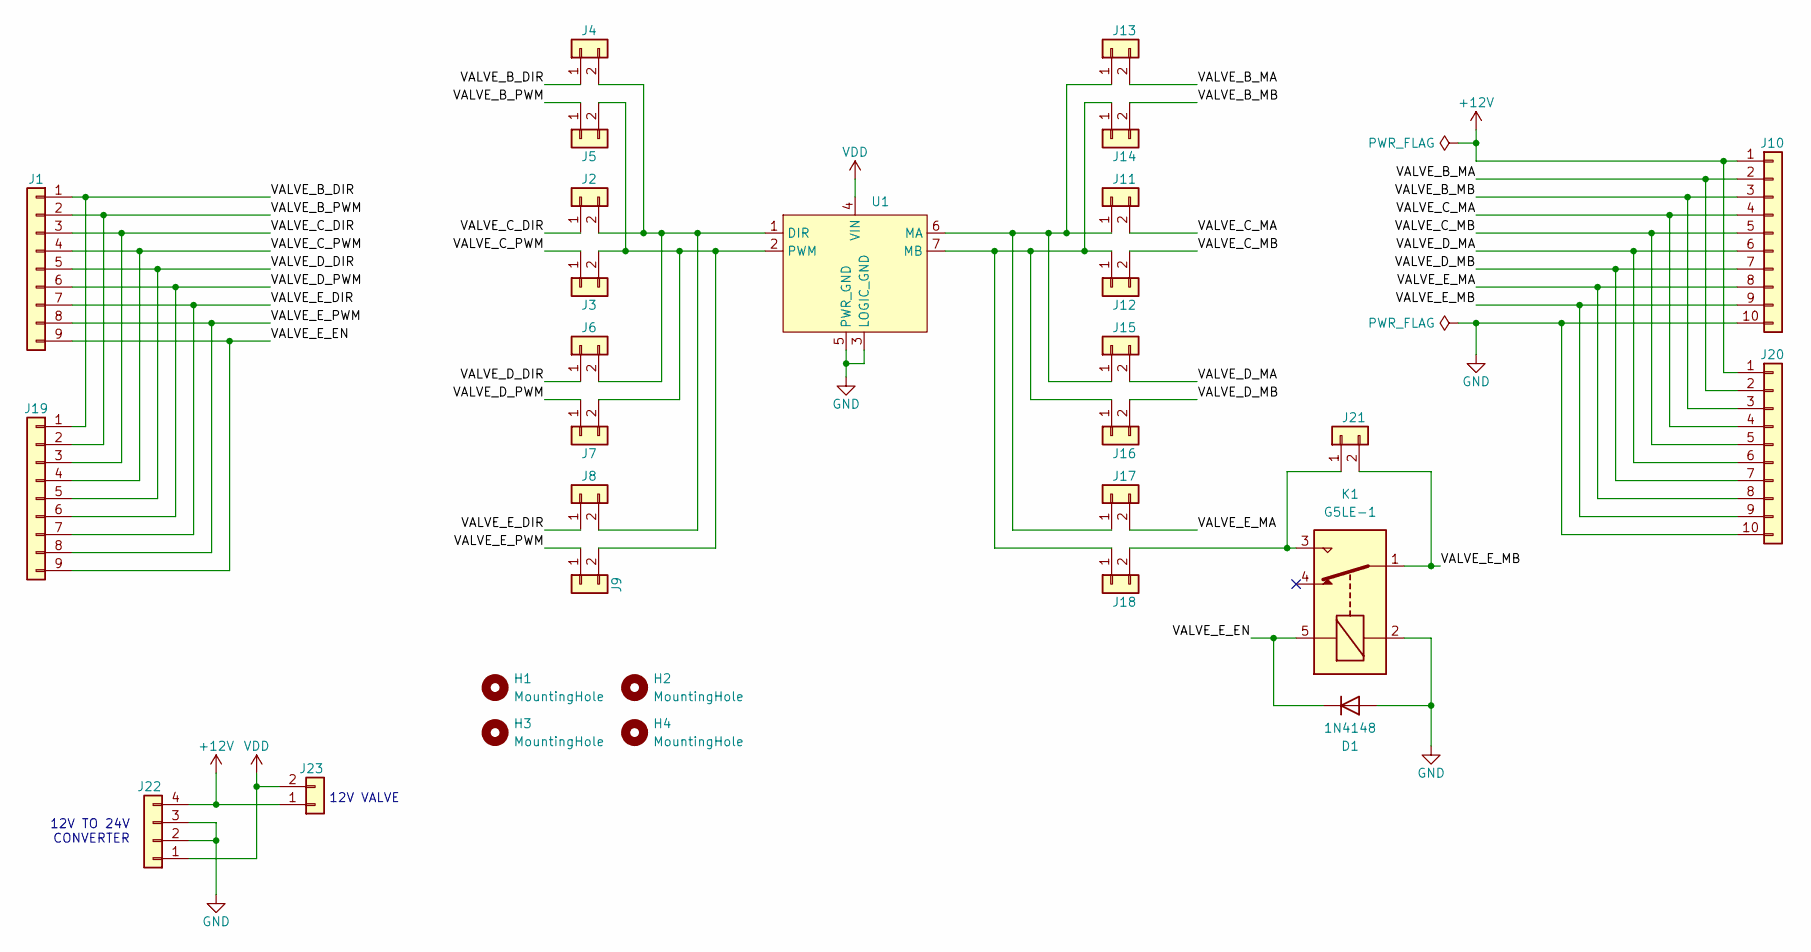
[picture p56: schematic Valve Daughterboard.kicad_sch, Tandem Leveller Valve Daughterboard]

Parts:
D1: 1N4148; D_DO-35_SOD27_P7.62mm_Horizontal
H1, H2, H3, H4: MountingHole; MountingHole_6.4mm_M6
J1, J19: Conn_01x08; JST_PH_B9B-PH-K_1x09_P2.00mm_Vertical
J2, J3, J4, J5, J6, J7, J8, J9, J11, J12, J13, J14, J15, J16, J17, J18, J21, J23: Conn_01x02; PinHeader_1x02_P2.54mm_Vertical
J10, J20: Conn_01x10; JST_XH_B10B-XH-A_1x10_P2.50mm_Vertical
J22: Conn_01x04; JST_XH_B4B-XH-A_1x04_P2.50mm_Vertical
K1: G5LE-1; Relay_SPDT_Omron-G5LE-1
U1: MD13S-SUMO

Connections:
+12V: J10.1, J20.1, J22.4, J23.1
/VALVE_B_DIR: J1.1, J4.1, J19.1
/VALVE_B_MA: J10.2, J13.2, J20.2
/VALVE_B_MB: J10.3, J14.2, J20.3
/VALVE_B_PWM: J1.2, J5.1, J19.2
/VALVE_C_DIR: J1.3, J2.1, J19.3
/VALVE_C_MA: J10.4, J11.2, J20.4
/VALVE_C_MB: J10.5, J12.2, J20.5
/VALVE_C_PWM: J1.4, J3.1, J19.4
/VALVE_D_DIR: J1.5, J6.1, J19.5
/VALVE_D_MA: J10.6, J15.2, J20.6
/VALVE_D_MB: J10.7, J16.2, J20.7
/VALVE_D_PWM: J1.6, J7.1, J19.6
/VALVE_E_DIR: J1.7, J8.1, J19.7
/VALVE_E_EN: D1.1 (K), J1.9, J19.9, K1.5
/VALVE_E_MA: J10.8, J17.2, J20.8
/VALVE_E_MB: J10.9, J20.9, J21.2, K1.1
/VALVE_E_PWM: J1.8, J9.1, J19.8
GND: D1.2 (A), J10.10, J20.10, J22.2, J22.3, K1.2, U1.3 (LOGIC_GND), U1.5 (PWR_GND)
unnamed: J2.2, J4.2, J6.2, J8.2, U1.1 (DIR)
unnamed: J3.2, J5.2, J7.2, J9.2, U1.2 (PWM)
unnamed: J11.1, J13.1, J15.1, J17.1, U1.6 (MA)
unnamed: J12.1, J14.1, J16.1, J18.1, U1.7 (MB)
unnamed: J18.2, J21.1, K1.3
VDD: J22.1, J23.2, U1.4 (VIN)

Notes on the sheet:
12V TO 24V CONVERTER
12V VALVE

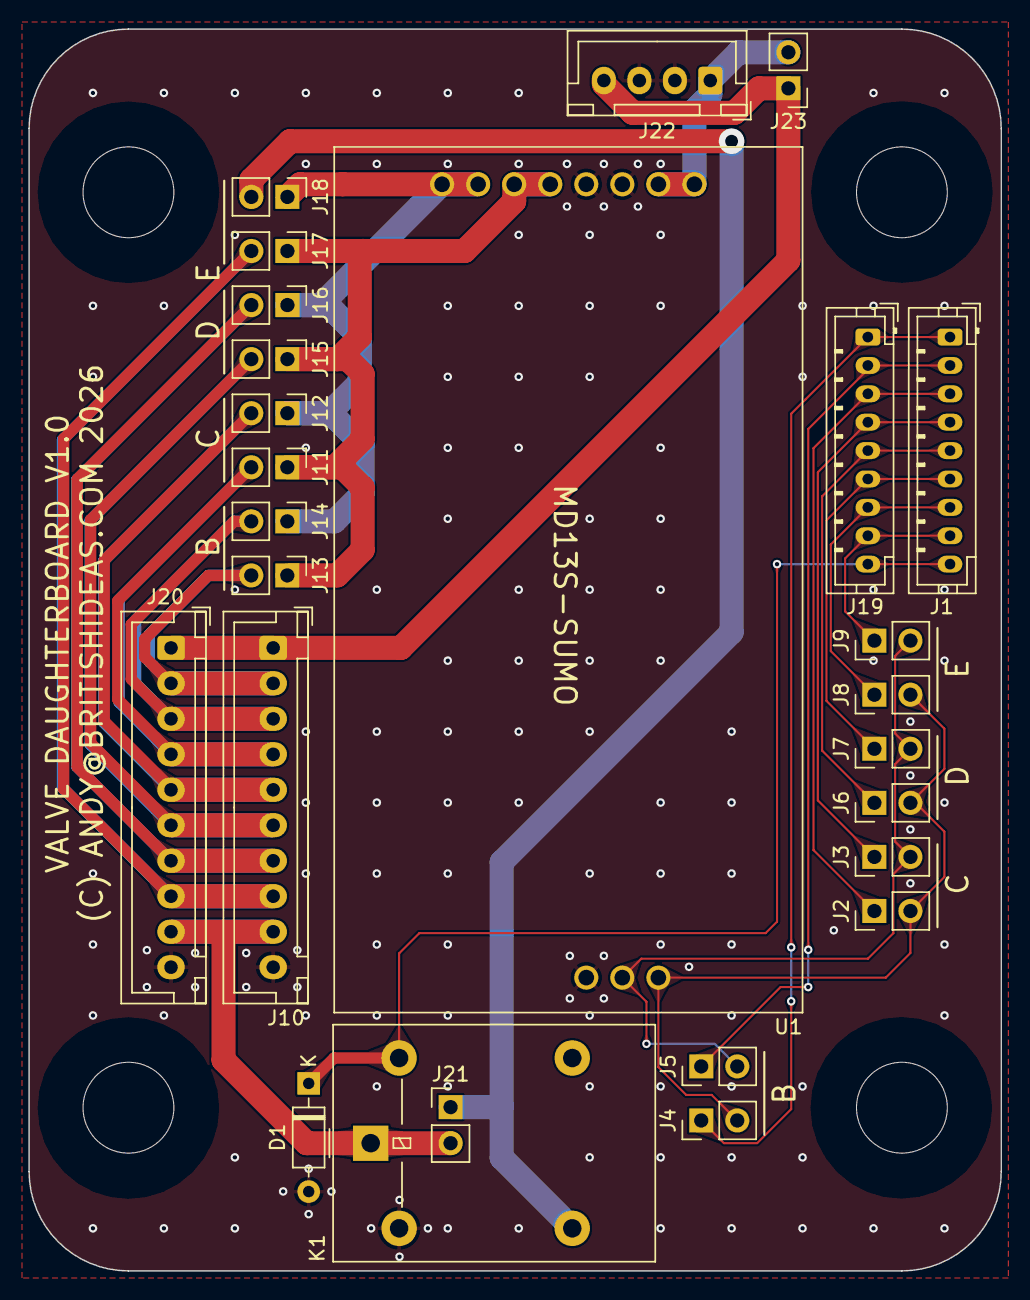
[picture p57: board Valve Daughterboard.kicad_pcb from above]

Board: 2 copper layers, 68.5 x 87.5 mm, 30 parts (0 on the bottom side), 25 nets.
