ajayre/tandemleveller/Electronics/Controller UDP Adapter/Controller UDP Adapter.kicad_pcb

## KiCad design Electronics/Controller UDP Adapter/Controller UDP Adapter.kicad_pcb (2025-11-27)

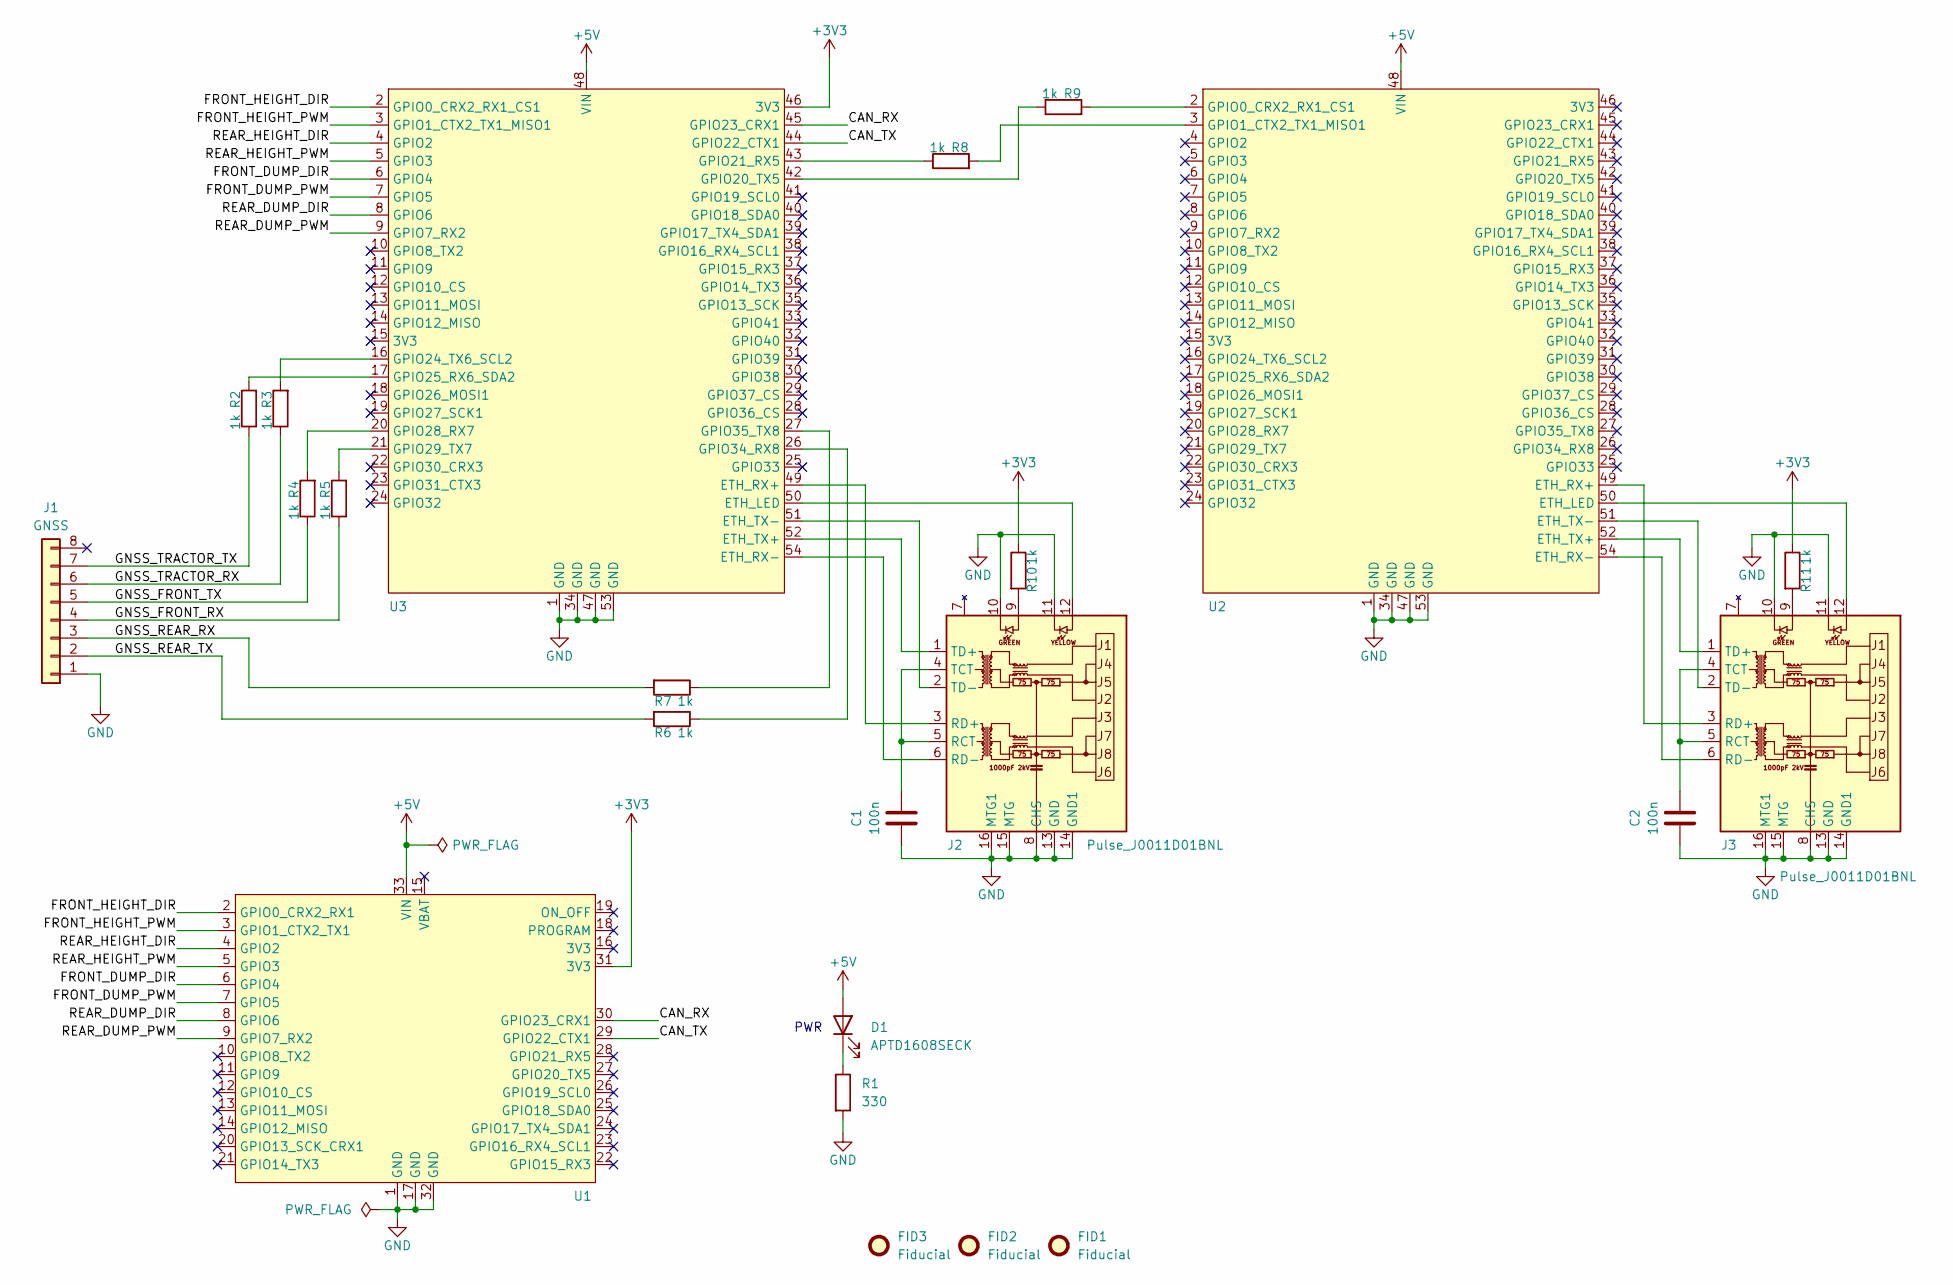
[picture p58: schematic Controller UDP Adapter.kicad_sch, Tandem Leveller Controller UDP Adapter]

Parts:
C1, C2: 100n; C_0805_2012Metric; LCSC C1711
D1: APTD1608SECK; D_0603_1608Metric; LCSC C5122084
FID1, FID2, FID3: Fiducial; Fiducial_0.5mm_Mask1mm
J1: GNSS; JST_PH_B8B-PH-K_1x08_P2.00mm_Vertical; LCSC C157974
J2, J3: Pulse_J0011D01BNL; LCSC C581368
R1: 330; R_0805_2012Metric; LCSC C17630
R2, R3, R4, R5, R6, R7, R8, R9, R10, R11: 1k; R_0805_2012Metric; LCSC C17513
U1: Teensy_4.0
U2, U3: Teensy_4.1

Connections:
+3V3: R10.1, R11.1, U1.31 (3V3), U3.46 (3V3)
+5V: D1.2 (A), U1.33 (VIN), U2.48 (VIN), U3.48 (VIN)
/CAN_RX: U1.30 (GPIO23_CRX1), U3.45 (GPIO23_CRX1)
/CAN_TX: U1.29 (GPIO22_CTX1), U3.44 (GPIO22_CTX1)
/FRONT_DUMP_DIR: U1.6 (GPIO4), U3.6 (GPIO4)
/FRONT_DUMP_PWM: U1.7 (GPIO5), U3.7 (GPIO5)
/FRONT_HEIGHT_DIR: U1.2 (GPIO0_CRX2_RX1), U3.2 (GPIO0_CRX2_RX1_CS1)
/FRONT_HEIGHT_PWM: U1.3 (GPIO1_CTX2_TX1), U3.3 (GPIO1_CTX2_TX1_MISO1)
/GNSS_FRONT_RX: J1.4, R5.1
/GNSS_FRONT_TX: J1.5, R4.1
/GNSS_REAR_RX: J1.3, R7.2
/GNSS_REAR_TX: J1.2, R6.2
/GNSS_TRACTOR_RX: J1.6, R3.1
/GNSS_TRACTOR_TX: J1.7, R2.1
/REAR_DUMP_DIR: U1.8 (GPIO6), U3.8 (GPIO6)
/REAR_DUMP_PWM: U1.9 (GPIO7_RX2), U3.9 (GPIO7_RX2)
/REAR_HEIGHT_DIR: U1.4 (GPIO2), U3.4 (GPIO2)
/REAR_HEIGHT_PWM: U1.5 (GPIO3), U3.5 (GPIO3)
GND: C1.1, C2.1, J1.1, J2.8 (CHS), J2.10, J2.11, J2.13 (GND), J2.14 (GND1), J2.15 (MTG), J2.16 (MTG1), J3.8 (CHS), J3.10, J3.11, J3.13 (GND), J3.14 (GND1), J3.15 (MTG), J3.16 (MTG1), R1.2, U1.1 (GND), U1.17 (GND), U1.32 (GND), U2.1 (GND), U2.34 (GND), U2.47 (GND), U2.53 (GND), U3.1 (GND), U3.34 (GND), U3.47 (GND), U3.53 (GND)
unnamed: D1.1 (K), R1.1
unnamed: J2.9, R10.2
unnamed: C1.2, J2.4 (TCT), J2.5 (RCT)
unnamed: J2.3 (RD+), U3.49 (ETH_RX+)
unnamed: J2.6 (RD-), U3.54 (ETH_RX-)
unnamed: J2.1 (TD+), U3.52 (ETH_TX+)
unnamed: J2.2 (TD-), U3.51 (ETH_TX-)
unnamed: J3.9, R11.2
unnamed: C2.2, J3.4 (TCT), J3.5 (RCT)
unnamed: J3.3 (RD+), U2.49 (ETH_RX+)
unnamed: J3.6 (RD-), U2.54 (ETH_RX-)
unnamed: J3.1 (TD+), U2.52 (ETH_TX+)
unnamed: J3.2 (TD-), U2.51 (ETH_TX-)
unnamed: J3.12, U2.50 (ETH_LED)
unnamed: R9.2, U2.2 (GPIO0_CRX2_RX1_CS1)
unnamed: R8.2, U2.3 (GPIO1_CTX2_TX1_MISO1)
unnamed: J2.12, U3.50 (ETH_LED)
unnamed: R9.1, U3.42 (GPIO20_TX5)
unnamed: R8.1, U3.43 (GPIO21_RX5)
unnamed: R3.2, U3.16 (GPIO24_TX6_SCL2)
unnamed: R2.2, U3.17 (GPIO25_RX6_SDA2)
unnamed: R4.2, U3.20 (GPIO28_RX7)
unnamed: R5.2, U3.21 (GPIO29_TX7)
unnamed: R6.1, U3.26 (GPIO34_RX8)
unnamed: R7.1, U3.27 (GPIO35_TX8)

Notes on the sheet:
PWR

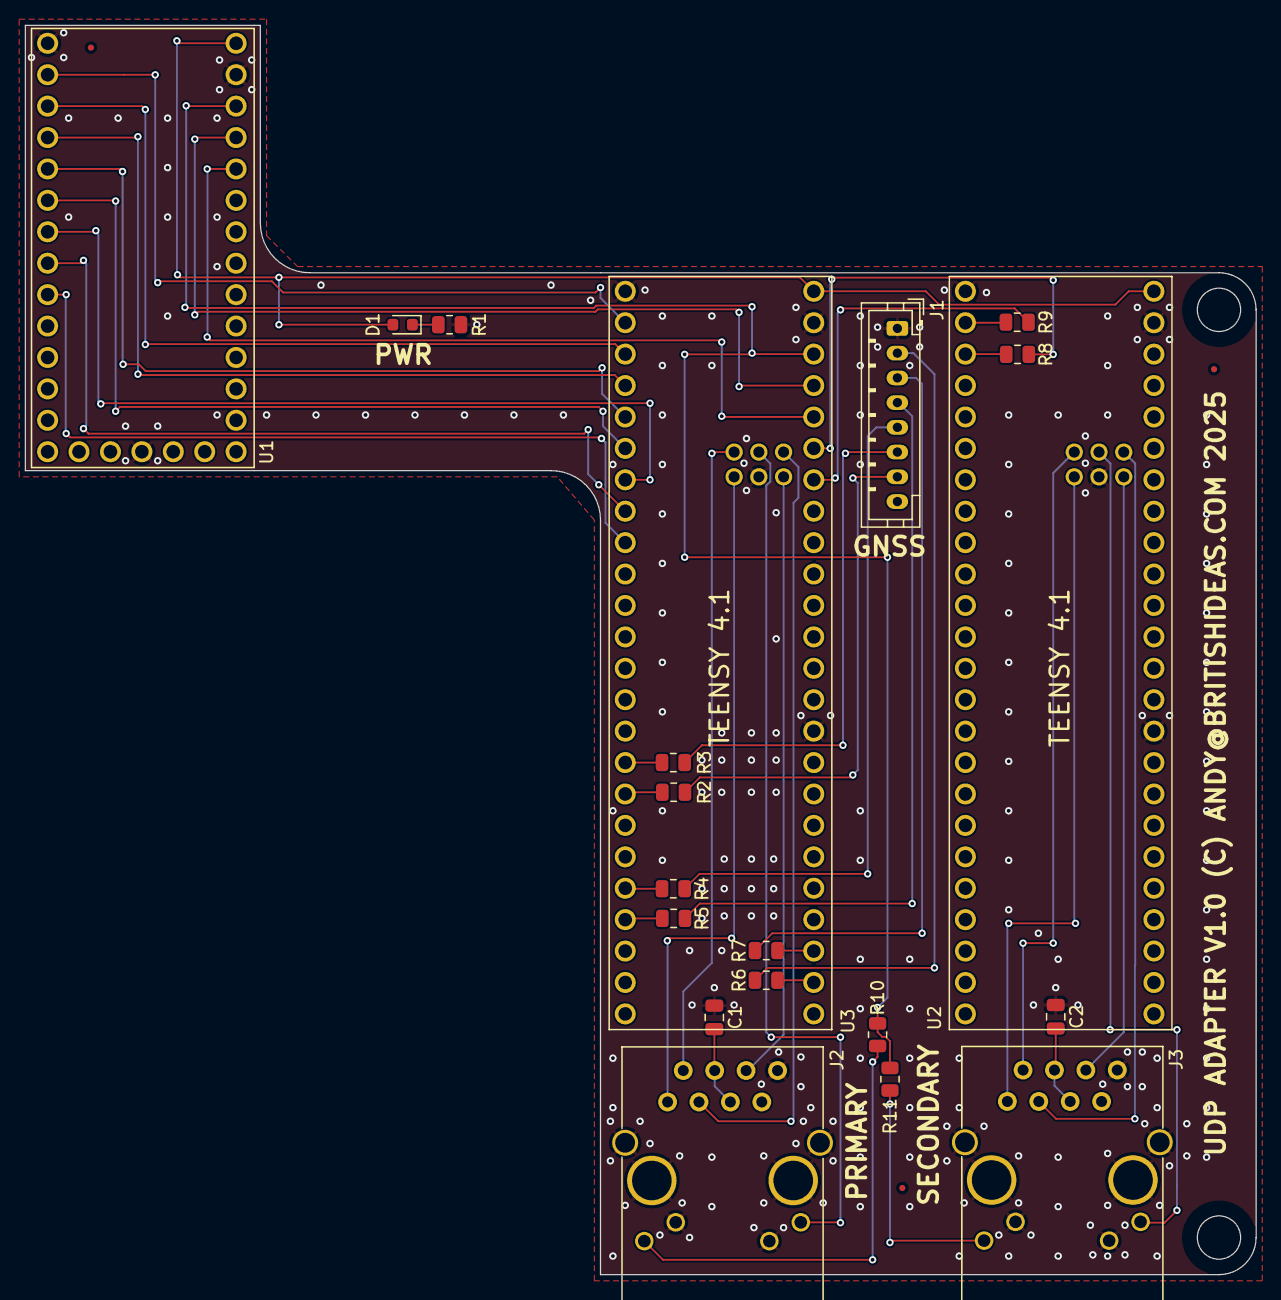
[picture p59: board Controller UDP Adapter.kicad_pcb from above]

Board: 2 copper layers, 99.5 x 101.0 mm, 23 parts (0 on the bottom side), 44 nets.
