ajayre/tandemleveller/Electronics/Scraper Angle/Scraper Angle.kicad_pcb

## KiCad design Electronics/Scraper Angle/Scraper Angle.kicad_pcb (2025-10-20)

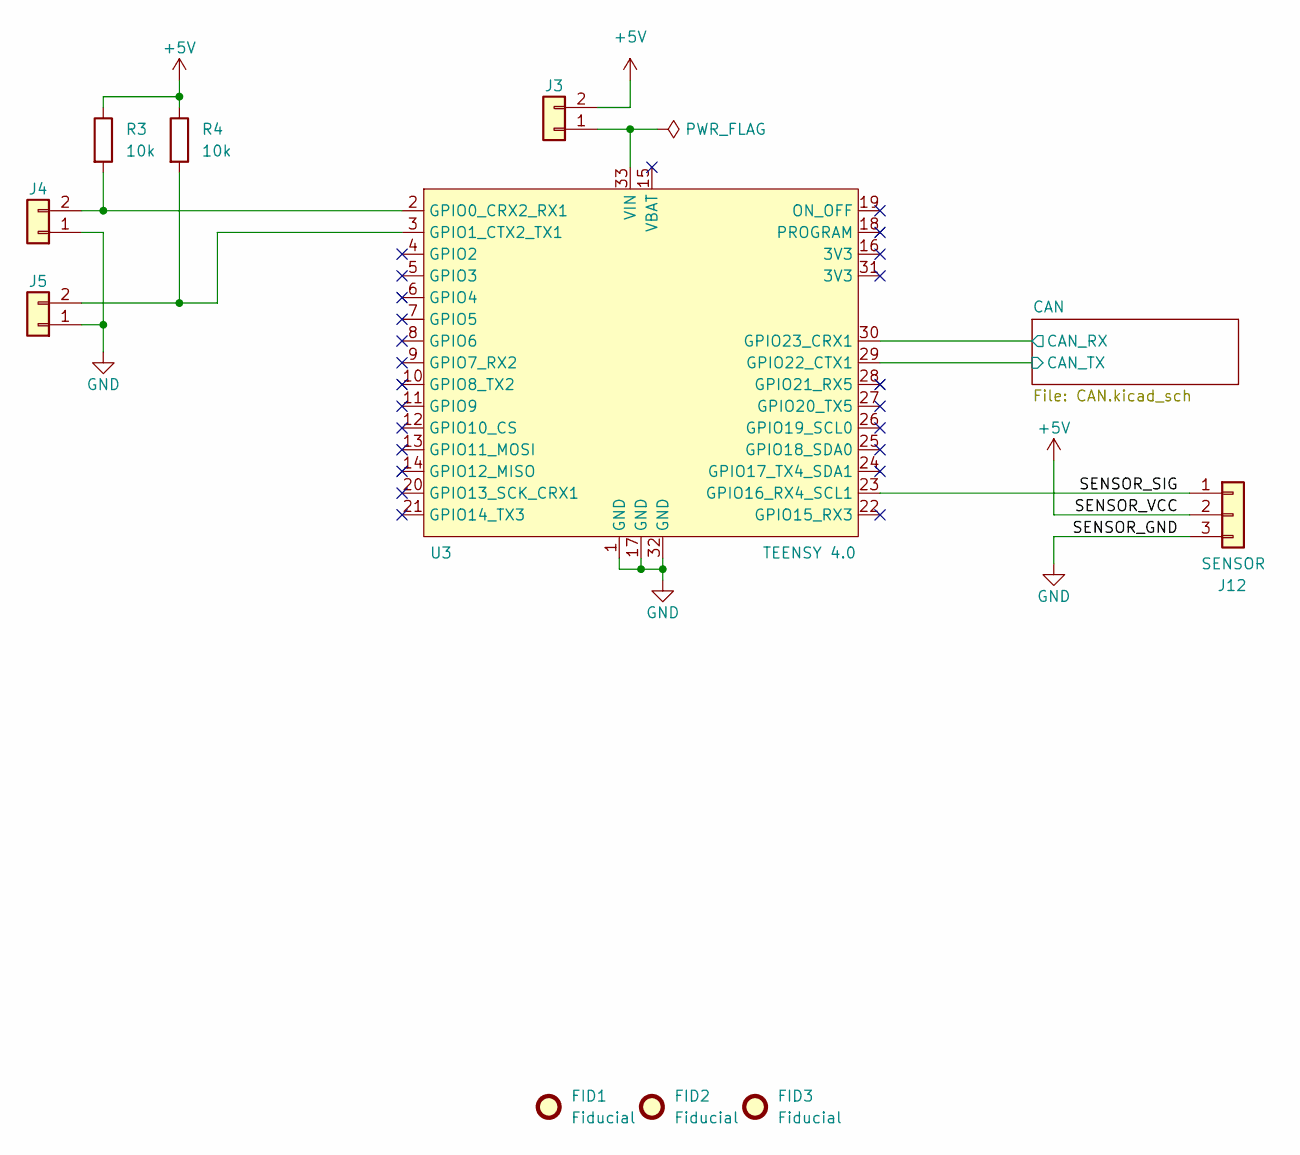
[picture p60: schematic Scraper Angle.kicad_sch, Tandem Leveller Scraper Angle]

Parts:
FID1, FID2, FID3: Fiducial; Fiducial_0.5mm_Mask1mm
J3, J4, J5: Conn_01x02; PinHeader_1x02_P2.54mm_Vertical; LCSC C7494857
J12: SENSOR; JST_PH_B3B-PH-K_1x03_P2.00mm_Vertical; LCSC C131339
R3, R4: 10k; R_0805_2012Metric; LCSC C17414
U3: TEENSY 4.0; Teensy_4.0

Connections:
+5V: J3.2, J12.2, R3.1, R4.1; also elsewhere on the board
/CAN/CAN_RX: U3.30 (GPIO23_CRX1); also elsewhere on the board
/CAN/CAN_TX: U3.29 (GPIO22_CTX1); also elsewhere on the board
/SENSOR_SIG: J12.1, U3.23 (GPIO16_RX4_SCL1)
GND: J4.1, J5.1, J12.3, U3.1 (GND), U3.17 (GND), U3.32 (GND); also elsewhere on the board
unnamed: J3.1, U3.33 (VIN)
unnamed: J4.2, R3.2, U3.2 (GPIO0_CRX2_RX1)
unnamed: J5.2, R4.2, U3.3 (GPIO1_CTX2_TX1)

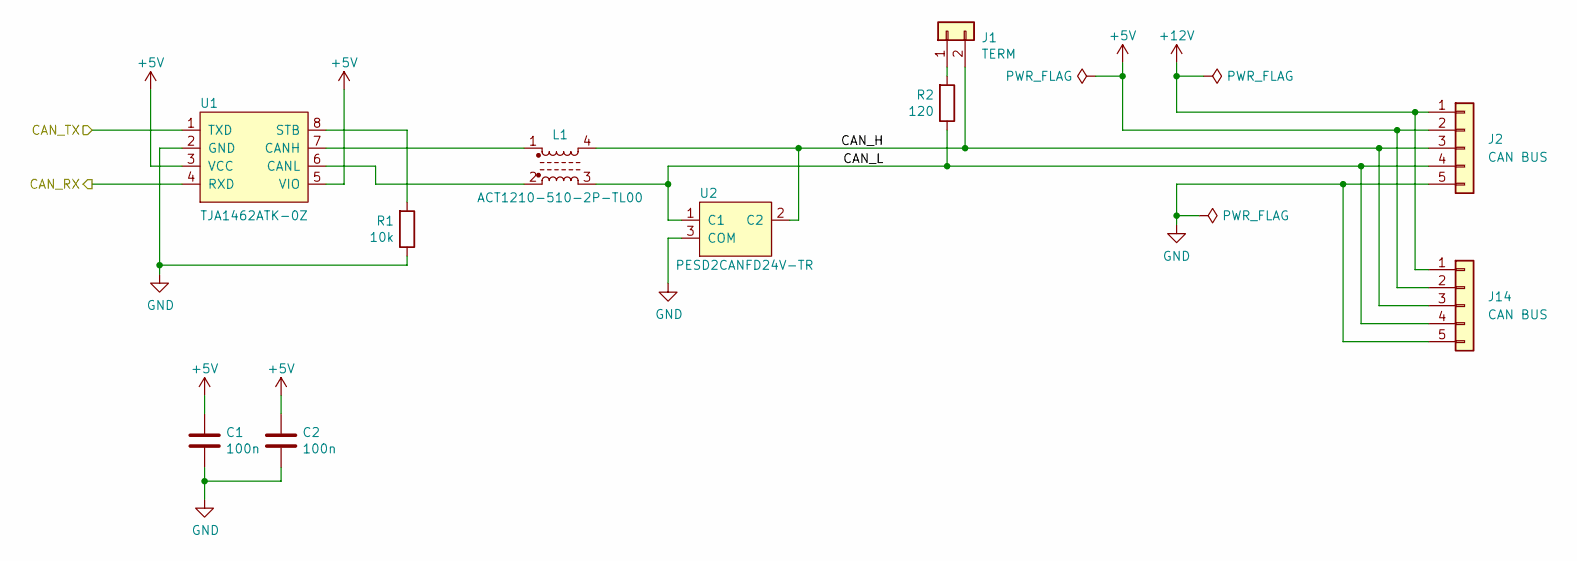
[picture p61: schematic CAN.kicad_sch, Tandem Leveller Scraper Angle]

Parts:
C1, C2: 100n; C_0805_2012Metric; LCSC C1711
J1: TERM; PinHeader_1x02_P2.54mm_Vertical; LCSC C7494857
J2, J14: CAN BUS; JST_PH_B5B-PH-K_1x05_P2.00mm_Vertical; LCSC C157993
L1: ACT1210-510-2P-TL00; LCSC C95572
R1: 10k; R_0805_2012Metric; LCSC C17414
R2: 120; R_0805_2012Metric; LCSC C17437
U1: TJA1462ATK-0Z; HVSON8_0_65mm; LCSC C3229259
U2: PESD2CANFD24V-TR; SOT-23; LCSC C552486

Connections:
+5V: C1.1, C2.1, J2.2, J14.2, U1.3 (VCC), U1.5 (VIO); also elsewhere on the board
+12V: J2.1, J14.1
/CAN/CAN_H: J1.2, J2.3, J14.3, L1.4, U2.2 (C2)
/CAN/CAN_L: J2.4, J14.4, L1.3, R2.1, U2.1 (C1)
/CAN/CAN_RX: U1.4 (RXD); also elsewhere on the board
/CAN/CAN_TX: U1.1 (TXD); also elsewhere on the board
GND: C1.2, C2.2, J2.5, J14.5, R1.1, U1.2 (GND), U2.3 (COM); also elsewhere on the board
unnamed: J1.1, R2.2
unnamed: L1.1, U1.7 (CANH)
unnamed: L1.2, U1.6 (CANL)
unnamed: R1.2, U1.8 (STB)

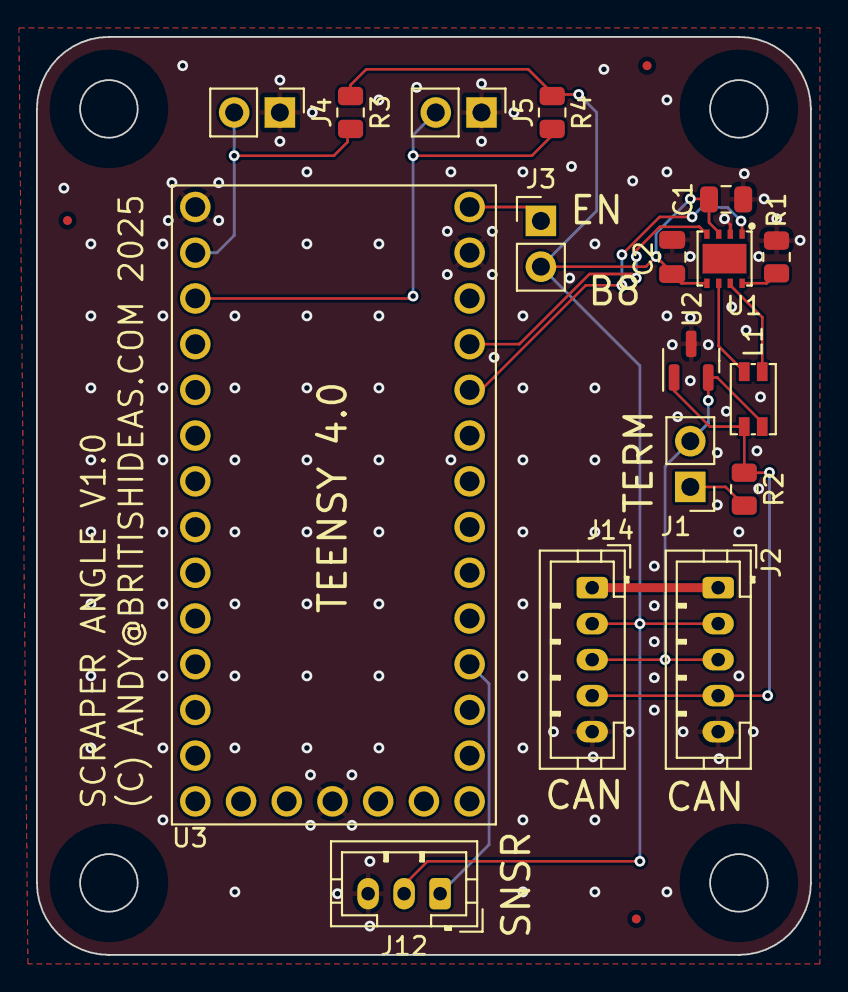
[picture p62: board Scraper Angle.kicad_pcb from above]

Board: 2 copper layers, 43.0 x 51.0 mm, 20 parts (0 on the bottom side), 15 nets.
