ajayre/tandemleveller/Electronics/Controller/Tandem Leveller Controller.kicad_pcb

## KiCad design Electronics/Controller/Tandem Leveller Controller.kicad_pcb (2025-03-19, an earlier design)

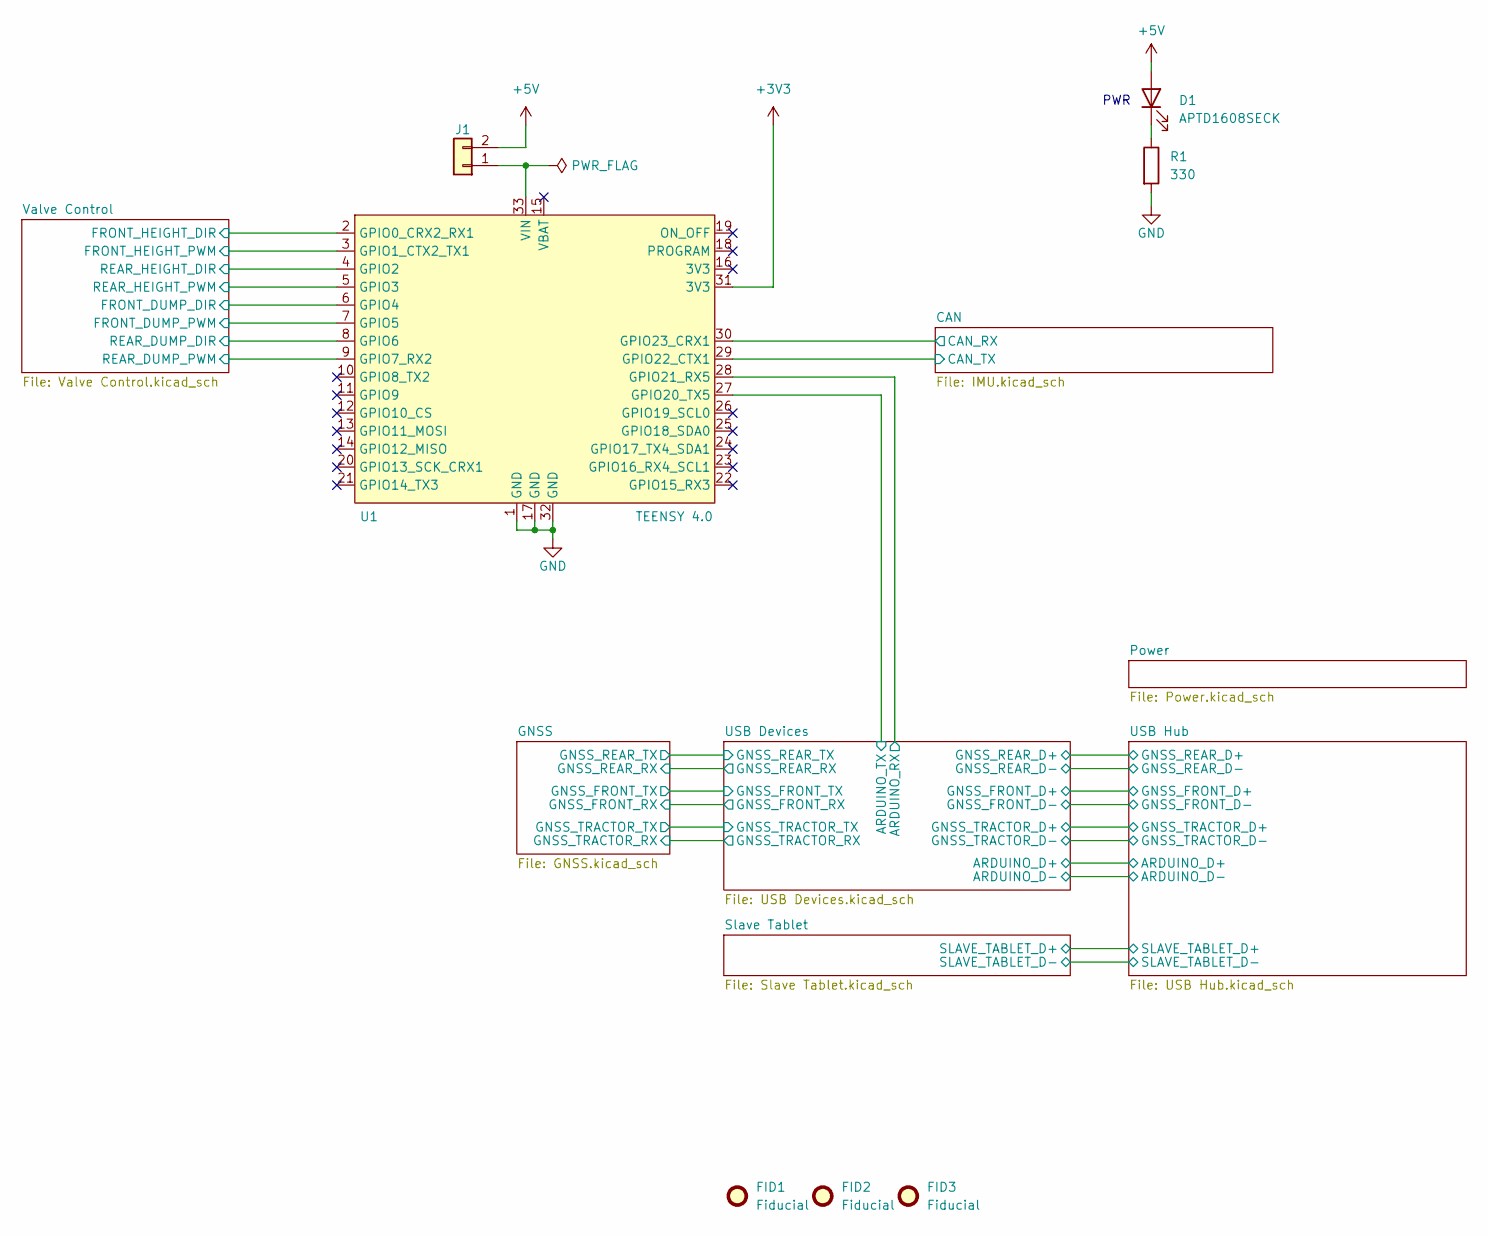
[picture p63: schematic Tandem Leveller Controller.kicad_sch]

Parts:
D1: APTD1608SECK; D_0603_1608Metric; LCSC C5879220
FID1, FID2, FID3: Fiducial; Fiducial_0.5mm_Mask1mm
J1: Conn_01x02; PinHeader_1x02_P2.54mm_Vertical; LCSC C7494857
R1: 330; R_0805_2012Metric; LCSC C17630
U1: TEENSY 4.0; Teensy_4.0

Connections:
+3V3: U1.31 (3V3); also elsewhere on the board
+5V: D1.2 (A), J1.2; also elsewhere on the board
/CAN/CAN_RX: U1.30 (GPIO23_CRX1); also elsewhere on the board
/CAN/CAN_TX: U1.29 (GPIO22_CTX1); also elsewhere on the board
/USB Devices/ARDUINO_RX: U1.28 (GPIO21_RX5); also elsewhere on the board
/USB Devices/ARDUINO_TX: U1.27 (GPIO20_TX5); also elsewhere on the board
/Valve Control/FRONT_DUMP_DIR: U1.6 (GPIO4); also elsewhere on the board
/Valve Control/FRONT_DUMP_PWM: U1.7 (GPIO5); also elsewhere on the board
/Valve Control/FRONT_HEIGHT_DIR: U1.2 (GPIO0_CRX2_RX1); also elsewhere on the board
/Valve Control/FRONT_HEIGHT_PWM: U1.3 (GPIO1_CTX2_TX1); also elsewhere on the board
/Valve Control/REAR_DUMP_DIR: U1.8 (GPIO6); also elsewhere on the board
/Valve Control/REAR_DUMP_PWM: U1.9 (GPIO7_RX2); also elsewhere on the board
/Valve Control/REAR_HEIGHT_DIR: U1.4 (GPIO2); also elsewhere on the board
/Valve Control/REAR_HEIGHT_PWM: U1.5 (GPIO3); also elsewhere on the board
GND: R1.2, U1.1 (GND), U1.17 (GND), U1.32 (GND); also elsewhere on the board
unnamed: D1.1 (K), R1.1
unnamed: J1.1, U1.33 (VIN)

Notes on the sheet:
PWR
