ajayre/tandemleveller/Electronics/Controller/Tandem Leveller Controller.kicad_pcb

## KiCad design Electronics/Controller/Tandem Leveller Controller.kicad_pcb (continued)

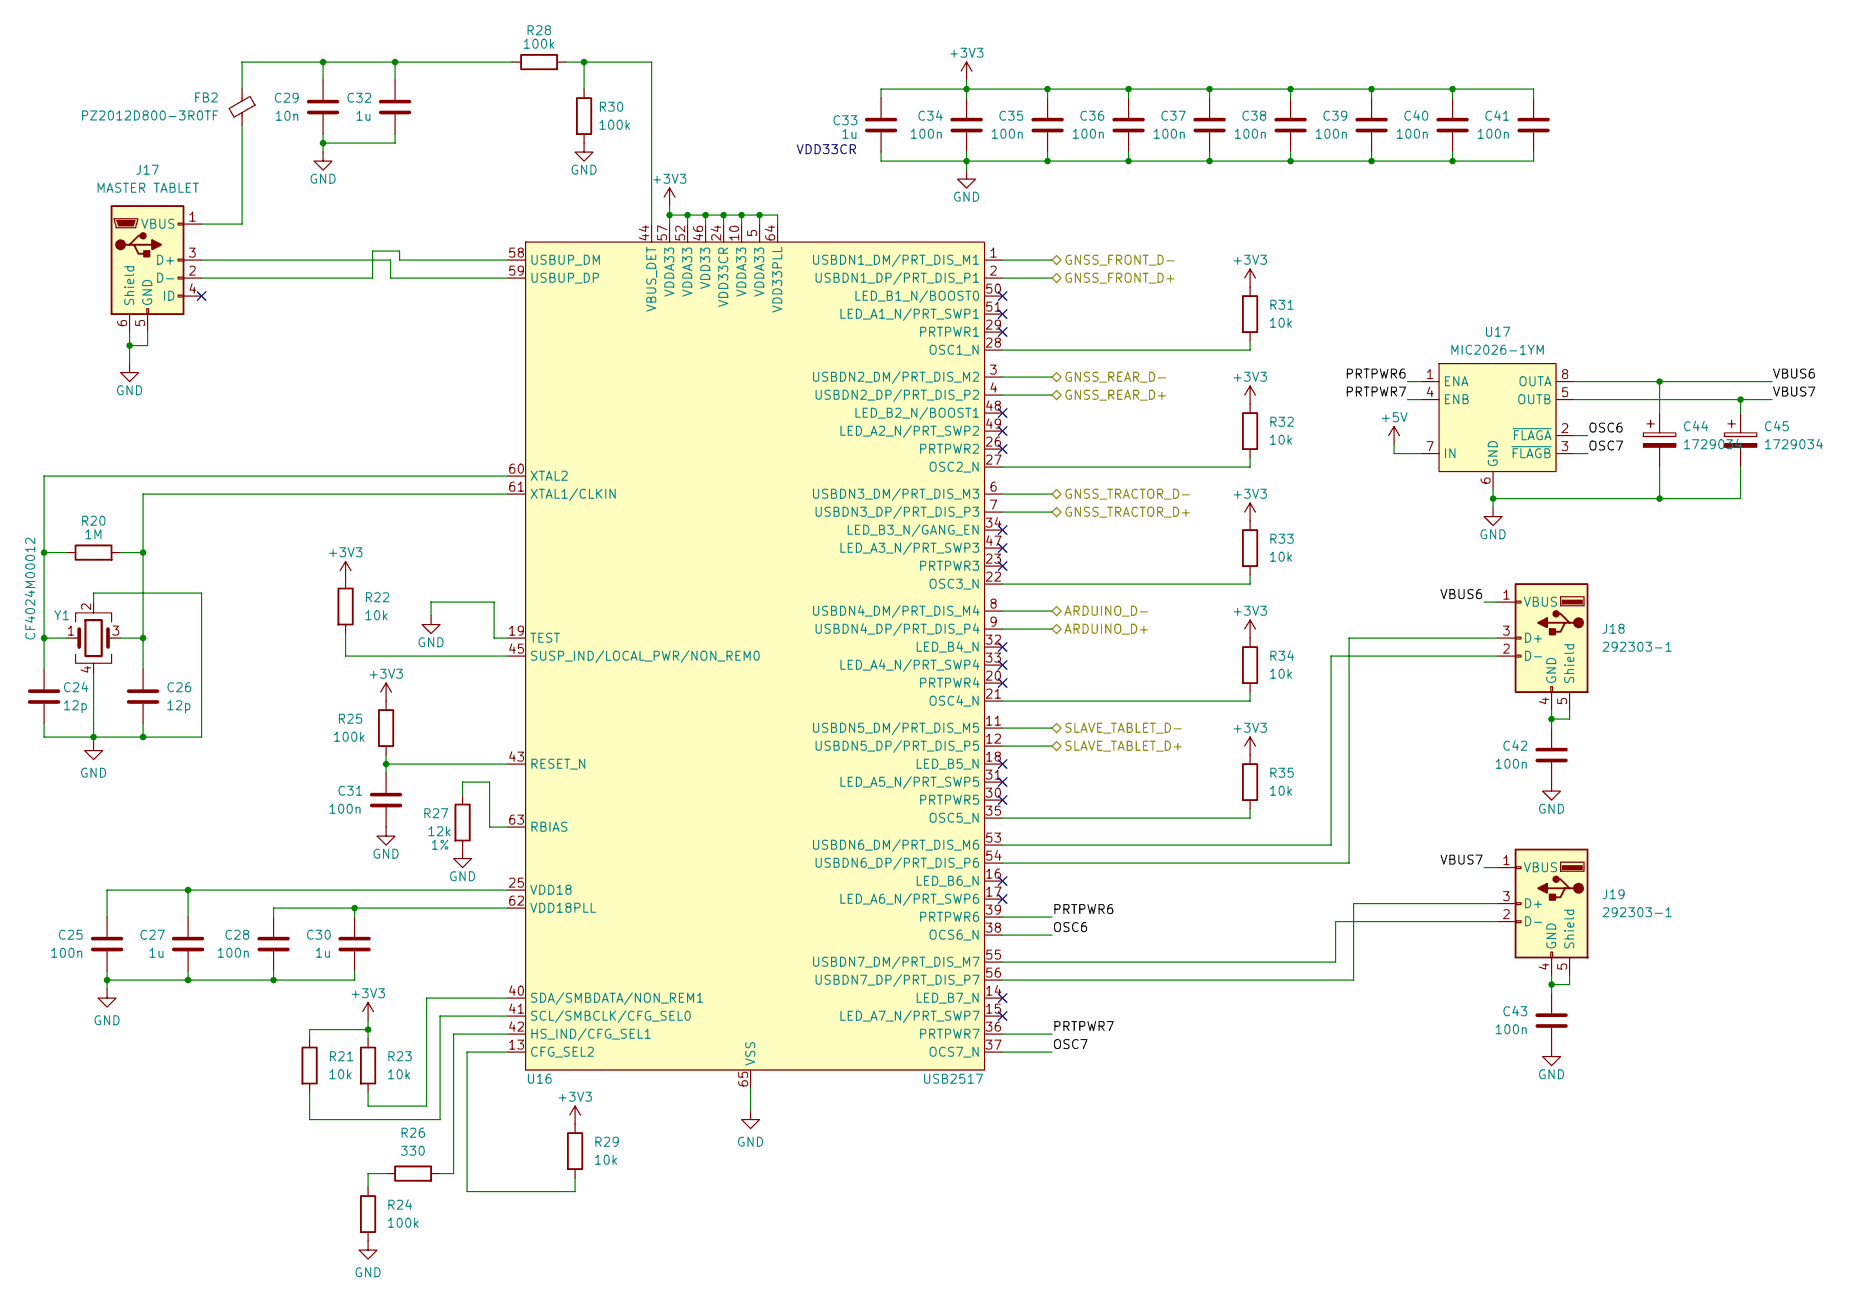
[picture p64: schematic USB Hub.kicad_sch, Tandem Leveller Controller]

Parts:
C24, C26: 12p; C_0805_2012Metric; LCSC C1792
C25, C28, C31, C34, C35, C36, C37, C38, C39, C40, C41, C42, C43: 100n; C_0805_2012Metric; LCSC C1711
C27, C30, C32, C33: 1u; C_0805_2012Metric; LCSC C24123
C29: 10n; C_0805_2012Metric; LCSC C1710
C44, C45: 1729034; CP_Elec_6.3x5.9; LCSC C340733
FB2: PZ2012D800-3R0TF; R_0805_2012Metric; LCSC C12389
J17: MASTER TABLET; USB_Micro-B_Amphenol_10103594-0001LF_Horizontal; LCSC C428495
J18, J19: 292303-1; LCSC C86461
R20: 1M; R_0805_2012Metric; LCSC C17514
R21, R22, R23, R29, R31, R32, R33, R34, R35: 10k; R_0805_2012Metric; LCSC C17414
R24, R25, R28, R30: 100k; R_0805_2012Metric; LCSC C17407
R26: 330; R_0805_2012Metric; LCSC C17630
R27: 12k; R_0805_2012Metric; Tolerance 1%; LCSC C17444
U16: USB2517; QFN-64-1EP_9x9mm_P0.5mm_EP4.7x4.7mm_ThermalVias; LCSC C1521556
U17: MIC2026-1YM; SOIC-8_3.9x4.9mm_P1.27mm; LCSC C144190
Y1: CF4024M00012; FA-238; LCSC C5765976

Connections:
+3V3: C33.1, C34.1, C35.1, C36.1, C37.1, C38.1, C39.1, C40.1, C41.1, R21.1, R22.1, R23.1, R25.1, R29.1, R31.1, R32.1, R33.1, R34.1, R35.1, U16.5 (VDDA33), U16.10 (VDDA33), U16.24 (VDD33CR), U16.46 (VDD33), U16.52 (VDDA33), U16.57 (VDDA33), U16.64 (VDD33PLL); also elsewhere on the board
+5V: U17.7 (IN); also elsewhere on the board
/Slave Tablet/SLAVE_TABLET_D+: U16.12 (USBDN5_DP/PRT_DIS_P5); also elsewhere on the board
/Slave Tablet/SLAVE_TABLET_D-: U16.11 (USBDN5_DM/PRT_DIS_M5); also elsewhere on the board
/USB Devices/ARDUINO_D+: U16.9 (USBDN4_DP/PRT_DIS_P4); also elsewhere on the board
/USB Devices/ARDUINO_D-: U16.8 (USBDN4_DM/PRT_DIS_M4); also elsewhere on the board
/USB Devices/GNSS_FRONT_D+: U16.2 (USBDN1_DP/PRT_DIS_P1); also elsewhere on the board
/USB Devices/GNSS_FRONT_D-: U16.1 (USBDN1_DM/PRT_DIS_M1); also elsewhere on the board
/USB Devices/GNSS_REAR_D+: U16.4 (USBDN2_DP/PRT_DIS_P2); also elsewhere on the board
/USB Devices/GNSS_REAR_D-: U16.3 (USBDN2_DM/PRT_DIS_M2); also elsewhere on the board
/USB Devices/GNSS_TRACTOR_D+: U16.7 (USBDN3_DP/PRT_DIS_P3); also elsewhere on the board
/USB Devices/GNSS_TRACTOR_D-: U16.6 (USBDN3_DM/PRT_DIS_M3); also elsewhere on the board
/USB Hub/OSC6: U16.38 (OCS6_N), U17.2 (~FLAGA)
/USB Hub/OSC7: U16.37 (OCS7_N), U17.3 (~FLAGB)
/USB Hub/PRTPWR6: U16.39 (PRTPWR6), U17.1 (ENA)
/USB Hub/PRTPWR7: U16.36 (PRTPWR7), U17.4 (ENB)
/USB Hub/VBUS6: C44.1, J18.1 (VBUS), U17.8 (OUTA)
/USB Hub/VBUS7: C45.1, J19.1 (VBUS), U17.5 (OUTB)
GND: C24.2, C25.2, C26.2, C27.2, C28.2, C29.2, C30.2, C31.2, C32.2, C33.2, C34.2, C35.2, C36.2, C37.2, C38.2, C39.2, C40.2, C41.2, C42.2, C43.2, C44.2, C45.2, J17.5 (GND), J17.6 (Shield), R24.2, R27.2, R30.2, U16.19 (TEST), U16.65 (VSS), U17.6 (GND), Y1.2, Y1.4; also elsewhere on the board
unnamed: C29.1, C32.1, FB2.1, R28.1
unnamed: J17.3 (D+), U16.59 (USBUP_DP)
unnamed: J17.2 (D-), U16.58 (USBUP_DM)
unnamed: FB2.2, J17.1 (VBUS)
unnamed: J18.3 (D+), U16.54 (USBDN6_DP/PRT_DIS_P6)
unnamed: J18.2 (D-), U16.53 (USBDN6_DM/PRT_DIS_M6)
unnamed: C42.1, J18.4 (GND), J18.5 (Shield)
unnamed: J19.3 (D+), U16.56 (USBDN7_DP/PRT_DIS_P7)
unnamed: J19.2 (D-), U16.55 (USBDN7_DM/PRT_DIS_M7)
unnamed: C43.1, J19.4 (GND), J19.5 (Shield)
unnamed: R24.1, R26.1
unnamed: R29.2, U16.13 (CFG_SEL2)
unnamed: R26.2, U16.42 (HS_IND/CFG_SEL1)
unnamed: R31.2, U16.28 (OSC1_N)
unnamed: R32.2, U16.27 (OSC2_N)
unnamed: R33.2, U16.22 (OSC3_N)
unnamed: R34.2, U16.21 (OSC4_N)
unnamed: R35.2, U16.35 (OSC5_N)
unnamed: R27.1, U16.63 (RBIAS)
unnamed: C31.1, R25.2, U16.43 (RESET_N)
unnamed: R21.2, U16.41 (SCL/SMBCLK/CFG_SEL0)
unnamed: R23.2, U16.40 (SDA/SMBDATA/NON_REM1)
unnamed: R22.2, U16.45 (SUSP_IND/LOCAL_PWR/NON_REM0)
unnamed: R28.2, R30.1, U16.44 (VBUS_DET)
unnamed: C25.1, C27.1, U16.25 (VDD18)
unnamed: C28.1, C30.1, U16.62 (VDD18PLL)
unnamed: C26.1, R20.2, U16.61 (XTAL1/CLKIN), Y1.3
unnamed: C24.1, R20.1, U16.60 (XTAL2), Y1.1

Notes on the sheet:
VDD33CR

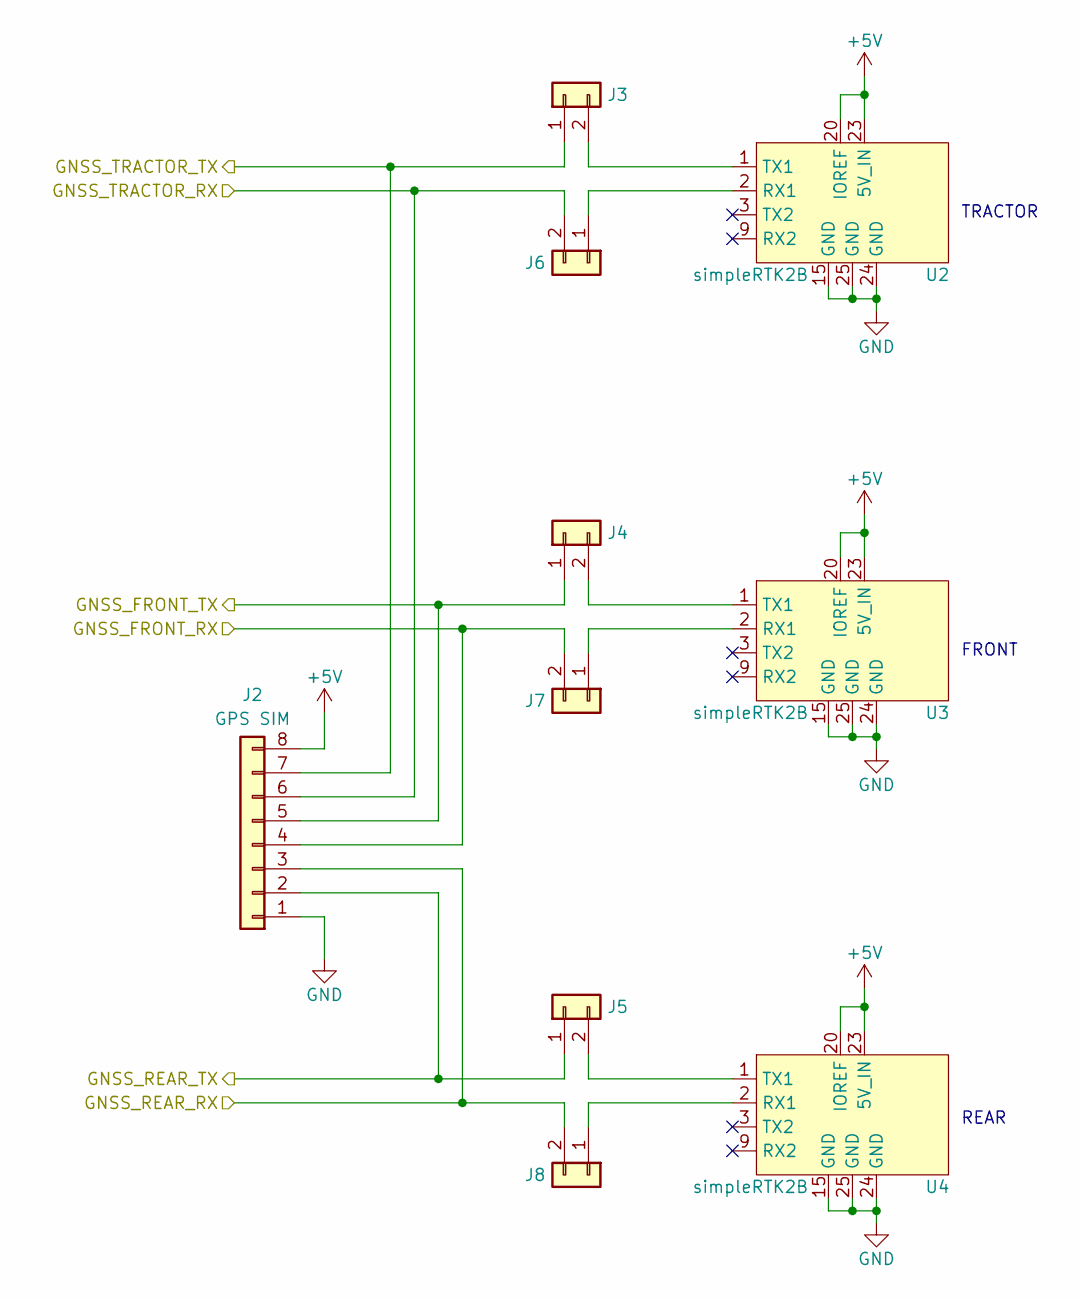
[picture p65: schematic GNSS.kicad_sch, Tandem Leveller Controller]

Parts:
J2: GPS SIM; JST_PH_B8B-PH-K_1x08_P2.00mm_Vertical; LCSC C157974
J3, J4, J5, J6, J7, J8: Conn_01x02; PinHeader_1x02_P2.54mm_Vertical; LCSC C7494857
U2, U3, U4: simpleRTK2B

Connections:
+5V: J2.8, U2.20 (IOREF), U2.23 (5V_IN), U3.20 (IOREF), U3.23 (5V_IN), U4.20 (IOREF), U4.23 (5V_IN); also elsewhere on the board
/GNSS/GNSS_FRONT_RX: J2.4, J7.2; also elsewhere on the board
/GNSS/GNSS_FRONT_TX: J2.5, J4.1; also elsewhere on the board
/GNSS/GNSS_REAR_RX: J2.3, J8.2; also elsewhere on the board
/GNSS/GNSS_REAR_TX: J2.2, J5.1; also elsewhere on the board
/GNSS/GNSS_TRACTOR_RX: J2.6, J6.2; also elsewhere on the board
/GNSS/GNSS_TRACTOR_TX: J2.7, J3.1; also elsewhere on the board
GND: J2.1, U2.15 (GND), U2.24 (GND), U2.25 (GND), U3.15 (GND), U3.24 (GND), U3.25 (GND), U4.15 (GND), U4.24 (GND), U4.25 (GND); also elsewhere on the board
unnamed: J3.2, U2.1 (TX1)
unnamed: J4.2, U3.1 (TX1)
unnamed: J5.2, U4.1 (TX1)
unnamed: J6.1, U2.2 (RX1)
unnamed: J7.1, U3.2 (RX1)
unnamed: J8.1, U4.2 (RX1)

Notes on the sheet:
FRONT
REAR
TRACTOR

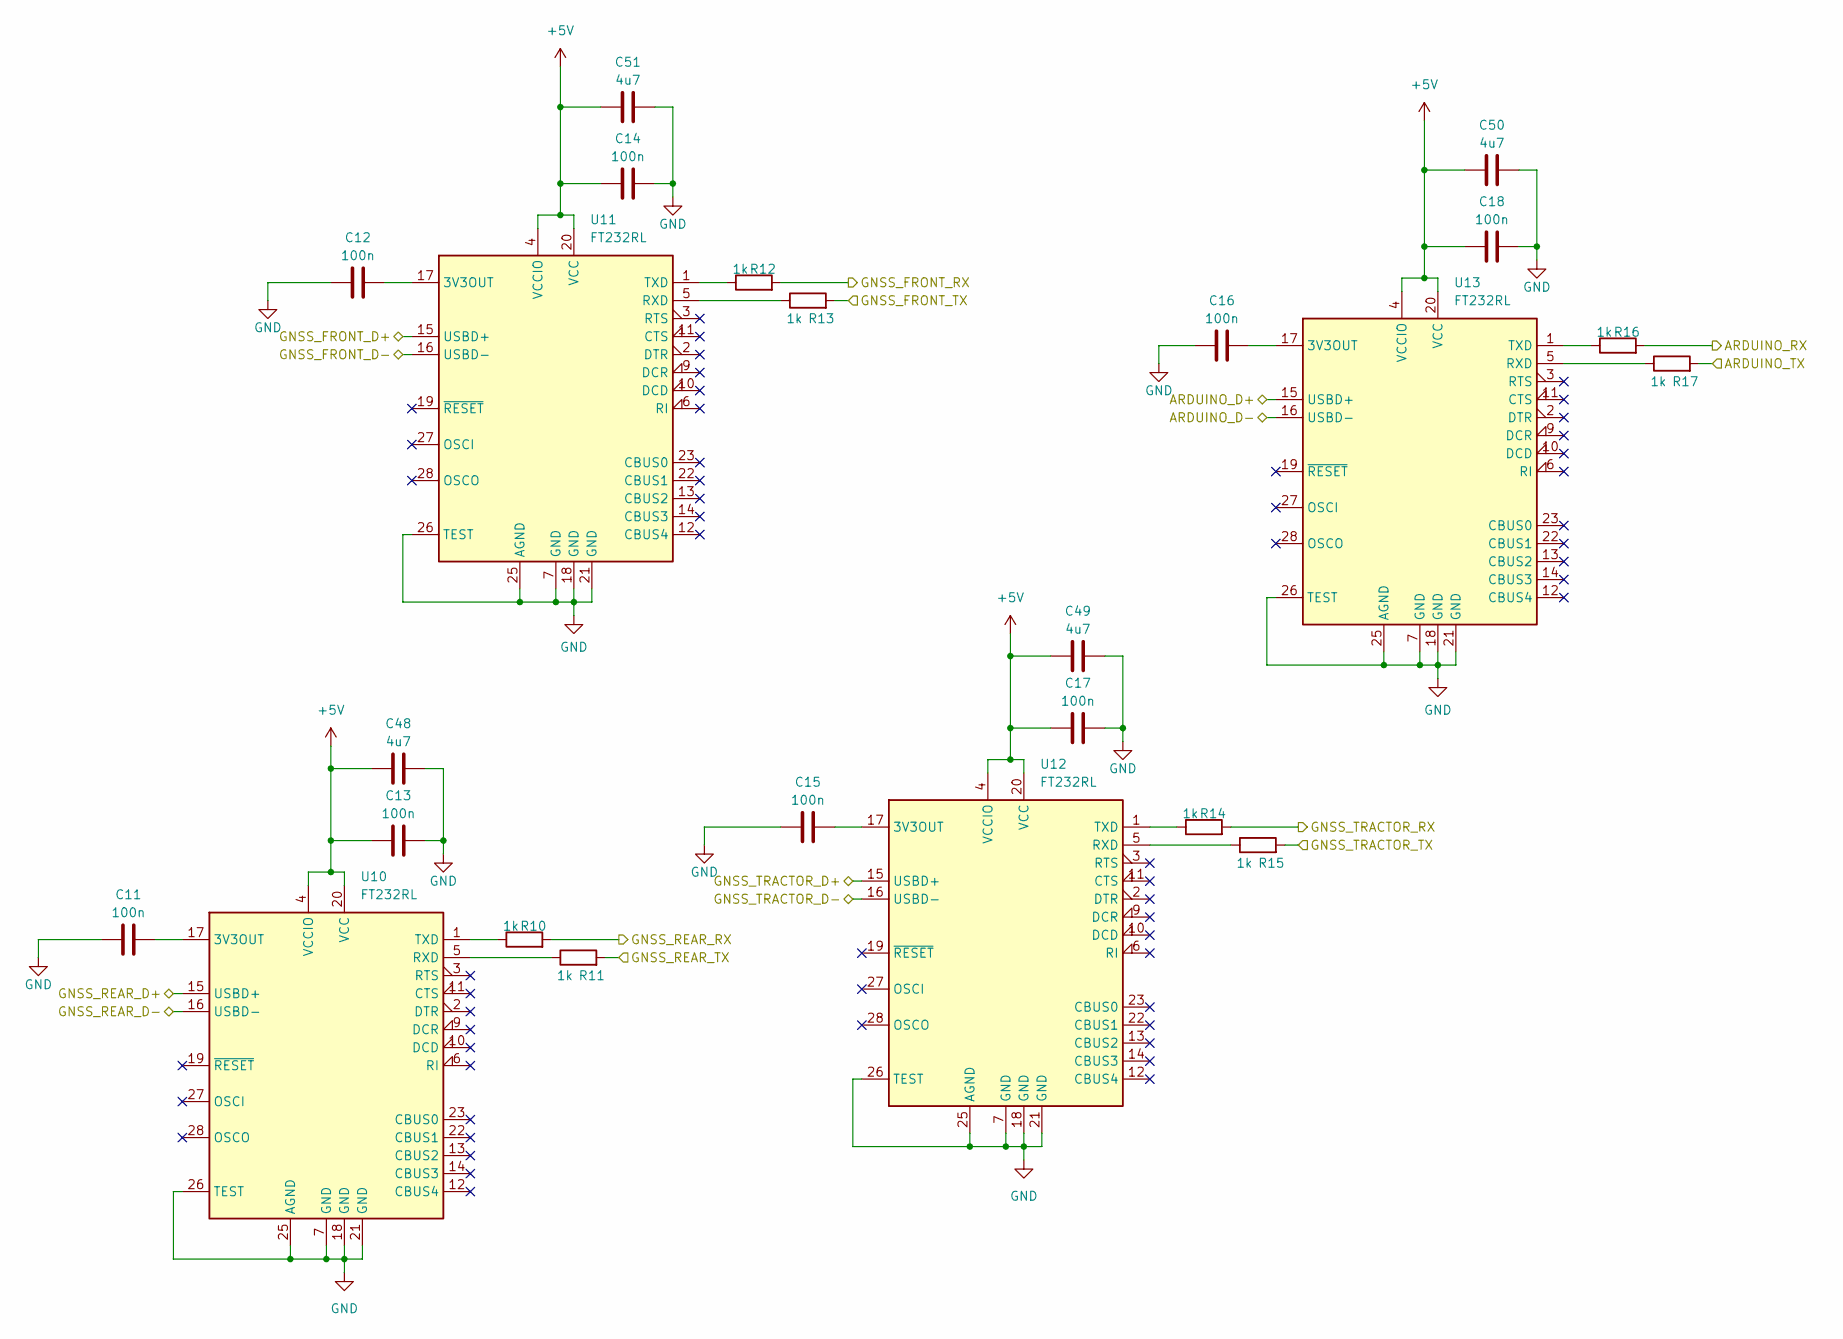
[picture p66: schematic USB Devices.kicad_sch, Tandem Leveller Controller]

Parts:
C11, C12, C13, C14, C15, C16, C17, C18: 100n; C_0805_2012Metric; LCSC C1711
C48, C49, C50, C51: 4u7; C_0805_2012Metric; LCSC C1779
R10, R11, R12, R13, R14, R15, R16, R17: 1k; R_0805_2012Metric; LCSC C17513
U10, U11, U12, U13: FT232RL; SSOP-28_5.3x10.2mm_P0.65mm; LCSC C8690

Connections:
+5V: C13.1, C14.1, C17.1, C18.1, C48.1, C49.1, C50.1, C51.1, U10.4 (VCCIO), U10.20 (VCC), U11.4 (VCCIO), U11.20 (VCC), U12.4 (VCCIO), U12.20 (VCC), U13.4 (VCCIO), U13.20 (VCC); also elsewhere on the board
/GNSS/GNSS_FRONT_RX: R12.2; also elsewhere on the board
/GNSS/GNSS_FRONT_TX: R13.2; also elsewhere on the board
/GNSS/GNSS_REAR_RX: R10.2; also elsewhere on the board
/GNSS/GNSS_REAR_TX: R11.2; also elsewhere on the board
/GNSS/GNSS_TRACTOR_RX: R14.2; also elsewhere on the board
/GNSS/GNSS_TRACTOR_TX: R15.2; also elsewhere on the board
/USB Devices/ARDUINO_D+: U13.15 (USBD+); also elsewhere on the board
/USB Devices/ARDUINO_D-: U13.16 (USBD-); also elsewhere on the board
/USB Devices/ARDUINO_RX: R16.2; also elsewhere on the board
/USB Devices/ARDUINO_TX: R17.2; also elsewhere on the board
/USB Devices/GNSS_FRONT_D+: U11.15 (USBD+); also elsewhere on the board
/USB Devices/GNSS_FRONT_D-: U11.16 (USBD-); also elsewhere on the board
/USB Devices/GNSS_REAR_D+: U10.15 (USBD+); also elsewhere on the board
/USB Devices/GNSS_REAR_D-: U10.16 (USBD-); also elsewhere on the board
/USB Devices/GNSS_TRACTOR_D+: U12.15 (USBD+); also elsewhere on the board
/USB Devices/GNSS_TRACTOR_D-: U12.16 (USBD-); also elsewhere on the board
GND: C11.1, C12.1, C13.2, C14.2, C15.1, C16.1, C17.2, C18.2, C48.2, C49.2, C50.2, C51.2, U10.7 (GND), U10.18 (GND), U10.21 (GND), U10.25 (AGND), U10.26 (TEST), U11.7 (GND), U11.18 (GND), U11.21 (GND), U11.25 (AGND), U11.26 (TEST), U12.7 (GND), U12.18 (GND), U12.21 (GND), U12.25 (AGND), U12.26 (TEST), U13.7 (GND), U13.18 (GND), U13.21 (GND), U13.25 (AGND), U13.26 (TEST); also elsewhere on the board
unnamed: C11.2, U10.17 (3V3OUT)
unnamed: R11.1, U10.5 (RXD)
unnamed: R10.1, U10.1 (TXD)
unnamed: C12.2, U11.17 (3V3OUT)
unnamed: R13.1, U11.5 (RXD)
unnamed: R12.1, U11.1 (TXD)
unnamed: C15.2, U12.17 (3V3OUT)
unnamed: R15.1, U12.5 (RXD)
unnamed: R14.1, U12.1 (TXD)
unnamed: C16.2, U13.17 (3V3OUT)
unnamed: R17.1, U13.5 (RXD)
unnamed: R16.1, U13.1 (TXD)

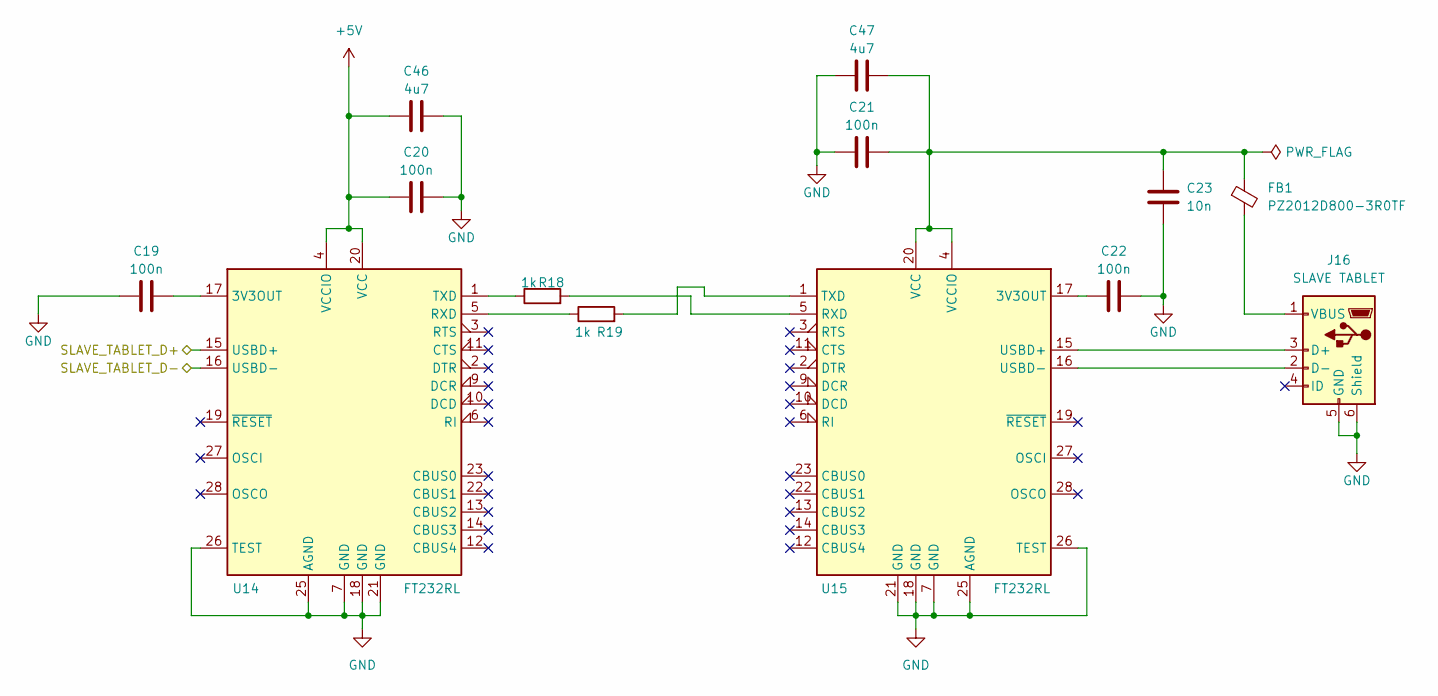
[picture p67: schematic Slave Tablet.kicad_sch, Tandem Leveller Controller]

Parts:
C19, C20, C21, C22: 100n; C_0805_2012Metric; LCSC C1711
C23: 10n; C_0805_2012Metric; LCSC C1710
C46, C47: 4u7; C_0805_2012Metric; LCSC C1779
FB1: PZ2012D800-3R0TF; R_0805_2012Metric; LCSC C12389
J16: SLAVE TABLET; USB_Micro-B_Amphenol_10103594-0001LF_Horizontal; LCSC C428495
R18, R19: 1k; R_0805_2012Metric; LCSC C17513
U14, U15: FT232RL; SSOP-28_5.3x10.2mm_P0.65mm; LCSC C8690

Connections:
+5V: C20.1, C46.1, U14.4 (VCCIO), U14.20 (VCC); also elsewhere on the board
/Slave Tablet/SLAVE_TABLET_D+: U14.15 (USBD+); also elsewhere on the board
/Slave Tablet/SLAVE_TABLET_D-: U14.16 (USBD-); also elsewhere on the board
GND: C19.1, C20.2, C21.2, C22.1, C23.2, C46.2, C47.1, J16.5 (GND), J16.6 (Shield), U14.7 (GND), U14.18 (GND), U14.21 (GND), U14.25 (AGND), U14.26 (TEST), U15.7 (GND), U15.18 (GND), U15.21 (GND), U15.25 (AGND), U15.26 (TEST); also elsewhere on the board
unnamed: J16.3 (D+), U15.15 (USBD+)
unnamed: J16.2 (D-), U15.16 (USBD-)
unnamed: FB1.2, J16.1 (VBUS)
unnamed: C19.2, U14.17 (3V3OUT)
unnamed: R19.1, U14.5 (RXD)
unnamed: R18.1, U14.1 (TXD)
unnamed: C22.2, U15.17 (3V3OUT)
unnamed: R18.2, U15.5 (RXD)
unnamed: R19.2, U15.1 (TXD)
unnamed: C21.1, C23.1, C47.2, FB1.1, U15.4 (VCCIO), U15.20 (VCC)

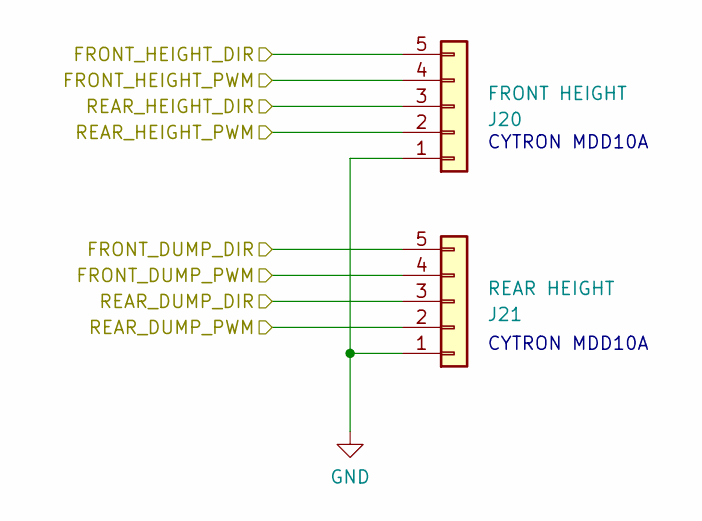
[picture p68: schematic Valve Control.kicad_sch, Tandem Leveller Controller]

Parts:
J20: FRONT HEIGHT; JST_PH_B5B-PH-K_1x05_P2.00mm_Vertical; LCSC C157993
J21: REAR HEIGHT; JST_PH_B5B-PH-K_1x05_P2.00mm_Vertical; LCSC C157993

Connections:
/Valve Control/FRONT_DUMP_DIR: J21.5; also elsewhere on the board
/Valve Control/FRONT_DUMP_PWM: J21.4; also elsewhere on the board
/Valve Control/FRONT_HEIGHT_DIR: J20.5; also elsewhere on the board
/Valve Control/FRONT_HEIGHT_PWM: J20.4; also elsewhere on the board
/Valve Control/REAR_DUMP_DIR: J21.3; also elsewhere on the board
/Valve Control/REAR_DUMP_PWM: J21.2; also elsewhere on the board
/Valve Control/REAR_HEIGHT_DIR: J20.3; also elsewhere on the board
/Valve Control/REAR_HEIGHT_PWM: J20.2; also elsewhere on the board
GND: J20.1, J21.1; also elsewhere on the board

Notes on the sheet:
CYTRON MDD10A

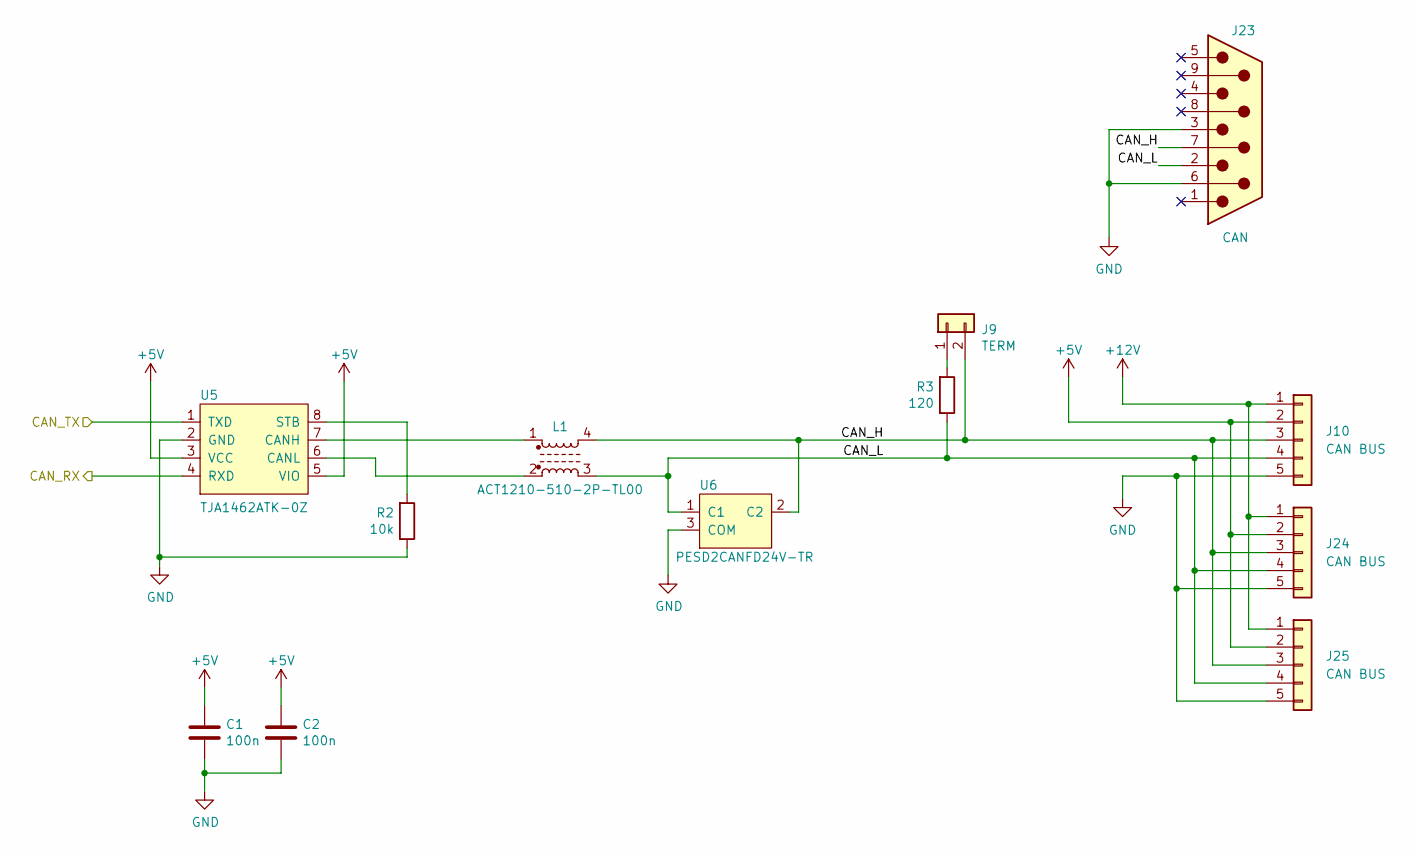
[picture p69: schematic IMU.kicad_sch, Tandem Leveller Controller]

Parts:
C1, C2: 100n; C_0805_2012Metric; LCSC C1711
J9: TERM; PinHeader_1x02_P2.54mm_Vertical; LCSC C7494857
J10, J24, J25: CAN BUS; JST_PH_B5B-PH-K_1x05_P2.00mm_Vertical; LCSC C157993
J23: CAN; DB9_RA_MALE_LD09P13A4; LCSC C3103673
L1: ACT1210-510-2P-TL00; LCSC C95572
R2: 10k; R_0805_2012Metric; LCSC C17414
R3: 120; R_0805_2012Metric; LCSC C17437
U5: TJA1462ATK-0Z; HVSON8_0_65mm; LCSC C3229259
U6: PESD2CANFD24V-TR; SOT-23; LCSC C552486

Connections:
+5V: C1.1, C2.1, J10.2, J24.2, J25.2, U5.3 (VCC), U5.5 (VIO); also elsewhere on the board
+12V: J10.1, J24.1, J25.1; also elsewhere on the board
/CAN/CAN_H: J9.2, J10.3, J23.7, J24.3, J25.3, L1.4, U6.2 (C2)
/CAN/CAN_L: J10.4, J23.2, J24.4, J25.4, L1.3, R3.1, U6.1 (C1)
/CAN/CAN_RX: U5.4 (RXD); also elsewhere on the board
/CAN/CAN_TX: U5.1 (TXD); also elsewhere on the board
GND: C1.2, C2.2, J10.5, J23.3, J23.6, J24.5, J25.5, R2.1, U5.2 (GND), U6.3 (COM); also elsewhere on the board
unnamed: J9.1, R3.2
unnamed: L1.1, U5.7 (CANH)
unnamed: L1.2, U5.6 (CANL)
unnamed: R2.2, U5.8 (STB)

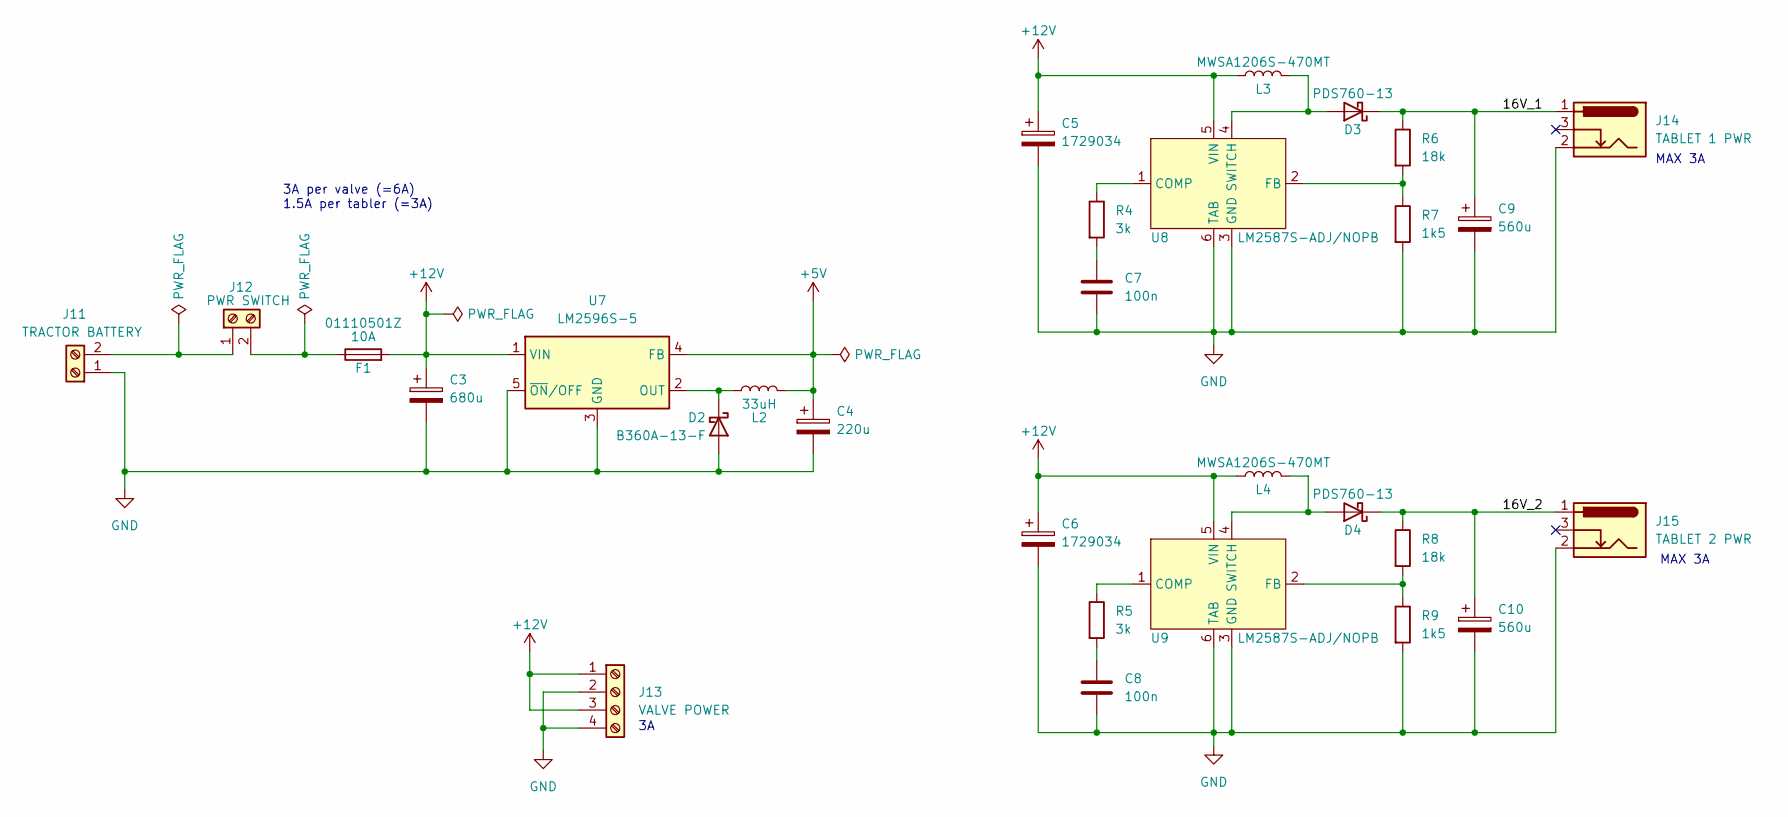
[picture p70: schematic Power.kicad_sch, Tandem Leveller Controller]

Parts:
C3: 680u; CP_Elec_10x10.5; LCSC C50456
C4: 220u; CP_Elec_8x6.5; LCSC C3340
C5, C6: 1729034; CP_Elec_6.3x5.9; LCSC C340733
C7, C8: 100n; C_0805_2012Metric; LCSC C1711
C9, C10: 560u; CP_Elec_10x10.5; LCSC C1984785
D2: B360A-13-F; D_SMA; LCSC C6807778
D3, D4: PDS760-13; D_PowerDI-5; LCSC C3018534
F1: 10A; 5x20 Fuse Holder; LCSC C151075
J11: TRACTOR BATTERY; PhoenixContact_COMBICON_MKDSN_2; LCSC C3820334
J12: PWR SWITCH; PhoenixContact_COMBICON_MKDSN_2; LCSC C3820334
J13: VALVE POWER; PhoenixContact_COMBICON_PT_4; LCSC C7032066
J14: TABLET 1 PWR; BarrelJack_Wuerth_6941xx301002; LCSC C5441017
J15: TABLET 2 PWR; BarrelJack_Wuerth_6941xx301002; LCSC C5441017
L2: 33uH; MWSA0603S-330MT; LCSC C408454
L3, L4: MWSA1206S-470MT; LCSC C408531
R4, R5: 3k; R_0805_2012Metric; LCSC C17661
R6, R8: 18k; R_0805_2012Metric; LCSC C17506
R7, R9: 1k5; R_0805_2012Metric; LCSC C4310
U7: LM2596S-5; TO-263-5_TabPin3; LCSC C5276750
U8, U9: LM2587S-ADJ/NOPB; TO-263-5_TabPin6; LCSC C1355343

Connections:
+5V: C4.1, L2.2, U7.4 (FB); also elsewhere on the board
+12V: C3.1, C5.1, C6.1, F1.2, J13.1, J13.3, L3.1, L4.1, U7.1 (VIN), U8.5 (VIN), U9.5 (VIN); also elsewhere on the board
/Power/16V_1: C9.1, D3.1 (K), J14.1, R6.1
/Power/16V_2: C10.1, D4.1 (K), J15.1, R8.1
GND: C3.2, C4.2, C5.2, C6.2, C7.2, C8.2, C9.2, C10.2, D2.2 (A), J11.1, J13.2, J13.4, J14.2, J15.2, R7.2, R9.2, U7.3 (GND), U7.5 (~ON/OFF), U8.3 (GND), U8.6 (TAB), U9.3 (GND), U9.6 (TAB); also elsewhere on the board
unnamed: C7.1, R4.2
unnamed: C8.1, R5.2
unnamed: D2.1 (K), L2.1, U7.2 (OUT)
unnamed: D3.2 (A), L3.2, U8.4 (SWITCH)
unnamed: D4.2 (A), L4.2, U9.4 (SWITCH)
unnamed: J11.2, J12.1
unnamed: F1.1, J12.2
unnamed: R4.1, U8.1 (COMP)
unnamed: R6.2, R7.1, U8.2 (FB)
unnamed: R5.1, U9.1 (COMP)
unnamed: R8.2, R9.1, U9.2 (FB)

Notes on the sheet:
MAX 3A
3A per valve (=6A) 1.5A per tabler (=3A)

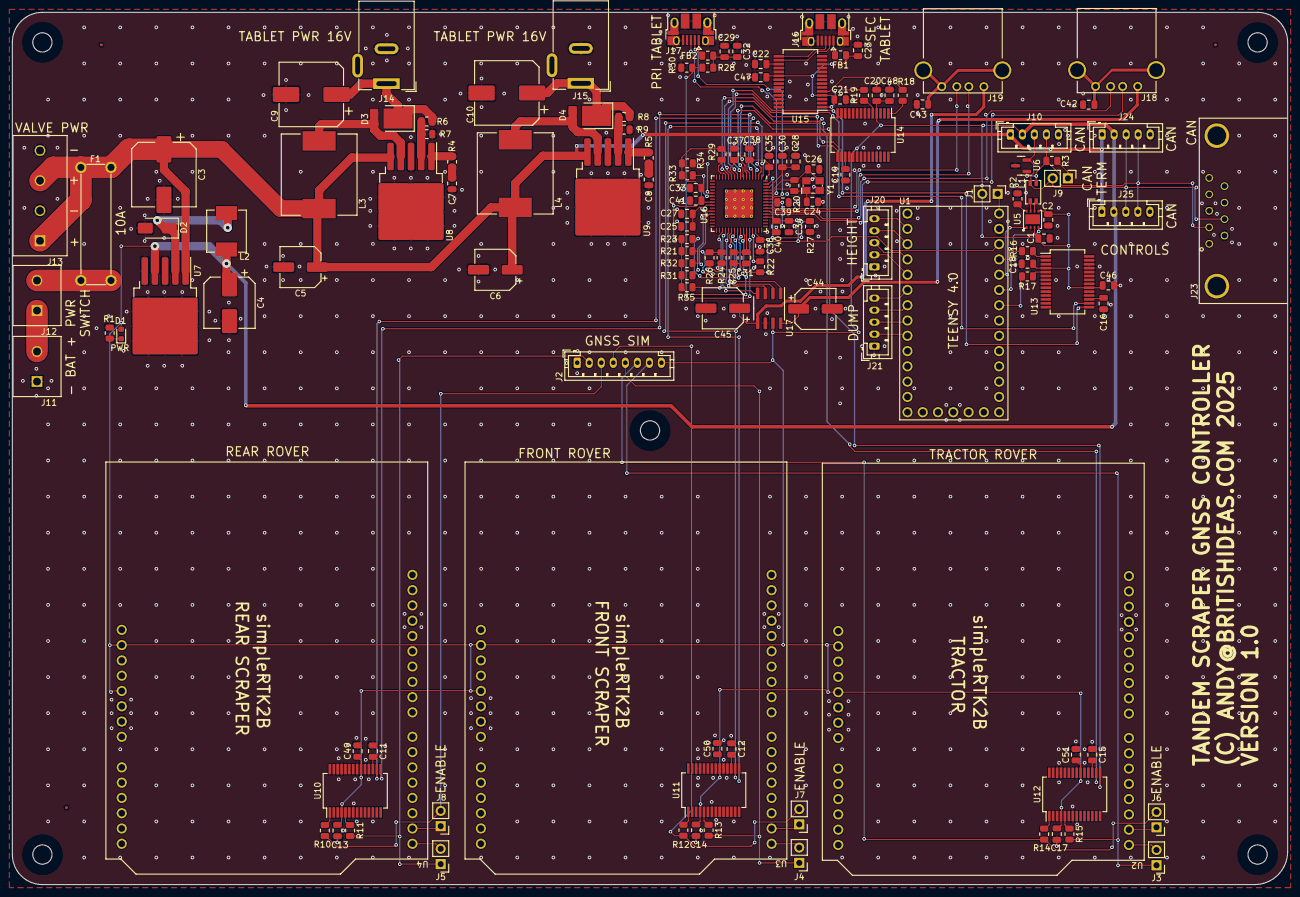
[picture p71: board Tandem Leveller Controller.kicad_pcb from above]

Board: 2 copper layers, 212.0 x 145.0 mm, 142 parts (0 on the bottom side), 115 nets.
