ajayre/tandemleveller/Electronics/IMU/IMU.kicad_pcb

## KiCad design Electronics/IMU/IMU.kicad_pcb (2025-03-13)

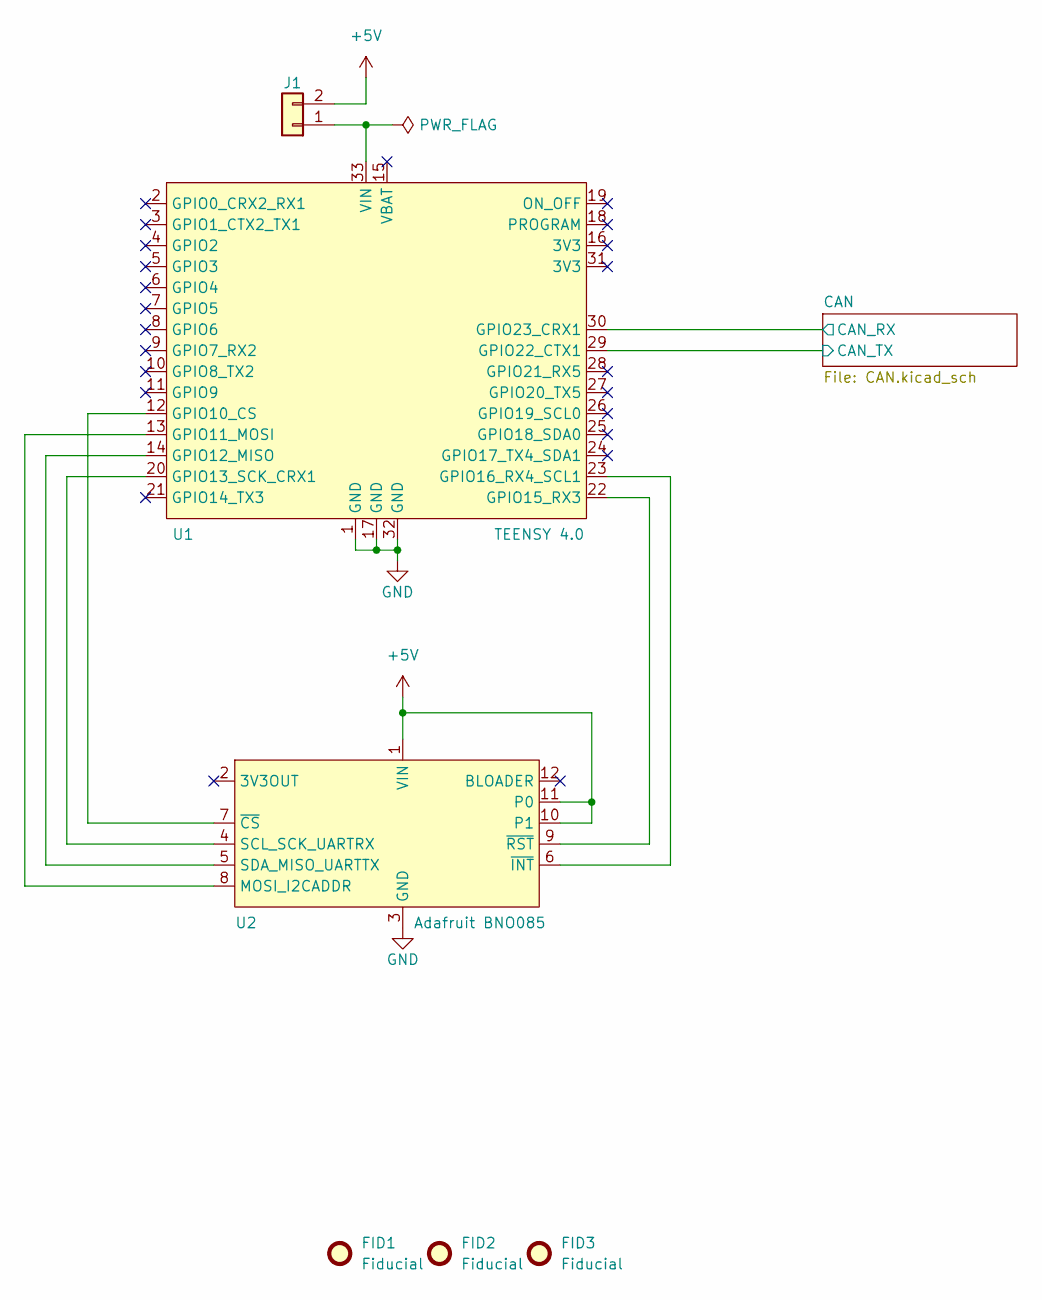
[picture p72: schematic IMU.kicad_sch, Tandem Leveller IMU]

Parts:
FID1, FID2, FID3: Fiducial; Fiducial_0.5mm_Mask1mm
J1: Conn_01x02; PinHeader_1x02_P2.54mm_Vertical; LCSC C7494857
U1: TEENSY 4.0; Teensy_4.0
U2: Adafruit BNO085; Adafruit_BNO085

Connections:
+5V: J1.2, U2.1 (VIN), U2.10 (P1), U2.11 (P0); also elsewhere on the board
/CAN/CAN_RX: U1.30 (GPIO23_CRX1); also elsewhere on the board
/CAN/CAN_TX: U1.29 (GPIO22_CTX1); also elsewhere on the board
GND: U1.1 (GND), U1.17 (GND), U1.32 (GND), U2.3 (GND); also elsewhere on the board
unnamed: J1.1, U1.33 (VIN)
unnamed: U1.12 (GPIO10_CS), U2.7 (~CS)
unnamed: U1.13 (GPIO11_MOSI), U2.8 (MOSI_I2CADDR)
unnamed: U1.14 (GPIO12_MISO), U2.5 (SDA_MISO_UARTTX)
unnamed: U1.20 (GPIO13_SCK_CRX1), U2.4 (SCL_SCK_UARTRX)
unnamed: U1.22 (GPIO15_RX3), U2.9 (~RST)
unnamed: U1.23 (GPIO16_RX4_SCL1), U2.6 (~INT)

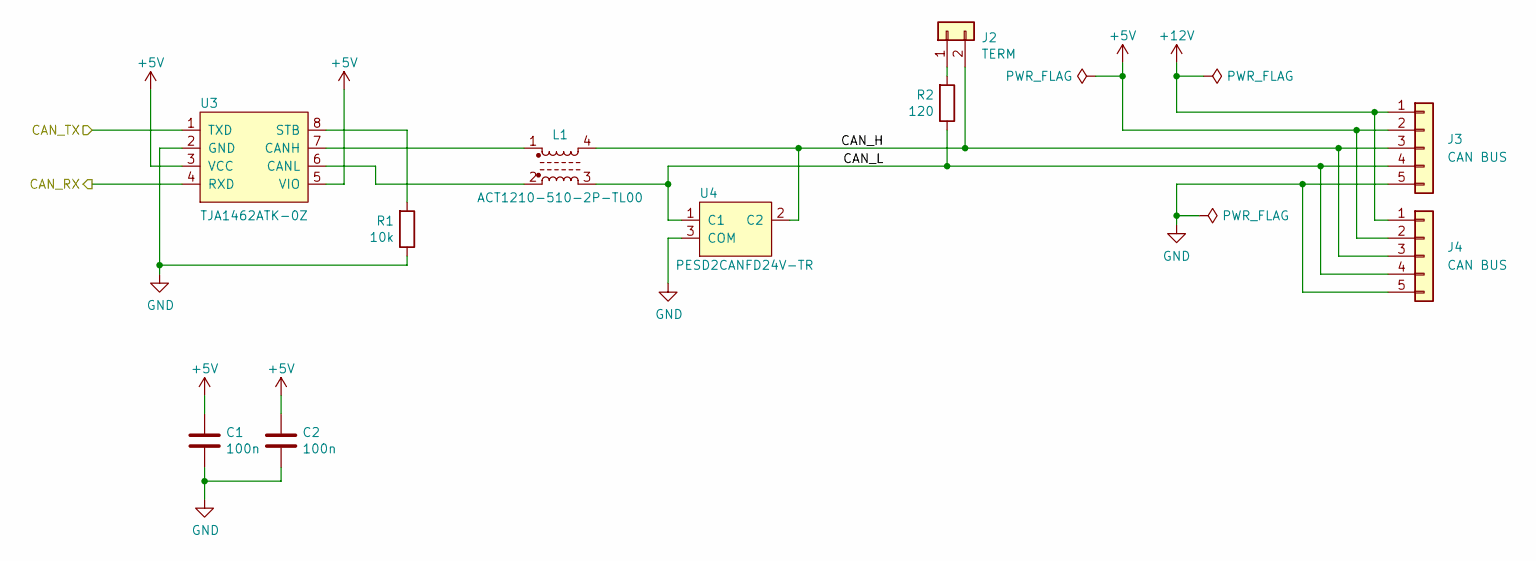
[picture p73: schematic CAN.kicad_sch, Tandem Leveller IMU]

Parts:
C1, C2: 100n; C_0805_2012Metric; LCSC C1711
J2: TERM; PinHeader_1x02_P2.54mm_Vertical; LCSC C7494857
J3, J4: CAN BUS; JST_PH_B5B-PH-K_1x05_P2.00mm_Vertical; LCSC C157993
L1: ACT1210-510-2P-TL00; LCSC C95572
R1: 10k; R_0805_2012Metric; LCSC C17414
R2: 120; R_0805_2012Metric; LCSC C17437
U3: TJA1462ATK-0Z; HVSON8_0_65mm; LCSC C3229259
U4: PESD2CANFD24V-TR; SOT-23; LCSC C552486

Connections:
+5V: C1.1, C2.1, J3.2, J4.2, U3.3 (VCC), U3.5 (VIO); also elsewhere on the board
+12V: J3.1, J4.1
/CAN/CAN_H: J2.2, J3.3, J4.3, L1.4, U4.2 (C2)
/CAN/CAN_L: J3.4, J4.4, L1.3, R2.1, U4.1 (C1)
/CAN/CAN_RX: U3.4 (RXD); also elsewhere on the board
/CAN/CAN_TX: U3.1 (TXD); also elsewhere on the board
GND: C1.2, C2.2, J3.5, J4.5, R1.1, U3.2 (GND), U4.3 (COM); also elsewhere on the board
unnamed: J2.1, R2.2
unnamed: L1.1, U3.7 (CANH)
unnamed: L1.2, U3.6 (CANL)
unnamed: R1.2, U3.8 (STB)
