ajayre/tandemleveller/Electronics/IMU/IMU.kicad_pcb

## KiCad design Electronics/IMU/IMU.kicad_pcb (continued)

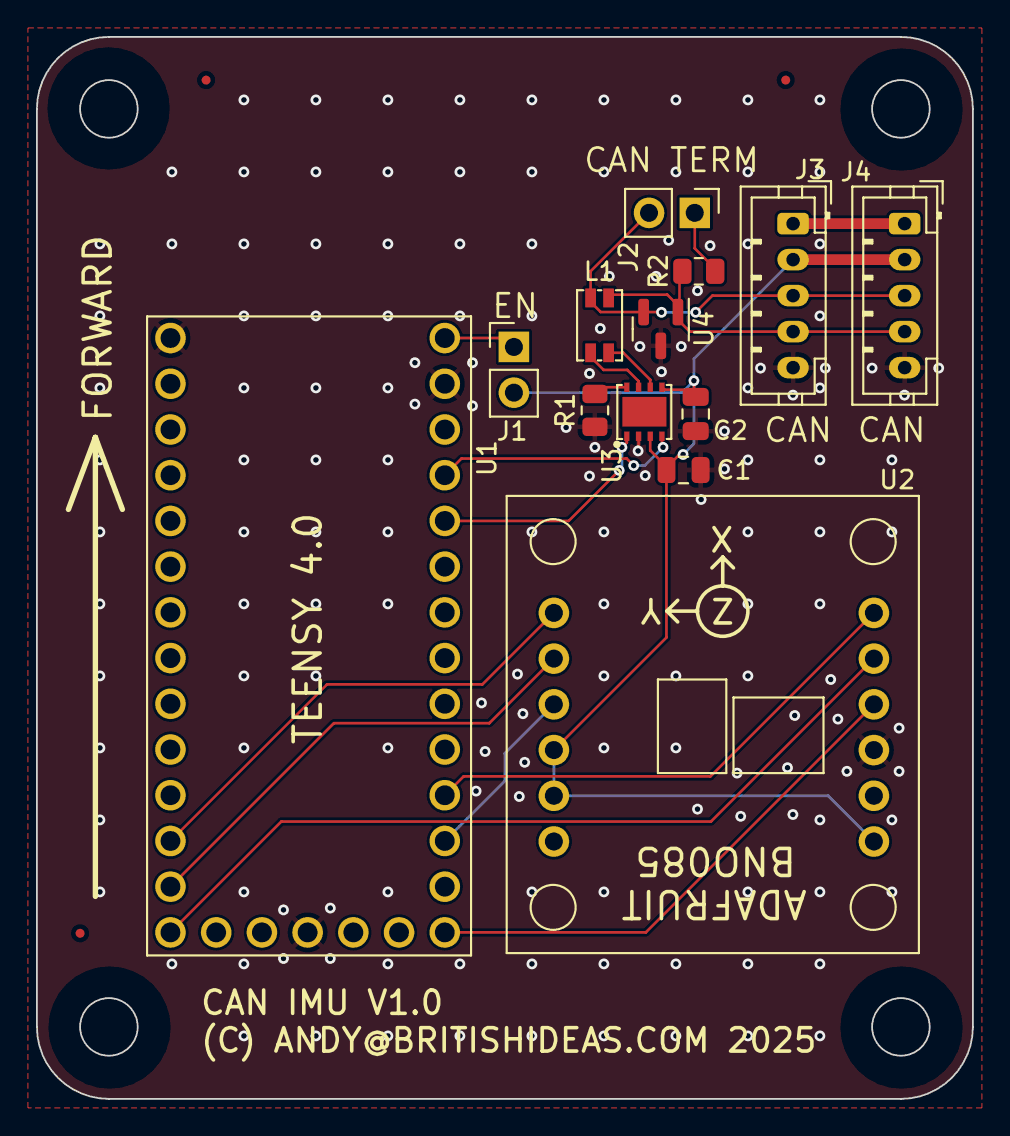
[picture p74: board IMU.kicad_pcb from above]

Board: 2 copper layers, 52.0 x 59.0 mm, 16 parts (0 on the bottom side), 18 nets.
