ajayre/tandemleveller/Electronics/GPS IMU Simulator/GPS IMU Simulator/GPS IMU Simulator.kicad_pcb

## KiCad design Electronics/GPS IMU Simulator/GPS IMU Simulator/GPS IMU Simulator.kicad_pcb (2025-03-13)

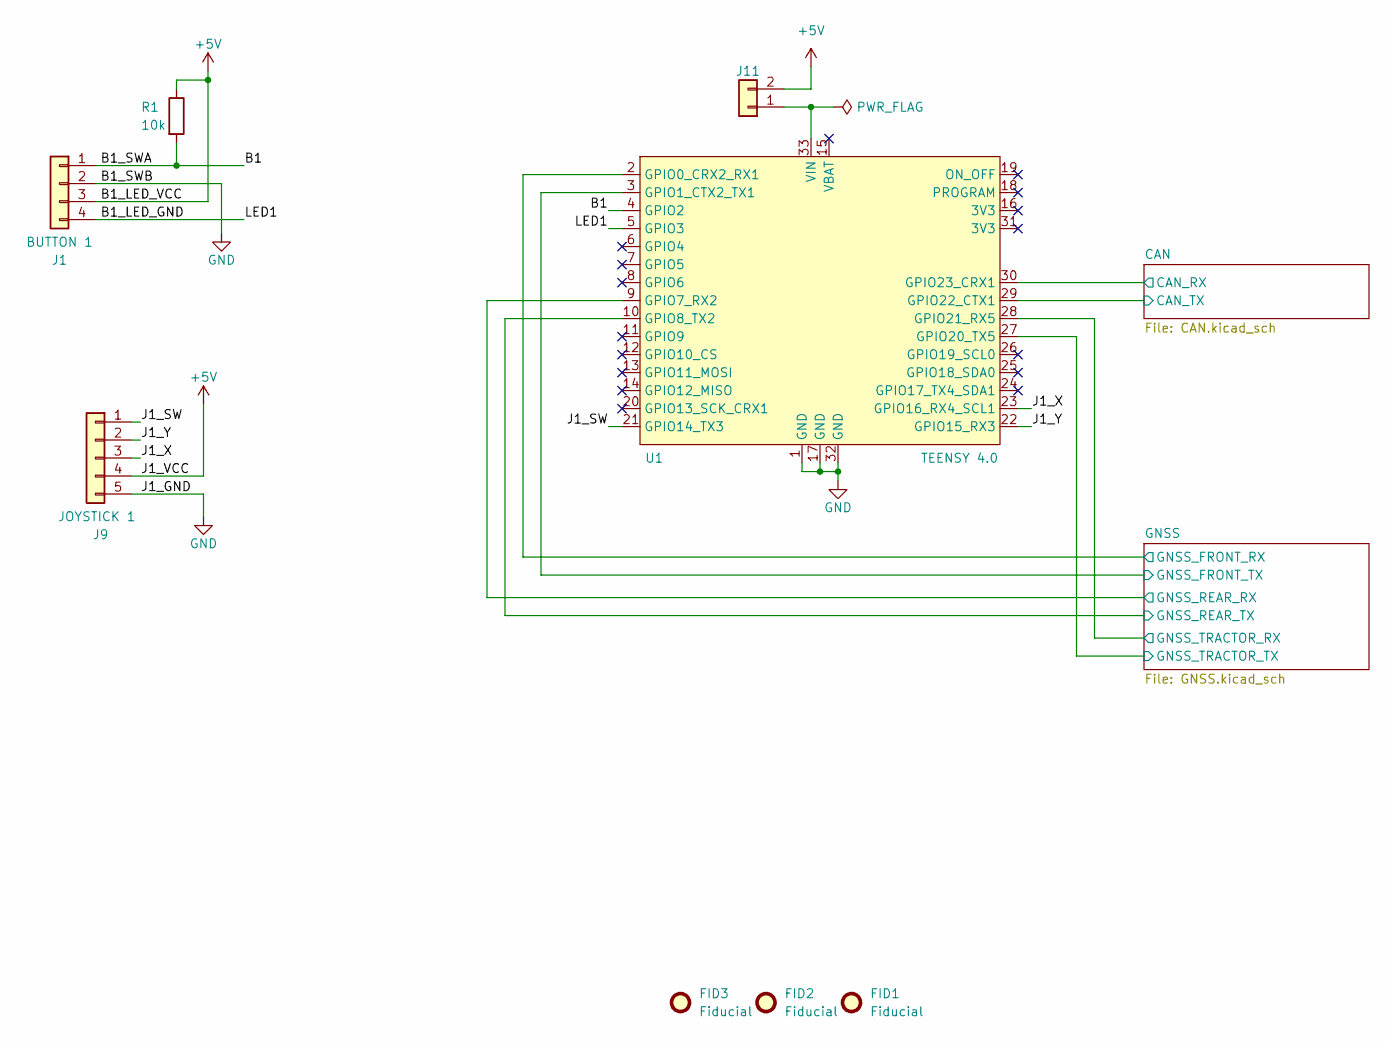
[picture p75: schematic GPS IMU Simulator.kicad_sch, GPS and IMU Simulator]

Parts:
FID1, FID2, FID3: Fiducial; Fiducial_0.5mm_Mask1mm
J1: BUTTON 1; JST_PH_B4B-PH-K_1x04_P2.00mm_Vertical; LCSC C131334
J9: JOYSTICK 1; JST_PH_B5B-PH-K_1x05_P2.00mm_Vertical; LCSC C157993
J11: Conn_01x02; PinHeader_1x02_P2.54mm_Vertical; LCSC C7494857
R1: 10k; R_0805_2012Metric; LCSC C17414
U1: TEENSY 4.0; Teensy_4.0

Connections:
+5V: J1.3, J9.4, J11.2, R1.1; also elsewhere on the board
/B1: J1.1, R1.2, U1.4 (GPIO2)
/B1_LED_GND: J1.4, U1.5 (GPIO3)
/CAN/CAN_RX: U1.30 (GPIO23_CRX1); also elsewhere on the board
/CAN/CAN_TX: U1.29 (GPIO22_CTX1); also elsewhere on the board
/GNSS/GNSS_FRONT_RX: U1.2 (GPIO0_CRX2_RX1); also elsewhere on the board
/GNSS/GNSS_FRONT_TX: U1.3 (GPIO1_CTX2_TX1); also elsewhere on the board
/GNSS/GNSS_REAR_RX: U1.9 (GPIO7_RX2); also elsewhere on the board
/GNSS/GNSS_REAR_TX: U1.10 (GPIO8_TX2); also elsewhere on the board
/GNSS/GNSS_TRACTOR_RX: U1.28 (GPIO21_RX5); also elsewhere on the board
/GNSS/GNSS_TRACTOR_TX: U1.27 (GPIO20_TX5); also elsewhere on the board
/J1_SW: J9.1, U1.21 (GPIO14_TX3)
/J1_X: J9.3, U1.23 (GPIO16_RX4_SCL1)
/J1_Y: J9.2, U1.22 (GPIO15_RX3)
GND: J1.2, J9.5, U1.1 (GND), U1.17 (GND), U1.32 (GND); also elsewhere on the board
unnamed: J11.1, U1.33 (VIN)

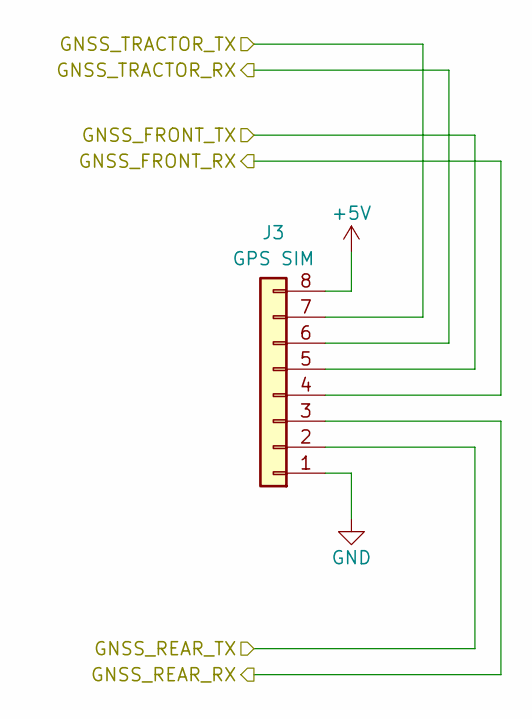
[picture p76: schematic GNSS.kicad_sch, GPS and IMU Simulator]

Parts:
J3: GPS SIM; JST_PH_B8B-PH-K_1x08_P2.00mm_Vertical; LCSC C157974

Connections:
+5V: J3.8; also elsewhere on the board
/GNSS/GNSS_FRONT_RX: J3.4; also elsewhere on the board
/GNSS/GNSS_FRONT_TX: J3.5; also elsewhere on the board
/GNSS/GNSS_REAR_RX: J3.3; also elsewhere on the board
/GNSS/GNSS_REAR_TX: J3.2; also elsewhere on the board
/GNSS/GNSS_TRACTOR_RX: J3.6; also elsewhere on the board
/GNSS/GNSS_TRACTOR_TX: J3.7; also elsewhere on the board
GND: J3.1; also elsewhere on the board

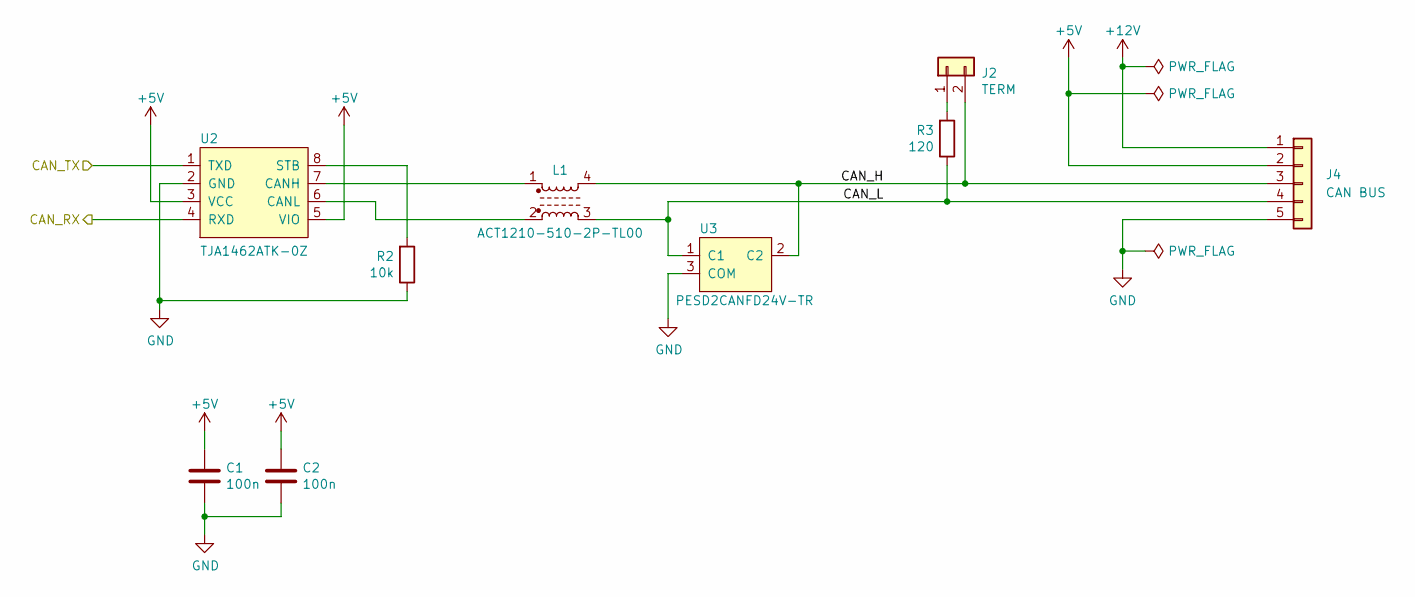
[picture p77: schematic CAN.kicad_sch, GPS and IMU Simulator]

Parts:
C1, C2: 100n; C_0805_2012Metric; LCSC C1711
J2: TERM; PinHeader_1x02_P2.54mm_Vertical; LCSC C7494857
J4: CAN BUS; JST_PH_B5B-PH-K_1x05_P2.00mm_Vertical; LCSC C157993
L1: ACT1210-510-2P-TL00; LCSC C95572
R2: 10k; R_0805_2012Metric; LCSC C17414
R3: 120; R_0805_2012Metric; LCSC C17437
U2: TJA1462ATK-0Z; HVSON8_0_65mm; LCSC C3229259
U3: PESD2CANFD24V-TR; SOT-23; LCSC C552486

Connections:
+5V: C1.1, C2.1, J4.2, U2.3 (VCC), U2.5 (VIO); also elsewhere on the board
+12V: J4.1
/CAN/CAN_H: J2.2, J4.3, L1.4, U3.2 (C2)
/CAN/CAN_L: J4.4, L1.3, R3.1, U3.1 (C1)
/CAN/CAN_RX: U2.4 (RXD); also elsewhere on the board
/CAN/CAN_TX: U2.1 (TXD); also elsewhere on the board
GND: C1.2, C2.2, J4.5, R2.1, U2.2 (GND), U3.3 (COM); also elsewhere on the board
unnamed: J2.1, R3.2
unnamed: L1.1, U2.7 (CANH)
unnamed: L1.2, U2.6 (CANL)
unnamed: R2.2, U2.8 (STB)

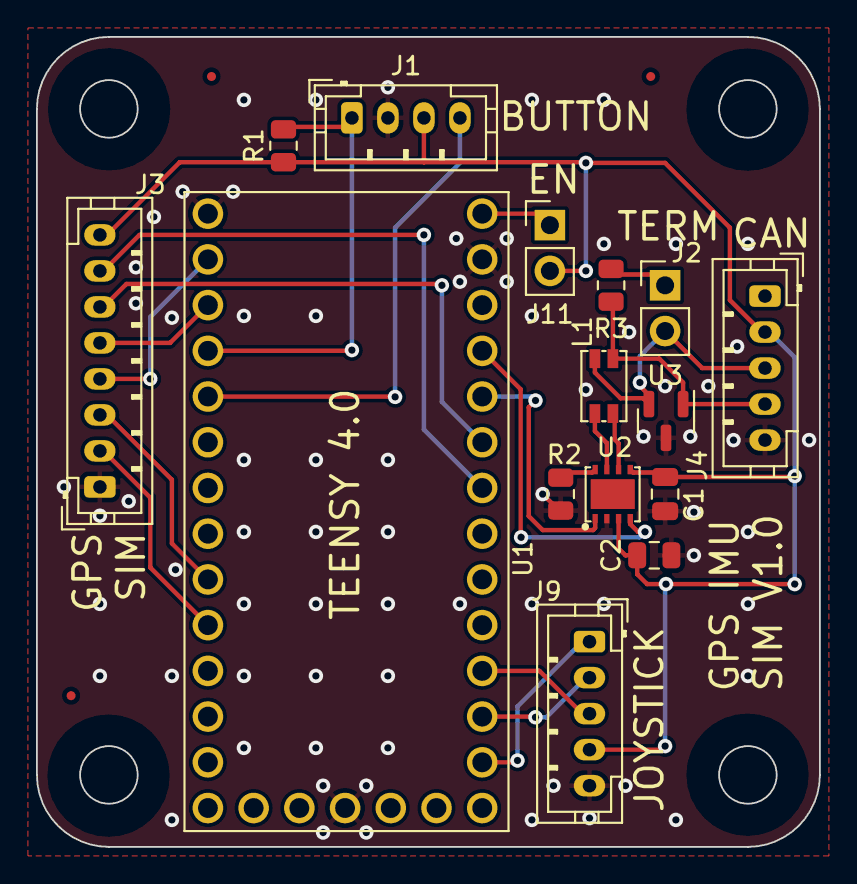
[picture p78: board GPS IMU Simulator.kicad_pcb from above]

Board: 2 copper layers, 43.5 x 45.0 mm, 18 parts (0 on the bottom side), 22 nets.
