ajayre/tandemleveller/Electronics/User Controls/User Controls.kicad_pcb

## KiCad design Electronics/User Controls/User Controls.kicad_pcb (2025-03-13)

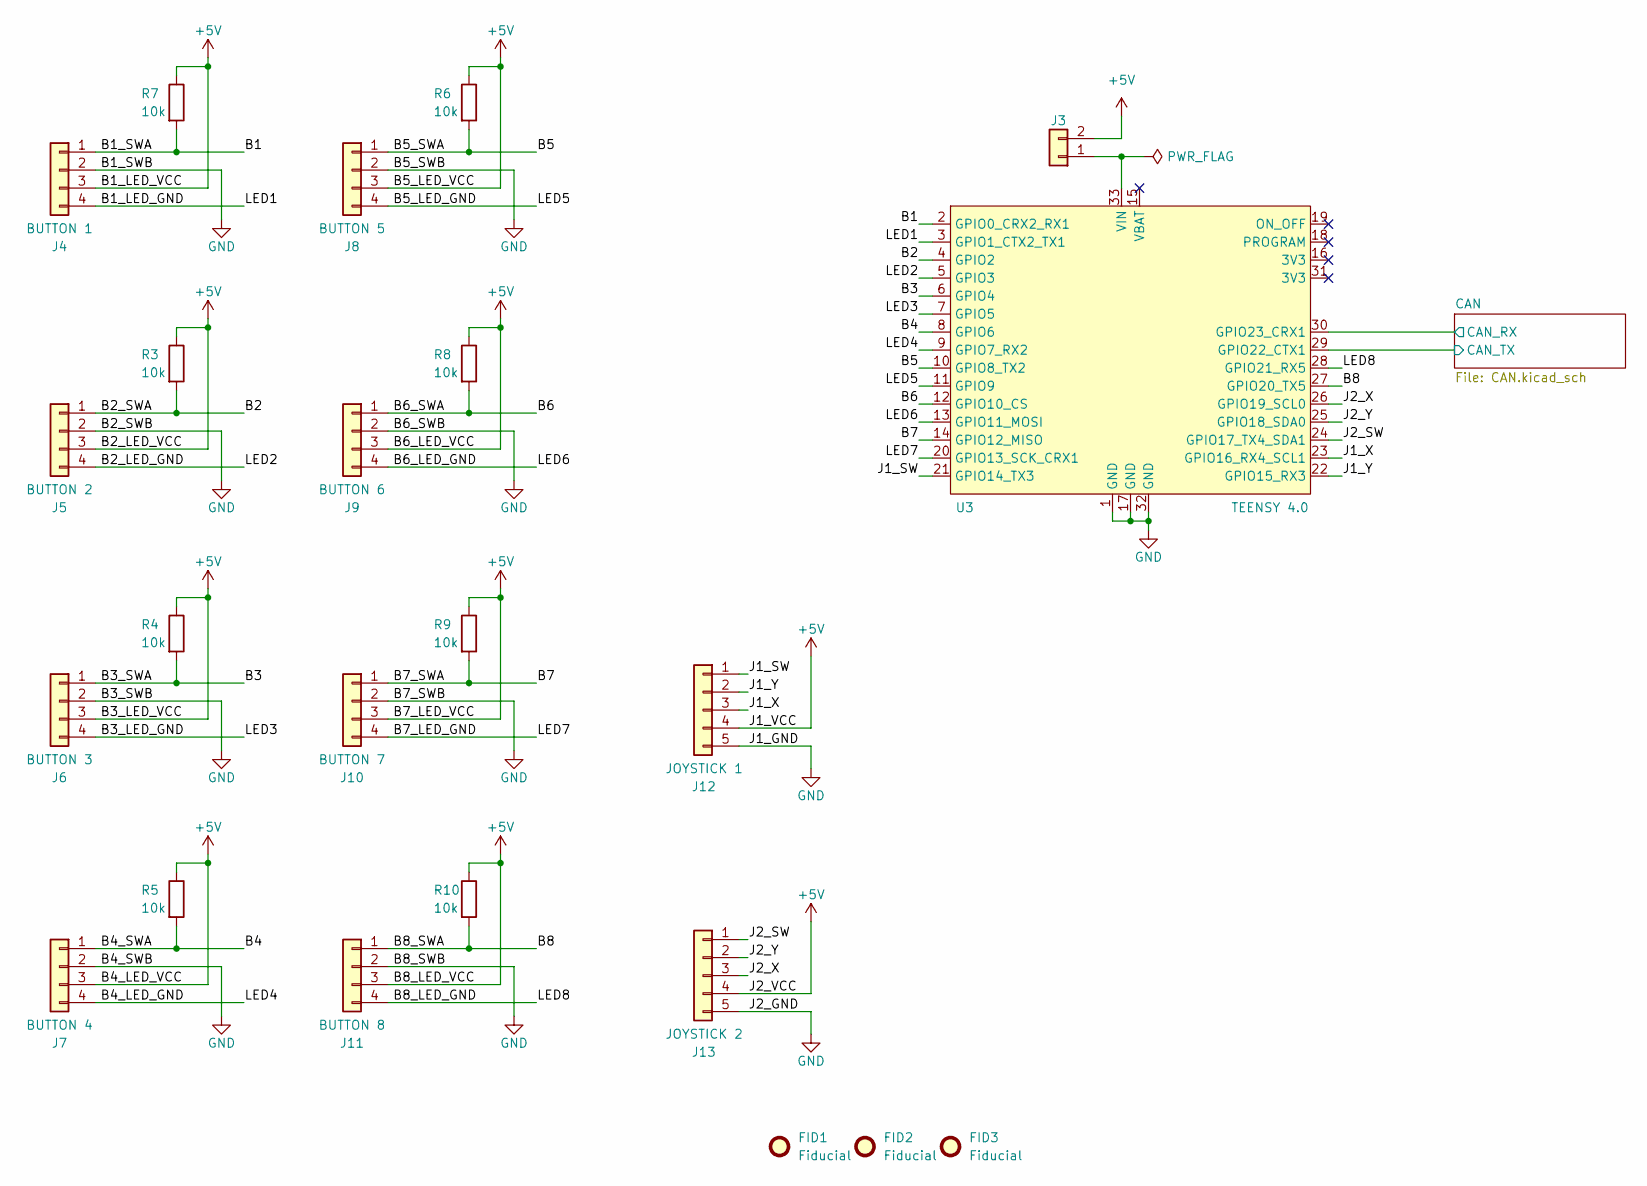
[picture p79: schematic User Controls.kicad_sch, Tandem Leveller User Controls]

Parts:
FID1, FID2, FID3: Fiducial; Fiducial_0.5mm_Mask1mm
J3: Conn_01x02; PinHeader_1x02_P2.54mm_Vertical; LCSC C7494857
J4: BUTTON 1; JST_PH_B4B-PH-K_1x04_P2.00mm_Vertical; LCSC C131334
J5: BUTTON 2; JST_PH_B4B-PH-K_1x04_P2.00mm_Vertical; LCSC C131334
J6: BUTTON 3; JST_PH_B4B-PH-K_1x04_P2.00mm_Vertical; LCSC C131334
J7: BUTTON 4; JST_PH_B4B-PH-K_1x04_P2.00mm_Vertical; LCSC C131334
J8: BUTTON 5; JST_PH_B4B-PH-K_1x04_P2.00mm_Vertical; LCSC C131334
J9: BUTTON 6; JST_PH_B4B-PH-K_1x04_P2.00mm_Vertical; LCSC C131334
J10: BUTTON 7; JST_PH_B4B-PH-K_1x04_P2.00mm_Vertical; LCSC C131334
J11: BUTTON 8; JST_PH_B4B-PH-K_1x04_P2.00mm_Vertical; LCSC C131334
J12: JOYSTICK 1; JST_PH_B5B-PH-K_1x05_P2.00mm_Vertical; LCSC C157993
J13: JOYSTICK 2; JST_PH_B5B-PH-K_1x05_P2.00mm_Vertical; LCSC C157993
R3, R4, R5, R6, R7, R8, R9, R10: 10k; R_0805_2012Metric; LCSC C17414
U3: TEENSY 4.0; Teensy_4.0

Connections:
+5V: J3.2, J4.3, J5.3, J6.3, J7.3, J8.3, J9.3, J10.3, J11.3, J12.4, J13.4, R3.1, R4.1, R5.1, R6.1, R7.1, R8.1, R9.1, R10.1; also elsewhere on the board
/B1: J4.1, R7.2, U3.2 (GPIO0_CRX2_RX1)
/B1_LED_GND: J4.4, U3.3 (GPIO1_CTX2_TX1)
/B2: J5.1, R3.2, U3.4 (GPIO2)
/B2_LED_GND: J5.4, U3.5 (GPIO3)
/B3: J6.1, R4.2, U3.6 (GPIO4)
/B3_LED_GND: J6.4, U3.7 (GPIO5)
/B4: J7.1, R5.2, U3.8 (GPIO6)
/B4_LED_GND: J7.4, U3.9 (GPIO7_RX2)
/B5: J8.1, R6.2, U3.10 (GPIO8_TX2)
/B5_LED_GND: J8.4, U3.11 (GPIO9)
/B6: J9.1, R8.2, U3.12 (GPIO10_CS)
/B6_LED_GND: J9.4, U3.13 (GPIO11_MOSI)
/B7: J10.1, R9.2, U3.14 (GPIO12_MISO)
/B7_LED_GND: J10.4, U3.20 (GPIO13_SCK_CRX1)
/B8: J11.1, R10.2, U3.27 (GPIO20_TX5)
/B8_LED_GND: J11.4, U3.28 (GPIO21_RX5)
/CAN/CAN_RX: U3.30 (GPIO23_CRX1); also elsewhere on the board
/CAN/CAN_TX: U3.29 (GPIO22_CTX1); also elsewhere on the board
/J1_SW: J12.1, U3.21 (GPIO14_TX3)
/J1_X: J12.3, U3.23 (GPIO16_RX4_SCL1)
/J1_Y: J12.2, U3.22 (GPIO15_RX3)
/J2_SW: J13.1, U3.24 (GPIO17_TX4_SDA1)
/J2_X: J13.3, U3.26 (GPIO19_SCL0)
/J2_Y: J13.2, U3.25 (GPIO18_SDA0)
GND: J4.2, J5.2, J6.2, J7.2, J8.2, J9.2, J10.2, J11.2, J12.5, J13.5, U3.1 (GND), U3.17 (GND), U3.32 (GND); also elsewhere on the board
unnamed: J3.1, U3.33 (VIN)

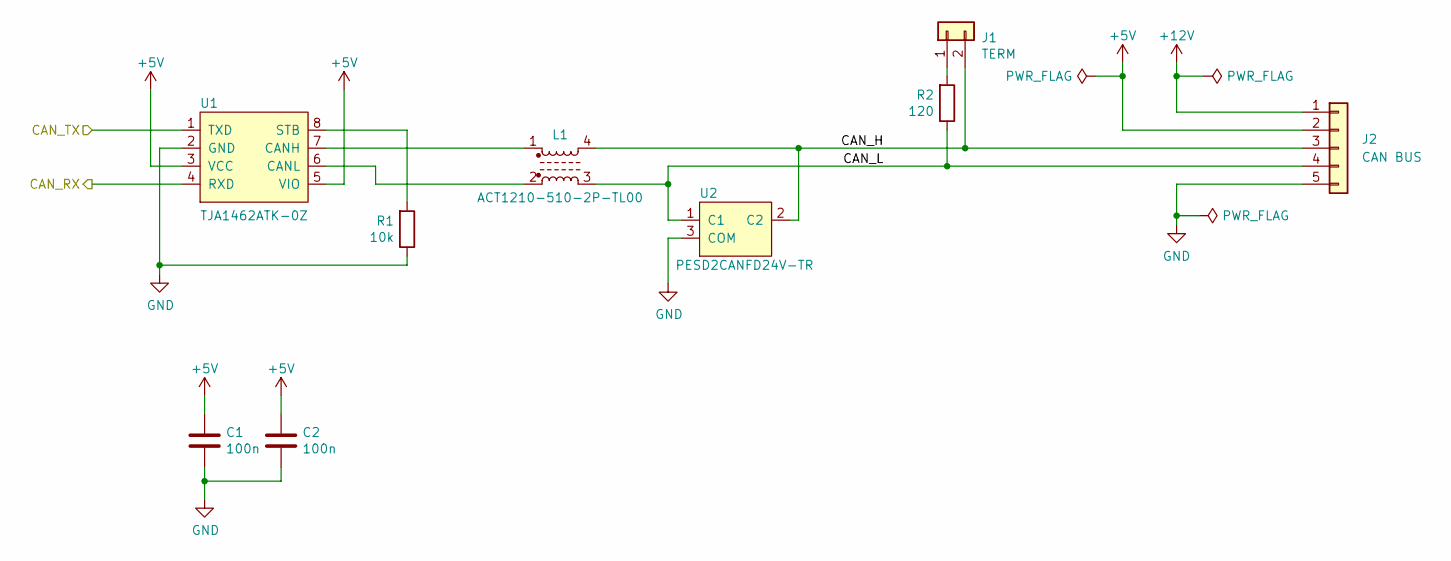
[picture p80: schematic CAN.kicad_sch, Tandem Leveller User Controls]

Parts:
C1, C2: 100n; C_0805_2012Metric; LCSC C1711
J1: TERM; PinHeader_1x02_P2.54mm_Vertical; LCSC C7494857
J2: CAN BUS; JST_PH_B5B-PH-K_1x05_P2.00mm_Vertical; LCSC C157993
L1: ACT1210-510-2P-TL00; LCSC C95572
R1: 10k; R_0805_2012Metric; LCSC C17414
R2: 120; R_0805_2012Metric; LCSC C17437
U1: TJA1462ATK-0Z; HVSON8_0_65mm; LCSC C3229259
U2: PESD2CANFD24V-TR; SOT-23; LCSC C552486

Connections:
+5V: C1.1, C2.1, J2.2, U1.3 (VCC), U1.5 (VIO); also elsewhere on the board
+12V: J2.1
/CAN/CAN_H: J1.2, J2.3, L1.4, U2.2 (C2)
/CAN/CAN_L: J2.4, L1.3, R2.1, U2.1 (C1)
/CAN/CAN_RX: U1.4 (RXD); also elsewhere on the board
/CAN/CAN_TX: U1.1 (TXD); also elsewhere on the board
GND: C1.2, C2.2, J2.5, R1.1, U1.2 (GND), U2.3 (COM); also elsewhere on the board
unnamed: J1.1, R2.2
unnamed: L1.1, U1.7 (CANH)
unnamed: L1.2, U1.6 (CANL)
unnamed: R1.2, U1.8 (STB)

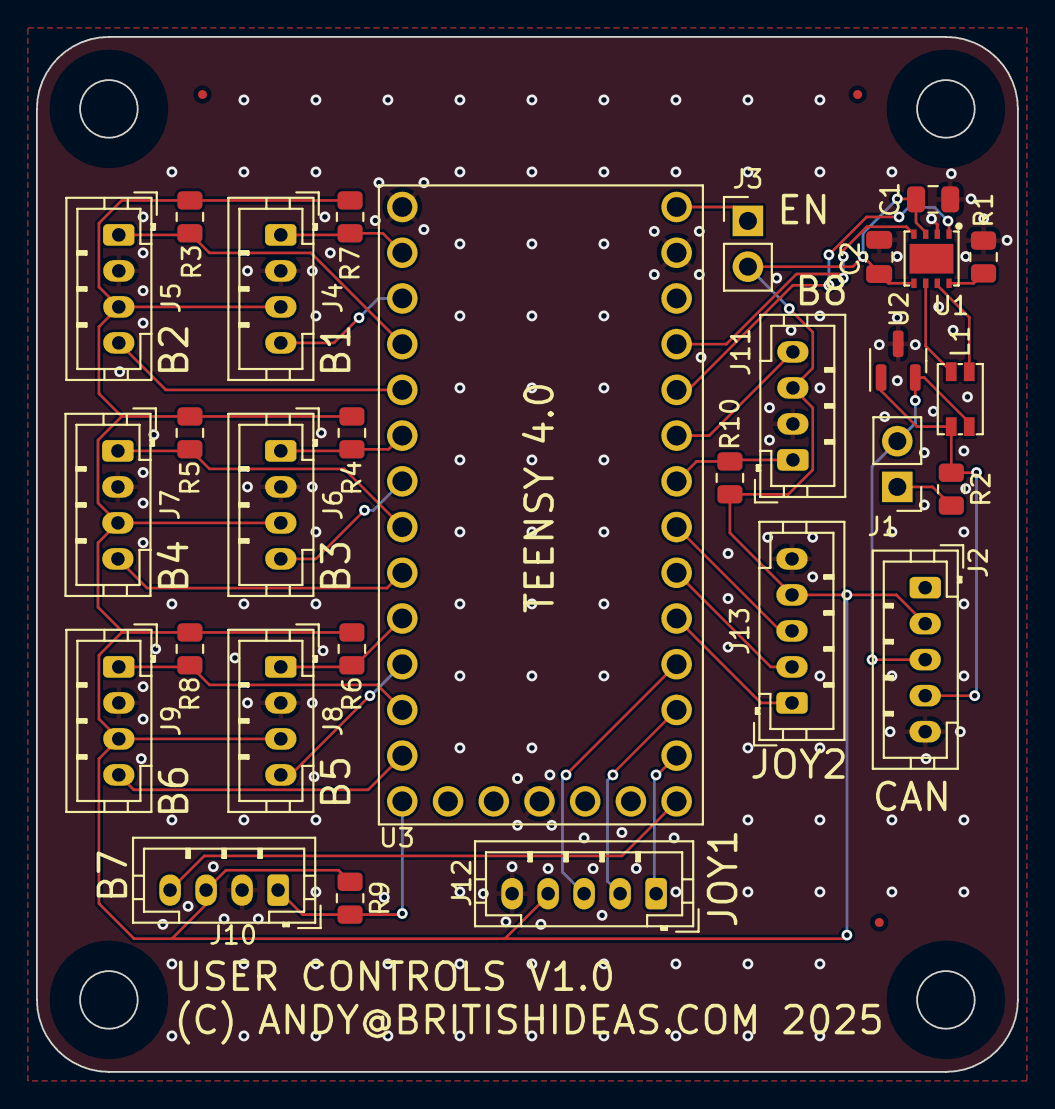
[picture p81: board User Controls.kicad_pcb from above]

Board: 2 copper layers, 54.5 x 57.5 mm, 32 parts (0 on the bottom side), 33 nets.
