ajayre/tandemleveller/Firmware/TandemLevellerV2/src/SensorFusor.h

// GNSS / IMU fusion (port of SensorFusor.cs)

#ifndef _SENSORFUSORH_
#define _SENSORFUSORH_

#include <Arduino.h>
#include "Global.h"
#include "GNSS.h"
#include "IMU.h"

class SensorFusor;

// fuse applied callback
typedef void (*sensorfusor_fuse_applied_t)(SensorFusor *pFusor, int EastingMm, int NorthingMm, int AltitudeMm);

class SensorFusor
{
  public:
    // constructor; initializes fusion state (no prior fix for low-speed heading)
    SensorFusor
      (
      void
      );

    // combines GNSS fix and IMU attitude into a lever-arm / tilt corrected location.
    // Looks up the IMU circular buffer for the sample closest to the GNSS fix epoch.
    void Fuse
      (
      gnss_location_t *plocation,           // GNSS fix, speed, RTK, antenna offsets (mm)
      const IMU &ImuHandler,                // IMU handler (for timestamped buffer lookup)
      uint8_t ImuIndex,                     // which IMU (TRACTOR_IDX, FRONT_BLADE_IDX, etc.)
      const antenna_location_t &Antenna     // location of antenna 
      );

    // sets the callback functions
    void SetCallbacks
      ( 
      sensorfusor_fuse_applied_t FuseAppliedCallback
      );

    // sets the magnetic declination to use
    void SetMagneticDeclination
      (
      uint32_t Declination               // declination in degrees x 100
      );

  private:
    double imu_gyro_offset = InvalidGyro;
    double last_latitude;
    double last_longitude;
    sensorfusor_fuse_applied_t FuseAppliedCallback;

    bool   horiz_kf_init = false;
    double kf_origin_lat_deg = InvalidLatitude;
    double kf_origin_lon_deg = InvalidLongitude;
    uint32_t kf_last_fix_ms = 0;
    double kf_n_m = 0.0;
    double kf_e_m = 0.0;
    double kf_P_nn = 1.0;
    double kf_P_ne = 0.0;
    double kf_P_en = 0.0;
    double kf_P_ee = 1.0;

    bool   alt_kf_init = false;
    uint32_t kf_alt_last_fix_ms = 0;
    double kf_alt_m = 0.0;
    double kf_P_alt = 1.0;

    struct FusionGnssVector
    {
      double track_magnetic_deg;
      double speed_kph;
    };

    struct FusionGnssFix
    {
      double latitude;
      double longitude;
      double altitude;
      FusionGnssVector vector;
      int fix_quality;
      double hdop;
      gnss_rtk_status_t rtk;
      int last_fix_time_valid;
      uint32_t last_fix_time_ms;
    };

    struct FusionImuValue
    {
      double pitch;
      double heading;
      double roll;
      double yaw_rate;
    };

    // Magnetic declination (degrees, positive = East). true = magnetic + declination
    double MagneticDeclinationDeg = 10.48;

    // IMU mounting calibration offsets (degrees). Subtracted from raw IMU readings
    // so that a physically vertical pole reads roll=0, pitch=0.
    static constexpr double IMU_ROLL_CALIBRATION_DEG  = 0.70;
    static constexpr double IMU_PITCH_CALIBRATION_DEG = -4.37;

    // GNSS COG blend / gyro offset calibration only above this speed (~4.3 MPH).
    // Below: gyro-only heading for fusion; AgGrade still receives smoothed GNSS COG.
    static constexpr double SpeedThresholdKph    = 7.0;
    // |yaw_rate| below: allow GNSS/gyro track blend (when speed high) and horizontal
    // tilt / lever-arm + horizontal KF measurement updates; at or above: gyro-only heading,
    // horizontal lever-arm moves skipped and horizontal KF holds (no meas update).
    // Tuned for driving: lower values gate horizontal fusion often and cut corners on the map.
    static constexpr double YawRateThreshold     = 50.0;

    // Horizontal output: 2-state Kalman (north/east m) with process noise q (m^2/s) and
    // measurement variance from fix quality, HDOP, and RTK status.
    static constexpr double HorizKfProcessNoiseM2PerS = 0.0002;
    static constexpr double HorizKfMinMeasSigmaM      = 0.04;
    static constexpr double HorizKfSpeedBlendKph      = 3.0;

    // Altitude output: 1-state Kalman (m) with process noise and vertical meas variance.
    // Vertical GNSS noise is typically 2-3x horizontal; speed scaling allows tracking
    // genuine terrain changes while smoothing when stationary.
    static constexpr double AltKfProcessNoiseM2PerS   = 0.0005;
    static constexpr double AltKfMinMeasSigmaM        = 0.008;

    static constexpr double EarthRadiusM           = 6378137.0;
    static constexpr double Pi                     = 3.14159265358979323846;
    static constexpr double DegToRad               = (Pi / 180.0);
    static constexpr double RadToDeg               = (180.0 / Pi);

    static constexpr double InvalidLatitude        = -301.0;
    static constexpr double InvalidLongitude       = -301.0;
    static constexpr double InvalidHeading         = -301.0;
    static constexpr double InvalidGyro            = -401.0;

    // returns non-zero if fix has RTK fixed or float solution
    int FixHasRtk
      (
      const FusionGnssFix *fix               // fix to test for RTK fixed or float
      ) const;

    // great-circle distance in meters between two WGS84 lat/lon points (degrees)
    double HaversineDistanceM
      (
      double from_lat_deg,                   // start latitude (degrees)
      double from_lon_deg,                   // start longitude (degrees)
      double to_lat_deg,                     // end latitude (degrees)
      double to_lon_deg                      // end longitude (degrees)
      ) const;

    // initial bearing from first point to second, radians, -pi..pi
    double BearingRad
      (
      double from_lat_deg,                   // start latitude (degrees)
      double from_lon_deg,                   // start longitude (degrees)
      double to_lat_deg,                     // end latitude (degrees)
      double to_lon_deg                      // end longitude (degrees)
      ) const;

    // initial bearing in degrees (matches legacy BearingDegrees lon/lat argument order)
    double BearingDegrees
      (
      double from_lat_deg,                   // start latitude (degrees)
      double from_lon_deg,                   // start longitude (degrees)
      double to_lat_deg,                     // end latitude (degrees)
      double to_lon_deg                      // end longitude (degrees)
      ) const;

    // heading in degrees -> [0, 360)
    double NormalizeHeadingDeg
      (
      double heading_deg
      ) const;

    // moves (*lat_deg,*lon_deg) by distance_m along heading_deg (degrees, clockwise from north)
    void MoveDistanceBearing
      (
      double *lat_deg,                       // in-out latitude (degrees)
      double *lon_deg,                       // in-out longitude (degrees)
      double heading_deg,                    // bearing clockwise from north (degrees)
      double distance_m                      // distance to move (meters)
      ) const;

    // Measurement variance (m^2) for horizontal position from GGA quality / HDOP / RTK.
    double HorizontalMeasVarianceM2
      (
      const FusionGnssFix *fix
      ) const;

    void GeodeticDeltaToNeM
      (
      double lat0_deg,
      double lon0_deg,
      double lat_deg,
      double lon_deg,
      double *north_m,
      double *east_m
      ) const;

    void NeMToGeodetic
      (
      double lat0_deg,
      double lon0_deg,
      double north_m,
      double east_m,
      double *lat_deg,
      double *lon_deg
      ) const;

    // 2-state Kalman on fused horizontal position (lever-arm corrected) before publishing.
    // When measurement_valid is false (e.g. yaw-gated), skips the measurement update
    // (P still grows via process noise) and outputs the held Kalman state.
    void ApplyFusedHorizontalKalman
      (
      double *lat_deg,
      double *lon_deg,
      const FusionGnssFix *fix_meta,
      bool measurement_valid
      );

    // Measurement variance (m^2) for vertical position from GGA quality / HDOP / RTK.
    double VerticalMeasVarianceM2
      (
      const FusionGnssFix *fix
      ) const;

    // 1-state Kalman on fused altitude (lever-arm corrected) before publishing.
    // Only called when RTK is available; without RTK, altitude passes through raw.
    void ApplyFusedAltitudeKalman
      (
      double *altitude_m,
      const FusionGnssFix *fix_meta
      );

    // core fusion: updates last_latitude/longitude and writes corrected fix_out
    void FuseInternal
      (
      const FusionGnssFix *fix_in,           // input GNSS fix and metadata
      const FusionImuValue *imu,             // IMU attitude and rates
      uint32_t antenna_height_mm,            // antenna height above IMU (mm)
      int32_t antenna_left_mm,               // antenna left offset, + = port (mm)
      int32_t antenna_forward_mm,            // antenna forward offset, + = ahead (mm)
      FusionGnssFix *fix_out                 // output corrected fix
      );

    // Local tangent plane: North/East displacement (mm, fused minus input) and altitude
    // delta in meters (fused minus input); callback Up mm = delta_alt_m * 1000.
    void ConvertResultstoMm
      (
      double in_lat_deg,
      double in_lon_deg,
      double out_lat_deg,
      double out_lon_deg,
      double delta_alt_m
      );
};

#endif // _SENSORFUSORH_
