ajayre/tandemleveller/(commit log)

2025-02-08 Added CAD files for GPS receiver board.
2025-02-10 Added CAD files. Designed board bracket for base station.
    [Bracket.stl]
2025-02-11 Added example wiring diagrams. Added 3D printed support, base station bracket and rover case.
    [Case Top.stl, Divider.stl, Support-PLA-Quail.stl]
2025-02-14 Added CAD models for rover case and base dividers. Working on schematic for controller board.
    [GNSS.kicad_sch, IMU.kicad_sch, Power.kicad_sch, Slave Tablet.kicad_sch, Tandem Leveller Controller.kicad_pcb, Tandem Leveller Controller.kicad_sch, USB Devices.kicad_sch, USB Hub.kicad_sch]
2025-02-15 Working on schematic. Added datasheets.
    [GNSS.kicad_sch, IMU.kicad_sch, Power.kicad_sch, Slave Tablet.kicad_sch, Tandem Leveller Controller.kicad_sch, USB Devices.kicad_sch, USB Hub.kicad_sch, Valve Control.kicad_sch]
2025-02-16 Working on schematic.
    [GNSS.kicad_sch, IMU.kicad_sch, Power.kicad_sch, Slave Tablet.kicad_sch, Switches.kicad_sch, Tandem Leveller Controller.kicad_sch, USB Devices.kicad_sch, USB Hub.kicad_sch]
2025-02-17 Updated schematic. Added footprints for all components.
    [GNSS.kicad_sch, IMU.kicad_sch, Power.kicad_sch, Slave Tablet.kicad_sch, Switches.kicad_sch, Tandem Leveller Controller.kicad_sch, USB Devices.kicad_sch, USB Hub.kicad_sch]
2025-02-19 Changed switches and lamps. Removed status LEDs. Working on PCB layout.
    [GNSS.kicad_sch, IMU.kicad_sch, Power.kicad_sch, Slave Tablet.kicad_sch, Switches.kicad_sch, Tandem Leveller Controller.kicad_pcb, Tandem Leveller Controller.kicad_sch, USB Devices.kicad_sch]
2025-02-19 Working on PCB layout.
    [Tandem Leveller Controller.kicad_pcb]
2025-02-21 First attempt at PCB layout completed.
    [Tandem Leveller Controller.kicad_pcb]
2025-02-21 Reduced size of bolt holes on controller. Started work on IMU.
    [CAN.kicad_sch, IMU.kicad_pcb, IMU.kicad_sch, Tandem Leveller Controller.kicad_pcb]
2025-02-22 Moved controls from GPIO to CAN bus. Added two more CAN bus connectors. Changed GNSS SIM connector from pin header to JST-PH.
    [GNSS.kicad_sch, IMU.kicad_sch, Power.kicad_sch, Slave Tablet.kicad_sch, Switches.kicad_sch, Tandem Leveller Controller.kicad_pcb, Tandem Leveller Controller.kicad_sch, USB Devices.kicad_sch]
2025-02-23 Renamed valve control connectors and reordered pins to match pinout of MDD10A connectors.
    [Tandem Leveller Controller.kicad_pcb, Tandem Leveller Controller.kicad_sch, Valve Control.kicad_sch]
2025-02-25 Working on IMU PCB.
    [IMU.kicad_pcb]
2025-02-25 Increased 5V and 12V track thickness to CAN connnectors on controller board.
    [Tandem Leveller Controller.kicad_pcb]
2025-02-26 Started work on user controls PCB.
    [CAN.kicad_sch, User Controls.kicad_pcb, User Controls.kicad_sch]
2025-02-27 Working on user controls PCB.
    [User Controls.kicad_pcb]
2025-03-05 Finished first attempt at user controls PCB.
    [User Controls.kicad_pcb]
2025-03-05 Started work on GPS and IMU simulator.
    [CAN.kicad_sch, GNSS.kicad_sch, GPS IMU Simulator.kicad_pcb, GPS IMU Simulator.kicad_sch]
2025-03-07 Completed first attempt at GPS/IMU simulator.
    [CAN.kicad_sch, GPS IMU Simulator.kicad_pcb, IMU.kicad_pcb]
2025-03-12 Added 4.7uF caps to FT232RL on controller.
    [CAN.kicad_sch, GNSS.kicad_sch, GPS IMU Simulator.kicad_sch, IMU.kicad_sch, Power.kicad_sch, Slave Tablet.kicad_sch, Tandem Leveller Controller.kicad_pcb, Tandem Leveller Controller.kicad_sch]
2025-03-13 Removed JLCPCB part numbers for Teensy and BNO085 connectors. Added JLCPCB part number for 4.7uF capacitor. Generated JLCPCB manufacturing files for all boards.
    [GPS IMU Simulator.kicad_pcb, GPS IMU Simulator.kicad_sch, IMU.kicad_sch, Slave Tablet.kicad_sch, Tandem Leveller Controller.kicad_pcb, Tandem Leveller Controller.kicad_sch, USB Devices.kicad_sch, User Controls.kicad_pcb]
2025-03-13 Added fiducials to all boards.
    [CAN.kicad_sch, GNSS.kicad_sch, GPS IMU Simulator.kicad_pcb, GPS IMU Simulator.kicad_sch, IMU.kicad_pcb, IMU.kicad_sch, Power.kicad_sch, Slave Tablet.kicad_sch]
2025-03-14 Added inductor part number.
    [Power.kicad_sch]
2025-03-19 Changed four way screw block, USB type A connectors, 33uH inductor and 24MHz crystal to use parts that JLCPCB has in stock.
    [GNSS.kicad_sch, IMU.kicad_sch, Power.kicad_sch, Slave Tablet.kicad_sch, Tandem Leveller Controller.kicad_pcb, Tandem Leveller Controller.kicad_sch, USB Devices.kicad_sch, USB Hub.kicad_sch]
2025-03-19 Changed tablet PSU inductors.
    [Power.kicad_sch, Tandem Leveller Controller.kicad_pcb, bom.csv, positions.csv]
2025-03-30 Added CAD models.
2025-04-06 Working on controller case. Updated labels for valve controls on controller schematic.
    [BNC Connector 01 v3.step, Neutrik 4Pin Panel Mount Female.STEP, Valve Control.kicad_sch]
2025-04-07 Working on controller case.
    [Connector Panel.stp, M BNC.STEP]
2025-04-08 Working on controller box connector panel.
    [Connector Panel.stp]
2025-04-09 Finalized cutouts in controller connector panel.
    [Connector Panel.stp]
2025-10-01 Started work on controller firmware.
    [Connector Panel.stp]
2025-10-02 Testing more functionality. PWM output working. Removed TeensyDebug.
2025-10-03 Started IMU firmware.
2025-10-03 Added CAD files for joystick.
    [Joystick assembly.STEP]
2025-10-05 Set up configurations for IMU. Added watchdog. Added NMT reset.
    [IMU.ino]
2025-10-09 Controller monitors heartbeats to detect missing nodes. Controller receives all TPDOs and extracts data. Added joystick button data to pendant output.
    [Pendant.ino]
2025-10-10 Fixed bug in detecting missing nodes. Reduced HB time from 1000ms to 100ms. Reduced HM missing time from 6000ms to 300ms. Controller transmits emcy when estop is hit or pendant disappears from bus. F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
    [IMU.ino, Pendant.ino]
2025-10-12 Fixed bugs in pendant - now reports estop pressed on bootup if already pressed.
    [Pendant.ino]
2025-10-14 Started working on scraper angle sensor.
2025-10-15 Added circuit board to put scraper angle onto CAN bus.
    [CAN.kicad_sch, Scraper Angle.kicad_pcb, Scraper Angle.kicad_sch]
2025-10-16 Designed mounting brackets for angle sensor.
    [92010A320_Passivated 18-8 Stainless Steel Phillips Flat Head Screw.STEP, 92010A540_Passivated 18-8 Stainless Steel Phillips Flat Head Screw.STEP, 92620A542_Zinc Yellow-Chromate Plated Hex Head Screw.STEP, 94645A210_High-Strength Steel Nylon-Insert Locknut.STEP]
2025-10-16 Tweaked body mount so it can actually be installed.
2025-10-20 Changed sensor connector on scraper angle board. Generated production files for scraper angle board.
    [CAN.kicad_sch, Scraper Angle.kicad_pcb, Scraper Angle.kicad_sch, bom.csv, designators.csv, positions.csv]
2025-10-22 Working on pendant case.
2025-10-22 Reworked pendent case to make dimensions more accurate.
2025-10-22 Added CAD model of scraper angle board.
2025-10-22 Added CAD models for scraper angle and user controls boards.
2025-10-23 Created bracket for pendant.
    [Bracket.stp]
2025-10-25 Working on adding SerialTransfer for communication between Arduino and OpenGrade3D.
2025-10-29 Working on PWM support.
2025-10-31 Controller now puts status information onto the CAN bus. Added support for jogging front blade with joystick. Added better ESTOP handling.
2025-11-01 Work buttons now toggle auto mode. Work buttons flash while in auto mode. Emergency stop turns all button lights on.
2025-11-01 Exit auto mode when jogged. Button LEDs off when exiting auto mode.
2025-11-02 Updating test harness for two blades. Controller now only sends data to PC when it changes. PC can request current data from Controller PC can reset controller.
2025-11-02 Updated IMU DT-4 template to move connectors as close together as possible.
2025-11-05 Working on sensor fusion.
2025-11-05 Removed lat, lot and alt scaling from SensorFusor. All tests pass.
2025-11-07 Changed yaw to heading. Changed yaw rate units from rad/s to deg/s. C# code now receives yaw rate.
2025-11-07 Corrected heading and pitch.
    [IMU.ino]
2025-11-07 Added transmission of IMU calibration status and reception by PC.
2025-11-10 Added option to specify antenna X/Y position when fusing sensors.
2025-11-16 Working on V2 of base station.
    [Base Station Mount.stp]
2025-11-16 Created 3D model of case for V2 base station.
2025-11-20 Working on UDP adapter.
    [Controller UDP Adapter.kicad_pcb, Controller UDP Adapter.kicad_sch]
2025-11-21 Completed V1.0 of UDP adapter.
    [Controller UDP Adapter.kicad_pcb, Controller UDP Adapter.kicad_sch]
2025-11-27 Refactor, cleanup, changed PGN value size to 64 bits. Updates to base station.
    [Controller UDP Adapter.kicad_pcb, Controller UDP Adapter.kicad_sch, bom.csv, designators.csv, positions.csv]
2025-11-29 Added analysis of scraper angle vs blade height.
    [Scraper Mechanical Analysis.xlsx]
2025-12-12 Updated holes on base station mount for tapping sizes. Added ideas for V2 controller. Added mechanical analysis of angle sensor.
    [Base Station Mount.stp]
2025-12-31 Added connector cut out templates for angle sensor and base station cases.
    [c-dt04-3p-cl03-99-3d.stp]
2026-01-25 Added template for ethernet connector cutouts.
2026-01-25 Completed angle sensor firmware.
2026-01-29 Created GNSS daughterboard.
    [GNSS Daughterboard.kicad_pcb, GNSS Daughterboard.kicad_sch, MD13S-SUMO.step, Tandem Leveller Controller V2.kicad_pcb, Tandem Leveller Controller V2.kicad_sch]
2026-01-29 Working on Valve Daughterboard.
    [Valve Daughterboard.kicad_pcb, Valve Daughterboard.kicad_sch]
2026-02-01 Completed daughterboards.
    [GNSS Daughterboard.kicad_pcb, GNSS Daughterboard.kicad_sch, Valve Daughterboard.kicad_pcb, Valve Daughterboard.kicad_sch]
2026-02-02 Working on V2 controller. Added and laid out GNSS and valve.
    [Tandem Leveller Controller V2.kicad_pcb, Tandem Leveller Controller V2.kicad_sch]
2026-02-02 Reordered main connector.
    [Controller V2 Cabling.kicad_sch, Tandem Leveller Controller V2.kicad_sch]
2026-02-04 Added AMP connectors. Working on PCB layout.
    [Controller V2 Cabling.kicad_sch, Tandem Leveller Controller V2.kicad_pcb, Tandem Leveller Controller V2.kicad_sch]
2026-02-05 Working on V2 controller PCB.
    [MCUs.kicad_sch, Tandem Leveller Controller V2.kicad_pcb, Tandem Leveller Controller V2.kicad_sch]
2026-02-07 Added missing ground connection. Working on PCB layout.
    [CAN.kicad_sch, Controller V2 Cabling.kicad_sch, GNSS.kicad_sch, IMU.kicad_sch, MCUs.kicad_sch, Power.kicad_sch, Tandem Leveller Controller V2.kicad_pcb, Tandem Leveller Controller V2.kicad_sch]
2026-02-08 Working on motherboard layout. Added SMA adapters to GNSS daughterboard. Generated CAD files.
    [GNSS Daughterboard.kicad_pcb, GNSS Daughterboard.step, Tandem Leveller Controller V2.kicad_pcb, Valve Daughterboard.step]
2026-02-08 Added more CAD files.
2026-02-09 Added generic IMU option.
    [CAN.kicad_sch, GNSS.kicad_sch, IMU.kicad_sch, MCUs.kicad_sch, Power.kicad_sch, Tandem Leveller Controller V2.kicad_pcb, Tandem Leveller Controller V2.kicad_sch, Valves.kicad_sch]
2026-02-09 Updated IMU mounting holes to remove copper.
    [Tandem Leveller Controller V2.kicad_pcb]
2026-02-12 Working on Controller V2 case.
2026-02-13 Working on case.
    [Tandem Leveller Controller V2.kicad_pcb]
2026-02-13 Added BNC connectors to case.
2026-02-23 Working on V2 controller board. Started firmware to do list.
    [Tandem Leveller Controller V2.kicad_pcb, Tandem Leveller Controller V2.kicad_sch]
2026-02-24 Added CAD files for IMU.
    [IMU.step]
2026-02-25 Working on housing for IMU.
2026-03-02 Working on housing.
2026-03-02 Added relay to control output of valve E.
    [CAN.kicad_sch, GNSS.kicad_sch, IMU.kicad_sch, MCUs.kicad_sch, Power.kicad_sch, Tandem Leveller Controller V2.kicad_pcb, Tandem Leveller Controller V2.kicad_sch, Valve Daughterboard.kicad_pcb]
2026-03-03 Working on autosteer support for V2 controller.
    [Autosteer.kicad_sch, CAN.kicad_sch, Controller V2 Cabling.kicad_sch, GNSS.kicad_sch, IMU.kicad_sch, MCUs.kicad_sch, Power.kicad_sch, Tandem Leveller Controller V2.kicad_sch]
2026-03-05 Added WAS circuit.
    [Autosteer.kicad_sch, Controller V2 Cabling.kicad_sch, MCUs.kicad_sch, Tandem Leveller Controller V2.kicad_pcb, Tandem Leveller Controller V2.kicad_sch]
2026-03-05 Added current sensing for valve E.
    [Autosteer.kicad_sch, Tandem Leveller Controller V2.kicad_pcb, Tandem Leveller Controller V2.kicad_sch]
2026-03-05 Added connector to valve daugherboard for optional 12V to 24V converter.
    [Controller V2 Cabling.kicad_sch, Valve Daughterboard.kicad_pcb, Valve Daughterboard.kicad_sch]
2026-03-21 Tweaks to PCBs. Updates to housing.
    [Tandem Leveller Controller V2.kicad_pcb, Valve Daughterboard.kicad_pcb]
2026-03-22 Added connector and mounting holes for future USB-C PD expansion board.
    [Autosteer.kicad_sch, CAN.kicad_sch, EVQ4242-VE-00B_layout.PcbDoc, EVQ4242-VE-00B_schematic.SchDoc, GNSS.kicad_sch, IMU.kicad_sch, MCUs.kicad_sch, Power.kicad_sch]
2026-03-22 Passes rules checks.
    [Tandem Leveller Controller V2.kicad_pcb, Tandem Leveller Controller V2.kicad_sch]
2026-03-22 Changed BMO085 from 5V to 3.3V to match Teensy.
    [IMU.kicad_sch, Tandem Leveller Controller V2.kicad_pcb, Valves.kicad_sch]
2026-03-22 Added jumper to bypass current sensing. Minor tweaks. Generated production files.
    [Autosteer.kicad_sch, GNSS Daughterboard.kicad_pcb, IMU.kicad_sch, Tandem Leveller Controller V2.kicad_pcb, Tandem Leveller Controller V2.kicad_sch, Valve Daughterboard.kicad_pcb, bom.csv, designators.csv]
2026-04-06 Updated housing cutouts for M12 connectors. Added M12 female cable ends to check for clearances.
    [Controller V2 Cabling.kicad_sch, M12A-04BFFB-SL7001.stp]
2026-04-09 Working on V2 case.
    [Rear Panel.stl, Side Panel.stl, Top Panel.stl, Top-AfterBool-Left.stl, Top-AfterBool-Right.stl, Top-AfterBool.3dm, Top-AfterBool.stp, Top.3dm]
2026-04-09 Completed V2 case.
2026-04-09 Uodates to V2 case.
    [Bottom Panel Front.stl, Bottom Panel Rear.stl, Connector Panel.stl, Front Panel.stl, Top Panel.stl]
2026-04-10 Fixed bugs caused by refactoring.
    [Blades.cpp, CANopen.cpp, TandemControllerV2.ino]
2026-04-11 Puts tractor location onto the CAN bus. Updated front panel for case.
    [Front Panel.stl]
2026-04-11 Working on sensor fusing.
2026-04-12 Improvements to case. Working on sensor fusing.
    [Rear Panel.stl]
2026-04-12 Pendent buttons now flash for manual mode and solid on for auto, to match the buttons in AgGrade.
2026-04-12 Transmits altitude onto CAN bus.
2026-04-12 Receives and stores antenna locations.
2026-04-12 Fixed bug with IMU pitch and heading fluctuating between two values.
    [IMU.ino]
2026-04-16 Added PGNs for additional IMUs. Not currently used.
2026-04-19 Created boards to duplicate XBee receive signal across multiple rovers.
    [Dummy XBee.kicad_pcb, Dummy XBee.kicad_sch, XBee Adapter.kicad_pcb, XBee Adapter.kicad_sch]
2026-04-19 Improvements to sensor fusing.
2026-04-20 Added housing for blade height sensor. Improvements to sensor fusing.
2026-04-20 Added production files. Updated case front panel.
    [Dummy XBee.kicad_pcb, Front Panel.stl, XBee Adapter.kicad_pcb, bom.csv, designators.csv, positions.csv]
2026-04-21 Working on V3 case.
    [Dummy XBee.step, XBee Adapter.step]
2026-04-22 Working on new case. Tweaked sensor fusor.
    [FH-M3-12ZC-PennEngineering-3D-04-21-2026.stp, FH-M3-8ZC-PennEngineering-3D-04-20-2026.stp]
2026-04-23 Added sensor fusion testing script, sample recordings and images. Increased yaw threshold for sensor fusing.
    [Sensor Fusion Test 1.csv, Sensor Fusion Test 10.csv, Sensor Fusion Test 11.csv, Sensor Fusion Test 12.csv, Sensor Fusion Test 13.csv, Sensor Fusion Test 14.csv, Sensor Fusion Test 15.csv, Sensor Fusion Test 16.csv]
2026-04-27 Updated controller V2 cabling. Added additional IMU PGNs - not currently used.
    [Controller V2 Cabling.kicad_sch]
2026-04-27 Added support for multiple orientations to IMU.
2026-04-27 Added support for switching orientiation and zeroing IMU over the CAN bus. Not yet stored in EEPROM.
2026-04-28 Working on scraper antenna mount. Changed IMU report type - not yet tested.
    [AS-ANT2B-SUR-L1L2-25SMA-00-R00.STEP]
2026-04-28 IMU code tested and working.
    [Power.kicad_sch]
2026-04-28 Completed IMU firmware.
2026-04-28 Added support for setting IMU orientation and zero position.
2026-04-29 Added front and rear bucket builds for IMU. Scraper angle now turns on LED to show power.
2026-05-04 Updated holes on V3 case.
2026-05-04 Updated valve daugherboard CAD model.
    [Valve Daughterboard.step]
2026-05-04 Updated CAD model for V2 controller. Valve control board is now in sockets.
    [Tandem Leveller Controller V2.kicad_pcb]
2026-05-04 Opened and closed V2 controller assembly.
2026-05-08 Removed diff lines that git had inserted into the file - what a POS.
    [Tandem Leveller Controller V2.kicad_pcb]
2026-05-08 Cleaning up state machine - pendant buttons do not toggle auto mode, they toggle cutting.
2026-05-11 Added CAD model of front scraper joint.
    [Cylinder.stp, Front Arm.stp, Hose1.stp, Hose2.stp, Piston.stp, Pivot Bolt.stp, Rear Arm.stp]
2026-05-15 Increased length of piston.
2026-05-17 Adding support for on-board IMU.
2026-05-18 On-board tractor IMU working.
2026-05-18 Fixed bugs with blade height on CAN bus. Tells AgGrade if on-board tractor IMU is being used.
    [AgGrade.cpp, AgGrade.h, Blades.cpp, CANopen.cpp, Global.h, IMU.h, TandemControllerV2.ino]
2026-05-29 Performance improvements. GNSS antenna mount for tractor and scrapers.
2026-06-01 Added smoothing to GNSS heading. GNSS heading should no longer snap to zero deg when stopped.
    [GNSS.cpp, GNSS.h, SensorFusor.cpp, SensorFusor.h]
2026-06-02 Added 60mm cooling fan to case.
2026-06-10 Fixed bugs in blade height management.
    [Blades.cpp, EepromConfig.h, Global.h, TandemControllerV2.ino]
2026-06-10 Bug fixes to blade height management.
    [Blades.cpp, Blades.h, Global.h, TandemControllerV2.ino]
2026-06-11 Added tractor and scraper antenna mounts.
    [AS-ANT2B-SUR-L1L2-25SMA-00-R00.STEP, TractorMount.stp]
