ajayre/tandemleveller/(notices)

Notices in the files:
CAD/Controller V2/Case V3/FH-M3-12ZC-PennEngineering-3D-04-21-2026.stp:
FILE_NAME('cv20260421013946000089433.stp','01:39:47 2026/04/21',('TraceParts Stv3.2.7.0'),('Copyright 2026 TraceParts S.A.S. All rights reserved. www.traceparts.com'),'Spatial InterOp 3D',' ',' ');
CAD/Controller V2/Case V3/FH-M3-8ZC-PennEngineering-3D-04-20-2026.stp:
FILE_NAME('cv20260420182659000061209.stp','18:26:59 2026/04/20',('TraceParts Stv3.2.7.0'),('Copyright 2026 TraceParts S.A.S. All rights reserved. www.traceparts.com'),'Spatial InterOp 3D',' ',' ');
